geyan21/yam-tactile-kit/engineering/docs/F1_DEVELOPMENT.md

# F1 development checkpoint

This page preserves historical development decisions and their earlier
completion states. Use [the current F1 build and fit guide](BUILD_F1.md) for
today's available files, sensor placement and remaining integration work.

F1 is not a fabrication release. Its flat electrode witnesses have 64 routed
contact regions: eight per nail prong and twelve per TPU patch. The contact
locations use the retained R1 nail and saddle surfaces. A separately checked
connector-board module is now available. Installed flex geometry, the complete
readout, carrier and physical behavior remain to be completed.

The first layout is generated by `layout_f1_cells.py`. It follows the tapered
nail outlines; a rectangular grid would allocate some pixels outside the
leading ends. The smallest proposed overlap is 5.127 mm² before adding feeds,
vias, coverlay constraints or registration allowances.

## Electrical findings

`screen_f1_matrix.py` models the four row drivers, six local row branches and
16 column nodes. Each patch has its own trace resistance. The selected column
has a finite path to an ideal amplifier reference; other columns float.
Each position is normalized to its modeled one-contact response. This is
an electrical interaction study, not a physical force calibration.

The first path assumptions were 0.8 Ω at a row driver, 1.5 Ω on each local row
branch and 5.5 Ω on the selected column. With inactive rows clamped to bias,
the worst modeled interaction is 13.27%, 1.61% and 0.164% for pressed
resistances of 100 Ω, 1 kΩ and 10 kΩ, respectively. Floating inactive rows
perform substantially worse.

A buffered/sensed candidate reduced the path targets to 0.05 Ω, 0.25 Ω and
0.35 Ω. Its 100 Ω case still failed the provisional 1% electrical criterion.
Changing the row-driver target to 0.02 Ω did not resolve that limiting case:
the largest error remains the all-pressed pattern, dominated by column path
resistance. All evaluated configurations are retained in timestamped runs.

The current development budget is 0.02 Ω at the buffered row distribution
land, 0.25 Ω per row branch and 0.25 Ω for the remaining column path. Meeting
these values requires actual circuit regulation, connector specifications
and routed-conductor checks. A favorable result with those targets does not
prove that a board or flex circuit satisfies them.

With those targets and ideal amplifiers, the largest modeled interaction is
0.741%, 0.0749% and 0.00746% at 100 Ω, 1 kΩ and 10 kΩ. The model passes its
1% work criterion. Its uniform-array result also matches the independent
analytic relation `G = 1 / (R + Rdriver + Rbranch + rows × Rcolumn)`.
Offsets, leakage, switching and material effects remain outside this result.

The candidate circuit puts a unity-gain buffer after each row-selection
switch. Separate current and high-impedance sense multiplexers would close
the selected-column feedback loop at its connector. This can remove the
current multiplexer resistance from the controlled column potential, while
the FPC resistance remains. A parked feedback path, correct switching order,
loop stability, leakage, amplifier offsets and ADC range must be checked.

The selected-column candidate now uses the single OPA392DBVR and explicit
gain/parking circuitry. The
[readout study](../development/f1/readout-study/README.md) preserves its circuit
diagram, component values and all declared simulation attempts. It is a
development circuit; row loops, reference/ADC drive and the complete board
remain unfinished.
[OPA392 manufacturer reference](https://www.ti.com/product/OPA392)

## Flex construction direction

The current routing targets are in `designs/f1_flex_targets.json`. Use two
copper layers for the **nail row electrodes**, with their feeds on the back.
The rigid nail supports those static vias. This retains leading contact
width. Use one copper layer for the other ten flex parts so the TPU patches
and tails can flex without plated vias in their moving regions.

The proposed material system uses 25 µm PI and 35 µm rolled-annealed copper.
The cited fabricator lists 0.11 mm single-layer covered flex, 0.20 mm for the
corresponding double-layer option, and reduced thickness where copper or
coverlay is absent. It also lists ±20% trace-width tolerance, which must
enter the resistance calculation. The proposed 31.5 µm minimum copper is
an additional purchasing/inspection requirement; it is not a published
supplier guarantee. [Fabrication capability reference](https://jlcpcb.com/capabilities/flex-pcb-capabilities/)

Use distinct row/column masks and explicit assembly-side transforms. The
upper conductor faces the film, and the lower conductor faces outward from
the support. Nail-plane and TPU-unroll coordinates have different handedness;
do not mirror every drawing using the same shortcut.

Both exposed conductor planes and their neutral surfaces need their own
developed lengths on a curved TPU patch. Keep adhesive out of active
electrode/film contacts. Final areas and layer offsets must be derived from
the routed artwork rather than the initial pixel-allocation plot.

The nominal saddle radii range down to 3.494 mm. Fabricator bend guidelines
are starting points for a circuit, not lifetime guarantees for this layered
tactile assembly. Measure loaded curvature, relative layer slip, bending
response and fatigue on the complete specimen.

## Next concrete work

1. Complete component limits, reference/gain circuitry and the switched-feedback stability review.
2. Replace the flat flex witnesses with installed routes and separate conductor-plane unrolls; calculate the complete resistance network with tolerances.
3. Design finished FPC contact thickness, mounting/sealing tools, tail routes and strain relief.
4. Supply checked PCB/CAD files, firmware, raw acquisition, BOM, assembly instructions and actual-geometry visuals.
5. Build and test the complete finger against R1 and the common campaign. Electrical resistance cases cannot establish a 20 N force rating.

## Checked flat-artwork milestone

Twelve flat routing witnesses now exist: one row and one column foil for each
of six patches. Both nail row foils use backside feeds; the other ten foils
currently have one copper layer. The routed overlap map contains 64 distinct
regions. Its smallest copper overlap is 5.1199 mm² after removing the plated
drill holes.

All twelve pass the independent copper, outline and connectivity checks in
KiCad 10.0.7. The narrowest modeled copper clearance is 0.1889 mm, against
the 0.15 mm rule. The source-derived nail outline contained submicron edges;
the new flex outline simplifies these within a measured 0.003 mm bound.
The original source finger is unchanged.

The sensing and cable contacts intentionally share coverlay openings, with
no solder paste on the flex. `check_f1_flex.py` retains both unsuppressed
reports and reports with the scoped `bridged_mask` allowance for the
unsoldered `FOIL` footprint. It permits no other ignored rule in that block
and requires zero copper/connectivity findings. A separate probe confirms
that a 5 mm clearance sentinel and an injected copper short are still
detected with the coverlay allowance enabled.

The development exports omit KiCad's generic even-layer/FR4 Gerber job file.
Raw exports remain preserved; the selected files carry the actual proposed
polyimide stack and a development-only notice. These exports are **not the
completed F1 finger package**.

Reproduce this stage with the prepared CAD/KiCad tools:

```sh
build/engineering/tools/cad-venv/bin/python engineering/scripts/develop_f1_artwork.py
/usr/bin/python3 engineering/scripts/check_f1_flex.py ACTUAL_ARTWORK_RUN --export
build/engineering/tools/cad-venv/bin/python engineering/scripts/summarize_f1_artwork.py ACTUAL_ARTWORK_RUN
```

Use the actual timestamped directory printed by the first command. Generated
results and failed attempts remain under
`build/engineering/prototypes/f1/artwork_runs/`.

## Installed routing direction

The flat tails demonstrate electrical routing. They have not been fitted to
the gripper and must not be laid across the following contact patches.
`designs/f1_integration_development.json` records the current integration
direction: a removable connector board on the fixed finger and a separate
analog/ADC board at the wrist/base, with separate current/sense paths.

The connector-board position, folded tail paths, mating planes, mechanical
carrier and analog implementation are candidates awaiting checks. This
keeps the full installed-finger requirement open. Neither the successful
flat-artwork checks nor the contact-area map qualifies bending, contact
reliability, 20 N force performance or production yield.

## Checked fanout-board module

The [downloadable development checkpoint](../development/f1/fanout/README.md)
now supplies an editable four-layer PCB, both populated faces' fabrication
artwork, pin tables, component values, full independent DRC evidence and
[actual routed board visuals](../development/f1/fanout/visuals/fanout_faces.png).
It is a connector-board module, not the completed F1 finger.

The board has 42 components, 232 pads, 2,221 track segments and 274 vias.
KiCad 10.0.7 reports zero rule violations and zero missing connections.
The generated placements also pass explicit pad-coordinate, layer and
save/reload checks. A separate adapter enforces spacing between same-net
drilled vias; copper connectivity alone does not prevent overlapping drills.
Original failed attempts remain in the working records.

Six outer `J*R` connectors carry rows; six inner `J*C` connectors carry
columns. Each uses the selected Hirose six-position, 1 mm connector.
Twenty fitted zero-ohm links define the separate sense pickups. `JW` is
a 50-position, 0.5 mm Hirose connector for the wrist readout.
`UT`, ADG706BRUZ, adds a switchable 10 kΩ electrical test path with
enable/address pull-downs. Its eventual test sequence must park the rows
at bias and label the records as electrical checks.

The proposed Molex cable matches the nominal pitch and end thickness.
Its reviewed dimensions and electrical values are in
`research/f1_wrist_link_review.json`. The wrist connector's conductor mapping
must follow the installed poses and an unpowered continuity check.

The board follows the prescribed contact/access envelope from
`check_f1_placement.py`. The original rectangle entered that envelope by
130.41 mm². A contoured edge and 2.13 mm shift of one connector pair clear
the assumed 3 mm inward travel plus 1 mm access margin. This is not a
prediction of bending at 20 N. Fine contour features, the actual carrier,
open-latch access and installed drive still need manufacturing/fit checks.

Request 1 oz copper on all four layers, with the additional minimum-copper
targets recorded in `designs/f1_fanout_manufacturing_targets.json`. The
complete board/cable/flex network has not yet demonstrated the electrical
budget. Shared row traces, connector resistance, amplifier regulation,
leakage and switching remain part of that review.

Rechecking the distributed board writes only into `build/`; it does not
alter the saved checkpoint. Follow the commands in its README. No physical
F1 specimen or performance result has been reported.

## Selected-column readout study

The [separate readout checkpoint](../development/f1/readout-study/README.md)
contains replayable cases, raw vectors/logs, a readable circuit drawing and
plots. Its 96 nominal AC and eight current-step cases pass the declared
selected-column screen. Minimum voltage-return margin is 53.89°, and the
limiting current-step settles within 290.55 µs at the 25 µV work criterion.
This is a typical model with explicit lumped parasitics and ideal bias sources.

Of 96 independent physical-ground time-domain probes, 83 completed and passed;
twelve solver failures and one timeout remain unresolved. Of twelve
wire-break attempts, eight support provisional healthy/rejected decisions,
two have no completed result and two are incomplete with nonphysical outputs.
The archive retains every attempt. No failed or partial simulation counts
as a successful hardware check.

The simulation worker now rejects analysis-aborted messages and truncated
time/frequency vectors. Replay of an actual successful case and an actual
aborted case verifies the result-handling change. The archive verifier checks
27 files and 1,485 compressed members. A separately extracted nominal case
replays using the directly obtained TI model.

The complete F1 design still requires the four row-driver loops, full-array
interaction, reference and ADC drive, gain/channel transitions, firmware,
routed readout board, fitted flex and mounting mechanics. No physical
performance recommendation follows from this milestone.

## ADC, row drivers and wrist integration

The [support-study archive](../development/f1/support-studies/README.md)
contains 32 ADC-driver cases and 26 row-driver cases, their exact inputs and
the unsuccessful earlier attempts. Current declared model screens pass.
Four ADC replays with smaller maximum time steps and ten completed
trapezoidal runs constrain the reported settled-window result. Fourteen
trapezoidal workers still did not complete; they remain in the archive.

The ADC driver adds a 2.2 nF capacitor from each input to ground after the
first model's differential-only filter produced out-of-range negative-input
excursions. OPA320AQDBVRQ1 matches the current supplied Q1 macromodel.
The row drivers use 47 Ω output isolation and 4.7 kΩ sense resistance.
Their one-row model meets the stated 45° return-margin screen and settles
within 36.17 µs in the selected command/load cases. These are typical
isolated-stage models, not full-array or physical measurements.

The wrist layout and [capture guide](F1_WRIST_CAPTURE.md) now define the
complete candidate component/pin map. The board contains 135 components and
498 pads. The [checked wrist module](../development/f1/wrist/README.md)
now includes the 2,561-segment, 412-via native board, both populated faces'
fabrication files, drawings and full DRC evidence. Independent KiCad checking
reports zero violations and zero missing connections. The distributed
187-file checkpoint also passes its documented recheck.

The original complete route's eight courtyard overlaps and two label
findings were retained, then corrected. The actual filled ground-plane
drawing and eleven signal-net crossing inventories are included; return
impedance and EMC remain unmeasured.

Reference implementation, complete array dynamics, installed flex geometry,
carrier, actual YAM fit and physical tests remain.
The code provides a declared fixed-gain bench scan, separate electrical
column tests, raw per-sample times and a recorder that retains partial frames.
No physical Pico or sensor was accessed during the software checks.
