geyan21/yam-tactile-kit/engineering/prototypes/optical/visuals/o1_molds.pdf

O1.0 • two mold halves, gel cavity and flexible dot stencil CAD only • casting, mating, optics, precision and 20 N response require physical tests

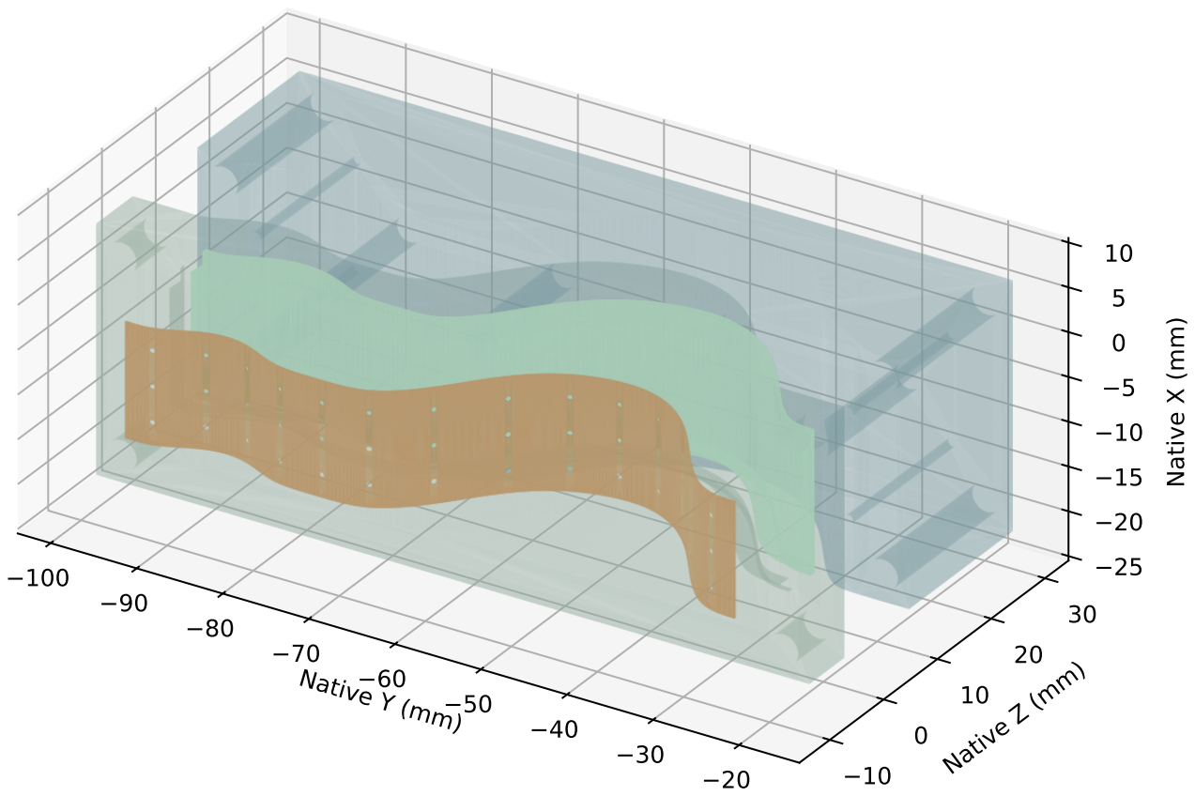
[picture p14: figure]
Native Y (mm); Native Z (mm); Native X (mm)
