geyan21/yam-tactile-kit/engineering/release/b1/b1_review_drawings.pdf

# B1 · controlled compliance, fixed readout

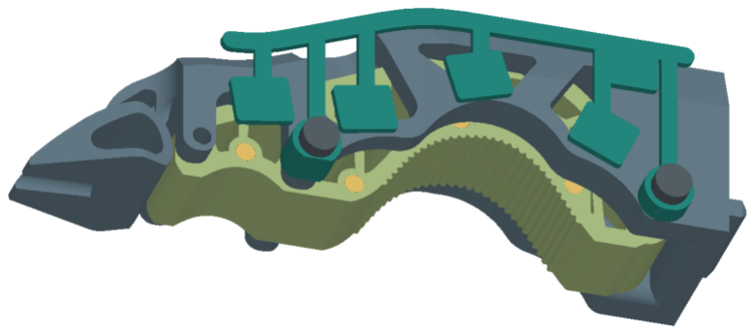
[picture p26: figure]

Original hard frame · modified TPU · four magnets and plugs · five sensor heads · fixed spine

Actual meshes / unbuilt prototype. Wire routing, epoxy fillets and optional nail films are not pictured.

# B1 · separate parts

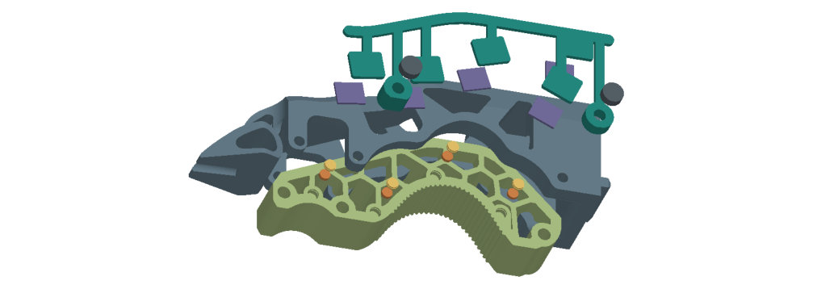
[picture p27: figure]

Original hard frame · modified TPU · four magnets and plugs · five sensor heads · fixed spine

Actual meshes / unbuilt prototype. Wire routing, epoxy fillets and optional nail films are not pictured.

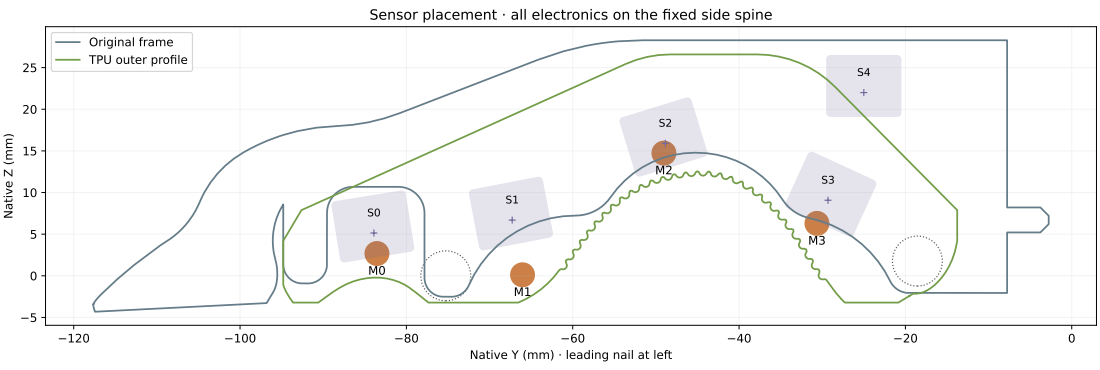
[picture p28: page 3]
Native Z (mm)

fixed side spine

Sensor placement · all electronics on the

Original frame file TPU outer pro

Native Y (mm) · leading nail at left

B1.0 manufacturing review · millimeters · do not scale this page

Original TPU outer profile and attachment bores retained; hard frame unchanged. Four side pockets: diameter 3.15, depth 2.15.
Magnets: N48, 3 × 1, axial north toward +native X (sensor side).
Plug: 1.15 long, 3.10 stem, 3.40 bead. Groove 3.55 × 0.30.
Print and gauge a pocket first. Do not force an oversize magnet into TPU.

Pocket centers (X is magnet center, not side opening):
M0: (-1.650, -83.540, 2.676)
M1: (-1.650, -66.035, 0.122)
M2: (-1.650, -49.035, 14.732)
M3: (-1.650, -30.635, 6.292)

Five identical PCB heads: 8 × 6.4 × 0.8; component face points inward. PCB component-side plane: X=8.439.
Outer spine: X=10.539. Backing tape: 0.10.
Added global width: 3.65 without heads;
6.05 with reserved heads; wires excluded.
Reserved M3 head: diameter 6 × height 2.4. Choose actual nonmagnetic hardware. Carrier bores: 3.4. Measure the original stack to select screw lengths.

No unchanged-stiffness, 20 N capacity, accuracy or fatigue claim.
Use STEP/STL and the PCB fabrication archive; test one build before scaling.
