geyan21/yam-tactile-kit/engineering/prototypes/pneumatic/visuals/p1_readout.pdf

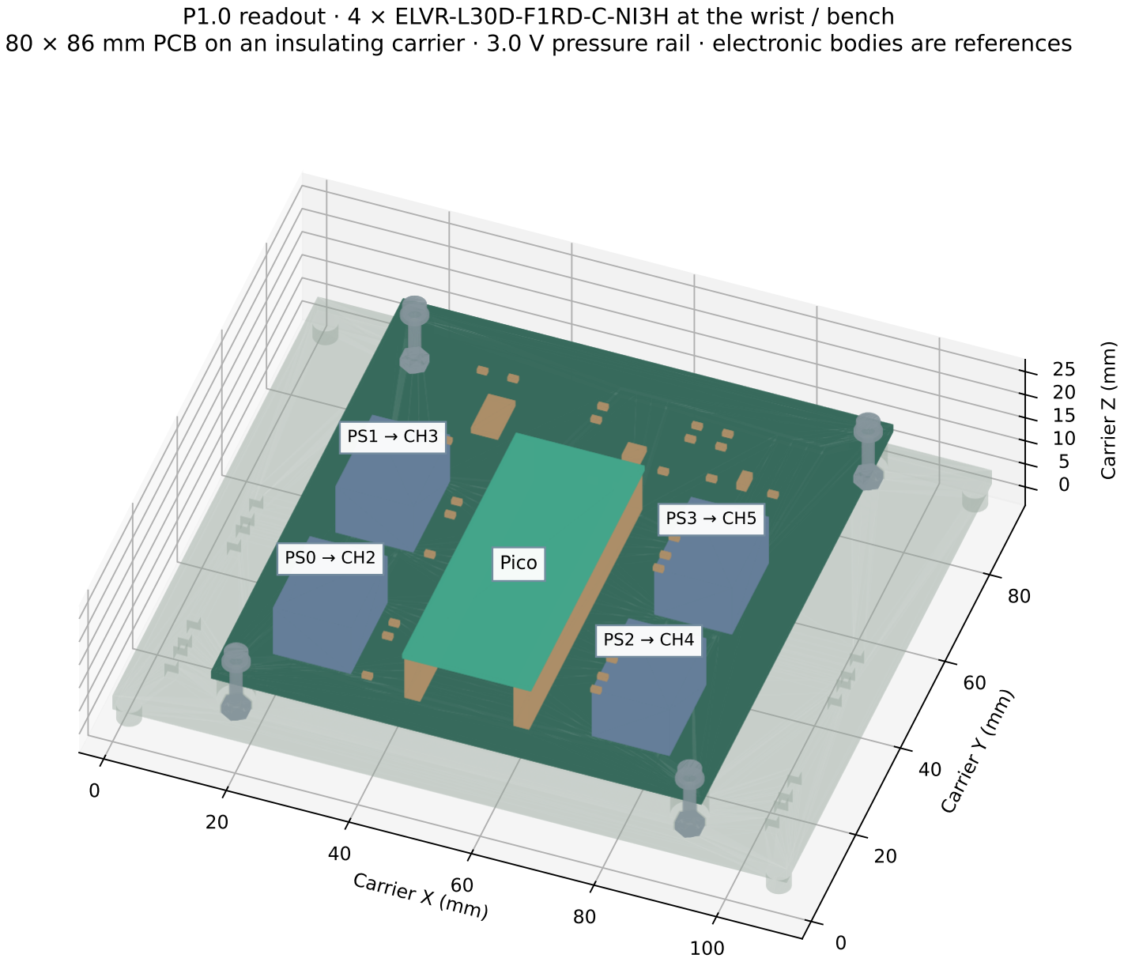
[picture p29: page 1]

0
20
40
60
80
100

Carrier X (mm)

0

20

40

60

80

Carrier Y (mm)

0

5

10

15

20

25

Carrier Z (mm)

PS0 → CH2

PS1 → CH3

PS2 → CH4

PS3 → CH5
Pico

P1.0 readout · 4 × ELVR-L30D-F1RD-C-NI3H at the wrist / bench 80 × 86 mm PCB on an insulating carrier · 3.0 V pressure rail · electronic bodies are references
