geyan21/yam-tactile-kit/engineering/prototypes/f1/visuals/f1_r4_review_drawings.pdf

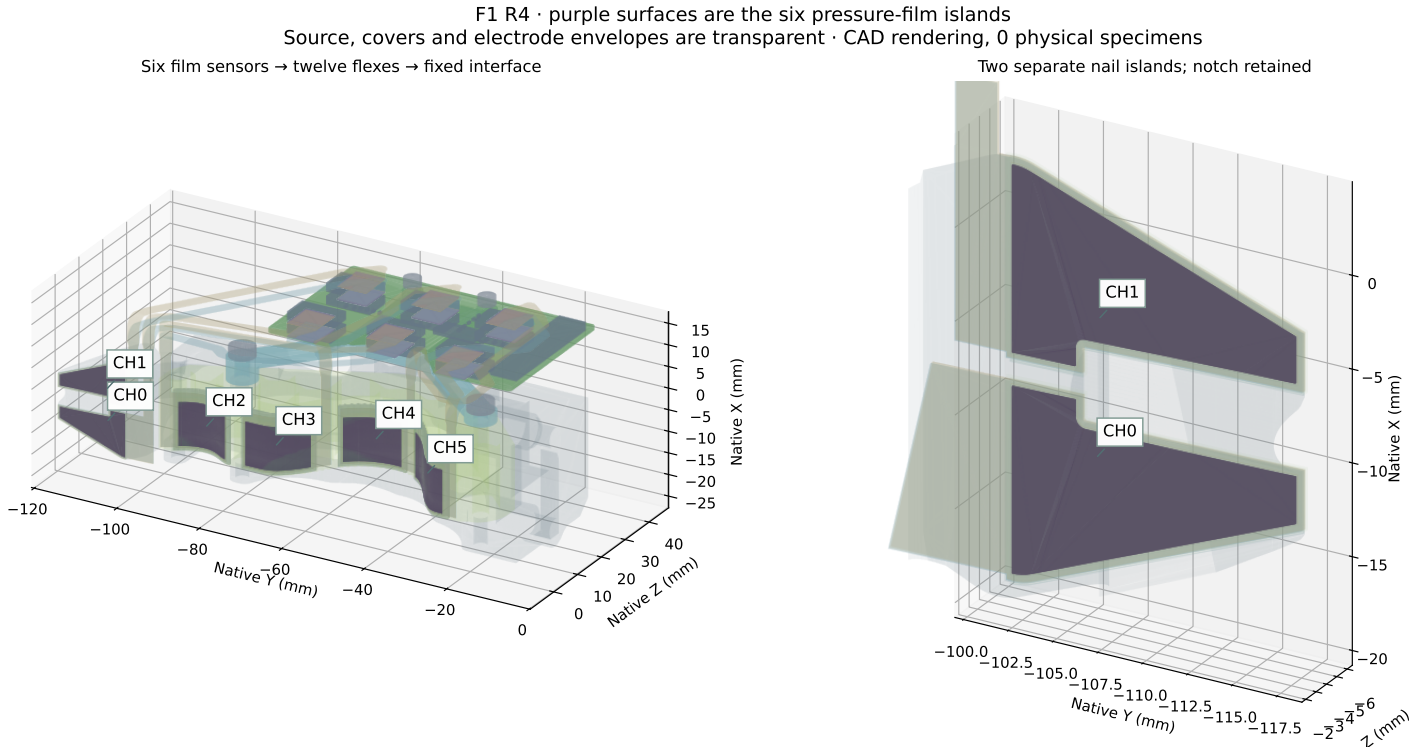
[picture p30: page 1]

−120
−100
−80
−60
−40
−20

0

Native Y (mm)

0

10

20

30

40
Native Z (mm)

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
Native X (mm)

Six film sensors → twelve flexes → fixed interface

CH0

CH1

CH2
CH3 | CH4

CH5

−117.5

−115.0 −112.5 −110.0 −107.5 −105.0 −102.5 −100.0

Native Y (mm)

−6 −5 −4 −3 −2
Native Z (mm)

−20

−15

−10

−5

0

Native X (mm)

Two separate nail islands; notch retained

CH0

CH1

F1 R4 · purple surfaces are the six pressure-film islands

Source, covers and electrode envelopes are transparent · CAD rendering, 0 physical specimens
