geyan21/yam-tactile-kit/engineering/prototypes/capacitive/patterns/k1_ch2_inspection.pdf

## k1_ch2

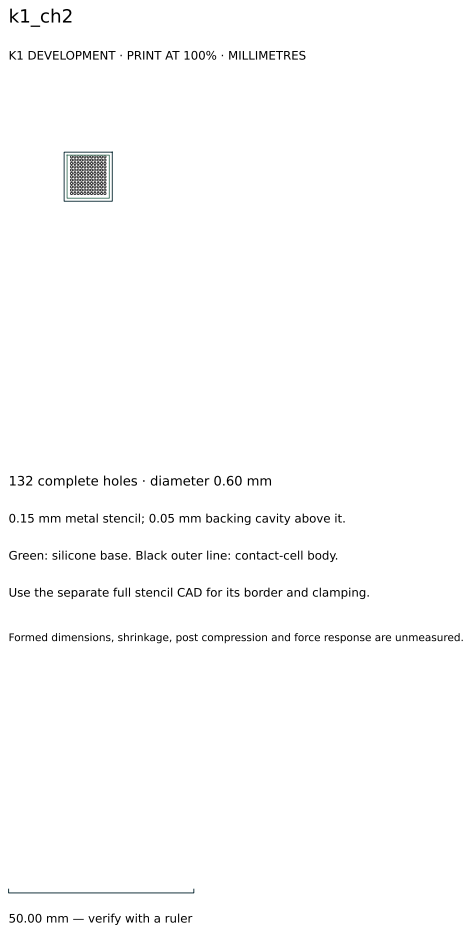
[picture p31: page 1]

K1 DEVELOPMENT · PRINT AT 100% · MILLIMETRES

132 complete holes · diameter 0.60 mm

0.15 mm metal stencil; 0.05 mm backing cavity above it.

Green: silicone base. Black outer line: contact-cell body.

Use the separate full stencil CAD for its border and clamping.

Formed dimensions, shrinkage, post compression and force response are unmeasured.

50.00 mm — verify with a ruler
