geyan21/yam-tactile-kit/engineering/prototypes/capacitive/visuals/k1_review_drawings.pdf

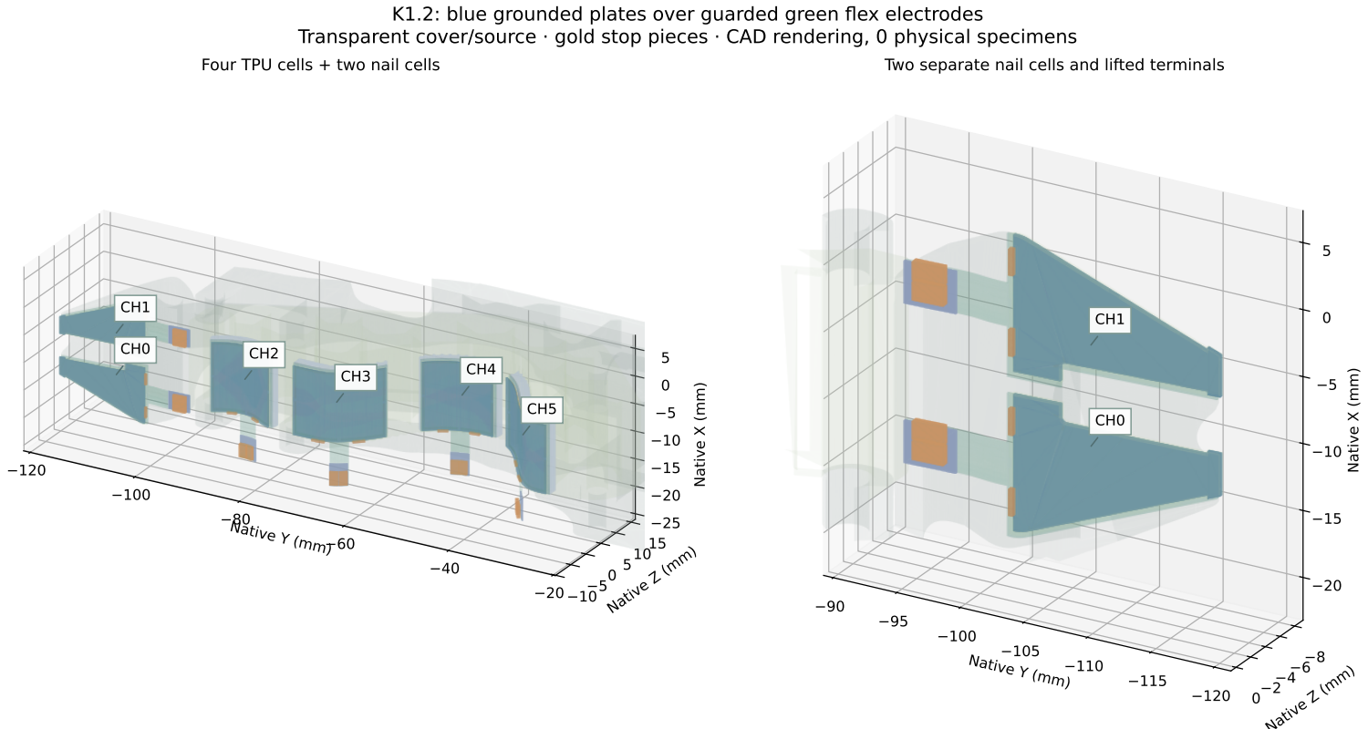
[picture p32: page 1]

−120

−100

−80

−60

−40

−20

Native Y (mm)

−10−5

0

5

1015 Native Z ⁽mm⁾

−25

−20

−15

−10

−5

0

5

Native X (mm)

Four TPU cells + two nail cells

CH0

CH1

CH2
CH3 | CH4

CH5

−120

−115

−110

−105

−100

−95

−90

Native Y (mm)

−8
−6
−4
−2
0

Native Z (mm)

−20

−15

−10

−5

0

5

Native X (mm)

Two separate nail cells and lifted terminals

CH0

CH1

K1.2: blue grounded plates over guarded green flex electrodes

Transparent cover/source · gold stop pieces · CAD rendering, 0 physical specimens

K1 bank enclosure · make two identical copies Lid lifted for viewing · reference capacitor on its separate 0.5 mm support · Pico is outside the case

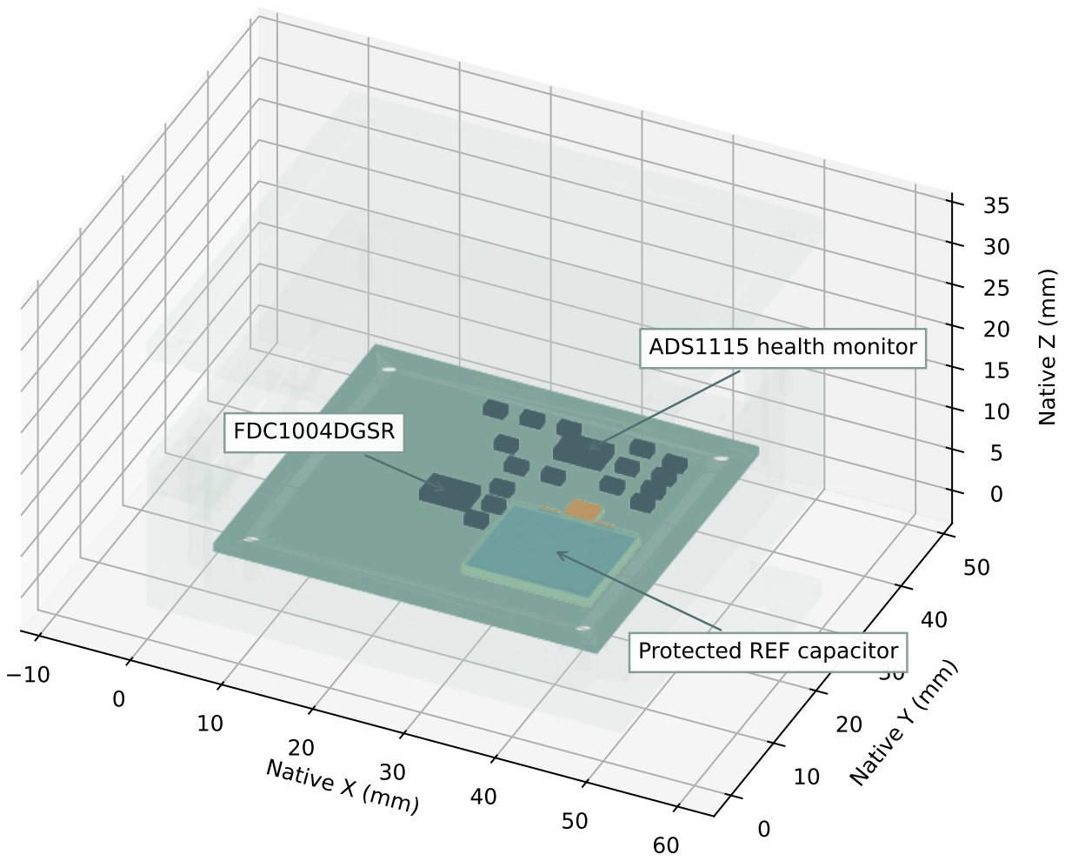
[picture p33: figure]
Native X (mm); Native Y (mm); Native Z (mm); Protected REF capacitor; FDC1004DGSR; ADS1115 health monitor
