geyan21/yam-tactile-kit/engineering/prototypes/force_button/visuals/fb1_review_drawings.pdf

FB1: the complete finger loads a packaged sensor at the root 50 mm added reach · no sensor film on the leading tip · CAD rendering, not a physical specimen

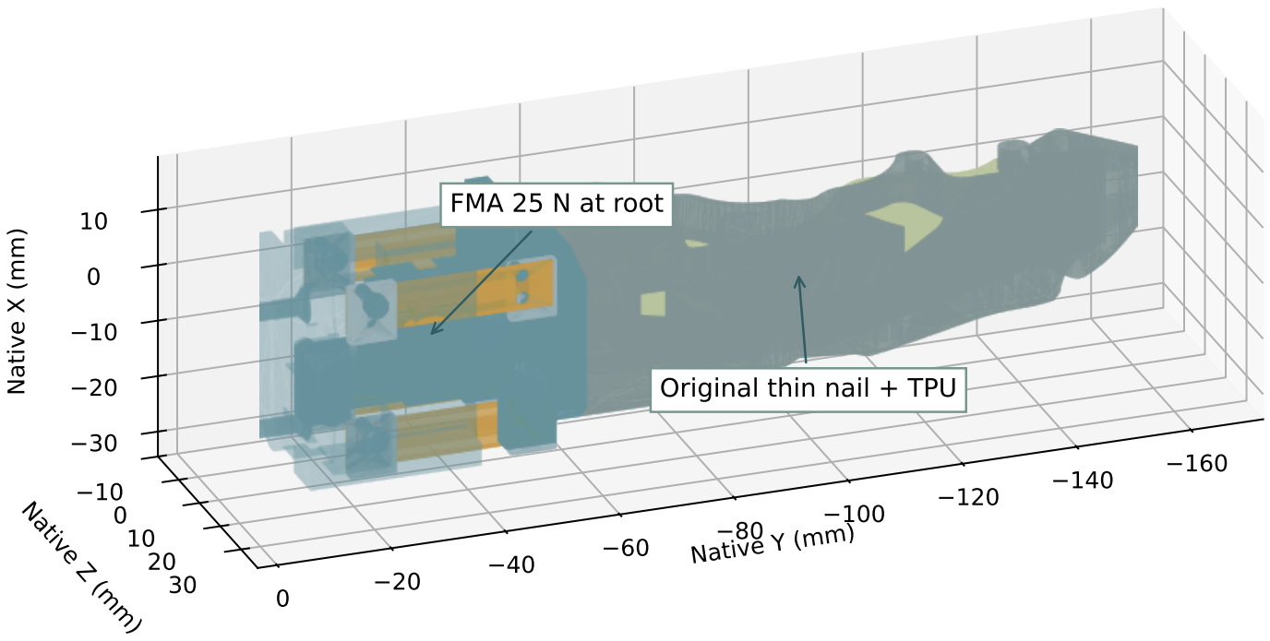
[picture p34: figure]
Native Y (mm); 30 Native Z (mm); Native X (mm); FMA 25 N at root; Original thin nail + TPU

Actual center section at native X = −7.5 mm

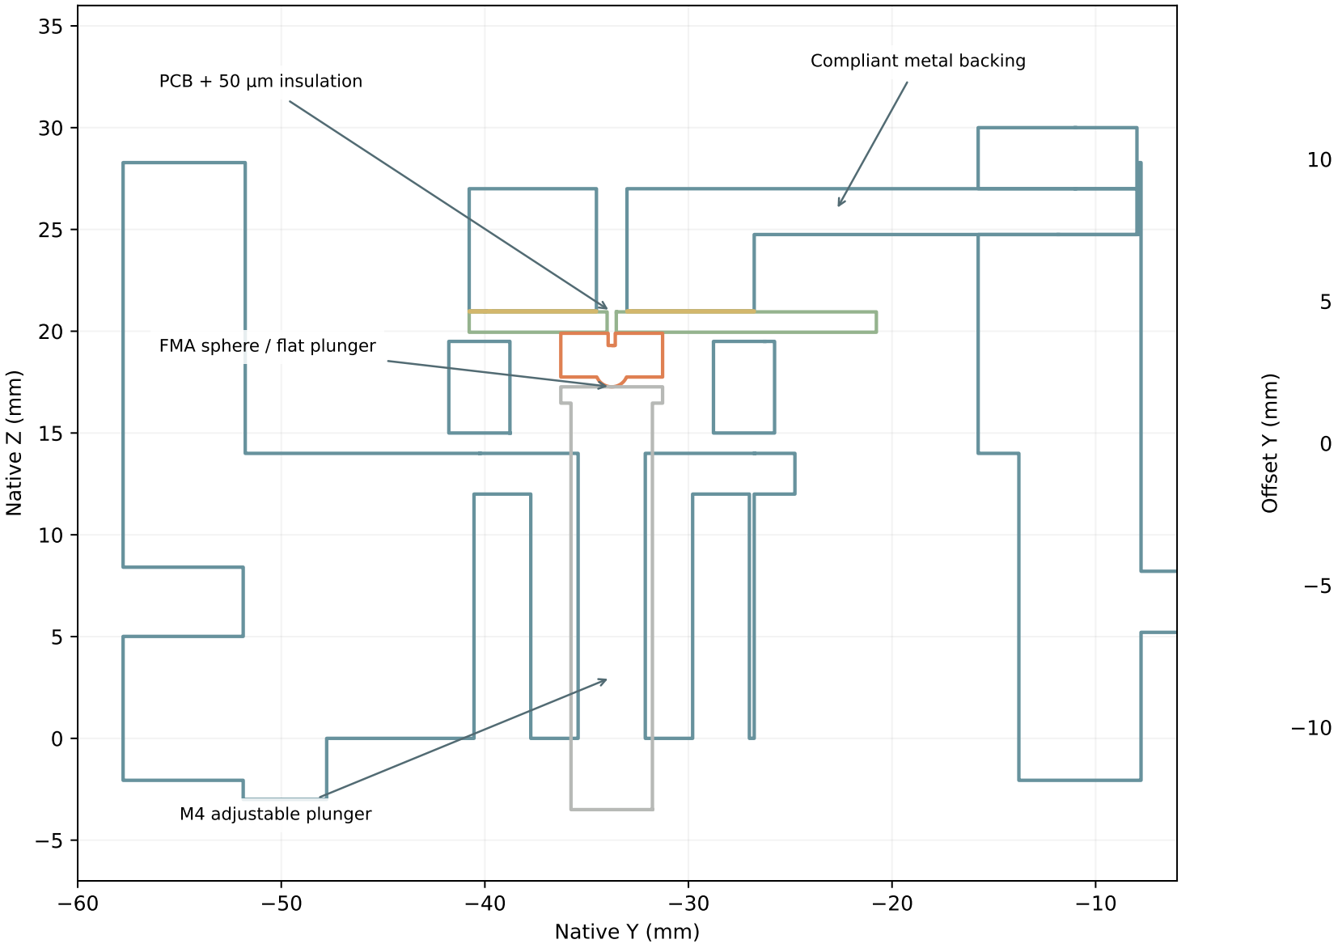
[picture p35: figure]
Native Y (mm); Native Z (mm); FMA sphere / flat plunger; PCB + 50 µm; insulation; Compliant metal backing; M4 adjustable plunger; ffset Y (mm)
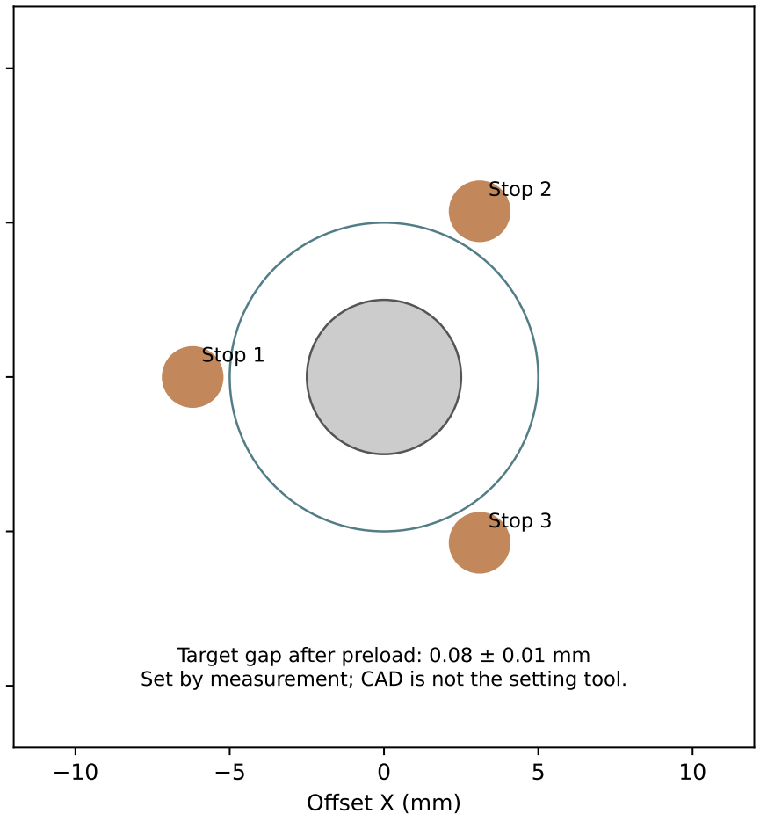
[picture p36: figure]
Offset X (mm); Stop 1; Stop 2; Stop 3

Target gap after preload: 0.08 ± 0.01 mm Set by measurement; CAD is not the setting tool.

Three stops around the plunger Plan view; separate from the section

FB1 load coupling: support the package, press only the sphere, keep the vent open

FB1 sensor board · 14 × 20 × 1 mm · two copper layers Actual routed primitives; native KiCad/Gerbers are authoritative · solder leads from the back

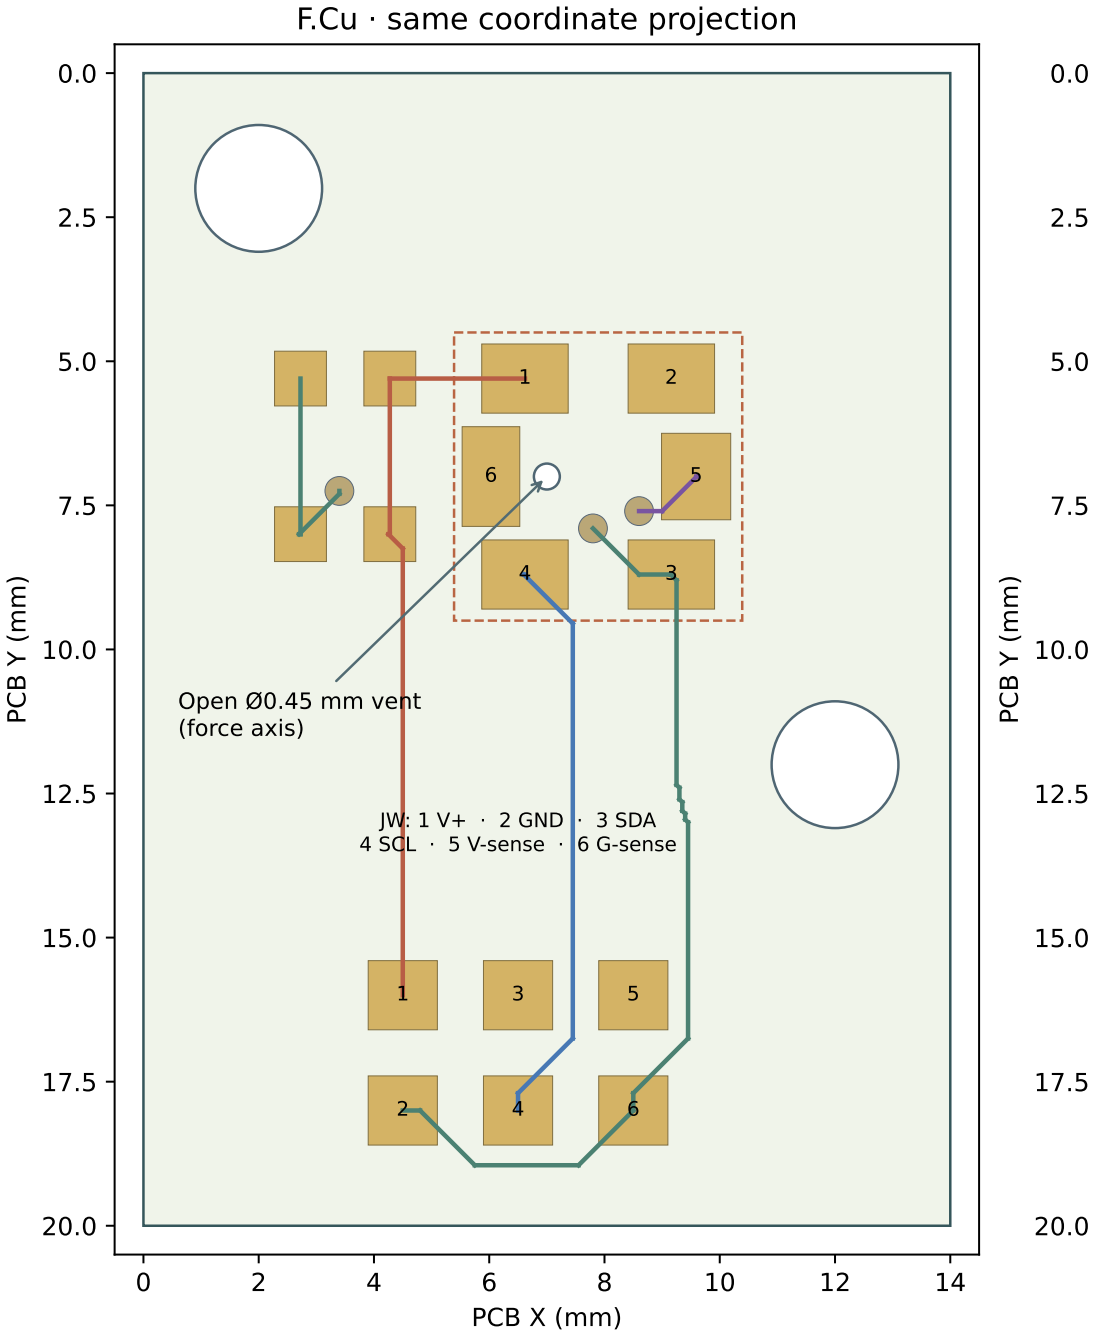
[picture p37: figure]
PCB X (mm); PCB Y (mm); Open Ø0.45 mm vent (force axis); JW: 1 V+ · 2 GND; · 3 SDA; 4 SCL · 5 V-sense ·; 6 G-sense; F.Cu · same coordinate projection
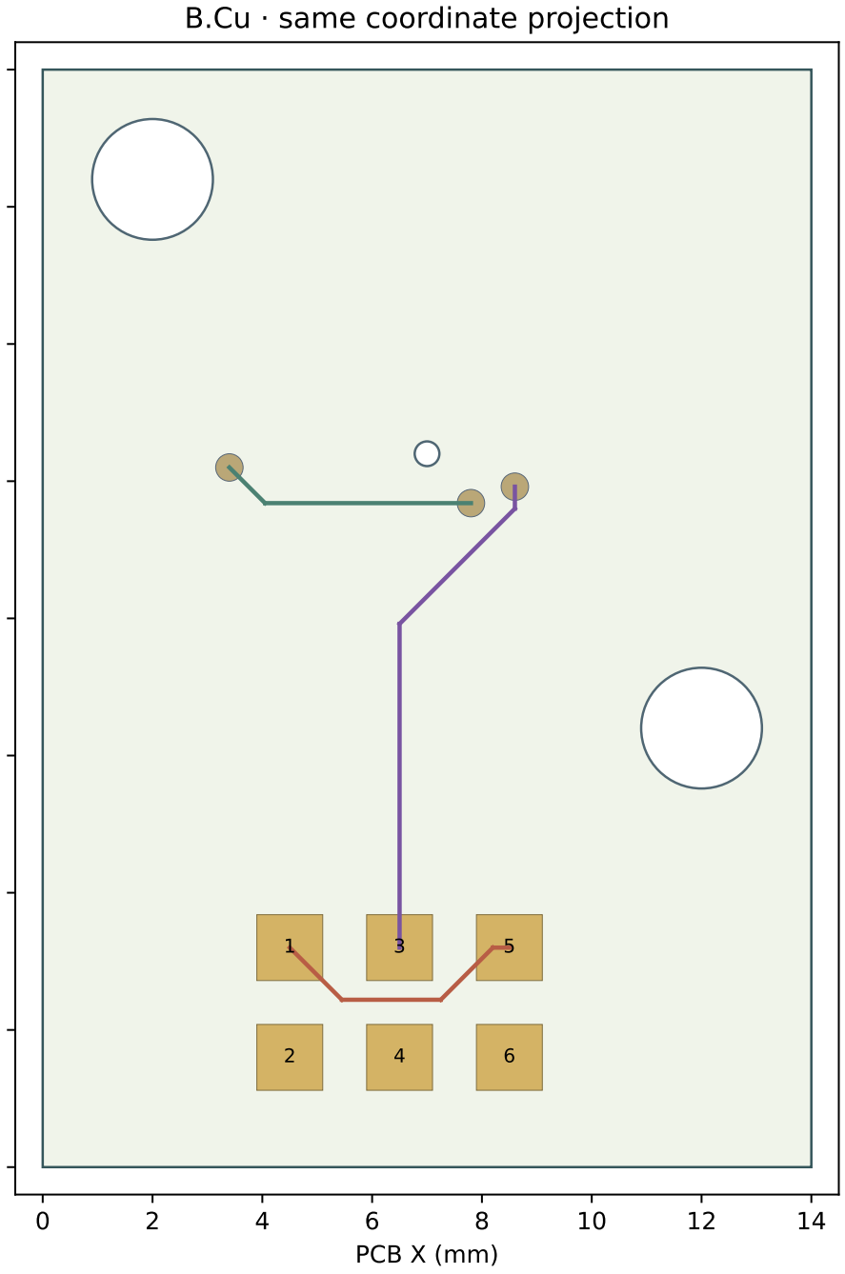
[picture p38: figure]
PCB X (mm); B.Cu · same coordinate projection
