geyan21/yam-tactile-kit/engineering/development/capacitive/k1/visuals/k1_readout.pdf

K1 readout · one board serves three pressure cells and one unloaded reference 23 components · independent KiCad check: 0 violations, 0 missing connections · no physical board tested

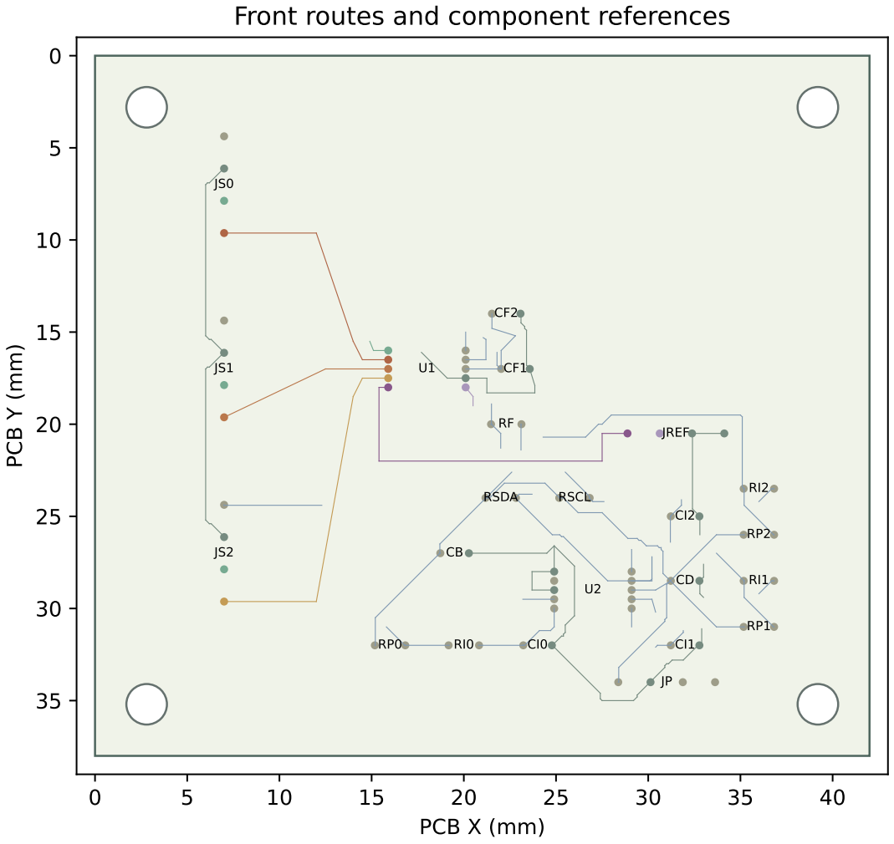
[picture p39: figure]
PCB X (mm); PCB Y (mm); RSDA; RSCL; JREF; Front routes and component references
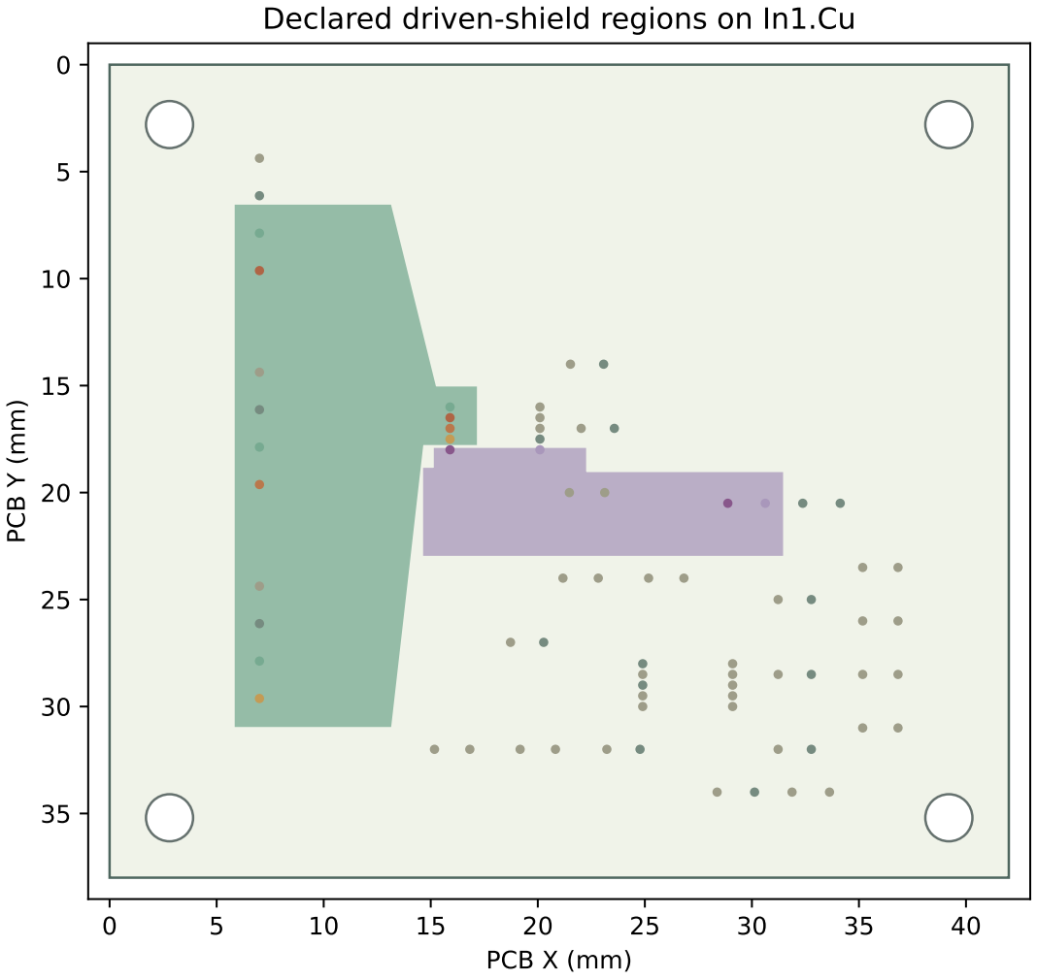
[picture p40: figure]
PCB X (mm); PCB Y (mm); Declared driven-shield regions on In1.Cu

Plane graphic shows intended regions; native filled copper and drill files are authoritative. Use two boards on separate Pico I²C buses.
