geyan21/yam-tactile-kit/engineering/development/f1/r3/cable/mating_pose.pdf

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
Finger fanout JW

Wrist JW

Same-side contact FFC
Both connector board faces parallel Cable mouths face one another
Pin n → pin 51−n
Unpowered continuity check required

F1 cable inspection pose · native pin correspondence Illustration is not the installed cable route; solder-land transverse order represents contact order.
