geyan21/yam-tactile-kit/engineering/development/f1/r3/patterns/f1_ch2_columns_fit.pdf

123456

# f1_ch2_columns_fit

FIT PATTERN ONLY · NO COPPER ARTWORK · PRINT AT 100% CH2 columns → J2C · view from F.Cu side

50 mm scale bar · verify with a ruler

Dashed lines bound the 90° bend. Form around the radius; do not crease.

Connector datum, source join, bending slack and physical fit remain unverified.
