geyan21/yam-tactile-kit/engineering/development/f1/r3/visuals/fanout_faces.pdf

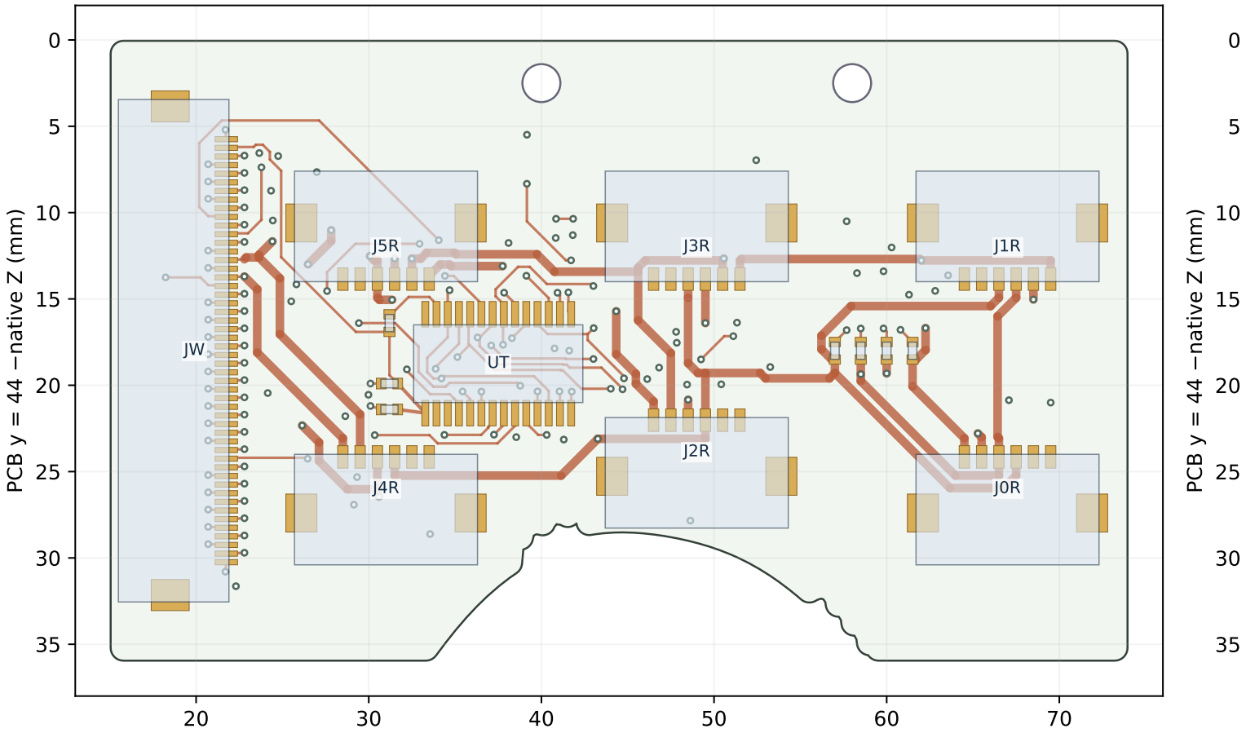
[picture p45: figure]
PCB y = 44; −native Z (mm)

PCB x = −native Y (mm)

## Outer row face • F.Cu

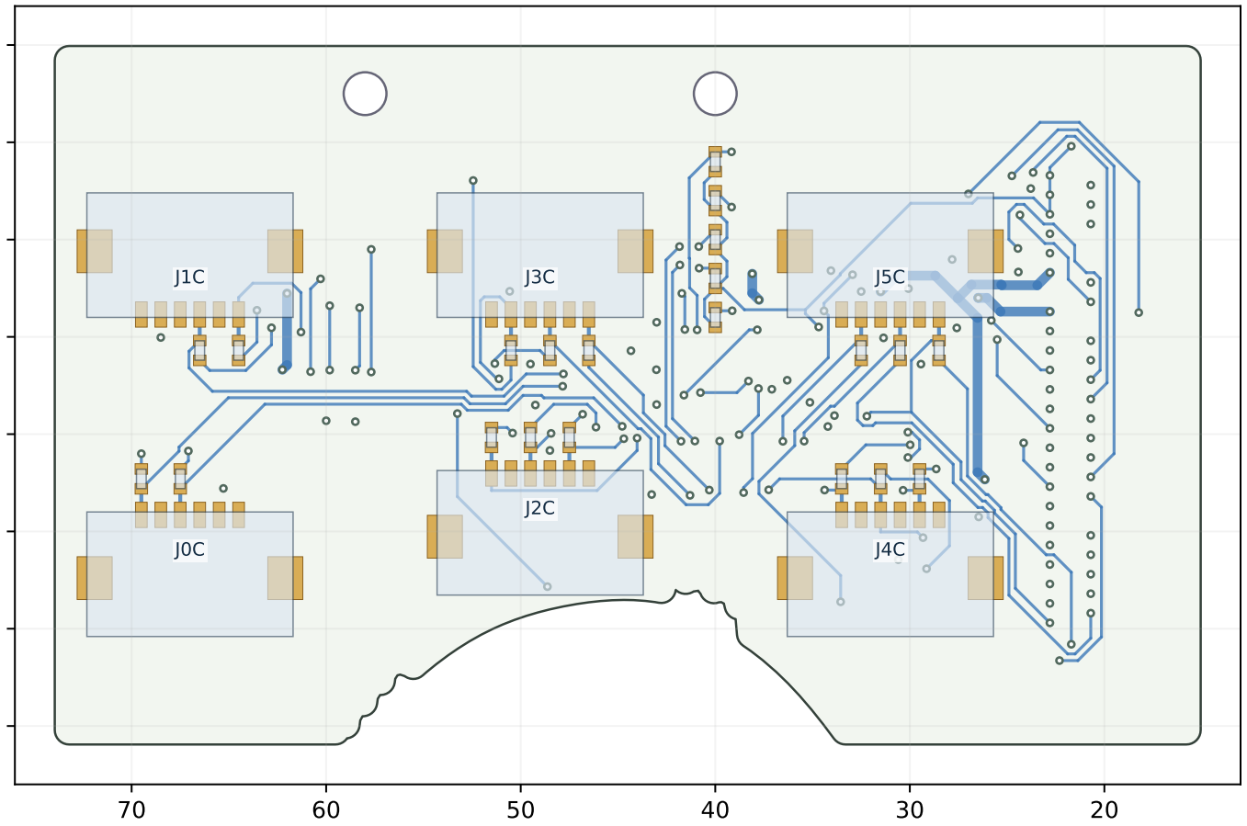
[picture p46: figure]

PCB x = −native Y (mm)

## Inner column face • B.Cu, viewed from the back

## F1 connector-board R3 development • four copper layers • 42 components Independent DRC: 0 violations, 0 unconnected • no physical prototype tested

Actual routed outer-layer copper; rectangular part envelopes. KiCad assembly SVGs provide pad numbers and silkscreen. The inner ground pour is not pictured.
