geyan21/yam-tactile-kit/engineering/development/f1/r3/visuals/sensor_placement.pdf

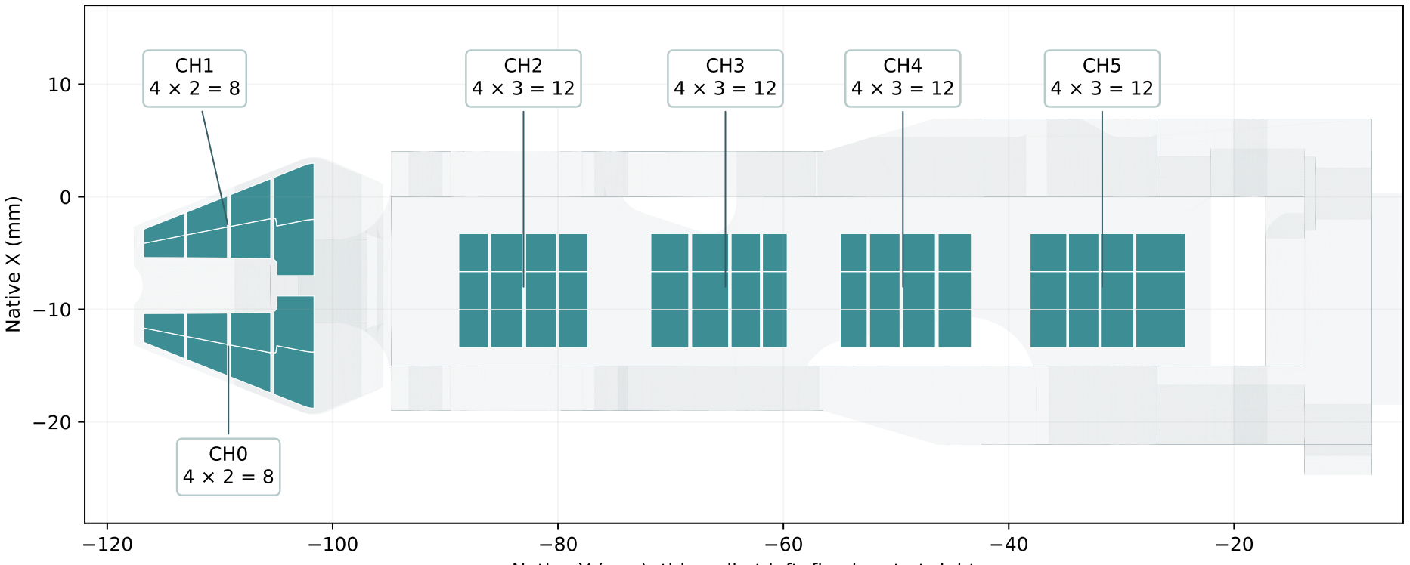
[picture p47: figure]
Native X (mm)

Native Y (mm): thin nail at left, fixed root at right

## Contact surface: two nail matrices + four TPU matrices = 64 intended locations

Object | contact
Protective cover | 0.10 / 0.40 mm
Row electrode foil | 0.145 / 0.060 mm in active area
Conductive pressure film | 0.10 mm — this is the sensing material
Column electrode foil | 0.060 mm in active area
Mounting layer | 0.05 / 0.10 mm
Original nail / TPU | retained contact support

Numbers are nail / TPU targets. Layer drawing is enlarged, not to thickness scale. Adhesive stays out of the film–copper sensing interfaces. Keep six film islands separate.

Sensor = the film/electrode laminate | Fixed electronics

Finger side: 12 FH12 foil connectors Wrist/base: OPA392 readout + ADS8866 Pico records raw electrical values

No ADC or rigid PCB goes in these pads. Force calibration and physical tests remain.

## F1 — what the tactile sensor is, and where it goes

Source-geometry allocation and nominal stack; fitted copper and physical qualification pending
