geyan21/yam-tactile-kit/engineering/prototypes/f1/electronics/wrist/cable/continuity_checklist.csv

fanout_connector | fanout_pin | wrist_connector | wrist_pin | net | measured_continuity_ohm | adjacent_short_check | operator | date
JW | 1 | JW | 50 | GND
JW | 2 | JW | 49 | +3V3
JW | 3 | JW | 48 | GND
JW | 4 | JW | 47 | A0
JW | 5 | JW | 46 | GND
JW | 6 | JW | 45 | A1
JW | 7 | JW | 44 | GND
JW | 8 | JW | 43 | A2
JW | 9 | JW | 42 | A3
JW | 10 | JW | 41 | TEST_EN
JW | 11 | JW | 40 | R0_I
JW | 12 | JW | 39 | R0_S
JW | 13 | JW | 38 | R1_I
JW | 14 | JW | 37 | R1_S
JW | 15 | JW | 36 | R2_I
JW | 16 | JW | 35 | R2_S
JW | 17 | JW | 34 | R3_I
JW | 18 | JW | 33 | R3_S
JW | 19 | JW | 32 | C0_I
JW | 20 | JW | 31 | C0_S
JW | 21 | JW | 30 | C1_I
JW | 22 | JW | 29 | C1_S
JW | 23 | JW | 28 | C2_I
JW | 24 | JW | 27 | C2_S
JW | 25 | JW | 26 | C3_I
JW | 26 | JW | 25 | C3_S
JW | 27 | JW | 24 | C4_I
JW | 28 | JW | 23 | C4_S
JW | 29 | JW | 22 | C5_I
JW | 30 | JW | 21 | C5_S
JW | 31 | JW | 20 | C6_I
JW | 32 | JW | 19 | C6_S
JW | 33 | JW | 18 | C7_I
JW | 34 | JW | 17 | C7_S
JW | 35 | JW | 16 | C8_I
JW | 36 | JW | 15 | C8_S
JW | 37 | JW | 14 | C9_I
JW | 38 | JW | 13 | C9_S
JW | 39 | JW | 12 | C10_I
JW | 40 | JW | 11 | C10_S
JW | 41 | JW | 10 | C11_I
JW | 42 | JW | 9 | C11_S
JW | 43 | JW | 8 | C12_I
JW | 44 | JW | 7 | C12_S
JW | 45 | JW | 6 | C13_I
JW | 46 | JW | 5 | C13_S
JW | 47 | JW | 4 | C14_I
JW | 48 | JW | 3 | C14_S
JW | 49 | JW | 2 | C15_I
JW | 50 | JW | 1 | C15_S
