geyan21/yam-tactile-kit/engineering/prototypes/f1/electronics/wrist/pcb/f1_wrist_pins.csv

reference | pad | net | layer | pcb_x_mm | pcb_y_mm
JP1 | 1 | ROW0 | F.Cu,In1.Cu,In2.Cu,B.Cu | 8.0 | 12.0
JP1 | 2 | ROW1 | F.Cu,In1.Cu,In2.Cu,B.Cu | 8.0 | 14.54
JP1 | 3 | GND | F.Cu,In1.Cu,In2.Cu,B.Cu | 8.0 | 17.08
JP1 | 4 | ROW2 | F.Cu,In1.Cu,In2.Cu,B.Cu | 8.0 | 19.62
JP1 | 5 | ROW3 | F.Cu,In1.Cu,In2.Cu,B.Cu | 8.0 | 22.16
JP1 | 6 | A0 | F.Cu,In1.Cu,In2.Cu,B.Cu | 8.0 | 24.7
JP1 | 7 | A1 | F.Cu,In1.Cu,In2.Cu,B.Cu | 8.0 | 27.24
JP1 | 8 | GND | F.Cu,In1.Cu,In2.Cu,B.Cu | 8.0 | 29.78
JP1 | 9 | A2 | F.Cu,In1.Cu,In2.Cu,B.Cu | 8.0 | 32.32
JP1 | 10 | A3 | F.Cu,In1.Cu,In2.Cu,B.Cu | 8.0 | 34.86
JP1 | 11 | CUR_EN | F.Cu,In1.Cu,In2.Cu,B.Cu | 8.0 | 37.4
JP1 | 12 | SNS_EN | F.Cu,In1.Cu,In2.Cu,B.Cu | 8.0 | 39.94
JP1 | 13 | GND | F.Cu,In1.Cu,In2.Cu,B.Cu | 8.0 | 42.48
JP1 | 14 | TEST_EN | F.Cu,In1.Cu,In2.Cu,B.Cu | 8.0 | 45.02
JP1 | 15 | GAIN0 | F.Cu,In1.Cu,In2.Cu,B.Cu | 8.0 | 47.56
JP1 | 16 | GAIN1 | F.Cu,In1.Cu,In2.Cu,B.Cu | 8.0 | 50.1
JP1 | 17 | GAIN2 | F.Cu,In1.Cu,In2.Cu,B.Cu | 8.0 | 52.64
JP1 | 18 | GND | F.Cu,In1.Cu,In2.Cu,B.Cu | 8.0 | 55.18
JP1 | 19 | GAIN3 | F.Cu,In1.Cu,In2.Cu,B.Cu | 8.0 | 57.72
JP1 | 20 | PARK | F.Cu,In1.Cu,In2.Cu,B.Cu | 8.0 | 60.26
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
