geyan21/yam-tactile-kit/engineering/prototypes/f1/electronics/fanout/pcb/f1_fanout_r3_pins.csv

reference | pad | net | layer | pcb_x_mm | pcb_y_mm
J0R | MP2 |  | F.Cu | 71.9 | 27.4
J0R | MP1 |  | F.Cu | 62.1 | 27.4
J0R | 6 |  | F.Cu | 69.5 | 24.15
J0R | 5 |  | F.Cu | 68.5 | 24.15
J0R | 4 | R0_I | F.Cu | 67.5 | 24.15
J0R | 3 | R1_I | F.Cu | 66.5 | 24.15
J0R | 2 | R2_I | F.Cu | 65.5 | 24.15
J0R | 1 | R3_I | F.Cu | 64.5 | 24.15
J0C | MP2 |  | B.Cu | 62.1 | 27.4
J0C | MP1 |  | B.Cu | 71.9 | 27.4
J0C | 6 |  | B.Cu | 64.5 | 24.15
J0C | 5 |  | B.Cu | 65.5 | 24.15
J0C | 4 |  | B.Cu | 66.5 | 24.15
J0C | 3 | C0_I | B.Cu | 67.5 | 24.15
J0C | 2 |  | B.Cu | 68.5 | 24.15
J0C | 1 | C1_I | B.Cu | 69.5 | 24.15
RKC1 | 1 | C1_I | B.Cu | 69.5 | 22.81
RKC1 | 2 | C1_S | B.Cu | 69.5 | 21.79
RKC0 | 1 | C0_I | B.Cu | 67.5 | 22.81
RKC0 | 2 | C0_S | B.Cu | 67.5 | 21.79
J1R | MP2 |  | F.Cu | 62.1 | 10.6
J1R | MP1 |  | F.Cu | 71.9 | 10.6
J1R | 6 |  | F.Cu | 64.5 | 13.85
J1R | 5 |  | F.Cu | 65.5 | 13.85
J1R | 4 | R0_I | F.Cu | 66.5 | 13.85
J1R | 3 | R1_I | F.Cu | 67.5 | 13.85
J1R | 2 | R2_I | F.Cu | 68.5 | 13.85
J1R | 1 | R3_I | F.Cu | 69.5 | 13.85
J1C | MP2 |  | B.Cu | 71.9 | 10.6
J1C | MP1 |  | B.Cu | 62.1 | 10.6
J1C | 6 |  | B.Cu | 69.5 | 13.85
J1C | 5 |  | B.Cu | 68.5 | 13.85
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
