geyan21/yam-tactile-kit/engineering/development/capacitive/k1/visuals/post_layout.png

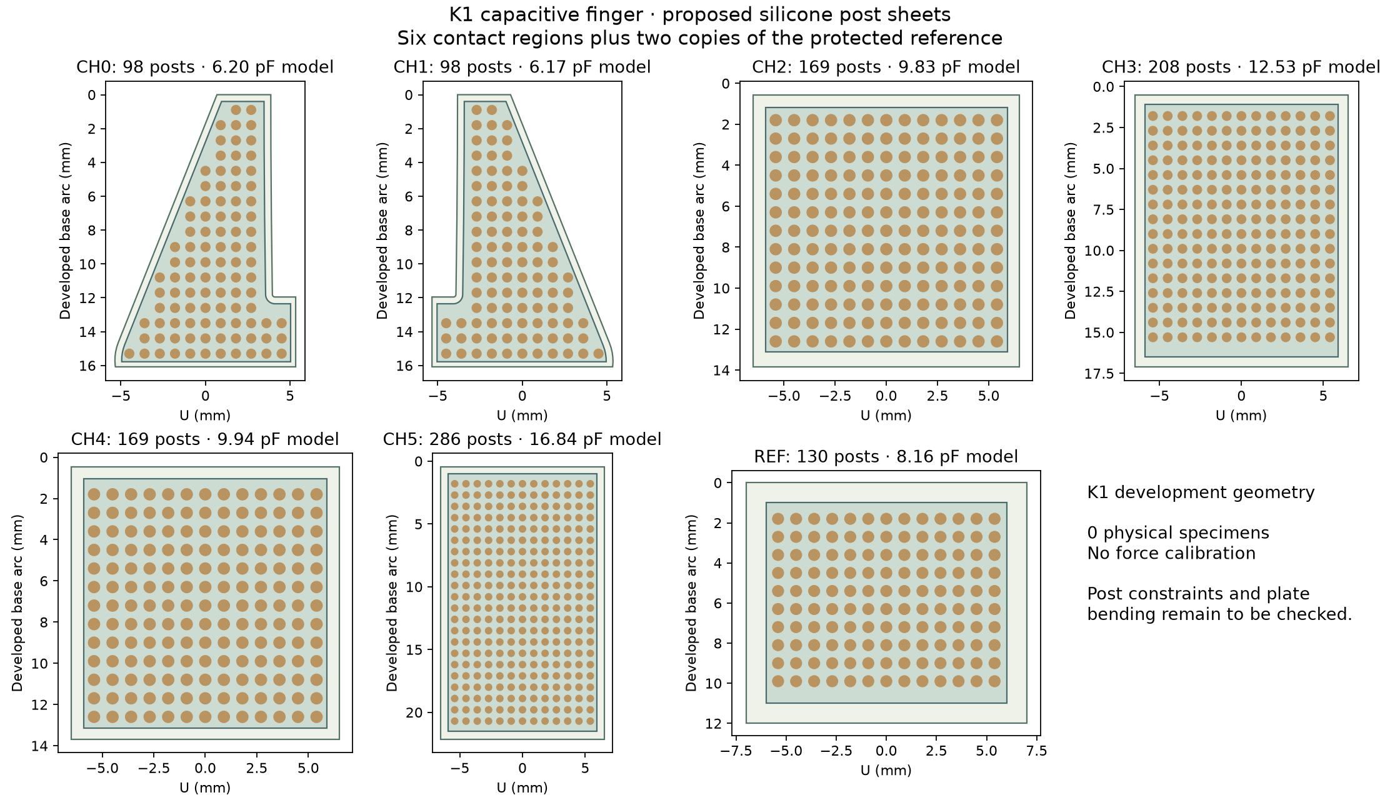
engineering/development/capacitive/k1/visuals/post_layout.png
