geyan21/yam-tactile-kit/engineering/development/f1/fitted-foils-r3/foils/f1_ch1_rows/f1_ch1_rows.png

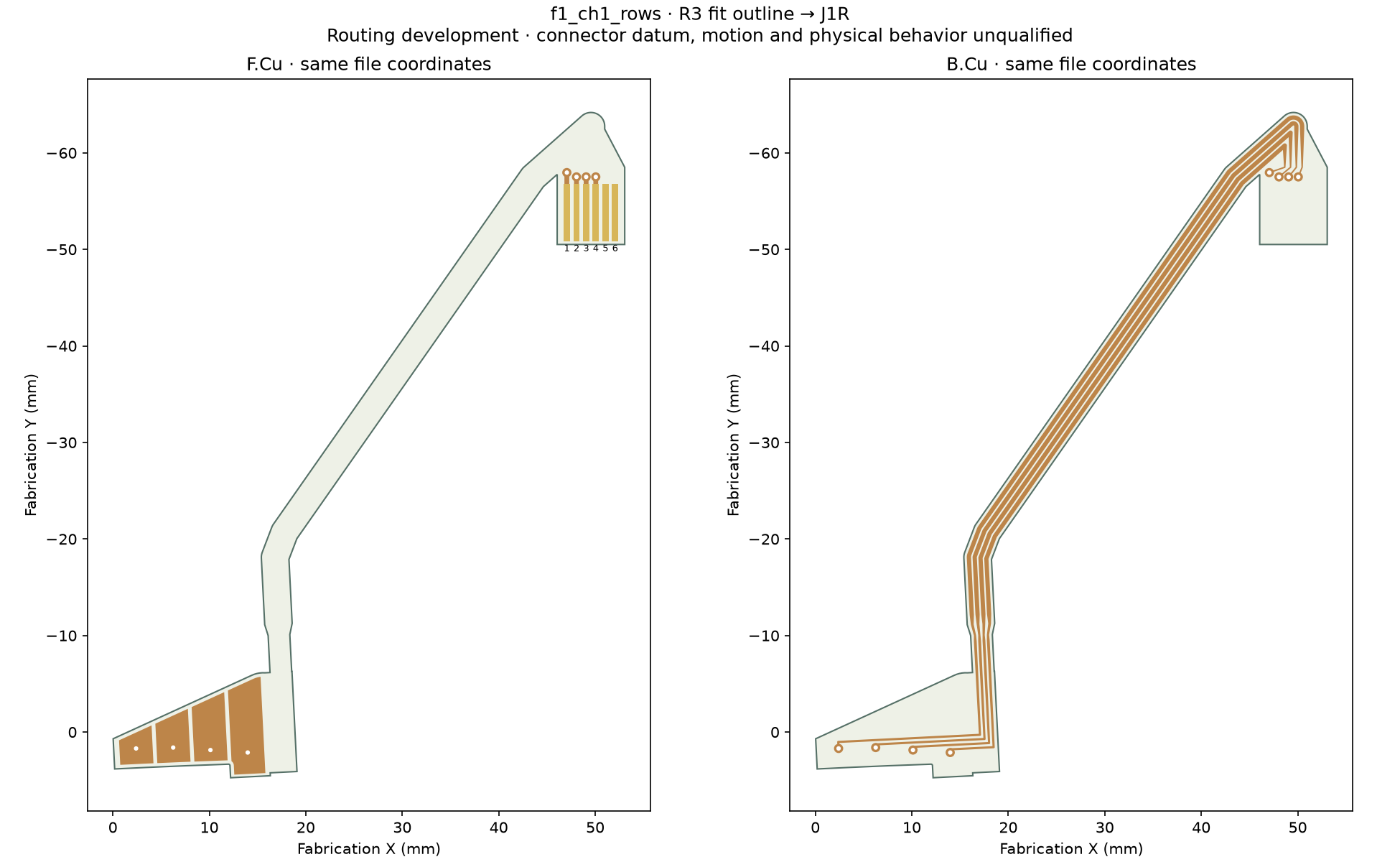
engineering/development/f1/fitted-foils-r3/foils/f1_ch1_rows/f1_ch1_rows.png
