geyan21/yam-tactile-kit/engineering/development/f1/fitted-foils-r3/foils/f1_ch4_rows/f1_ch4_rows.png

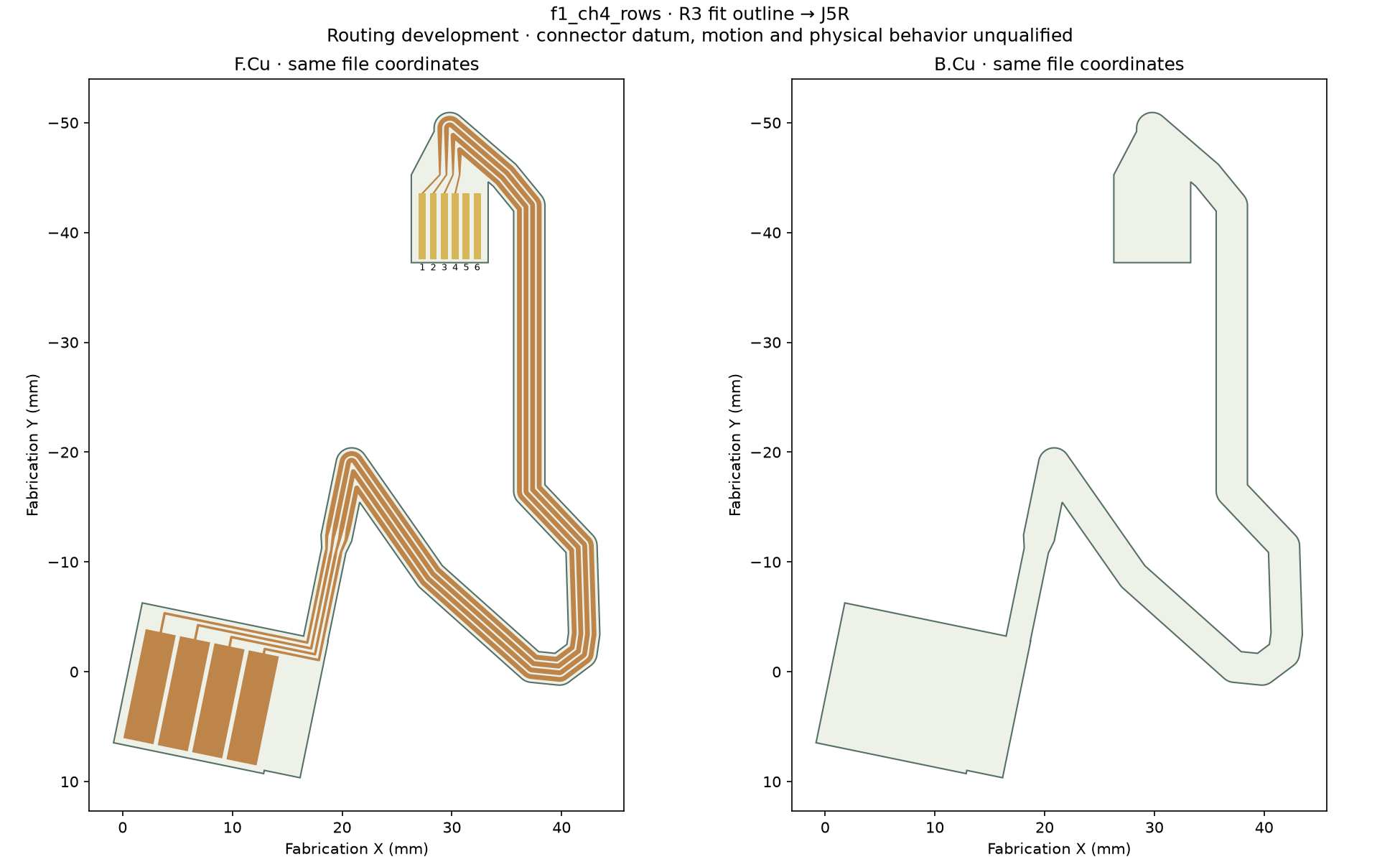
engineering/development/f1/fitted-foils-r3/foils/f1_ch4_rows/f1_ch4_rows.png
