geyan21/yam-tactile-kit/engineering/development/f1/mechanics/visuals/exit_sections.png

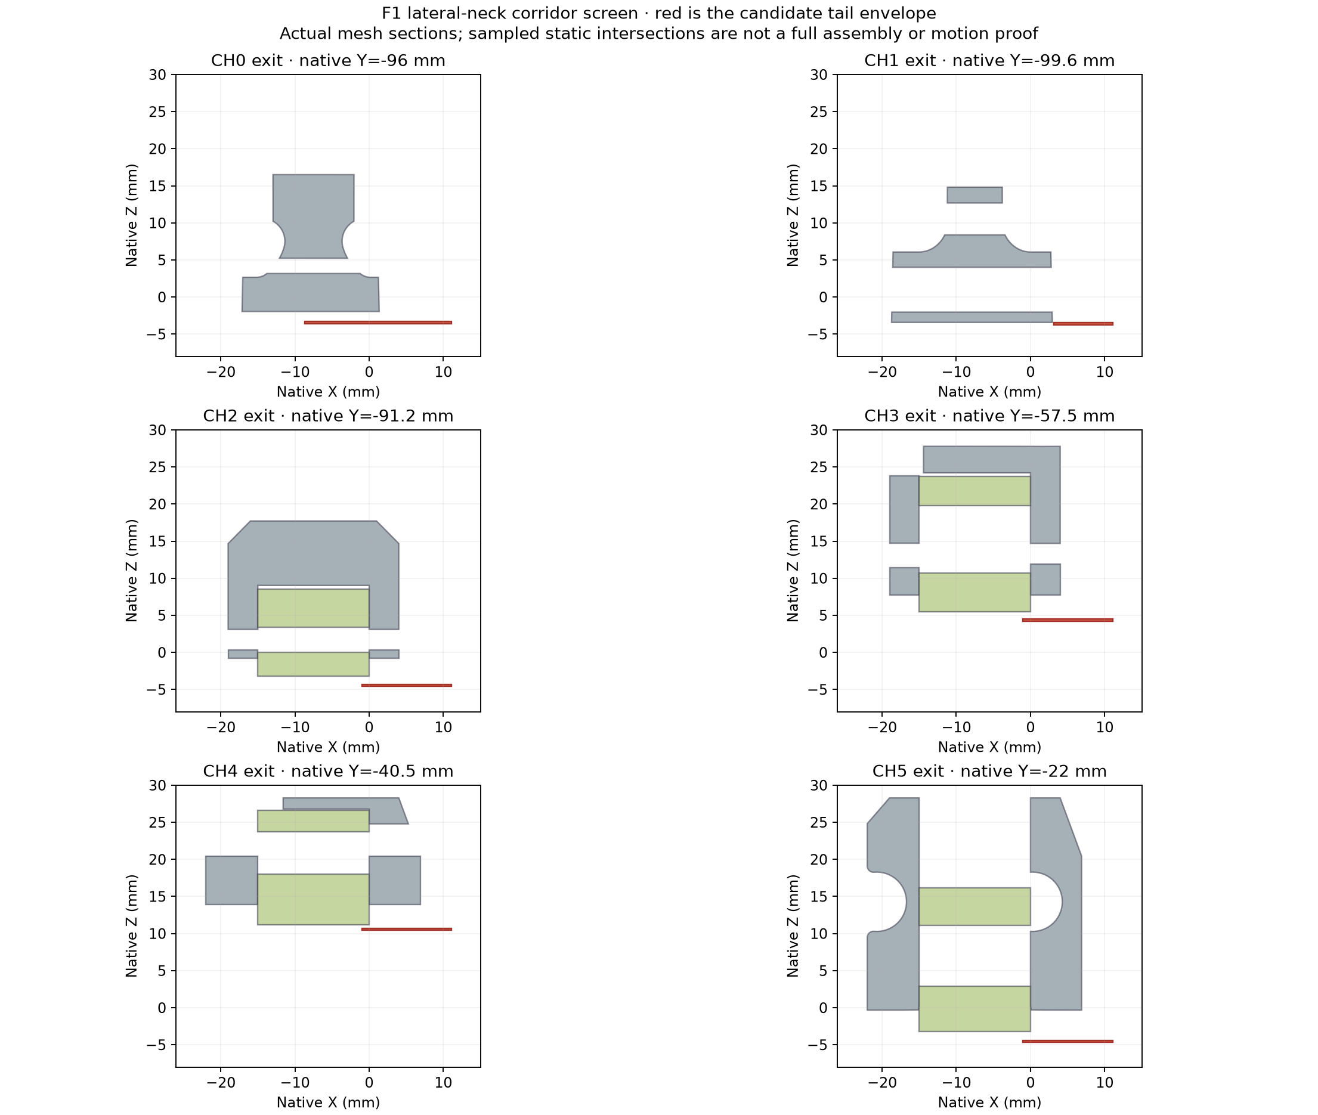
engineering/development/f1/mechanics/visuals/exit_sections.png
