geyan21/yam-tactile-kit/engineering/development/f1/mechanics/visuals/stack_bodies.png

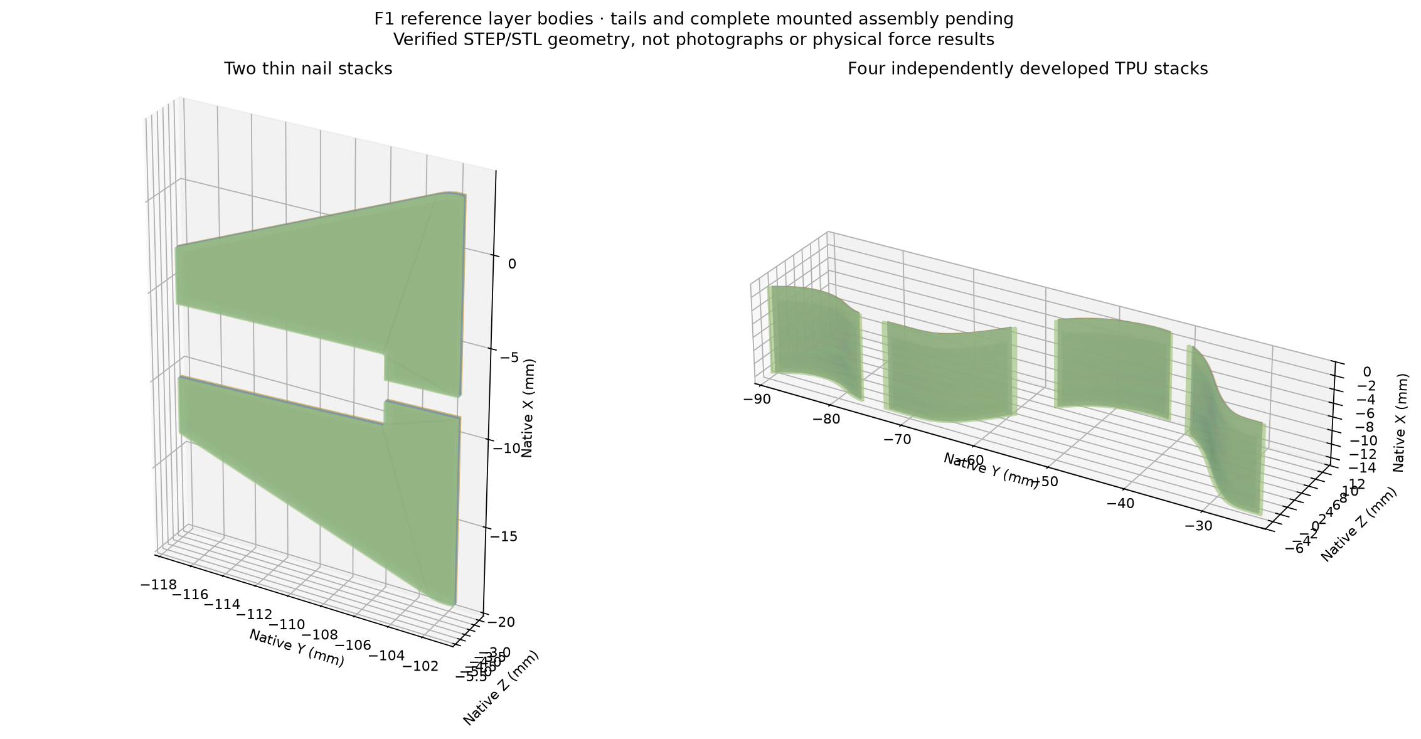
engineering/development/f1/mechanics/visuals/stack_bodies.png
