geyan21/yam-tactile-kit/engineering/development/f1/mechanics/visuals/stack_surfaces.png

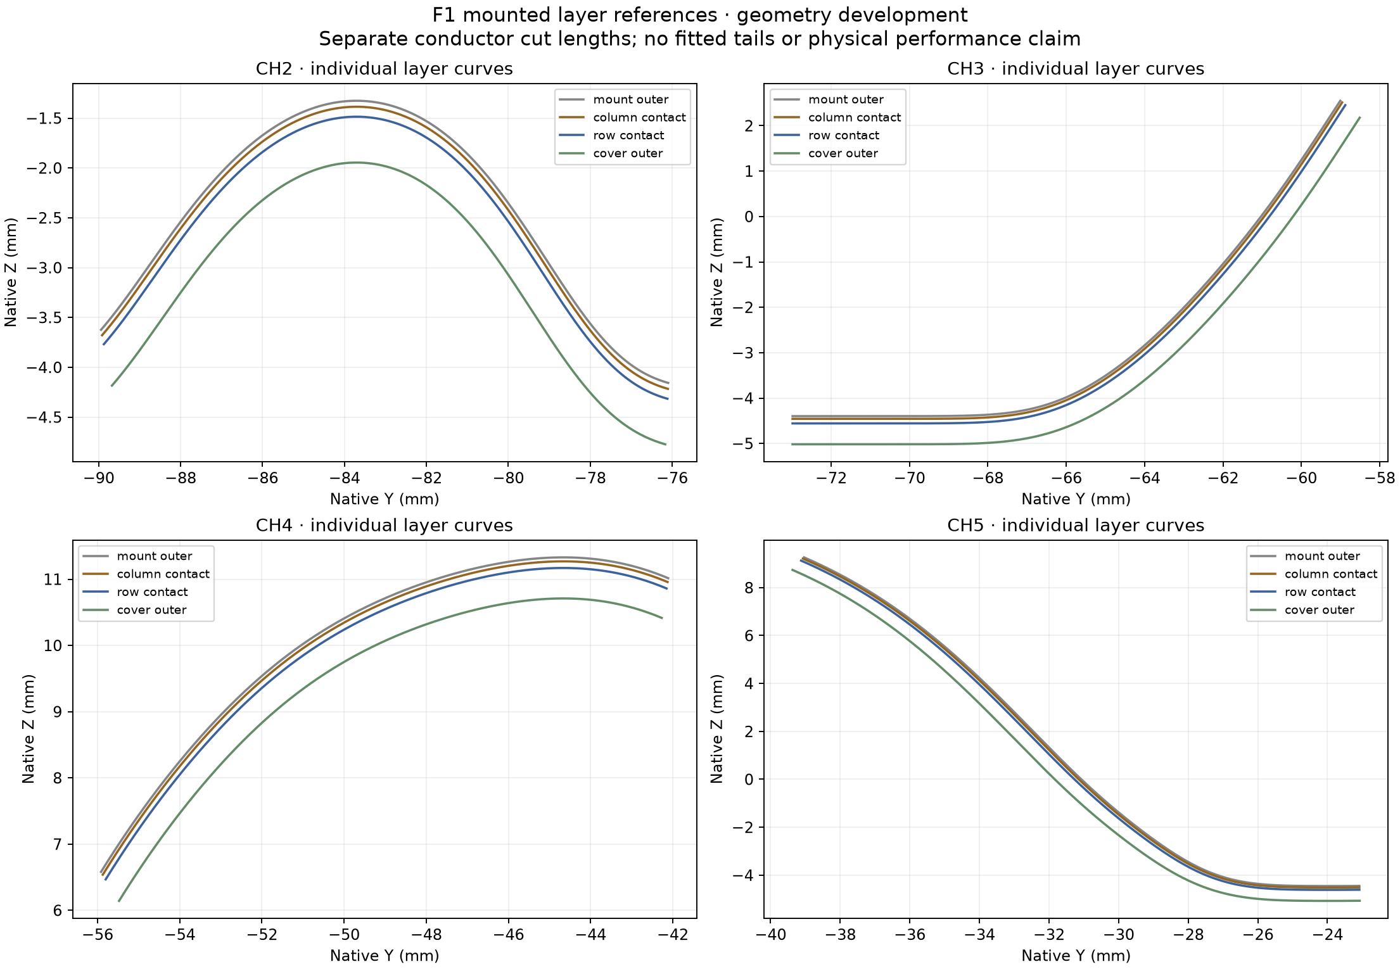
engineering/development/f1/mechanics/visuals/stack_surfaces.png
