geyan21/yam-tactile-kit/engineering/development/f1/mechanics/visuals/tab_placement.png

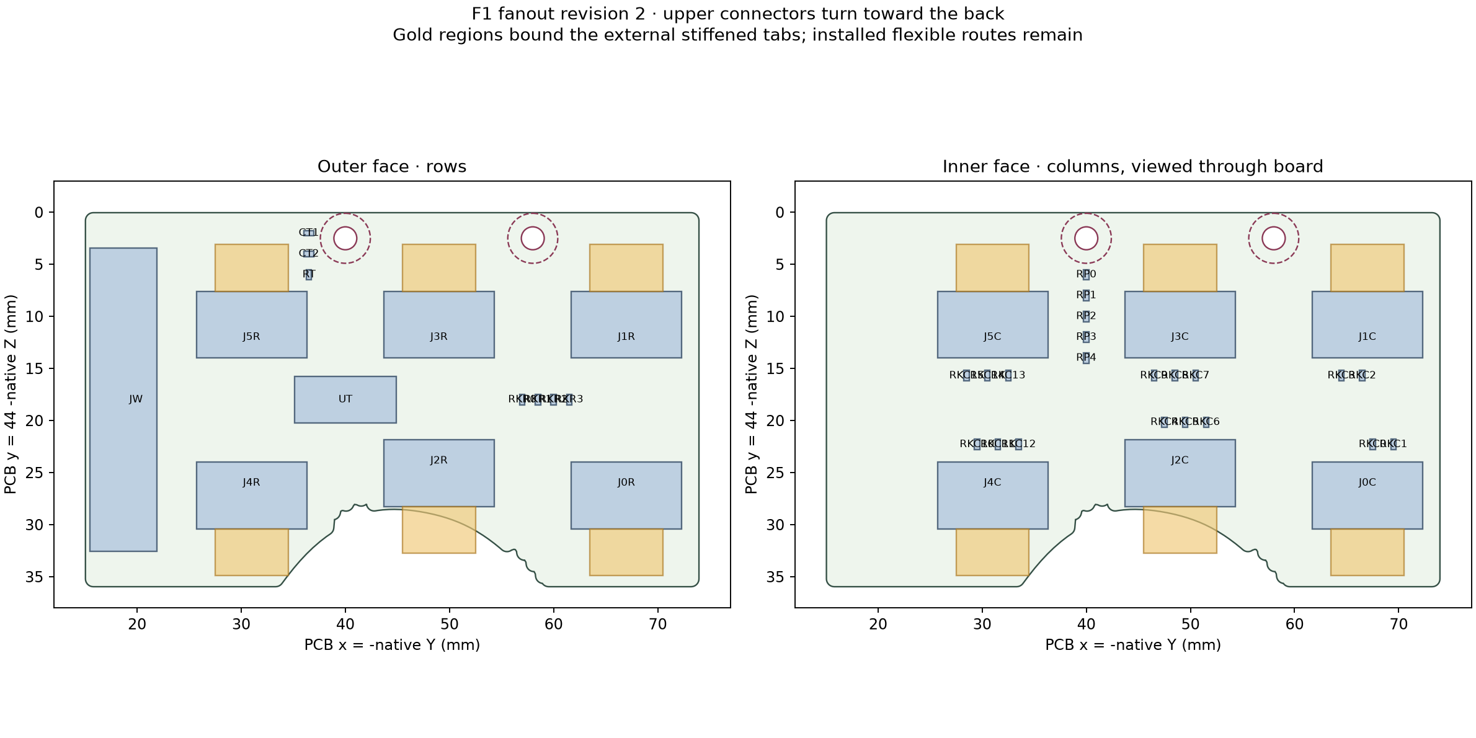
engineering/development/f1/mechanics/visuals/tab_placement.png
