geyan21/yam-tactile-kit/engineering/development/f1/mechanics/visuals/tail_routes.png

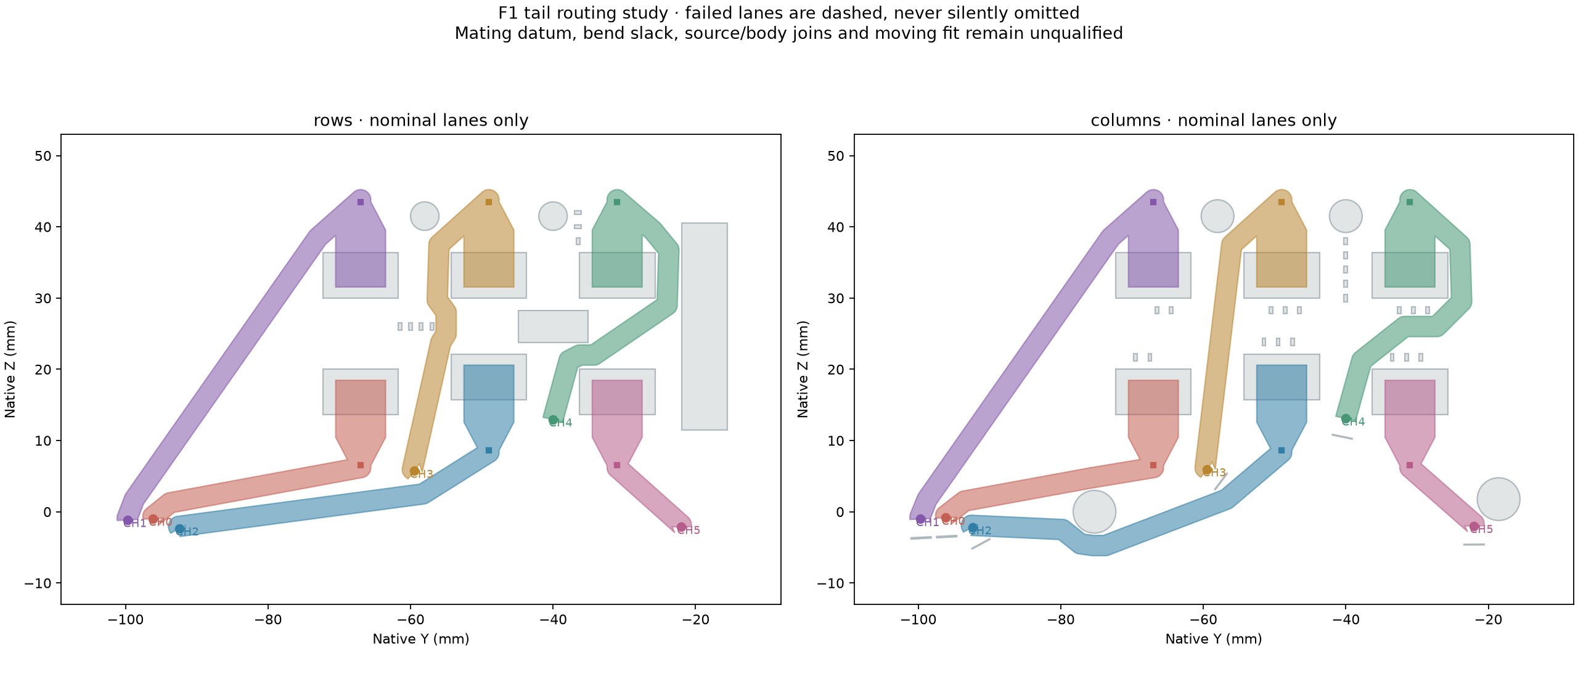
engineering/development/f1/mechanics/visuals/tail_routes.png
