geyan21/yam-tactile-kit/engineering/development/f1/r3/cable/mating_pose.png

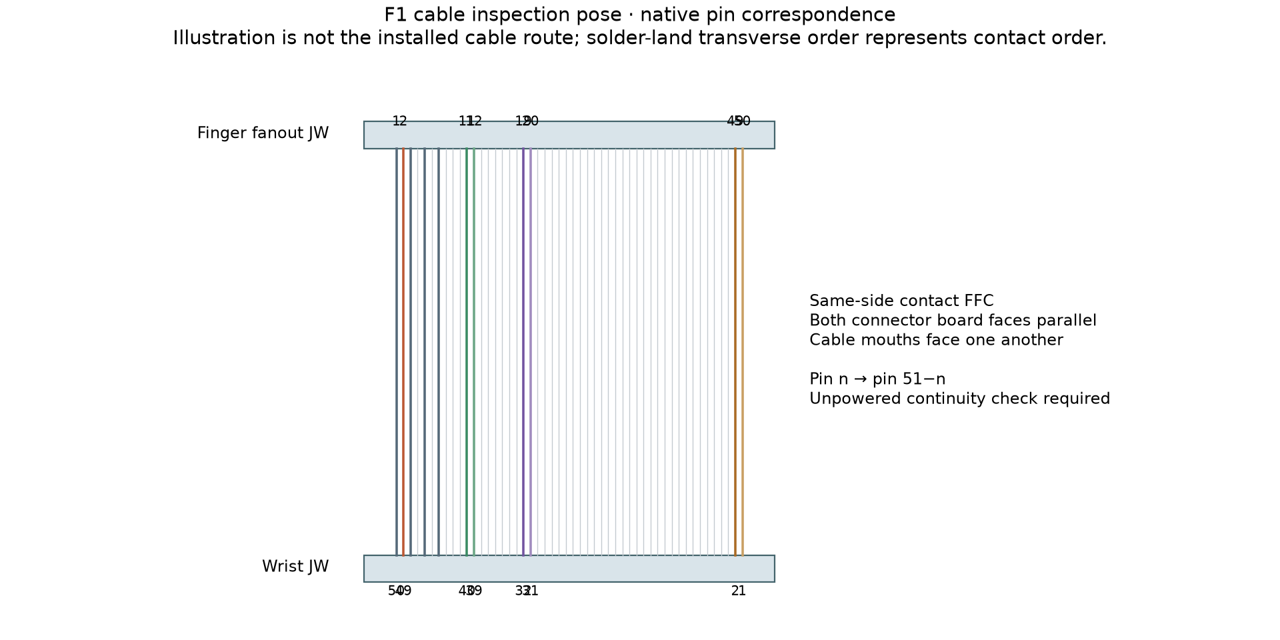
engineering/development/f1/r3/cable/mating_pose.png
