geyan21/yam-tactile-kit/engineering/development/f1/r3/visuals/placement.png

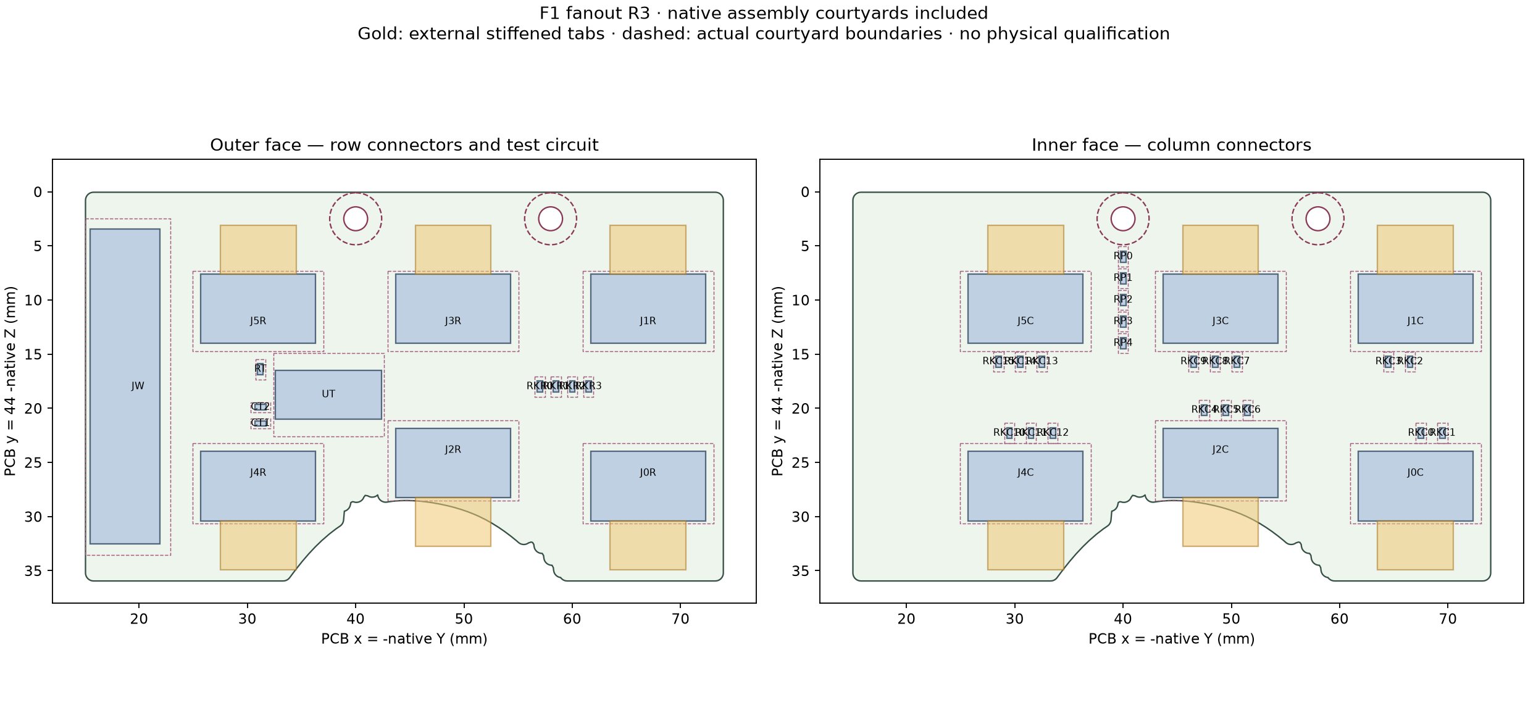
engineering/development/f1/r3/visuals/placement.png
