geyan21/yam-tactile-kit/engineering/prototypes/b2/b2_exploded.png

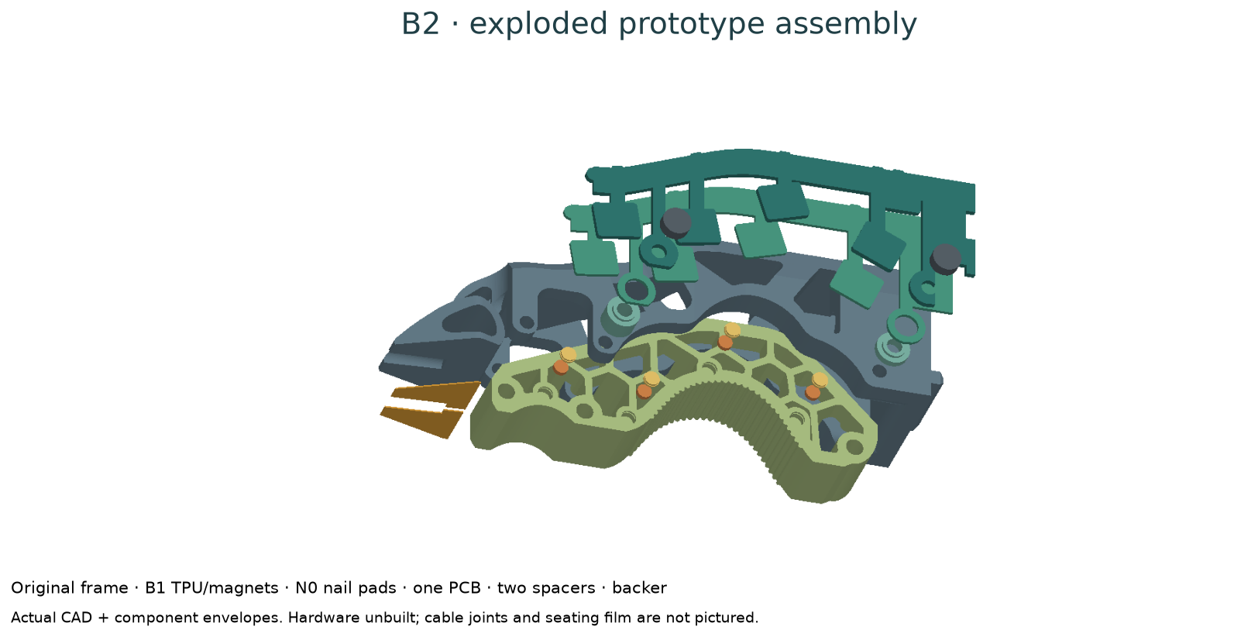
engineering/prototypes/b2/b2_exploded.png
