geyan21/yam-tactile-kit/engineering/prototypes/c1/c1_exploded.png

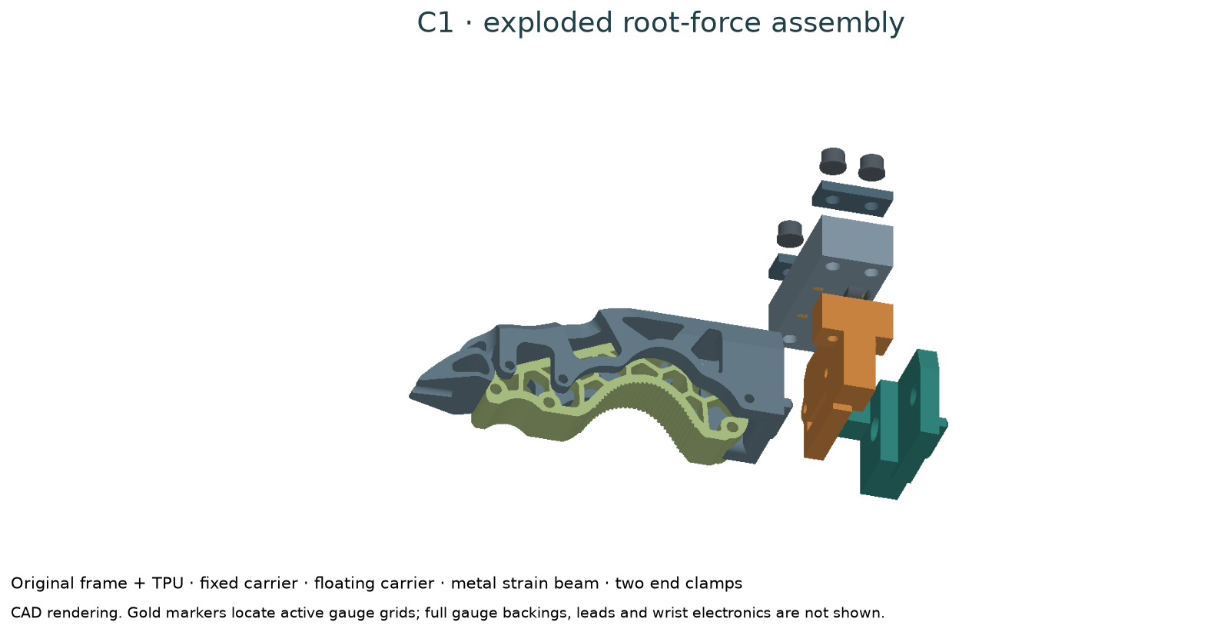
engineering/prototypes/c1/c1_exploded.png
