geyan21/yam-tactile-kit/engineering/prototypes/c1/c1_structural_screen.png

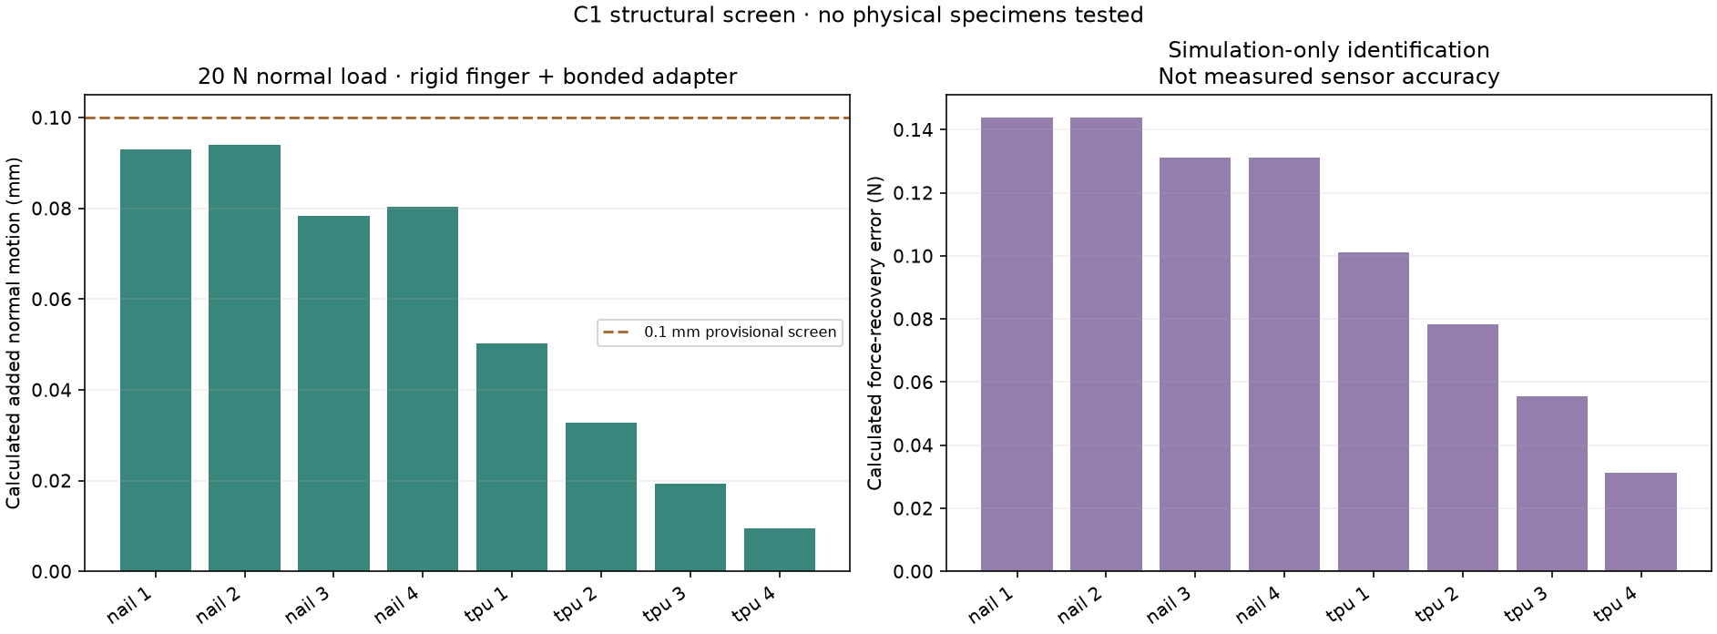
engineering/prototypes/c1/c1_structural_screen.png
