geyan21/yam-tactile-kit/engineering/prototypes/capacitive/visuals/k1_enclosure.png

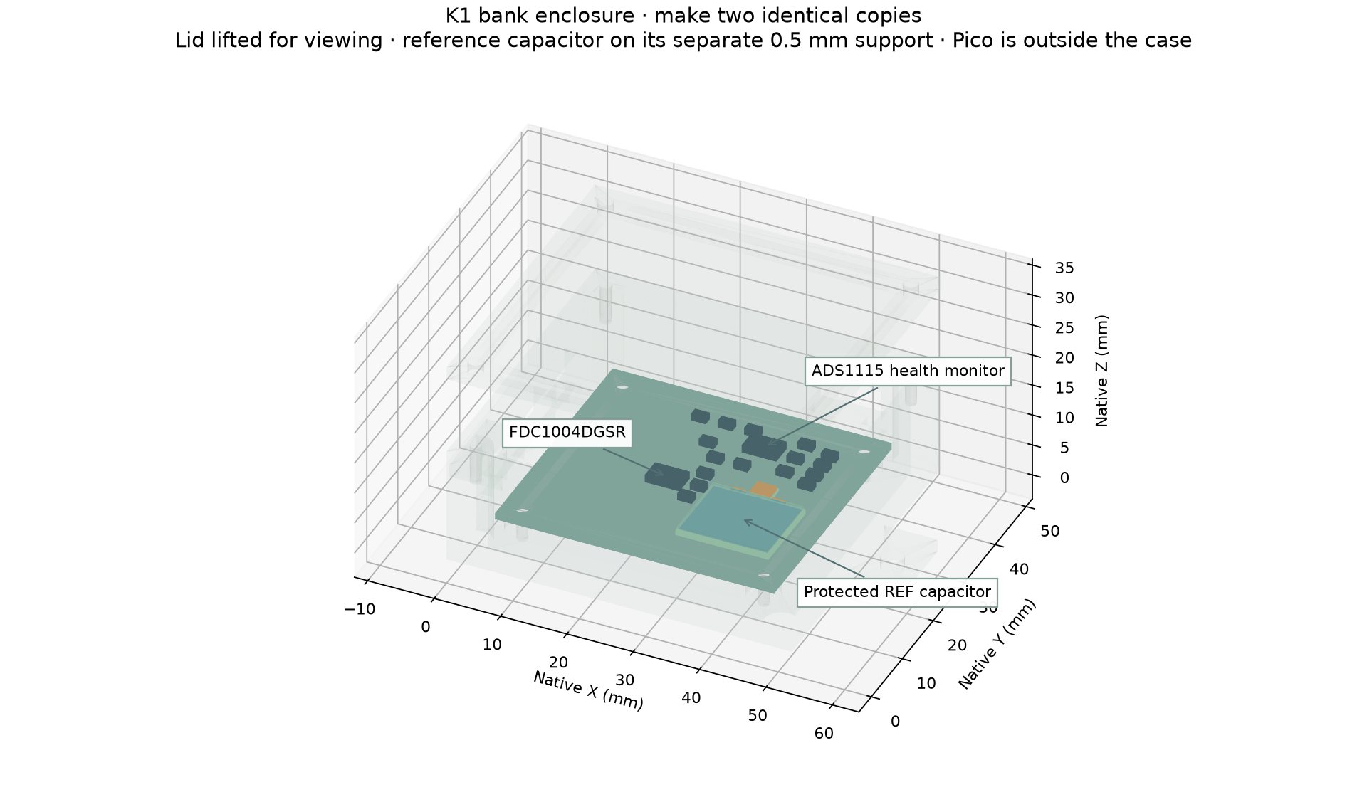
engineering/prototypes/capacitive/visuals/k1_enclosure.png
