geyan21/yam-tactile-kit/engineering/prototypes/f1/electronics/wrist/visuals/inner_ground.png

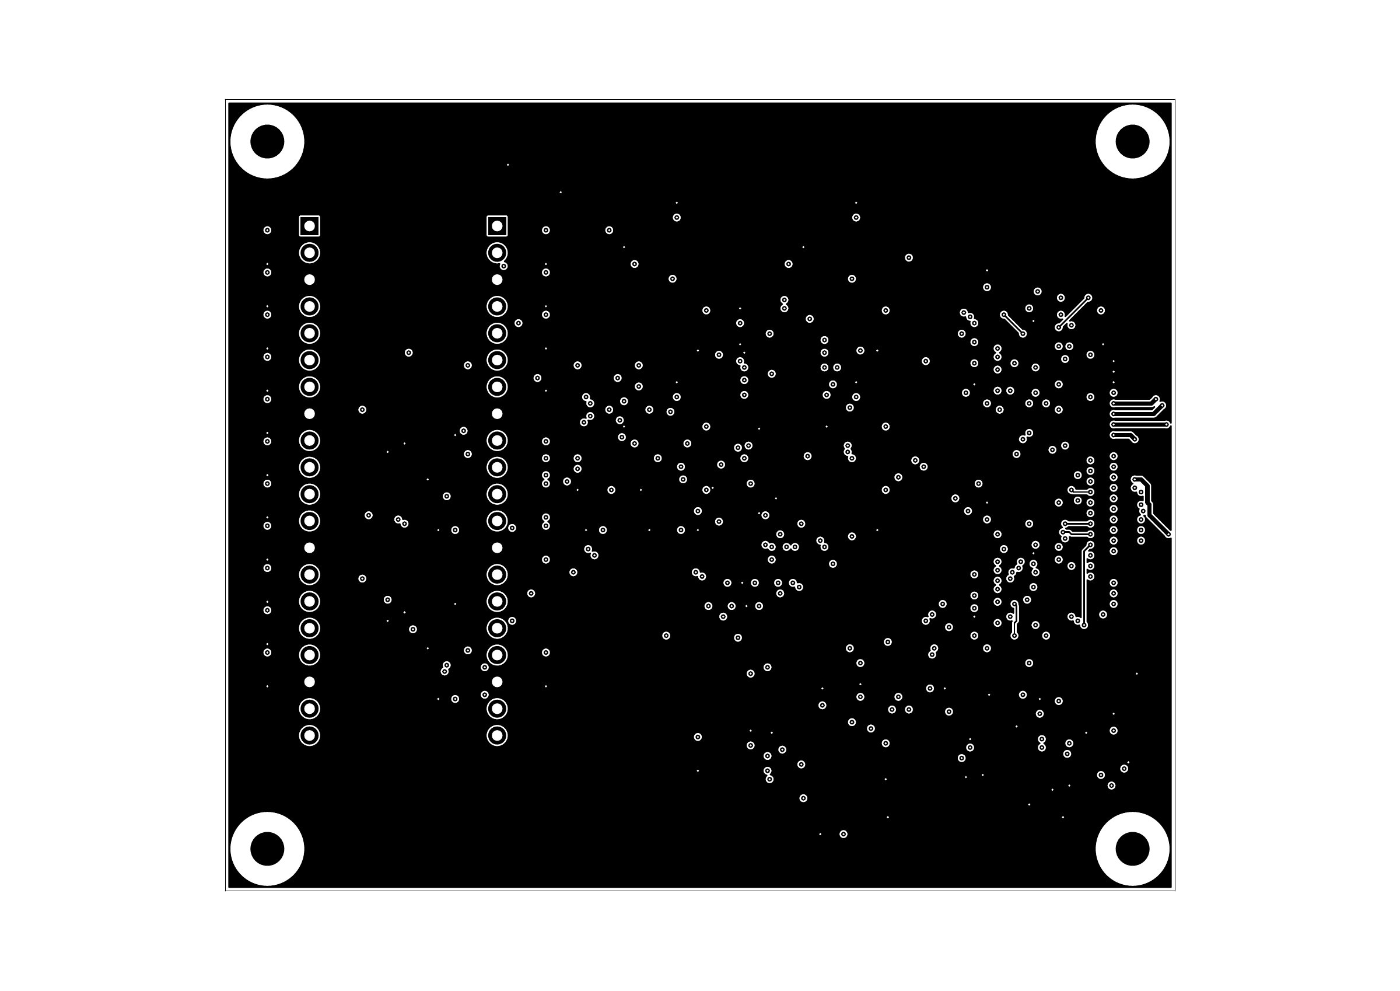
engineering/prototypes/f1/electronics/wrist/visuals/inner_ground.png
