geyan21/yam-tactile-kit/engineering/prototypes/f1/visuals/f1_fanout_faces.png

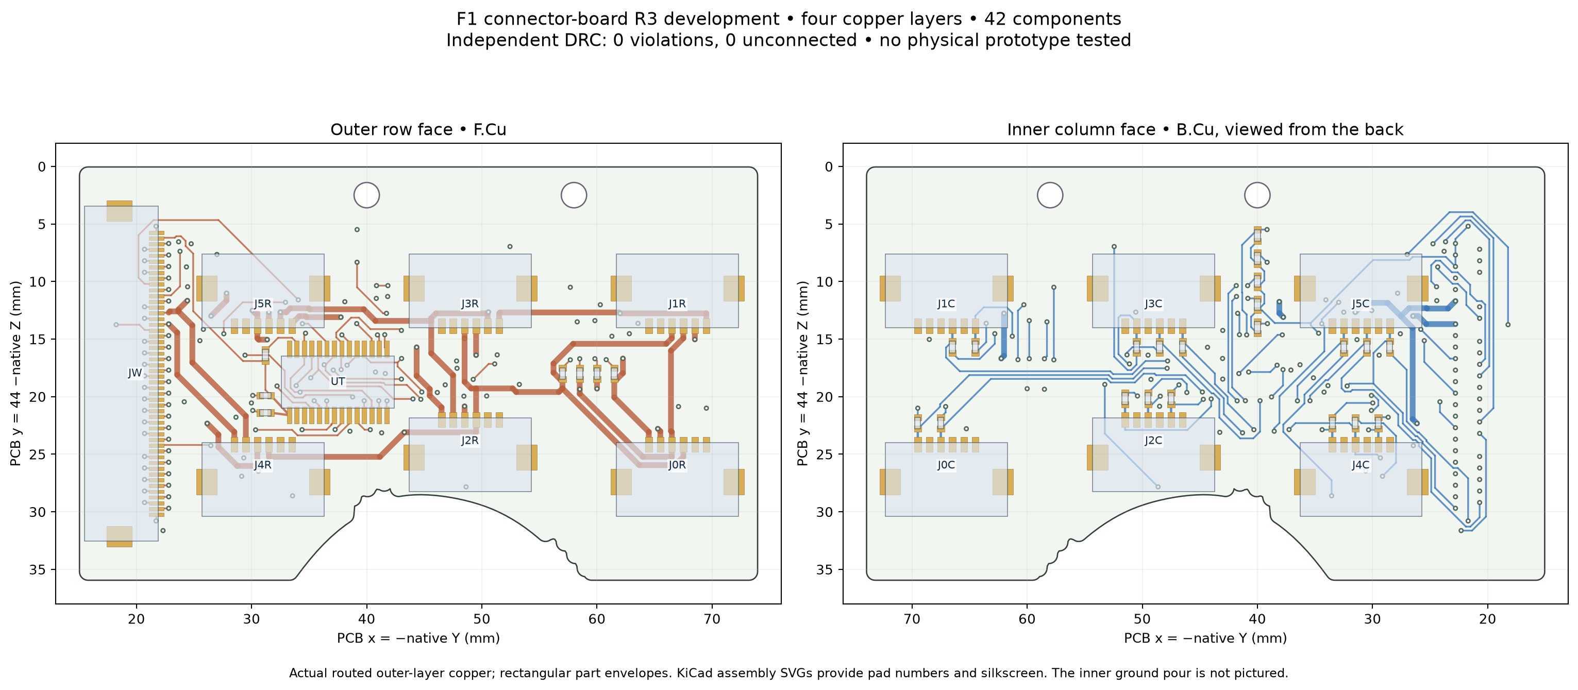
engineering/prototypes/f1/visuals/f1_fanout_faces.png
