geyan21/yam-tactile-kit/engineering/prototypes/f1/visuals/routed_dc_screen.png

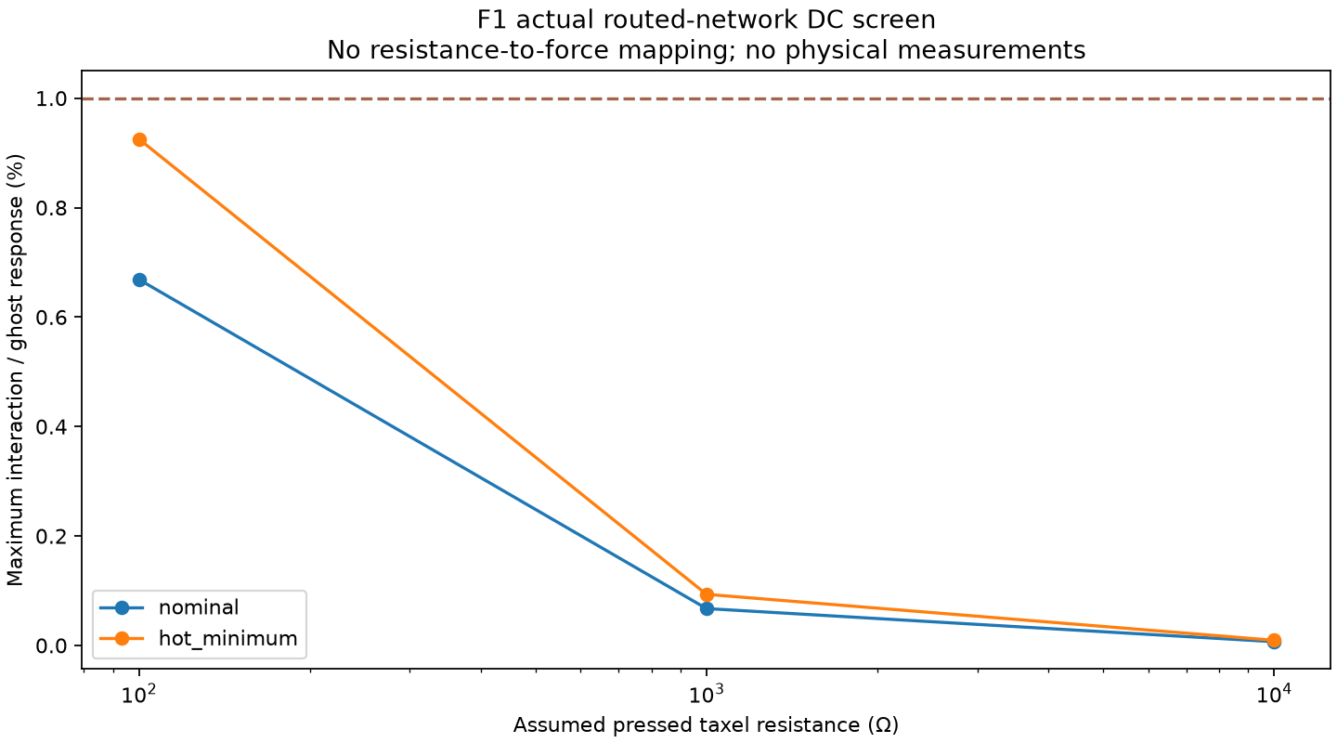
engineering/prototypes/f1/visuals/routed_dc_screen.png
