geyan21/yam-tactile-kit/engineering/prototypes/force_button/visuals/fb1_pcb.png

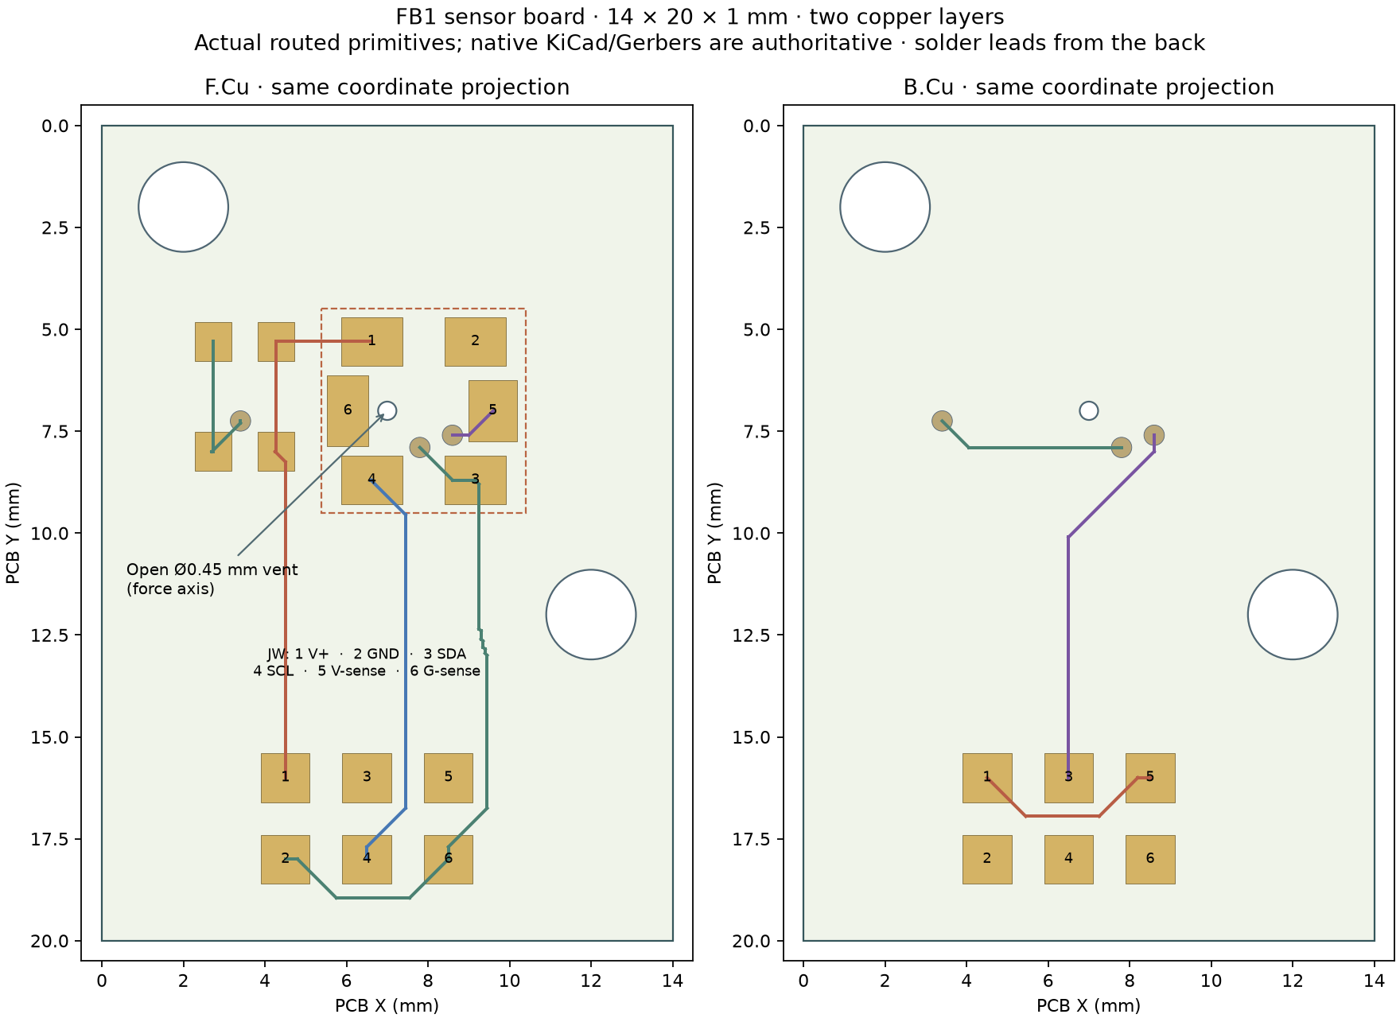
engineering/prototypes/force_button/visuals/fb1_pcb.png
