geyan21/yam-tactile-kit/engineering/prototypes/force_button/visuals/fb1_structural_screen.png

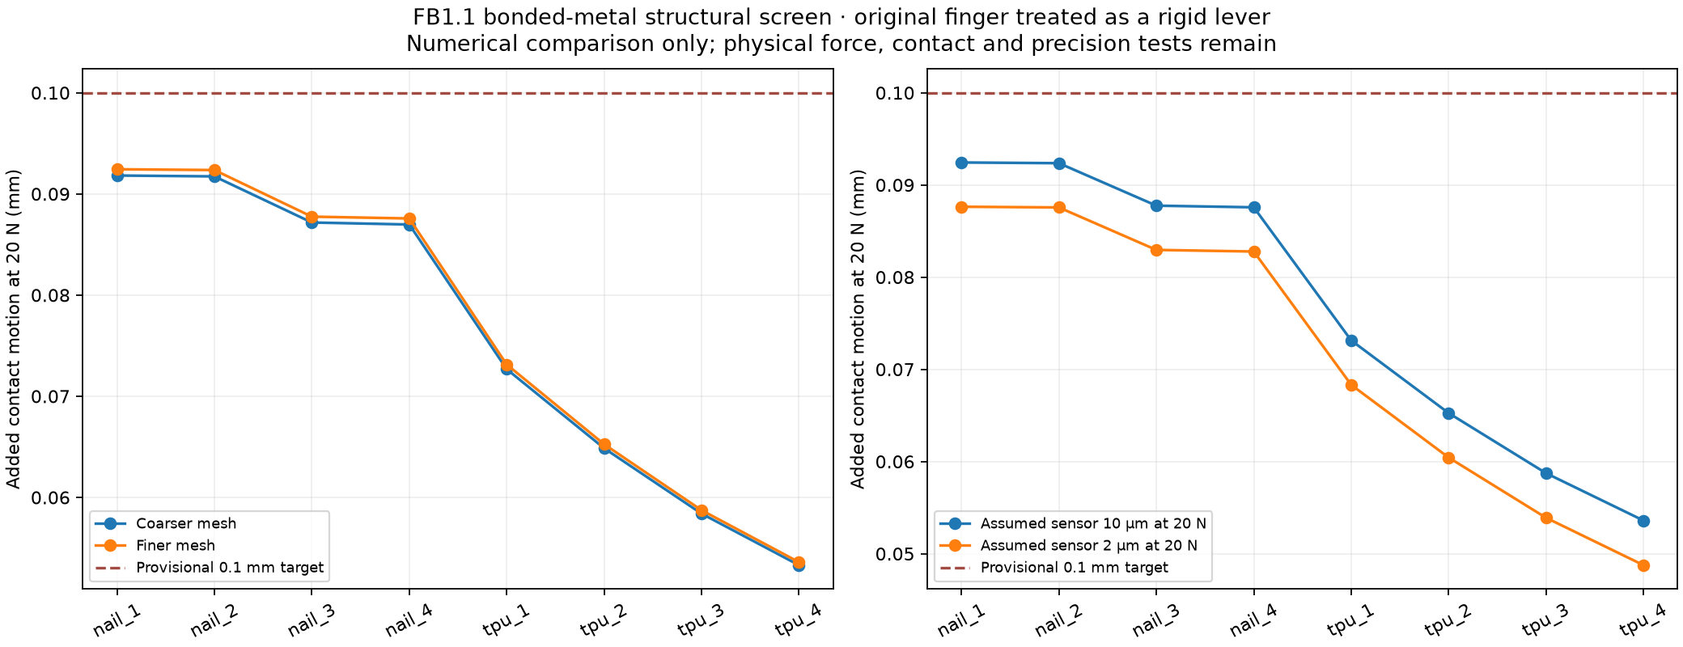
engineering/prototypes/force_button/visuals/fb1_structural_screen.png
