geyan21/yam-tactile-kit/engineering/prototypes/nail/nail_exploded.png

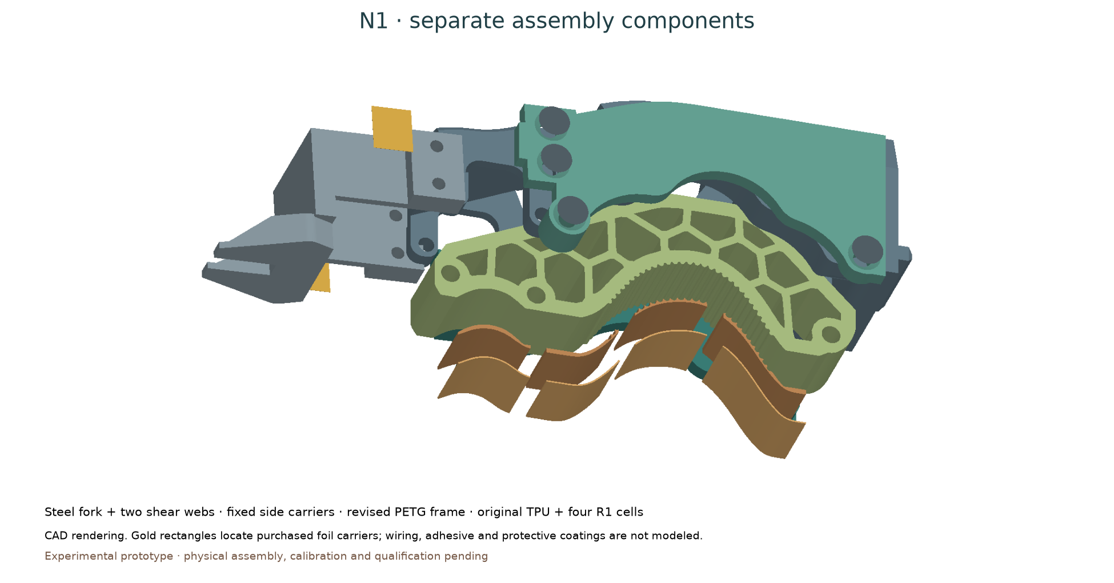
engineering/prototypes/nail/nail_exploded.png
