geyan21/yam-tactile-kit/engineering/prototypes/nail/nail_gauge_placement.png

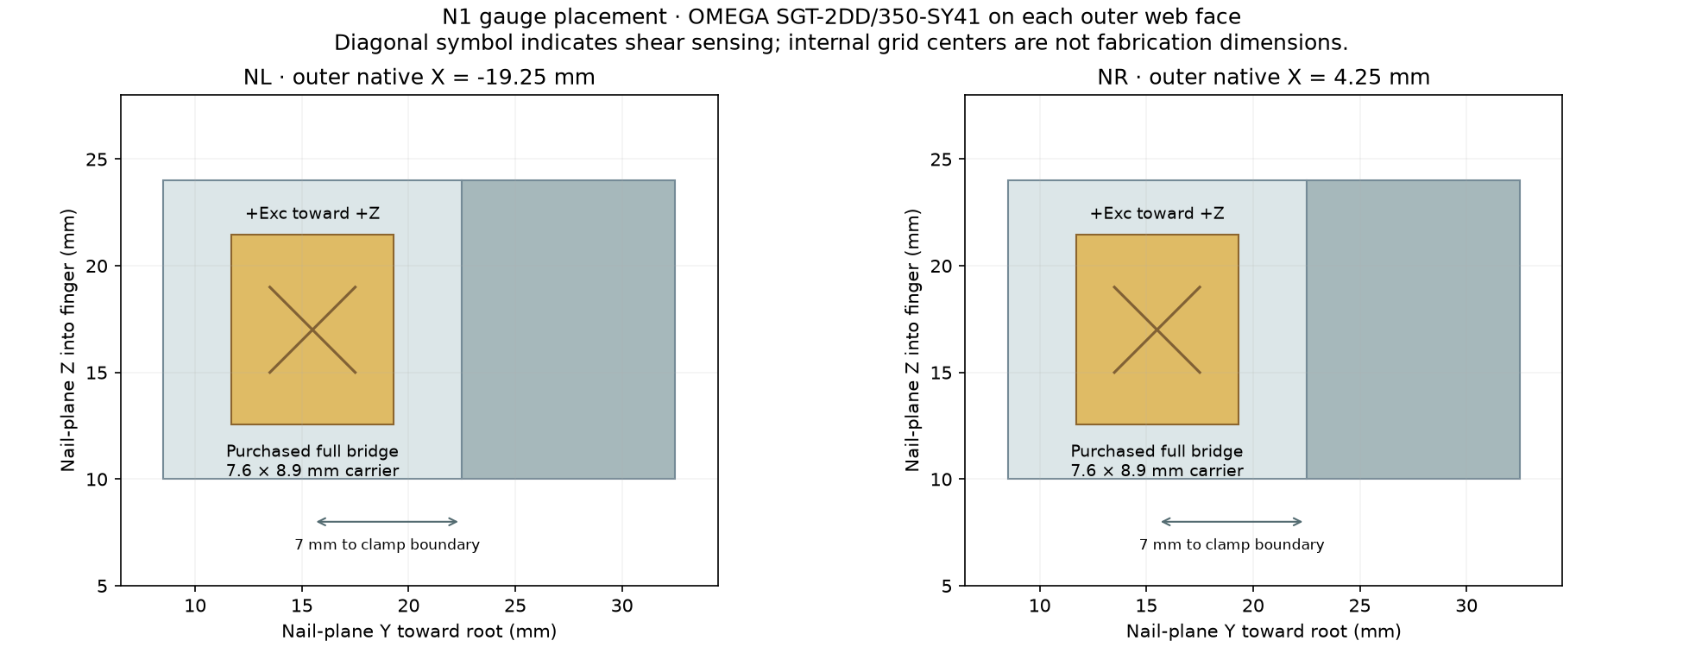
engineering/prototypes/nail/nail_gauge_placement.png
