geyan21/yam-tactile-kit/engineering/prototypes/nail/nail_structural_screen.png

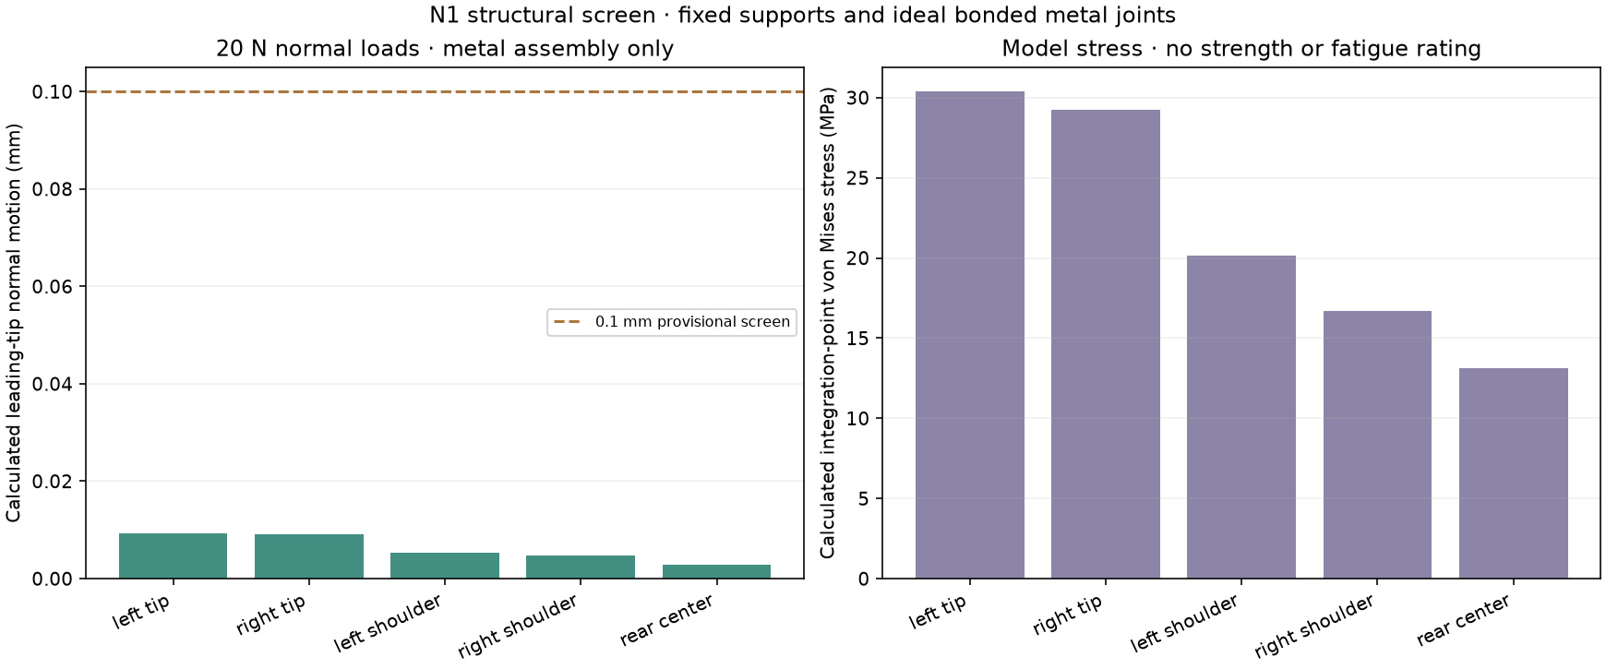
engineering/prototypes/nail/nail_structural_screen.png
