geyan21/yam-tactile-kit/engineering/prototypes/optical/visuals/o1_molds.png

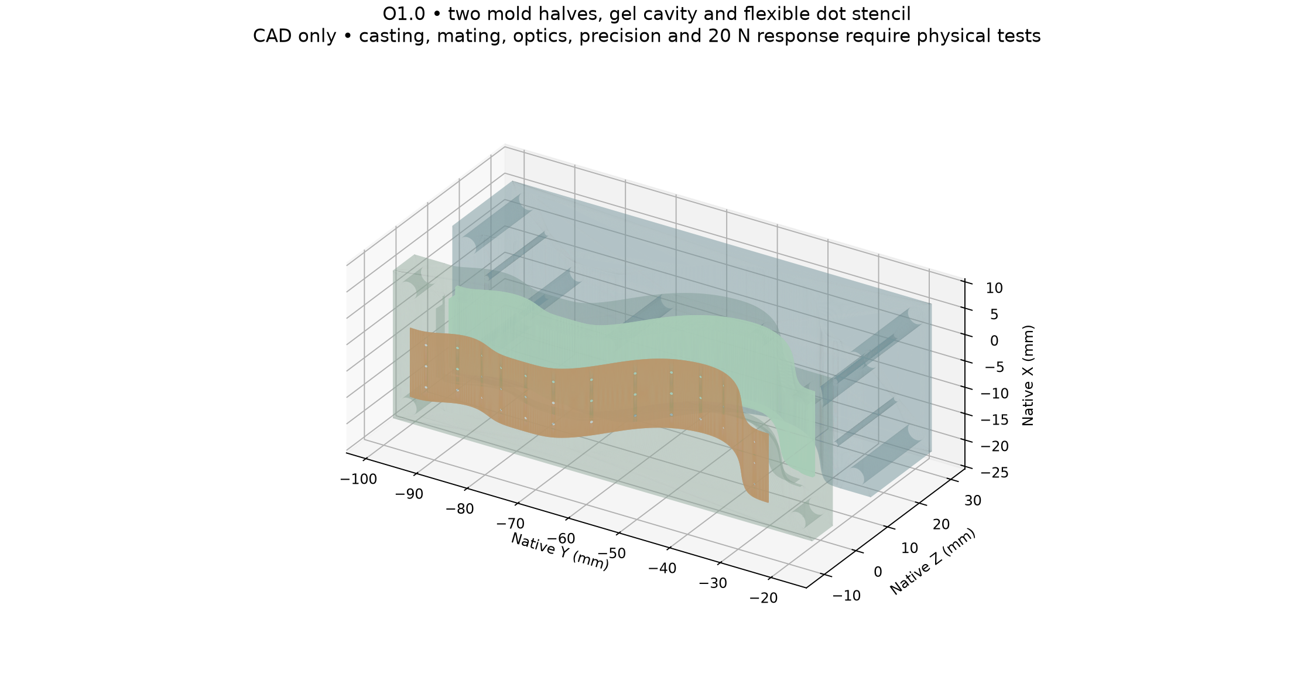
engineering/prototypes/optical/visuals/o1_molds.png
