geyan21/yam-tactile-kit/engineering/prototypes/optical/visuals/o1_sensor_placement.png

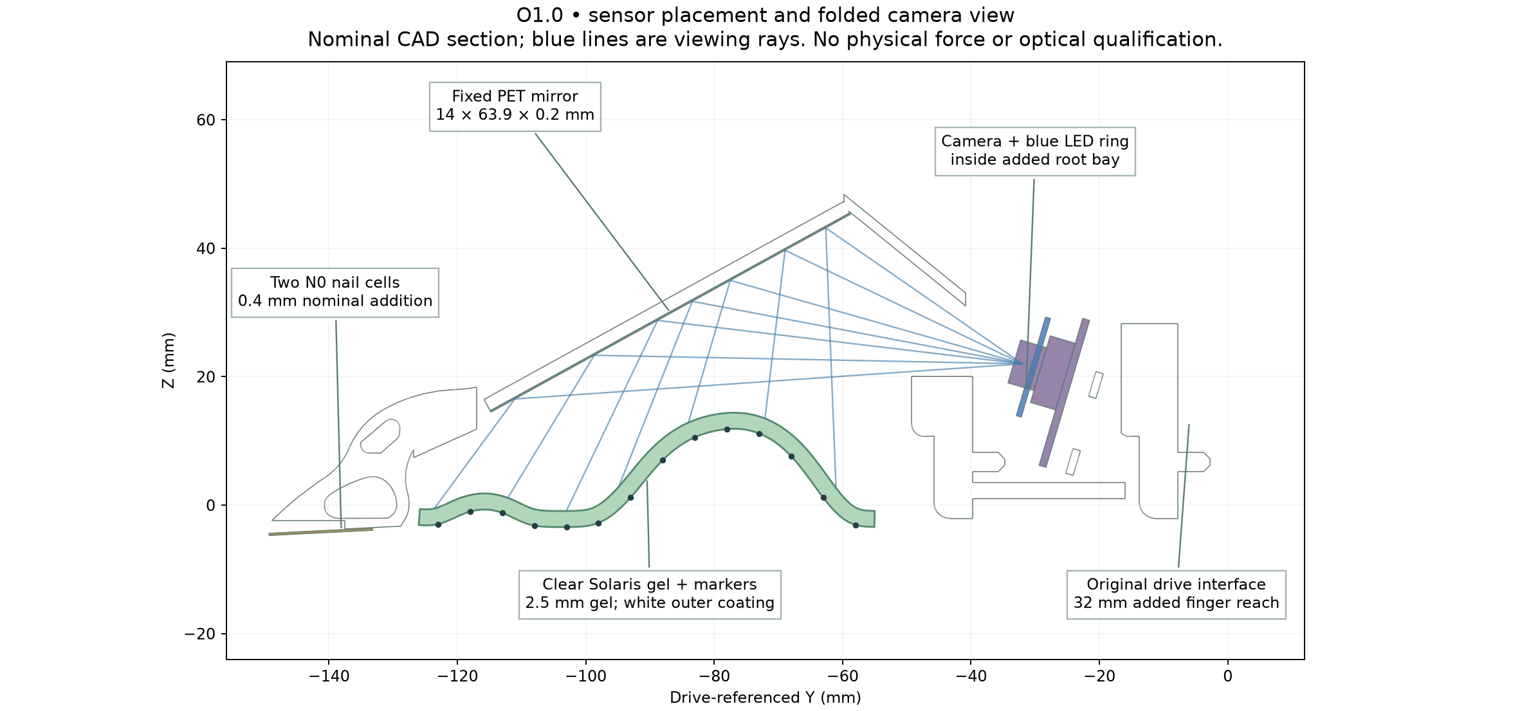
engineering/prototypes/optical/visuals/o1_sensor_placement.png
