geyan21/yam-tactile-kit/engineering/prototypes/pneumatic/visuals/p1_pcb_orientation.png

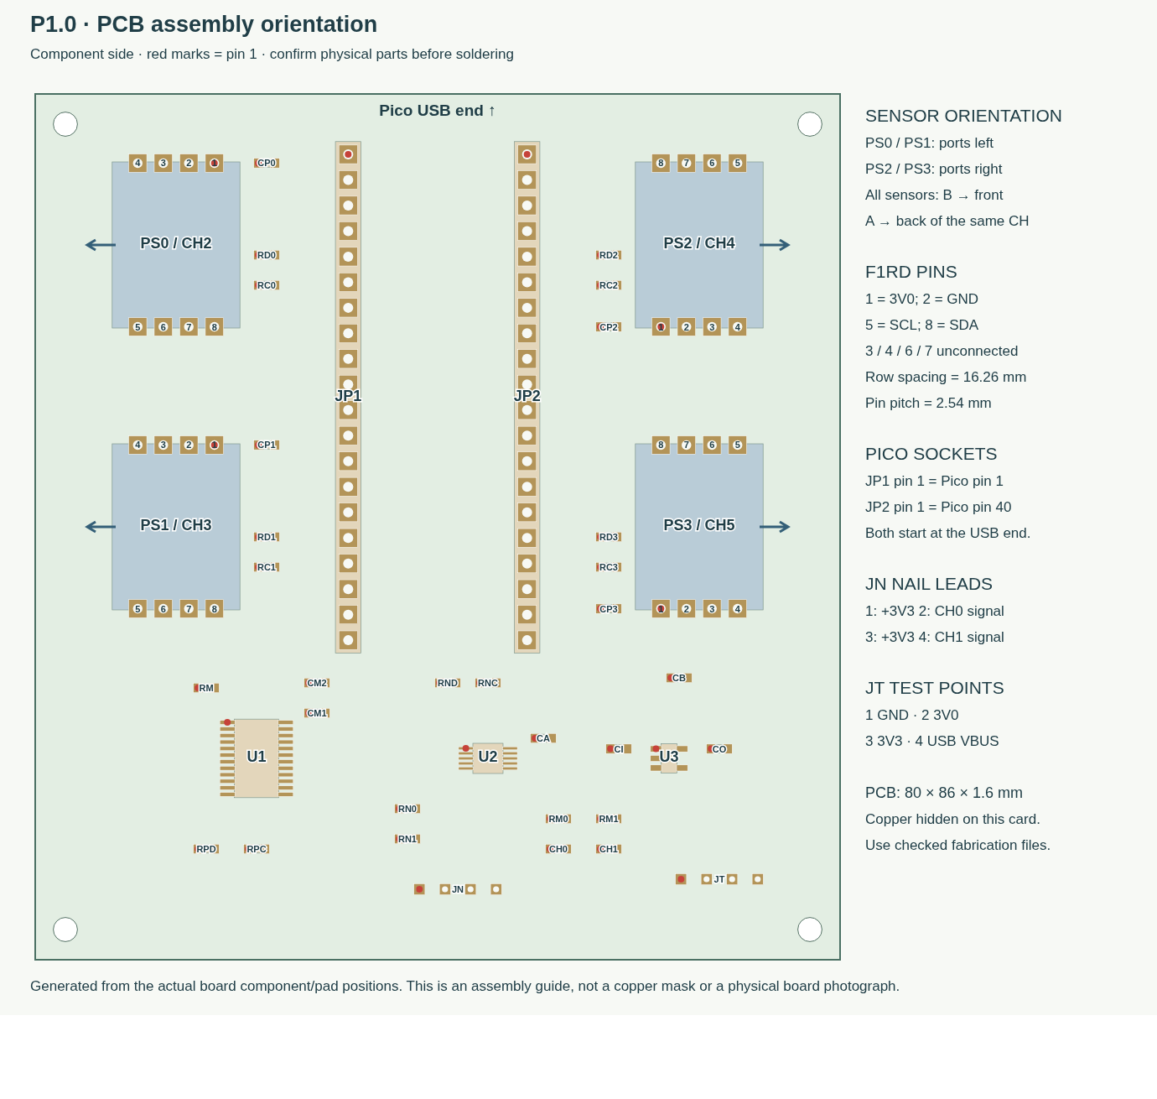
engineering/prototypes/pneumatic/visuals/p1_pcb_orientation.png
