geyan21/yam-tactile-kit/engineering/prototypes/recessed/recessed_exploded.png

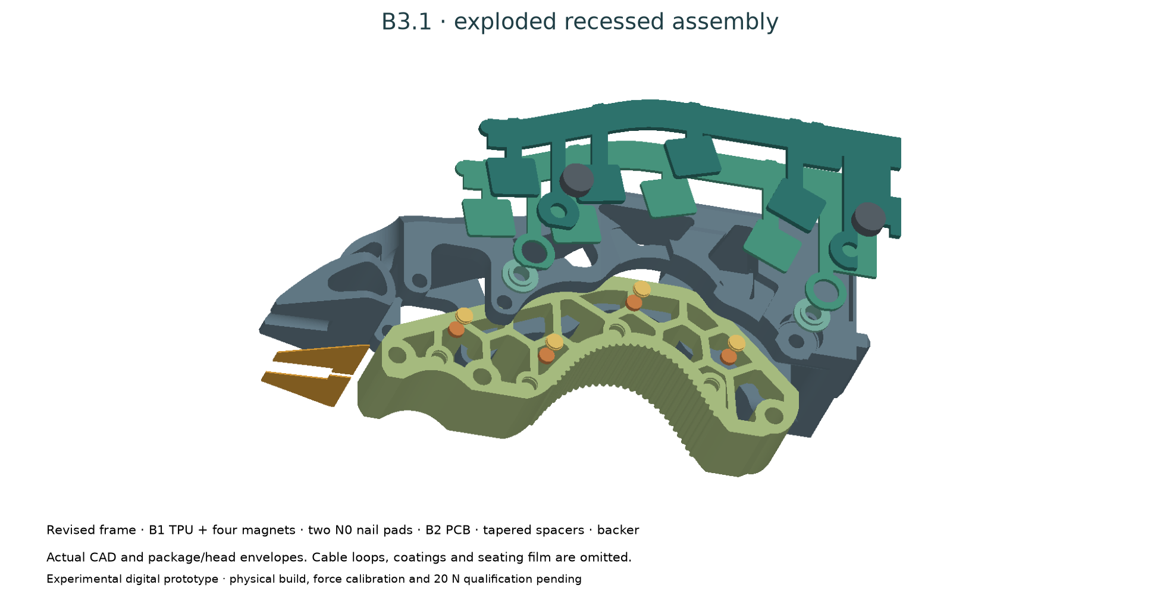
engineering/prototypes/recessed/recessed_exploded.png
