geyan21/yam-tactile-kit/engineering/prototypes/recessed/recessed_magnetic_screen.png

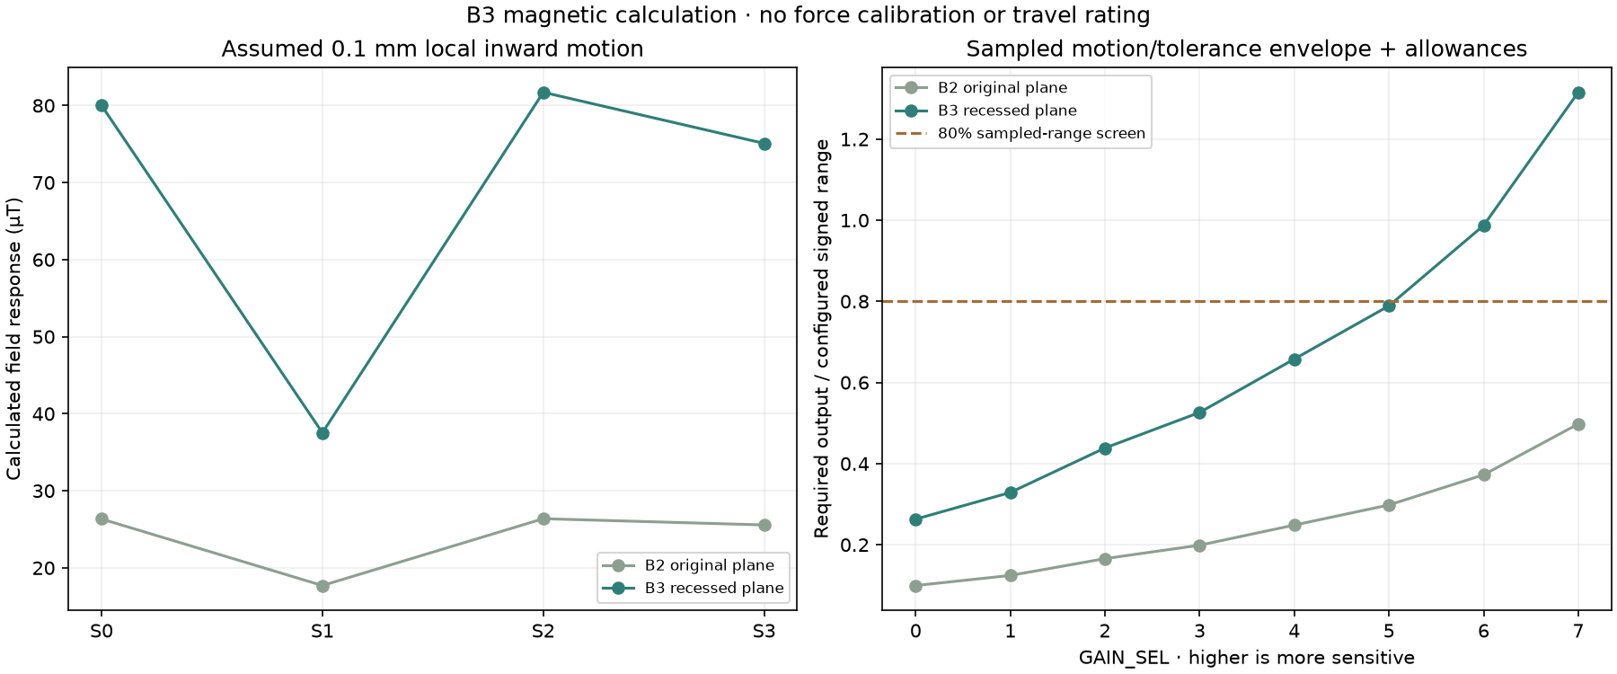
engineering/prototypes/recessed/recessed_magnetic_screen.png
