geyan21/yam-tactile-kit/engineering/prototypes/recessed/recessed_stack.png

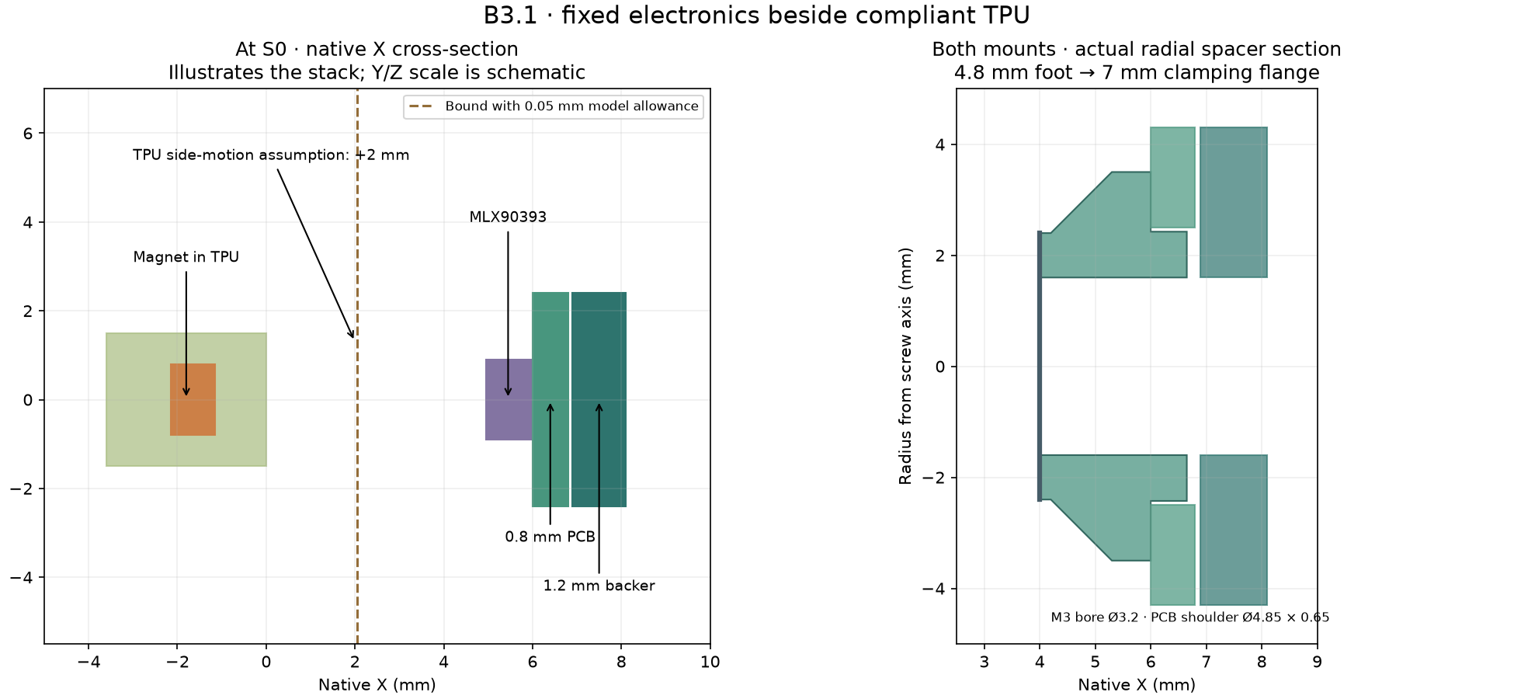
engineering/prototypes/recessed/recessed_stack.png
