geyan21/yam-tactile-kit/engineering/release/baseline/baseline_projections.png

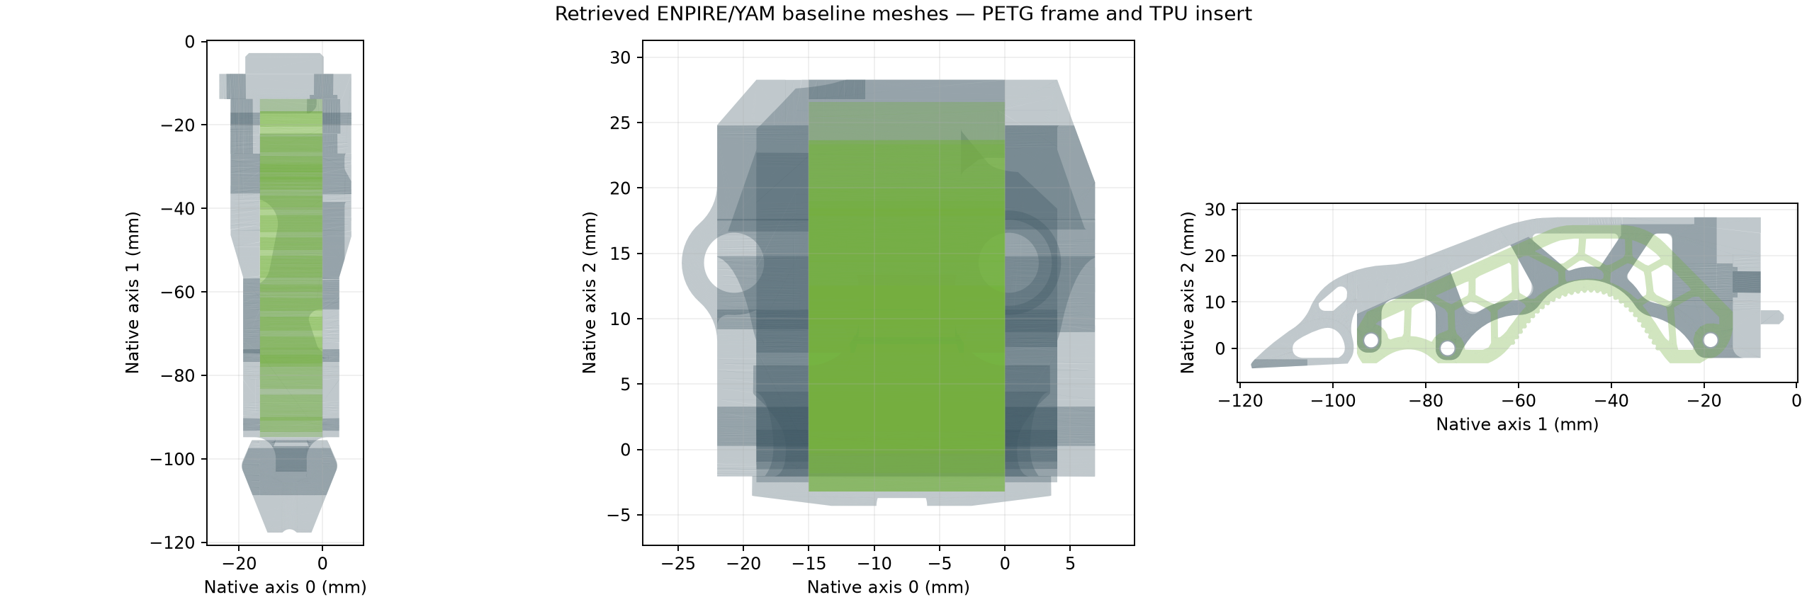
engineering/release/baseline/baseline_projections.png
