geyan21/yam-tactile-kit/engineering/release/l1/root_interface.png

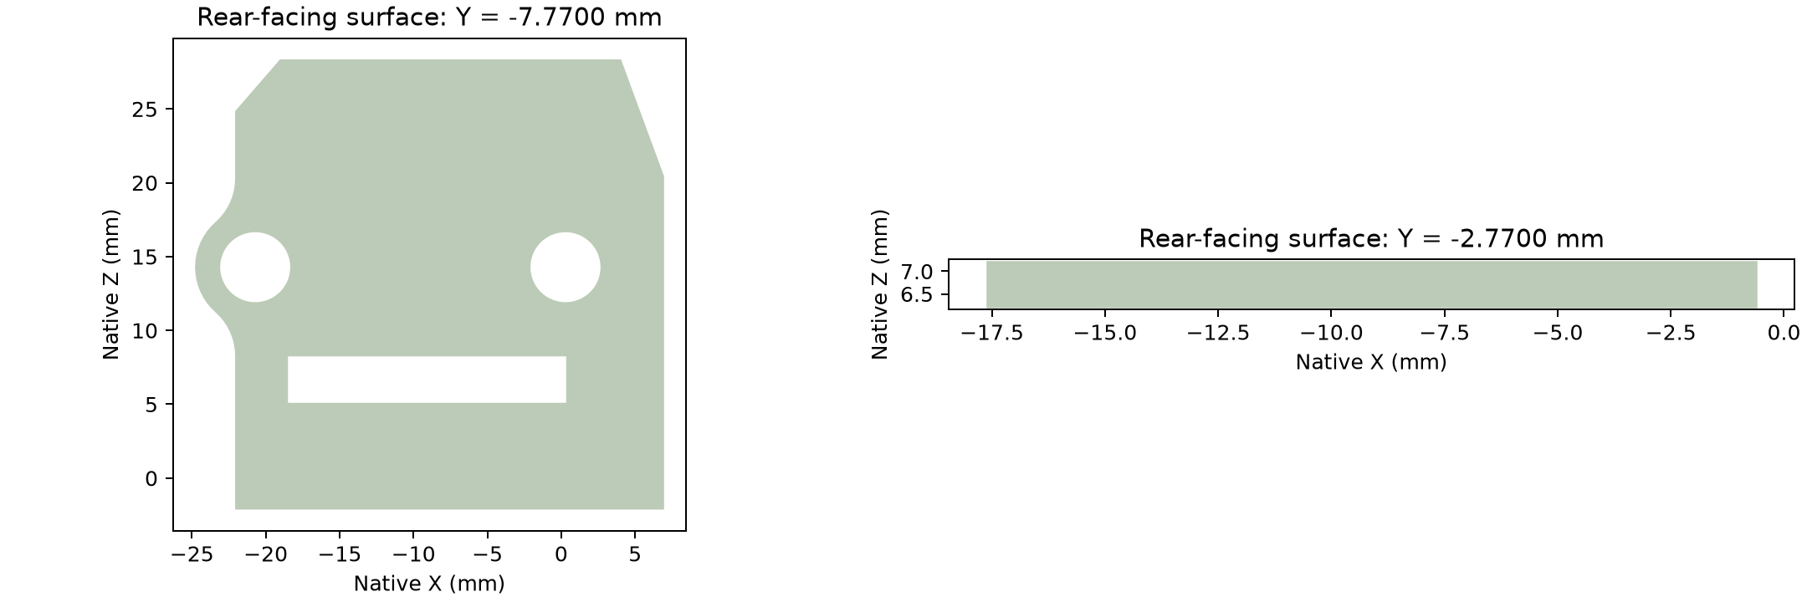
engineering/release/l1/root_interface.png
