geyan21/yam-tactile-kit/engineering/release/l1/stiffness_screen.png

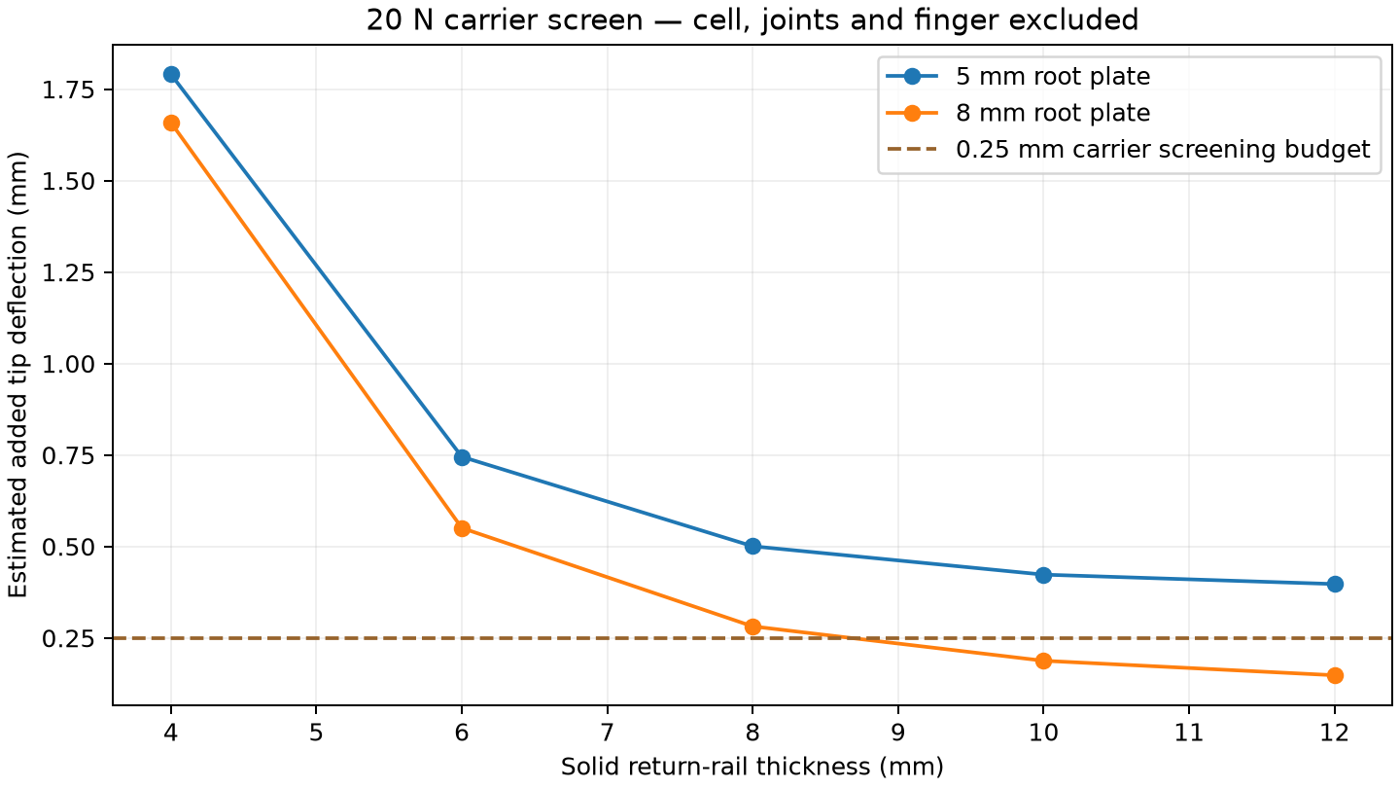
engineering/release/l1/stiffness_screen.png
