geyan21/yam-tactile-kit/engineering/release/r1/r1_pad_sections.png

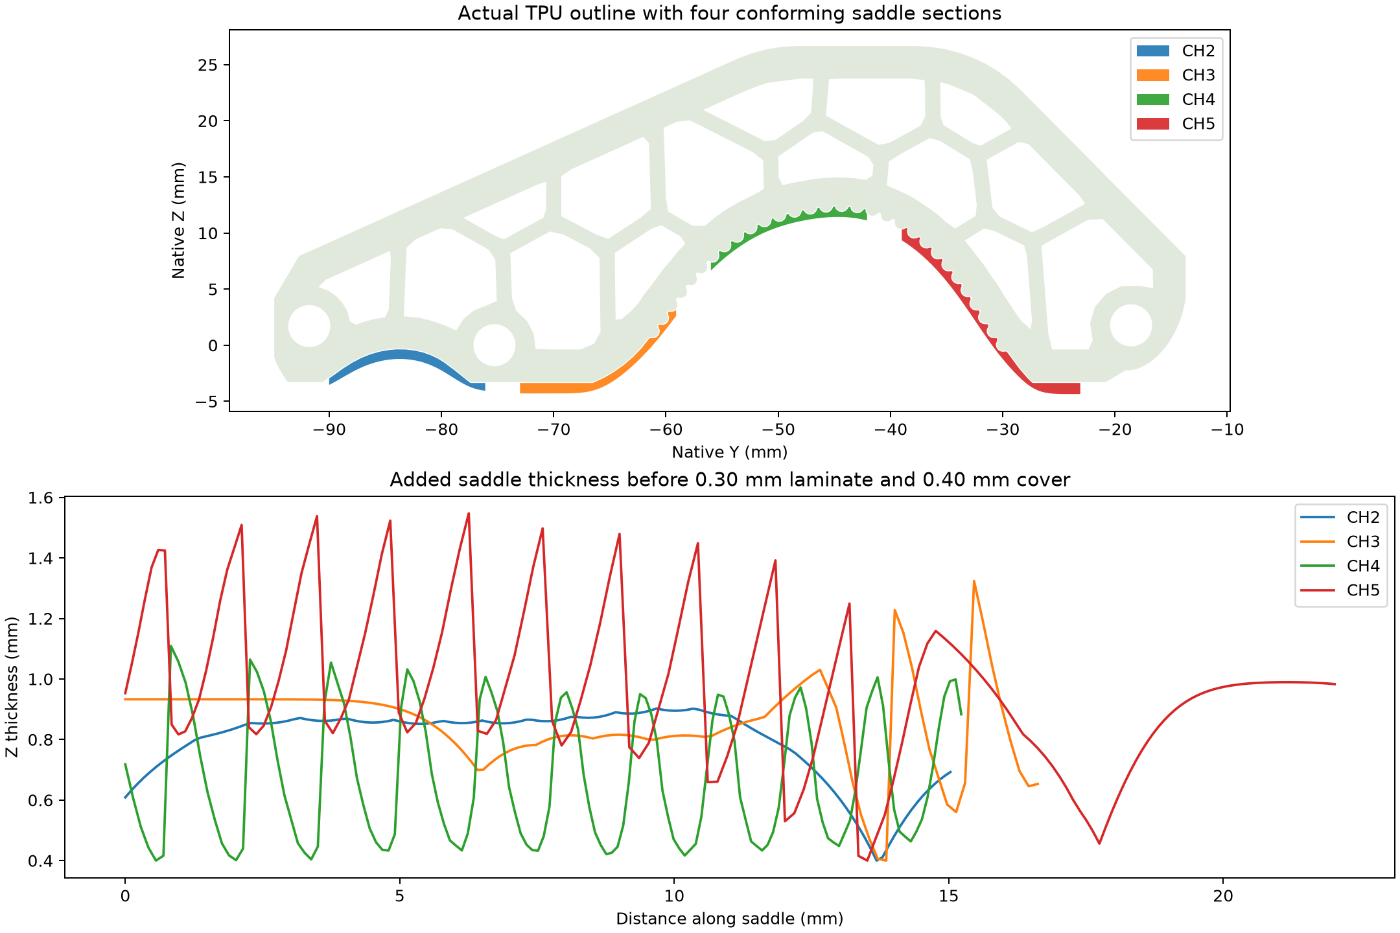
engineering/release/r1/r1_pad_sections.png
