geyan21/yam-tactile-kit/engineering/prototypes/optical/bom.csv

item | quantity_per_finger | selection | placement_or_process
Rigid frame | 1 | o1_retained_gel_frame STL/STEP | Opaque PETG or PA12 prototype; inspect original mount and nail
Bay lid | 1 | o1_camera_bay_lid STL/STEP | Opaque rigid print
Gel clips | 2 | o1_gel_retaining_clip_0 and 1 | Opaque rigid print
LED carrier | 1 | o1_led_carrier STL/STEP | Opaque rigid print; carrier touches camera mounting lands not lens housing
Gel mold halves | 2 | o1_gel_mold_contact_half and rear_half | Reusable smooth sealed tooling; cure compatibility coupon required
Marker stencil | 1 | o1_marker_stencil plus 1:1 pattern | 0.2 mm flexible stencil; 42 holes nominal diameter 0.6 mm
Clear gel | 1 casting | Smooth-On Solaris | 2.5 mm normal thickness; 13 mm main width and 16 mm rear flange
Paint base | as required | Smooth-On Psycho Paint | 1A:1B by mass; solvent-free brushing/stippling
White pigment | as required | Smooth-On Silc Pig White | 3% of combined A+B mass; 0.1 mm dry coating target
Black pigment | as required | Smooth-On Silc Pig Black | 1% of combined A+B mass; dots below white overcoat
Gel seating bond | as required | Smooth-On Sil-Poxy | 0.10 mm nominal bond; actual adhesion and cure must be accepted
Mirror | 1 | Reflective PET sheet 0.20 mm nominal | Cut 14 x 63.892 mm; incoming flatness and reflected image acceptance required
Mirror adhesive | 1 cut piece | 3M 467MP nominal 0.05 mm | Full support on rigid backing; avoid bubbles/wrinkles
Camera | 1 | Raspberry Pi Camera Module 3 Wide visible-light IR-cut | Rotated 180 degrees in the root bay
Camera ribbon | 1 | 15-pin CSI ribbon supplied for Camera Module 3 | Use suitable length and measured slack to Pi 4
Light PCB | 1 | o1_blue_ring two-layer FR4 | 16 x 16 x 0.8 mm; order checked Gerber/drill packet
D1 D2 D3 D4 | 4 | Kingbright APT2012QBC/D | Pin 1 cathode; pin 2 anode; component-side drawing provided
R1 R2 R3 R4 | 4 | 220 ohm 1% 1206 >=0.25 W | One series resistor per LED; verify purchased land dimensions
J1 leads | 2 | 28 AWG insulated wire | Solder to pin 1 +5V and pin 2 GND; strain relief at bay exit
Host | 1 | Raspberry Pi 4 Model B | Local Picamera2 capture; bench mounting and microSD storage
Host supply | 1 | Manufacturer-compatible Pi 4 5.1 V / 3 A USB-C | LED power from Pi physical pin 2; common ground
Nail ADC | 1 | Adafruit ADS1115 breakout #1085 | 3.3 V supply; address 0x48; I2C-1
N0 cells | 2 | Retained R1 N0 copper/pressure-film/polyimide recipe | Use CH0 and CH1 cut patterns only; 0.30 mm laminate target
Nail mounting film | 2 pieces | Non-foam acrylic transfer adhesive | Measure total installed thickness; 0.10 mm bond target
Nail continuity resistors | 2 | 100 kohm 1% 0603 | Across terminals at each nail cell outside loaded area
Nail pulldown resistors | 2 | 10 kohm 1% through-hole or equivalent | One from A0 to GND and one from A1 to GND on insulated bench wiring
Gel clip screws | 8 | M2x6 with head diameter <=3.8 mm and height <=2 mm | Check actual shaft/head dimensions
Camera rear and lid screws | 6 | M2x8 with head diameter <=3.8 mm and height <=2 mm | Two rear camera holes plus four lid holes
Light carrier screws | 2 | M2x14 with head diameter <=3.8 mm and height <=2 mm | Front camera holes; three 0.5 mm washers at each head
Washers | 20 | M2 OD4.5 ID2.2 thickness0.5 mm | Three per light screw and one at each other screw
Nuts | 16 | M2 AF4.0 thickness1.6 mm | Actual pockets must accept the purchased nuts
Mold clamping hardware | 4 sets | M3 bolts or threaded rod plus washers/nuts | Choose measured mold grip length plus full nut engagement; reusable tooling
Bench harness | as required | Insulated wire and small insulated terminal/perfboard | Keep ADC nodes separate; leave local slack and document full installed routing
