geyan21/yam-tactile-kit/engineering/prototypes/pneumatic/parts.csv

id | kind | purpose | material | STEP | STL
p1_ported_insert | fabricate | Flexible insert with four channel pairs, checked port poses and cleaning openings | Formlabs Flexible 80A reference material; process and physical performance require qualification | cad/p1_ported_insert.step | cad/p1_ported_insert.stl
p1_ch2_back_plug_xm | fabricate | Cut stock or closure component; see material and assembly instructions | Formlabs Flexible 80A reference material; process and physical performance require qualification | cad/p1_ch2_back_plug_xm.step | cad/p1_ch2_back_plug_xm.stl
p1_ch2_back_plug_bond_xm | reference_only | Nominal seal/process envelope | Sil-Poxy reference adhesive; qualify the actual resin/metal/plug bonds and leak rate | cad/p1_ch2_back_plug_bond_xm.step | cad/p1_ch2_back_plug_bond_xm.stl
p1_ch2_back_plug_xp | fabricate | Cut stock or closure component; see material and assembly instructions | Formlabs Flexible 80A reference material; process and physical performance require qualification | cad/p1_ch2_back_plug_xp.step | cad/p1_ch2_back_plug_xp.stl
p1_ch2_back_plug_bond_xp | reference_only | Nominal seal/process envelope | Sil-Poxy reference adhesive; qualify the actual resin/metal/plug bonds and leak rate | cad/p1_ch2_back_plug_bond_xp.step | cad/p1_ch2_back_plug_bond_xp.stl
p1_ch2_back_metal_tube | reference_only | Cut stock or closure component; see material and assembly instructions | Deburred 304/316 stainless tube, measured to the stated dimensions | cad/p1_ch2_back_metal_tube.step | cad/p1_ch2_back_metal_tube.stl
p1_ch2_back_socket_bond | reference_only | Nominal seal/process envelope | Sil-Poxy reference adhesive; qualify the actual resin/metal/plug bonds and leak rate | cad/p1_ch2_back_socket_bond.step | cad/p1_ch2_back_socket_bond.stl
p1_ch2_back_local_hose | reference_only | Cut stock or closure component; see material and assembly instructions | PVC tube 1/16 inch ID, 1/8 inch OD; local installed reference | cad/p1_ch2_back_local_hose.step | cad/p1_ch2_back_local_hose.stl
p1_ch2_front_plug_xp | fabricate | Cut stock or closure component; see material and assembly instructions | Formlabs Flexible 80A reference material; process and physical performance require qualification | cad/p1_ch2_front_plug_xp.step | cad/p1_ch2_front_plug_xp.stl
p1_ch2_front_plug_bond_xp | reference_only | Nominal seal/process envelope | Sil-Poxy reference adhesive; qualify the actual resin/metal/plug bonds and leak rate | cad/p1_ch2_front_plug_bond_xp.step | cad/p1_ch2_front_plug_bond_xp.stl
p1_ch2_front_metal_tube | reference_only | Cut stock or closure component; see material and assembly instructions | Deburred 304/316 stainless tube, measured to the stated dimensions | cad/p1_ch2_front_metal_tube.step | cad/p1_ch2_front_metal_tube.stl
p1_ch2_front_socket_bond | reference_only | Nominal seal/process envelope | Sil-Poxy reference adhesive; qualify the actual resin/metal/plug bonds and leak rate | cad/p1_ch2_front_socket_bond.step | cad/p1_ch2_front_socket_bond.stl
p1_ch2_front_local_hose | reference_only | Cut stock or closure component; see material and assembly instructions | PVC tube 1/16 inch ID, 1/8 inch OD; local installed reference | cad/p1_ch2_front_local_hose.step | cad/p1_ch2_front_local_hose.stl
p1_ch3_back_plug_xp | fabricate | Cut stock or closure component; see material and assembly instructions | Formlabs Flexible 80A reference material; process and physical performance require qualification | cad/p1_ch3_back_plug_xp.step | cad/p1_ch3_back_plug_xp.stl
p1_ch3_back_plug_bond_xp | reference_only | Nominal seal/process envelope | Sil-Poxy reference adhesive; qualify the actual resin/metal/plug bonds and leak rate | cad/p1_ch3_back_plug_bond_xp.step | cad/p1_ch3_back_plug_bond_xp.stl
p1_ch3_back_metal_tube | reference_only | Cut stock or closure component; see material and assembly instructions | Deburred 304/316 stainless tube, measured to the stated dimensions | cad/p1_ch3_back_metal_tube.step | cad/p1_ch3_back_metal_tube.stl
p1_ch3_back_socket_bond | reference_only | Nominal seal/process envelope | Sil-Poxy reference adhesive; qualify the actual resin/metal/plug bonds and leak rate | cad/p1_ch3_back_socket_bond.step | cad/p1_ch3_back_socket_bond.stl
p1_ch3_back_local_hose | reference_only | Cut stock or closure component; see material and assembly instructions | PVC tube 1/16 inch ID, 1/8 inch OD; local installed reference | cad/p1_ch3_back_local_hose.step | cad/p1_ch3_back_local_hose.stl
p1_ch3_front_plug_xp | fabricate | Cut stock or closure component; see material and assembly instructions | Formlabs Flexible 80A reference material; process and physical performance require qualification | cad/p1_ch3_front_plug_xp.step | cad/p1_ch3_front_plug_xp.stl
p1_ch3_front_plug_bond_xp | reference_only | Nominal seal/process envelope | Sil-Poxy reference adhesive; qualify the actual resin/metal/plug bonds and leak rate | cad/p1_ch3_front_plug_bond_xp.step | cad/p1_ch3_front_plug_bond_xp.stl
p1_ch3_front_metal_tube | reference_only | Cut stock or closure component; see material and assembly instructions | Deburred 304/316 stainless tube, measured to the stated dimensions | cad/p1_ch3_front_metal_tube.step | cad/p1_ch3_front_metal_tube.stl
p1_ch3_front_socket_bond | reference_only | Nominal seal/process envelope | Sil-Poxy reference adhesive; qualify the actual resin/metal/plug bonds and leak rate | cad/p1_ch3_front_socket_bond.step | cad/p1_ch3_front_socket_bond.stl
p1_ch3_front_local_hose | reference_only | Cut stock or closure component; see material and assembly instructions | PVC tube 1/16 inch ID, 1/8 inch OD; local installed reference | cad/p1_ch3_front_local_hose.step | cad/p1_ch3_front_local_hose.stl
p1_ch4_back_plug_xp | fabricate | Cut stock or closure component; see material and assembly instructions | Formlabs Flexible 80A reference material; process and physical performance require qualification | cad/p1_ch4_back_plug_xp.step | cad/p1_ch4_back_plug_xp.stl
p1_ch4_back_plug_bond_xp | reference_only | Nominal seal/process envelope | Sil-Poxy reference adhesive; qualify the actual resin/metal/plug bonds and leak rate | cad/p1_ch4_back_plug_bond_xp.step | cad/p1_ch4_back_plug_bond_xp.stl
p1_ch4_back_metal_tube | reference_only | Cut stock or closure component; see material and assembly instructions | Deburred 304/316 stainless tube, measured to the stated dimensions | cad/p1_ch4_back_metal_tube.step | cad/p1_ch4_back_metal_tube.stl
p1_ch4_back_socket_bond | reference_only | Nominal seal/process envelope | Sil-Poxy reference adhesive; qualify the actual resin/metal/plug bonds and leak rate | cad/p1_ch4_back_socket_bond.step | cad/p1_ch4_back_socket_bond.stl
p1_ch4_back_local_hose | reference_only | Cut stock or closure component; see material and assembly instructions | PVC tube 1/16 inch ID, 1/8 inch OD; local installed reference | cad/p1_ch4_back_local_hose.step | cad/p1_ch4_back_local_hose.stl
p1_ch4_front_plug_xp | fabricate | Cut stock or closure component; see material and assembly instructions | Formlabs Flexible 80A reference material; process and physical performance require qualification | cad/p1_ch4_front_plug_xp.step | cad/p1_ch4_front_plug_xp.stl
p1_ch4_front_plug_bond_xp | reference_only | Nominal seal/process envelope | Sil-Poxy reference adhesive; qualify the actual resin/metal/plug bonds and leak rate | cad/p1_ch4_front_plug_bond_xp.step | cad/p1_ch4_front_plug_bond_xp.stl
p1_ch4_front_slim_stem | reference_only | Cut stock or closure component; see material and assembly instructions | 304/316 stainless tube, dimensional target | cad/p1_ch4_front_slim_stem.step | cad/p1_ch4_front_slim_stem.stl
p1_ch4_front_embedded_bond | reference_only | Nominal seal/process envelope | Sil-Poxy reference adhesive; qualify the actual resin/metal/plug bonds and leak rate | cad/p1_ch4_front_embedded_bond.step | cad/p1_ch4_front_embedded_bond.stl
p1_ch4_front_hose_sleeve | reference_only | Cut stock or closure component; see material and assembly instructions | 304/316 stainless sleeve, dimensional target | cad/p1_ch4_front_hose_sleeve.step | cad/p1_ch4_front_hose_sleeve.stl
p1_ch4_front_sleeve_bond | reference_only | Nominal seal/process envelope | Sil-Poxy reference adhesive; qualify the actual resin/metal/plug bonds and leak rate | cad/p1_ch4_front_sleeve_bond.step | cad/p1_ch4_front_sleeve_bond.stl
p1_ch4_front_local_hose | reference_only | Cut stock or closure component; see material and assembly instructions | PVC tube 1/16 inch ID, 1/8 inch OD; local installed reference | cad/p1_ch4_front_local_hose.step | cad/p1_ch4_front_local_hose.stl
p1_ch5_back_plug_xm | fabricate | Cut stock or closure component; see material and assembly instructions | Formlabs Flexible 80A reference material; process and physical performance require qualification | cad/p1_ch5_back_plug_xm.step | cad/p1_ch5_back_plug_xm.stl
p1_ch5_back_plug_bond_xm | reference_only | Nominal seal/process envelope | Sil-Poxy reference adhesive; qualify the actual resin/metal/plug bonds and leak rate | cad/p1_ch5_back_plug_bond_xm.step | cad/p1_ch5_back_plug_bond_xm.stl
p1_ch5_back_plug_xp | fabricate | Cut stock or closure component; see material and assembly instructions | Formlabs Flexible 80A reference material; process and physical performance require qualification | cad/p1_ch5_back_plug_xp.step | cad/p1_ch5_back_plug_xp.stl
p1_ch5_back_plug_bond_xp | reference_only | Nominal seal/process envelope | Sil-Poxy reference adhesive; qualify the actual resin/metal/plug bonds and leak rate | cad/p1_ch5_back_plug_bond_xp.step | cad/p1_ch5_back_plug_bond_xp.stl
p1_ch5_back_metal_tube | reference_only | Cut stock or closure component; see material and assembly instructions | Deburred 304/316 stainless tube, measured to the stated dimensions | cad/p1_ch5_back_metal_tube.step | cad/p1_ch5_back_metal_tube.stl
p1_ch5_back_socket_bond | reference_only | Nominal seal/process envelope | Sil-Poxy reference adhesive; qualify the actual resin/metal/plug bonds and leak rate | cad/p1_ch5_back_socket_bond.step | cad/p1_ch5_back_socket_bond.stl
p1_ch5_back_local_hose | reference_only | Cut stock or closure component; see material and assembly instructions | PVC tube 1/16 inch ID, 1/8 inch OD; local installed reference | cad/p1_ch5_back_local_hose.step | cad/p1_ch5_back_local_hose.stl
p1_ch5_front_plug_xp | fabricate | Cut stock or closure component; see material and assembly instructions | Formlabs Flexible 80A reference material; process and physical performance require qualification | cad/p1_ch5_front_plug_xp.step | cad/p1_ch5_front_plug_xp.stl
p1_ch5_front_plug_bond_xp | reference_only | Nominal seal/process envelope | Sil-Poxy reference adhesive; qualify the actual resin/metal/plug bonds and leak rate | cad/p1_ch5_front_plug_bond_xp.step | cad/p1_ch5_front_plug_bond_xp.stl
p1_ch5_front_metal_tube | reference_only | Cut stock or closure component; see material and assembly instructions | Deburred 304/316 stainless tube, measured to the stated dimensions | cad/p1_ch5_front_metal_tube.step | cad/p1_ch5_front_metal_tube.stl
p1_ch5_front_socket_bond | reference_only | Nominal seal/process envelope | Sil-Poxy reference adhesive; qualify the actual resin/metal/plug bonds and leak rate | cad/p1_ch5_front_socket_bond.step | cad/p1_ch5_front_socket_bond.stl
p1_ch5_front_local_hose | reference_only | Cut stock or closure component; see material and assembly instructions | PVC tube 1/16 inch ID, 1/8 inch OD; local installed reference | cad/p1_ch5_front_local_hose.step | cad/p1_ch5_front_local_hose.stl
p1_ch2_back_air_space | reference_only | Intended sealed air volume before hoses; do not fabricate as a solid part | Gas-space reference | cad/p1_ch2_back_air_space.step | cad/p1_ch2_back_air_space.stl
p1_ch2_front_air_space | reference_only | Intended sealed air volume before hoses; do not fabricate as a solid part | Gas-space reference | cad/p1_ch2_front_air_space.step | cad/p1_ch2_front_air_space.stl
p1_ch3_back_air_space | reference_only | Intended sealed air volume before hoses; do not fabricate as a solid part | Gas-space reference | cad/p1_ch3_back_air_space.step | cad/p1_ch3_back_air_space.stl
p1_ch3_front_air_space | reference_only | Intended sealed air volume before hoses; do not fabricate as a solid part | Gas-space reference | cad/p1_ch3_front_air_space.step | cad/p1_ch3_front_air_space.stl
p1_ch4_back_air_space | reference_only | Intended sealed air volume before hoses; do not fabricate as a solid part | Gas-space reference | cad/p1_ch4_back_air_space.step | cad/p1_ch4_back_air_space.stl
p1_ch4_front_air_space | reference_only | Intended sealed air volume before hoses; do not fabricate as a solid part | Gas-space reference | cad/p1_ch4_front_air_space.step | cad/p1_ch4_front_air_space.stl
p1_ch5_back_air_space | reference_only | Intended sealed air volume before hoses; do not fabricate as a solid part | Gas-space reference | cad/p1_ch5_back_air_space.step | cad/p1_ch5_back_air_space.stl
p1_ch5_front_air_space | reference_only | Intended sealed air volume before hoses; do not fabricate as a solid part | Gas-space reference | cad/p1_ch5_front_air_space.step | cad/p1_ch5_front_air_space.stl
p1_bench_carrier | fabricate | Printed 110x92 mm board carrier; 6 mm standoffs, nut pockets, feet and loose hose-tie slots | PETG or equivalent insulating rigid print; verify actual holes and nut fit | cad/p1_bench_carrier.step | cad/p1_bench_carrier.stl
p1_readout_pcb_reference | reference_only | FR4 outline and exact drilled holes from the checked readout; copper/components are separate | 1.6 mm four-layer FR4, nominal 35um copper | cad/p1_readout_pcb_reference.step | cad/p1_readout_pcb_reference.stl
p1_board_washer_0 | reference_only | M2 washer envelope: OD4.5, ID2.2, thickness0.5 mm | Measured M2 washer | cad/p1_board_washer_0.step | cad/p1_board_washer_0.stl
p1_board_screw_0 | reference_only | M2x12 screw, 3.8 mm head envelope; thread form not modeled | M2x12 metal fastener | cad/p1_board_screw_0.step | cad/p1_board_screw_0.stl
p1_board_nut_0 | reference_only | M2 nut envelope: 4 mm across flats, 1.6 mm thick; thread form not modeled | Measured M2 nut | cad/p1_board_nut_0.step | cad/p1_board_nut_0.stl
p1_board_washer_1 | reference_only | M2 washer envelope: OD4.5, ID2.2, thickness0.5 mm | Measured M2 washer | cad/p1_board_washer_1.step | cad/p1_board_washer_1.stl
p1_board_screw_1 | reference_only | M2x12 screw, 3.8 mm head envelope; thread form not modeled | M2x12 metal fastener | cad/p1_board_screw_1.step | cad/p1_board_screw_1.stl
p1_board_nut_1 | reference_only | M2 nut envelope: 4 mm across flats, 1.6 mm thick; thread form not modeled | Measured M2 nut | cad/p1_board_nut_1.step | cad/p1_board_nut_1.stl
p1_board_washer_2 | reference_only | M2 washer envelope: OD4.5, ID2.2, thickness0.5 mm | Measured M2 washer | cad/p1_board_washer_2.step | cad/p1_board_washer_2.stl
p1_board_screw_2 | reference_only | M2x12 screw, 3.8 mm head envelope; thread form not modeled | M2x12 metal fastener | cad/p1_board_screw_2.step | cad/p1_board_screw_2.stl
p1_board_nut_2 | reference_only | M2 nut envelope: 4 mm across flats, 1.6 mm thick; thread form not modeled | Measured M2 nut | cad/p1_board_nut_2.step | cad/p1_board_nut_2.stl
p1_board_washer_3 | reference_only | M2 washer envelope: OD4.5, ID2.2, thickness0.5 mm | Measured M2 washer | cad/p1_board_washer_3.step | cad/p1_board_washer_3.stl
p1_board_screw_3 | reference_only | M2x12 screw, 3.8 mm head envelope; thread form not modeled | M2x12 metal fastener | cad/p1_board_screw_3.step | cad/p1_board_screw_3.stl
p1_board_nut_3 | reference_only | M2 nut envelope: 4 mm across flats, 1.6 mm thick; thread form not modeled | Measured M2 nut | cad/p1_board_nut_3.step | cad/p1_board_nut_3.stl
p1_JP1_body_reference | reference_only | Nominal component body/clearance envelope: 1x20 2.54mm female socket for original Pico | Purchased component reference; inspect actual body, leads and port geometry | cad/p1_JP1_body_reference.step | cad/p1_JP1_body_reference.stl
p1_JP2_body_reference | reference_only | Nominal component body/clearance envelope: 1x20 2.54mm female socket for original Pico | Purchased component reference; inspect actual body, leads and port geometry | cad/p1_JP2_body_reference.step | cad/p1_JP2_body_reference.stl
p1_PS0_body_reference | reference_only | Nominal component body/clearance envelope: ELVR-L30D-F1RD-C-NI3H | Purchased component reference; inspect actual body, leads and port geometry | cad/p1_PS0_body_reference.step | cad/p1_PS0_body_reference.stl
p1_CP0_body_reference | reference_only | Nominal component body/clearance envelope: 100nF 16V X7R 0603 | Purchased component reference; inspect actual body, leads and port geometry | cad/p1_CP0_body_reference.step | cad/p1_CP0_body_reference.stl
p1_RD0_body_reference | reference_only | Nominal component body/clearance envelope: 2.2k 1% 0603 | Purchased component reference; inspect actual body, leads and port geometry | cad/p1_RD0_body_reference.step | cad/p1_RD0_body_reference.stl
p1_RC0_body_reference | reference_only | Nominal component body/clearance envelope: 2.2k 1% 0603 | Purchased component reference; inspect actual body, leads and port geometry | cad/p1_RC0_body_reference.step | cad/p1_RC0_body_reference.stl
p1_PS1_body_reference | reference_only | Nominal component body/clearance envelope: ELVR-L30D-F1RD-C-NI3H | Purchased component reference; inspect actual body, leads and port geometry | cad/p1_PS1_body_reference.step | cad/p1_PS1_body_reference.stl
p1_CP1_body_reference | reference_only | Nominal component body/clearance envelope: 100nF 16V X7R 0603 | Purchased component reference; inspect actual body, leads and port geometry | cad/p1_CP1_body_reference.step | cad/p1_CP1_body_reference.stl
p1_RD1_body_reference | reference_only | Nominal component body/clearance envelope: 2.2k 1% 0603 | Purchased component reference; inspect actual body, leads and port geometry | cad/p1_RD1_body_reference.step | cad/p1_RD1_body_reference.stl
p1_RC1_body_reference | reference_only | Nominal component body/clearance envelope: 2.2k 1% 0603 | Purchased component reference; inspect actual body, leads and port geometry | cad/p1_RC1_body_reference.step | cad/p1_RC1_body_reference.stl
p1_PS2_body_reference | reference_only | Nominal component body/clearance envelope: ELVR-L30D-F1RD-C-NI3H | Purchased component reference; inspect actual body, leads and port geometry | cad/p1_PS2_body_reference.step | cad/p1_PS2_body_reference.stl
p1_CP2_body_reference | reference_only | Nominal component body/clearance envelope: 100nF 16V X7R 0603 | Purchased component reference; inspect actual body, leads and port geometry | cad/p1_CP2_body_reference.step | cad/p1_CP2_body_reference.stl
p1_RD2_body_reference | reference_only | Nominal component body/clearance envelope: 2.2k 1% 0603 | Purchased component reference; inspect actual body, leads and port geometry | cad/p1_RD2_body_reference.step | cad/p1_RD2_body_reference.stl
p1_RC2_body_reference | reference_only | Nominal component body/clearance envelope: 2.2k 1% 0603 | Purchased component reference; inspect actual body, leads and port geometry | cad/p1_RC2_body_reference.step | cad/p1_RC2_body_reference.stl
p1_PS3_body_reference | reference_only | Nominal component body/clearance envelope: ELVR-L30D-F1RD-C-NI3H | Purchased component reference; inspect actual body, leads and port geometry | cad/p1_PS3_body_reference.step | cad/p1_PS3_body_reference.stl
p1_CP3_body_reference | reference_only | Nominal component body/clearance envelope: 100nF 16V X7R 0603 | Purchased component reference; inspect actual body, leads and port geometry | cad/p1_CP3_body_reference.step | cad/p1_CP3_body_reference.stl
p1_RD3_body_reference | reference_only | Nominal component body/clearance envelope: 2.2k 1% 0603 | Purchased component reference; inspect actual body, leads and port geometry | cad/p1_RD3_body_reference.step | cad/p1_RD3_body_reference.stl
p1_RC3_body_reference | reference_only | Nominal component body/clearance envelope: 2.2k 1% 0603 | Purchased component reference; inspect actual body, leads and port geometry | cad/p1_RC3_body_reference.step | cad/p1_RC3_body_reference.stl
p1_U1_body_reference | reference_only | Nominal component body/clearance envelope: TCA9548APWR | Purchased component reference; inspect actual body, leads and port geometry | cad/p1_U1_body_reference.step | cad/p1_U1_body_reference.stl
p1_U2_body_reference | reference_only | Nominal component body/clearance envelope: ADS1115IDGSR | Purchased component reference; inspect actual body, leads and port geometry | cad/p1_U2_body_reference.step | cad/p1_U2_body_reference.stl
p1_U3_body_reference | reference_only | Nominal component body/clearance envelope: LP5907MFX-3.0/NOPB | Purchased component reference; inspect actual body, leads and port geometry | cad/p1_U3_body_reference.step | cad/p1_U3_body_reference.stl
p1_CM1_body_reference | reference_only | Nominal component body/clearance envelope: 100nF 16V X7R 0603 | Purchased component reference; inspect actual body, leads and port geometry | cad/p1_CM1_body_reference.step | cad/p1_CM1_body_reference.stl
p1_CM2_body_reference | reference_only | Nominal component body/clearance envelope: 1uF 16V X7R 0603 | Purchased component reference; inspect actual body, leads and port geometry | cad/p1_CM2_body_reference.step | cad/p1_CM2_body_reference.stl
p1_RM_body_reference | reference_only | Nominal component body/clearance envelope: 10k 1% 0603 | Purchased component reference; inspect actual body, leads and port geometry | cad/p1_RM_body_reference.step | cad/p1_RM_body_reference.stl
p1_RPD_body_reference | reference_only | Nominal component body/clearance envelope: 4.7k 1% 0603 | Purchased component reference; inspect actual body, leads and port geometry | cad/p1_RPD_body_reference.step | cad/p1_RPD_body_reference.stl
p1_RPC_body_reference | reference_only | Nominal component body/clearance envelope: 4.7k 1% 0603 | Purchased component reference; inspect actual body, leads and port geometry | cad/p1_RPC_body_reference.step | cad/p1_RPC_body_reference.stl
p1_RND_body_reference | reference_only | Nominal component body/clearance envelope: 4.7k 1% 0603 | Purchased component reference; inspect actual body, leads and port geometry | cad/p1_RND_body_reference.step | cad/p1_RND_body_reference.stl
p1_RNC_body_reference | reference_only | Nominal component body/clearance envelope: 4.7k 1% 0603 | Purchased component reference; inspect actual body, leads and port geometry | cad/p1_RNC_body_reference.step | cad/p1_RNC_body_reference.stl
p1_CA_body_reference | reference_only | Nominal component body/clearance envelope: 100nF 16V X7R 0603 | Purchased component reference; inspect actual body, leads and port geometry | cad/p1_CA_body_reference.step | cad/p1_CA_body_reference.stl
p1_RN0_body_reference | reference_only | Nominal component body/clearance envelope: 10k 1% 0603 | Purchased component reference; inspect actual body, leads and port geometry | cad/p1_RN0_body_reference.step | cad/p1_RN0_body_reference.stl
p1_RN1_body_reference | reference_only | Nominal component body/clearance envelope: 10k 1% 0603 | Purchased component reference; inspect actual body, leads and port geometry | cad/p1_RN1_body_reference.step | cad/p1_RN1_body_reference.stl
p1_RM0_body_reference | reference_only | Nominal component body/clearance envelope: 1k 1% 0603 | Purchased component reference; inspect actual body, leads and port geometry | cad/p1_RM0_body_reference.step | cad/p1_RM0_body_reference.stl
p1_RM1_body_reference | reference_only | Nominal component body/clearance envelope: 1k 1% 0603 | Purchased component reference; inspect actual body, leads and port geometry | cad/p1_RM1_body_reference.step | cad/p1_RM1_body_reference.stl
p1_CH0_body_reference | reference_only | Nominal component body/clearance envelope: 10nF 50V C0G 0603 | Purchased component reference; inspect actual body, leads and port geometry | cad/p1_CH0_body_reference.step | cad/p1_CH0_body_reference.stl
p1_CH1_body_reference | reference_only | Nominal component body/clearance envelope: 10nF 50V C0G 0603 | Purchased component reference; inspect actual body, leads and port geometry | cad/p1_CH1_body_reference.step | cad/p1_CH1_body_reference.stl
p1_CI_body_reference | reference_only | Nominal component body/clearance envelope: 2.2uF 16V X7R 0603 effective >=1uF at 5V | Purchased component reference; inspect actual body, leads and port geometry | cad/p1_CI_body_reference.step | cad/p1_CI_body_reference.stl
p1_CO_body_reference | reference_only | Nominal component body/clearance envelope: 2.2uF 16V X7R 0603 effective >=1uF at 3V | Purchased component reference; inspect actual body, leads and port geometry | cad/p1_CO_body_reference.step | cad/p1_CO_body_reference.stl
p1_CB_body_reference | reference_only | Nominal component body/clearance envelope: 2.2uF 16V X7R 0603 | Purchased component reference; inspect actual body, leads and port geometry | cad/p1_CB_body_reference.step | cad/p1_CB_body_reference.stl
p1_pico_body_reference | reference_only | Original Pico PCB envelope over the two 8.5 mm socket bodies; USB clearance is open at the top | Original RP2040 Pico; inspect installed header height | cad/p1_pico_body_reference.step | cad/p1_pico_body_reference.stl
p1_ch0_mount | reference_only | Retained R1 two-prong N0 construction; use the 1:1 nail cut sheet and separate continuity resistor | Conformal mounting adhesive envelope, nominal 0.1 mm | cad/p1_ch0_mount.step | cad/p1_ch0_mount.stl
p1_ch0_n0_laminate | reference_only | Retained R1 two-prong N0 construction; use the 1:1 nail cut sheet and separate continuity resistor | Retained R1 N0 insulating/foil/pressure-film laminate envelope | cad/p1_ch0_n0_laminate.step | cad/p1_ch0_n0_laminate.stl
p1_ch1_mount | reference_only | Retained R1 two-prong N0 construction; use the 1:1 nail cut sheet and separate continuity resistor | Conformal mounting adhesive envelope, nominal 0.1 mm | cad/p1_ch1_mount.step | cad/p1_ch1_mount.stl
p1_ch1_n0_laminate | reference_only | Retained R1 two-prong N0 construction; use the 1:1 nail cut sheet and separate continuity resistor | Retained R1 N0 insulating/foil/pressure-film laminate envelope | cad/p1_ch1_n0_laminate.step | cad/p1_ch1_n0_laminate.stl
