geyan21/yam-tactile-kit/engineering/prototypes/f1/parts.csv

id | kind | purpose | material | STEP | STL
f1_ch0_columns_complete_envelope | reference_only | Complete formed FPC material envelope; native copper and mask artwork remain authoritative | PI/Cu/coverlay/finish envelope, not a printable functional sensor | cad/f1_ch0_columns_complete_envelope.step | cad/f1_ch0_columns_complete_envelope.stl
f1_ch0_rows_complete_envelope | reference_only | Complete formed FPC material envelope; native copper and mask artwork remain authoritative | PI/Cu/coverlay/finish envelope, not a printable functional sensor | cad/f1_ch0_rows_complete_envelope.step | cad/f1_ch0_rows_complete_envelope.stl
f1_ch1_columns_complete_envelope | reference_only | Complete formed FPC material envelope; native copper and mask artwork remain authoritative | PI/Cu/coverlay/finish envelope, not a printable functional sensor | cad/f1_ch1_columns_complete_envelope.step | cad/f1_ch1_columns_complete_envelope.stl
f1_ch1_rows_complete_envelope | reference_only | Complete formed FPC material envelope; native copper and mask artwork remain authoritative | PI/Cu/coverlay/finish envelope, not a printable functional sensor | cad/f1_ch1_rows_complete_envelope.step | cad/f1_ch1_rows_complete_envelope.stl
f1_ch2_columns_complete_envelope | reference_only | Complete formed FPC material envelope; native copper and mask artwork remain authoritative | PI/Cu/coverlay/finish envelope, not a printable functional sensor | cad/f1_ch2_columns_complete_envelope.step | cad/f1_ch2_columns_complete_envelope.stl
f1_ch2_rows_complete_envelope | reference_only | Complete formed FPC material envelope; native copper and mask artwork remain authoritative | PI/Cu/coverlay/finish envelope, not a printable functional sensor | cad/f1_ch2_rows_complete_envelope.step | cad/f1_ch2_rows_complete_envelope.stl
f1_ch3_columns_complete_envelope | reference_only | Complete formed FPC material envelope; native copper and mask artwork remain authoritative | PI/Cu/coverlay/finish envelope, not a printable functional sensor | cad/f1_ch3_columns_complete_envelope.step | cad/f1_ch3_columns_complete_envelope.stl
f1_ch3_rows_complete_envelope | reference_only | Complete formed FPC material envelope; native copper and mask artwork remain authoritative | PI/Cu/coverlay/finish envelope, not a printable functional sensor | cad/f1_ch3_rows_complete_envelope.step | cad/f1_ch3_rows_complete_envelope.stl
f1_ch4_columns_complete_envelope | reference_only | Complete formed FPC material envelope; native copper and mask artwork remain authoritative | PI/Cu/coverlay/finish envelope, not a printable functional sensor | cad/f1_ch4_columns_complete_envelope.step | cad/f1_ch4_columns_complete_envelope.stl
f1_ch4_rows_complete_envelope | reference_only | Complete formed FPC material envelope; native copper and mask artwork remain authoritative | PI/Cu/coverlay/finish envelope, not a printable functional sensor | cad/f1_ch4_rows_complete_envelope.step | cad/f1_ch4_rows_complete_envelope.stl
f1_ch5_columns_complete_envelope | reference_only | Complete formed FPC material envelope; native copper and mask artwork remain authoritative | PI/Cu/coverlay/finish envelope, not a printable functional sensor | cad/f1_ch5_columns_complete_envelope.step | cad/f1_ch5_columns_complete_envelope.stl
f1_ch5_rows_complete_envelope | reference_only | Complete formed FPC material envelope; native copper and mask artwork remain authoritative | PI/Cu/coverlay/finish envelope, not a printable functional sensor | cad/f1_ch5_rows_complete_envelope.step | cad/f1_ch5_rows_complete_envelope.stl
f1_ch0_pressure_film | cut_film | Measured conductive-film island; register to the row/column contact map | 0.10 mm pressure-sensitive conductive film | cad/f1_ch0_pressure_film.step | cad/f1_ch0_pressure_film.stl
f1_ch0_retained_cover | cast | Cast wear cover and peripheral skirt with a shared end port for both foil necks | Smooth-On Dragon Skin 10 Slow | cad/f1_ch0_retained_cover.step | cad/f1_ch0_retained_cover.stl
f1_ch0_foil_mount_bond | reference_only | Lower-foil mounting bond; keep adhesive out of the active conductive film | 50 µm insulating adhesive envelope | cad/f1_ch0_foil_mount_bond.step | cad/f1_ch0_foil_mount_bond.stl
f1_ch0_cover_foot_bond_0 | reference_only | Peripheral flexible bond to the nail face or compliant fitting base | Smooth-On Sil-Poxy; qualify the actual cured silicone, printed frame and TPU joints | cad/f1_ch0_cover_foot_bond_0.step | cad/f1_ch0_cover_foot_bond_0.stl
f1_ch0_layer_assembly_form | fabricate_tool | Backing form for registering layers away from the robot | Smooth finished tool with compatible release agent | cad/f1_ch0_layer_assembly_form.step | cad/f1_ch0_layer_assembly_form.stl
f1_ch1_pressure_film | cut_film | Measured conductive-film island; register to the row/column contact map | 0.10 mm pressure-sensitive conductive film | cad/f1_ch1_pressure_film.step | cad/f1_ch1_pressure_film.stl
f1_ch1_retained_cover | cast | Cast wear cover and peripheral skirt with a shared end port for both foil necks | Smooth-On Dragon Skin 10 Slow | cad/f1_ch1_retained_cover.step | cad/f1_ch1_retained_cover.stl
f1_ch1_foil_mount_bond | reference_only | Lower-foil mounting bond; keep adhesive out of the active conductive film | 50 µm insulating adhesive envelope | cad/f1_ch1_foil_mount_bond.step | cad/f1_ch1_foil_mount_bond.stl
f1_ch1_cover_foot_bond_0 | reference_only | Peripheral flexible bond to the nail face or compliant fitting base | Smooth-On Sil-Poxy; qualify the actual cured silicone, printed frame and TPU joints | cad/f1_ch1_cover_foot_bond_0.step | cad/f1_ch1_cover_foot_bond_0.stl
f1_ch1_layer_assembly_form | fabricate_tool | Backing form for registering layers away from the robot | Smooth finished tool with compatible release agent | cad/f1_ch1_layer_assembly_form.step | cad/f1_ch1_layer_assembly_form.stl
f1_ch2_compliant_fit_base | cast | Variable-thickness compliant fitting base from the source TPU to the FPC mount | Smooth-On Dragon Skin 10 Slow | cad/f1_ch2_compliant_fit_base.step | cad/f1_ch2_compliant_fit_base.stl
f1_ch2_pressure_film | cut_film | Measured conductive-film island; register to the row/column contact map | 0.10 mm pressure-sensitive conductive film | cad/f1_ch2_pressure_film.step | cad/f1_ch2_pressure_film.stl
f1_ch2_retained_cover | cast | Cast wear cover and peripheral skirt with a shared end port for both foil necks | Smooth-On Dragon Skin 10 Slow | cad/f1_ch2_retained_cover.step | cad/f1_ch2_retained_cover.stl
f1_ch2_foil_mount_bond | reference_only | Lower-foil mounting bond; keep adhesive out of the active conductive film | 50 µm insulating adhesive envelope | cad/f1_ch2_foil_mount_bond.step | cad/f1_ch2_foil_mount_bond.stl
f1_ch2_cover_foot_bond_0 | reference_only | Peripheral flexible bond to the nail face or compliant fitting base | Smooth-On Sil-Poxy; qualify the actual cured silicone, printed frame and TPU joints | cad/f1_ch2_cover_foot_bond_0.step | cad/f1_ch2_cover_foot_bond_0.stl
f1_ch2_layer_assembly_form | fabricate_tool | Backing form for registering layers away from the robot | Smooth finished tool with compatible release agent | cad/f1_ch2_layer_assembly_form.step | cad/f1_ch2_layer_assembly_form.stl
f1_ch3_compliant_fit_base | cast | Variable-thickness compliant fitting base from the source TPU to the FPC mount | Smooth-On Dragon Skin 10 Slow | cad/f1_ch3_compliant_fit_base.step | cad/f1_ch3_compliant_fit_base.stl
f1_ch3_pressure_film | cut_film | Measured conductive-film island; register to the row/column contact map | 0.10 mm pressure-sensitive conductive film | cad/f1_ch3_pressure_film.step | cad/f1_ch3_pressure_film.stl
f1_ch3_retained_cover | cast | Cast wear cover and peripheral skirt with a shared end port for both foil necks | Smooth-On Dragon Skin 10 Slow | cad/f1_ch3_retained_cover.step | cad/f1_ch3_retained_cover.stl
f1_ch3_foil_mount_bond | reference_only | Lower-foil mounting bond; keep adhesive out of the active conductive film | 50 µm insulating adhesive envelope | cad/f1_ch3_foil_mount_bond.step | cad/f1_ch3_foil_mount_bond.stl
f1_ch3_cover_foot_bond_0 | reference_only | Peripheral flexible bond to the nail face or compliant fitting base | Smooth-On Sil-Poxy; qualify the actual cured silicone, printed frame and TPU joints | cad/f1_ch3_cover_foot_bond_0.step | cad/f1_ch3_cover_foot_bond_0.stl
f1_ch3_layer_assembly_form | fabricate_tool | Backing form for registering layers away from the robot | Smooth finished tool with compatible release agent | cad/f1_ch3_layer_assembly_form.step | cad/f1_ch3_layer_assembly_form.stl
f1_ch4_compliant_fit_base | cast | Variable-thickness compliant fitting base from the source TPU to the FPC mount | Smooth-On Dragon Skin 10 Slow | cad/f1_ch4_compliant_fit_base.step | cad/f1_ch4_compliant_fit_base.stl
f1_ch4_pressure_film | cut_film | Measured conductive-film island; register to the row/column contact map | 0.10 mm pressure-sensitive conductive film | cad/f1_ch4_pressure_film.step | cad/f1_ch4_pressure_film.stl
f1_ch4_retained_cover | cast | Cast wear cover and peripheral skirt with a shared end port for both foil necks | Smooth-On Dragon Skin 10 Slow | cad/f1_ch4_retained_cover.step | cad/f1_ch4_retained_cover.stl
f1_ch4_foil_mount_bond | reference_only | Lower-foil mounting bond; keep adhesive out of the active conductive film | 50 µm insulating adhesive envelope | cad/f1_ch4_foil_mount_bond.step | cad/f1_ch4_foil_mount_bond.stl
f1_ch4_cover_foot_bond_0 | reference_only | Peripheral flexible bond to the nail face or compliant fitting base | Smooth-On Sil-Poxy; qualify the actual cured silicone, printed frame and TPU joints | cad/f1_ch4_cover_foot_bond_0.step | cad/f1_ch4_cover_foot_bond_0.stl
f1_ch4_layer_assembly_form | fabricate_tool | Backing form for registering layers away from the robot | Smooth finished tool with compatible release agent | cad/f1_ch4_layer_assembly_form.step | cad/f1_ch4_layer_assembly_form.stl
f1_ch5_compliant_fit_base | cast | Variable-thickness compliant fitting base from the source TPU to the FPC mount | Smooth-On Dragon Skin 10 Slow | cad/f1_ch5_compliant_fit_base.step | cad/f1_ch5_compliant_fit_base.stl
f1_ch5_pressure_film | cut_film | Measured conductive-film island; register to the row/column contact map | 0.10 mm pressure-sensitive conductive film | cad/f1_ch5_pressure_film.step | cad/f1_ch5_pressure_film.stl
f1_ch5_retained_cover | cast | Cast wear cover and peripheral skirt with a shared end port for both foil necks | Smooth-On Dragon Skin 10 Slow | cad/f1_ch5_retained_cover.step | cad/f1_ch5_retained_cover.stl
f1_ch5_foil_mount_bond | reference_only | Lower-foil mounting bond; keep adhesive out of the active conductive film | 50 µm insulating adhesive envelope | cad/f1_ch5_foil_mount_bond.step | cad/f1_ch5_foil_mount_bond.stl
f1_ch5_cover_foot_bond_0 | reference_only | Peripheral flexible bond to the nail face or compliant fitting base | Smooth-On Sil-Poxy; qualify the actual cured silicone, printed frame and TPU joints | cad/f1_ch5_cover_foot_bond_0.step | cad/f1_ch5_cover_foot_bond_0.stl
f1_ch5_layer_assembly_form | fabricate_tool | Backing form for registering layers away from the robot | Smooth finished tool with compatible release agent | cad/f1_ch5_layer_assembly_form.step | cad/f1_ch5_layer_assembly_form.stl
f1_ch0_columns_full_stiffener_bond | reference_only | Static terminal reinforcement; keep the transition region strain-relieved | 50 µm qualified FPC stiffener bond | cad/f1_ch0_columns_full_stiffener_bond.step | cad/f1_ch0_columns_full_stiffener_bond.stl
f1_ch0_columns_full_stiffener_pi | cut_film | Static terminal reinforcement; keep the transition region strain-relieved | 0.20 mm polyimide reinforcement | cad/f1_ch0_columns_full_stiffener_pi.step | cad/f1_ch0_columns_full_stiffener_pi.stl
f1_ch0_rows_tip_stiffener_bond | reference_only | Static terminal reinforcement; keep the transition region strain-relieved | 50 µm qualified FPC stiffener bond | cad/f1_ch0_rows_tip_stiffener_bond.step | cad/f1_ch0_rows_tip_stiffener_bond.stl
f1_ch0_rows_tip_stiffener_pi | cut_film | Static terminal reinforcement; keep the transition region strain-relieved | 0.20 mm polyimide reinforcement | cad/f1_ch0_rows_tip_stiffener_pi.step | cad/f1_ch0_rows_tip_stiffener_pi.stl
f1_ch0_rows_transition_stiffener_bond | reference_only | Static terminal reinforcement; keep the transition region strain-relieved | 50 µm qualified FPC stiffener bond | cad/f1_ch0_rows_transition_stiffener_bond.step | cad/f1_ch0_rows_transition_stiffener_bond.stl
f1_ch0_rows_transition_stiffener_pi | cut_film | Static terminal reinforcement; keep the transition region strain-relieved | 0.20 mm polyimide reinforcement | cad/f1_ch0_rows_transition_stiffener_pi.step | cad/f1_ch0_rows_transition_stiffener_pi.stl
f1_ch1_columns_full_stiffener_bond | reference_only | Static terminal reinforcement; keep the transition region strain-relieved | 50 µm qualified FPC stiffener bond | cad/f1_ch1_columns_full_stiffener_bond.step | cad/f1_ch1_columns_full_stiffener_bond.stl
f1_ch1_columns_full_stiffener_pi | cut_film | Static terminal reinforcement; keep the transition region strain-relieved | 0.20 mm polyimide reinforcement | cad/f1_ch1_columns_full_stiffener_pi.step | cad/f1_ch1_columns_full_stiffener_pi.stl
f1_ch1_rows_tip_stiffener_bond | reference_only | Static terminal reinforcement; keep the transition region strain-relieved | 50 µm qualified FPC stiffener bond | cad/f1_ch1_rows_tip_stiffener_bond.step | cad/f1_ch1_rows_tip_stiffener_bond.stl
f1_ch1_rows_tip_stiffener_pi | cut_film | Static terminal reinforcement; keep the transition region strain-relieved | 0.20 mm polyimide reinforcement | cad/f1_ch1_rows_tip_stiffener_pi.step | cad/f1_ch1_rows_tip_stiffener_pi.stl
f1_ch1_rows_transition_stiffener_bond | reference_only | Static terminal reinforcement; keep the transition region strain-relieved | 50 µm qualified FPC stiffener bond | cad/f1_ch1_rows_transition_stiffener_bond.step | cad/f1_ch1_rows_transition_stiffener_bond.stl
f1_ch1_rows_transition_stiffener_pi | cut_film | Static terminal reinforcement; keep the transition region strain-relieved | 0.20 mm polyimide reinforcement | cad/f1_ch1_rows_transition_stiffener_pi.step | cad/f1_ch1_rows_transition_stiffener_pi.stl
f1_ch2_columns_full_stiffener_bond | reference_only | Static terminal reinforcement; keep the transition region strain-relieved | 50 µm qualified FPC stiffener bond | cad/f1_ch2_columns_full_stiffener_bond.step | cad/f1_ch2_columns_full_stiffener_bond.stl
f1_ch2_columns_full_stiffener_pi | cut_film | Static terminal reinforcement; keep the transition region strain-relieved | 0.20 mm polyimide reinforcement | cad/f1_ch2_columns_full_stiffener_pi.step | cad/f1_ch2_columns_full_stiffener_pi.stl
f1_ch2_rows_full_stiffener_bond | reference_only | Static terminal reinforcement; keep the transition region strain-relieved | 50 µm qualified FPC stiffener bond | cad/f1_ch2_rows_full_stiffener_bond.step | cad/f1_ch2_rows_full_stiffener_bond.stl
f1_ch2_rows_full_stiffener_pi | cut_film | Static terminal reinforcement; keep the transition region strain-relieved | 0.20 mm polyimide reinforcement | cad/f1_ch2_rows_full_stiffener_pi.step | cad/f1_ch2_rows_full_stiffener_pi.stl
f1_ch3_columns_full_stiffener_bond | reference_only | Static terminal reinforcement; keep the transition region strain-relieved | 50 µm qualified FPC stiffener bond | cad/f1_ch3_columns_full_stiffener_bond.step | cad/f1_ch3_columns_full_stiffener_bond.stl
f1_ch3_columns_full_stiffener_pi | cut_film | Static terminal reinforcement; keep the transition region strain-relieved | 0.20 mm polyimide reinforcement | cad/f1_ch3_columns_full_stiffener_pi.step | cad/f1_ch3_columns_full_stiffener_pi.stl
f1_ch3_rows_full_stiffener_bond | reference_only | Static terminal reinforcement; keep the transition region strain-relieved | 50 µm qualified FPC stiffener bond | cad/f1_ch3_rows_full_stiffener_bond.step | cad/f1_ch3_rows_full_stiffener_bond.stl
f1_ch3_rows_full_stiffener_pi | cut_film | Static terminal reinforcement; keep the transition region strain-relieved | 0.20 mm polyimide reinforcement | cad/f1_ch3_rows_full_stiffener_pi.step | cad/f1_ch3_rows_full_stiffener_pi.stl
f1_ch4_columns_full_stiffener_bond | reference_only | Static terminal reinforcement; keep the transition region strain-relieved | 50 µm qualified FPC stiffener bond | cad/f1_ch4_columns_full_stiffener_bond.step | cad/f1_ch4_columns_full_stiffener_bond.stl
f1_ch4_columns_full_stiffener_pi | cut_film | Static terminal reinforcement; keep the transition region strain-relieved | 0.20 mm polyimide reinforcement | cad/f1_ch4_columns_full_stiffener_pi.step | cad/f1_ch4_columns_full_stiffener_pi.stl
f1_ch4_rows_full_stiffener_bond | reference_only | Static terminal reinforcement; keep the transition region strain-relieved | 50 µm qualified FPC stiffener bond | cad/f1_ch4_rows_full_stiffener_bond.step | cad/f1_ch4_rows_full_stiffener_bond.stl
f1_ch4_rows_full_stiffener_pi | cut_film | Static terminal reinforcement; keep the transition region strain-relieved | 0.20 mm polyimide reinforcement | cad/f1_ch4_rows_full_stiffener_pi.step | cad/f1_ch4_rows_full_stiffener_pi.stl
f1_ch5_columns_full_stiffener_bond | reference_only | Static terminal reinforcement; keep the transition region strain-relieved | 50 µm qualified FPC stiffener bond | cad/f1_ch5_columns_full_stiffener_bond.step | cad/f1_ch5_columns_full_stiffener_bond.stl
f1_ch5_columns_full_stiffener_pi | cut_film | Static terminal reinforcement; keep the transition region strain-relieved | 0.20 mm polyimide reinforcement | cad/f1_ch5_columns_full_stiffener_pi.step | cad/f1_ch5_columns_full_stiffener_pi.stl
f1_ch5_rows_full_stiffener_bond | reference_only | Static terminal reinforcement; keep the transition region strain-relieved | 50 µm qualified FPC stiffener bond | cad/f1_ch5_rows_full_stiffener_bond.step | cad/f1_ch5_rows_full_stiffener_bond.stl
f1_ch5_rows_full_stiffener_pi | cut_film | Static terminal reinforcement; keep the transition region strain-relieved | 0.20 mm polyimide reinforcement | cad/f1_ch5_rows_full_stiffener_pi.step | cad/f1_ch5_rows_full_stiffener_pi.stl
f1_r3_carrier | fabricate | f1 r3 carrier | PETG or machined insulating plastic for a bench prototype; shrinkage, strength and creep unqualified | cad/f1_r3_carrier.step | cad/f1_r3_carrier.stl
f1_r3_pcb_fit_reference | reference_only | f1 r3 pcb fit reference | 1 mm FR4 reference; use independently checked PCB artwork for electronics | cad/f1_r3_pcb_fit_reference.step | cad/f1_r3_pcb_fit_reference.stl
f1_ch2_compliant_fit_base_mold_a | fabricate_tool | Registered split mold with two side overflow paths | Machined smooth tooling or validated precision-printed/sealed tooling with a compatible release agent | cad/f1_ch2_compliant_fit_base_mold_a.step | cad/f1_ch2_compliant_fit_base_mold_a.stl
f1_ch2_compliant_fit_base_mold_b | fabricate_tool | Registered split mold with two side overflow paths | Machined smooth tooling or validated precision-printed/sealed tooling with a compatible release agent | cad/f1_ch2_compliant_fit_base_mold_b.step | cad/f1_ch2_compliant_fit_base_mold_b.stl
f1_ch2_retained_cover_mold_a | fabricate_tool | Registered split mold with two side overflow paths | Machined smooth tooling or validated precision-printed/sealed tooling with a compatible release agent | cad/f1_ch2_retained_cover_mold_a.step | cad/f1_ch2_retained_cover_mold_a.stl
f1_ch2_retained_cover_mold_b | fabricate_tool | Registered split mold with two side overflow paths | Machined smooth tooling or validated precision-printed/sealed tooling with a compatible release agent | cad/f1_ch2_retained_cover_mold_b.step | cad/f1_ch2_retained_cover_mold_b.stl
f1_ch0_retained_cover_mold_a | fabricate_tool | Registered split mold with two side overflow paths | Machined smooth tooling or validated precision-printed/sealed tooling with a compatible release agent | cad/f1_ch0_retained_cover_mold_a.step | cad/f1_ch0_retained_cover_mold_a.stl
f1_ch0_retained_cover_mold_b | fabricate_tool | Registered split mold with two side overflow paths | Machined smooth tooling or validated precision-printed/sealed tooling with a compatible release agent | cad/f1_ch0_retained_cover_mold_b.step | cad/f1_ch0_retained_cover_mold_b.stl
f1_ch1_retained_cover_mold_a | fabricate_tool | Registered split mold with two side overflow paths | Machined smooth tooling or validated precision-printed/sealed tooling with a compatible release agent | cad/f1_ch1_retained_cover_mold_a.step | cad/f1_ch1_retained_cover_mold_a.stl
f1_ch1_retained_cover_mold_b | fabricate_tool | Registered split mold with two side overflow paths | Machined smooth tooling or validated precision-printed/sealed tooling with a compatible release agent | cad/f1_ch1_retained_cover_mold_b.step | cad/f1_ch1_retained_cover_mold_b.stl
f1_ch3_compliant_fit_base_mold_a | fabricate_tool | Registered split mold with two side overflow paths | Machined smooth tooling or validated precision-printed/sealed tooling with a compatible release agent | cad/f1_ch3_compliant_fit_base_mold_a.step | cad/f1_ch3_compliant_fit_base_mold_a.stl
f1_ch3_compliant_fit_base_mold_b | fabricate_tool | Registered split mold with two side overflow paths | Machined smooth tooling or validated precision-printed/sealed tooling with a compatible release agent | cad/f1_ch3_compliant_fit_base_mold_b.step | cad/f1_ch3_compliant_fit_base_mold_b.stl
f1_ch3_retained_cover_mold_a | fabricate_tool | Registered split mold with two side overflow paths | Machined smooth tooling or validated precision-printed/sealed tooling with a compatible release agent | cad/f1_ch3_retained_cover_mold_a.step | cad/f1_ch3_retained_cover_mold_a.stl
f1_ch3_retained_cover_mold_b | fabricate_tool | Registered split mold with two side overflow paths | Machined smooth tooling or validated precision-printed/sealed tooling with a compatible release agent | cad/f1_ch3_retained_cover_mold_b.step | cad/f1_ch3_retained_cover_mold_b.stl
f1_ch4_compliant_fit_base_mold_a | fabricate_tool | Registered split mold with two side overflow paths | Machined smooth tooling or validated precision-printed/sealed tooling with a compatible release agent | cad/f1_ch4_compliant_fit_base_mold_a.step | cad/f1_ch4_compliant_fit_base_mold_a.stl
f1_ch4_compliant_fit_base_mold_b | fabricate_tool | Registered split mold with two side overflow paths | Machined smooth tooling or validated precision-printed/sealed tooling with a compatible release agent | cad/f1_ch4_compliant_fit_base_mold_b.step | cad/f1_ch4_compliant_fit_base_mold_b.stl
f1_ch4_retained_cover_mold_a | fabricate_tool | Registered split mold with two side overflow paths | Machined smooth tooling or validated precision-printed/sealed tooling with a compatible release agent | cad/f1_ch4_retained_cover_mold_a.step | cad/f1_ch4_retained_cover_mold_a.stl
f1_ch4_retained_cover_mold_b | fabricate_tool | Registered split mold with two side overflow paths | Machined smooth tooling or validated precision-printed/sealed tooling with a compatible release agent | cad/f1_ch4_retained_cover_mold_b.step | cad/f1_ch4_retained_cover_mold_b.stl
f1_ch5_compliant_fit_base_mold_a | fabricate_tool | Registered split mold with two side overflow paths | Machined smooth tooling or validated precision-printed/sealed tooling with a compatible release agent | cad/f1_ch5_compliant_fit_base_mold_a.step | cad/f1_ch5_compliant_fit_base_mold_a.stl
f1_ch5_compliant_fit_base_mold_b | fabricate_tool | Registered split mold with two side overflow paths | Machined smooth tooling or validated precision-printed/sealed tooling with a compatible release agent | cad/f1_ch5_compliant_fit_base_mold_b.step | cad/f1_ch5_compliant_fit_base_mold_b.stl
f1_ch5_retained_cover_mold_a | fabricate_tool | Registered split mold with two side overflow paths | Machined smooth tooling or validated precision-printed/sealed tooling with a compatible release agent | cad/f1_ch5_retained_cover_mold_a.step | cad/f1_ch5_retained_cover_mold_a.stl
f1_ch5_retained_cover_mold_b | fabricate_tool | Registered split mold with two side overflow paths | Machined smooth tooling or validated precision-printed/sealed tooling with a compatible release agent | cad/f1_ch5_retained_cover_mold_b.step | cad/f1_ch5_retained_cover_mold_b.stl
