geyan21/yam-tactile-kit/engineering/development/capacitive/k1/parts.csv

id | kind | purpose | material | STEP | STL
k1_ch0_post_sheet_flat | cast | CH0 flat molded silicone master; form before installed use | SYLGARD 184, 10:1; process and compression unqualified | cad/k1_ch0_post_sheet_flat.step | cad/k1_ch0_post_sheet_flat.stl
k1_ch0_post_stencil | fabricate_tool | CH0 through-hole stencil for the separate silicone post sheet | 0.15 mm laser-cut stainless shim; use flat release plates | cad/k1_ch0_post_stencil.step | cad/k1_ch0_post_stencil.stl
k1_ch0_backing_spacer | fabricate_tool | CH0 spacer defining the thin silicone base above the post stencil | 0.05 mm metal/polyimide shim; verify thickness and cure compatibility | cad/k1_ch0_backing_spacer.step | cad/k1_ch0_backing_spacer.stl
k1_ch0_flex_reference | reference_only | CH0 flex reference on the source contact surface | Requested two-layer flexible electrode/guard stack; copper artwork is separate | cad/k1_ch0_flex_reference.step | cad/k1_ch0_flex_reference.stl
k1_ch0_ground_spreader | form_sheet | CH0 ground spreader on the source contact surface | Formed annealed 304 stainless sheet; ground via two separate bonded tabs | cad/k1_ch0_ground_spreader.step | cad/k1_ch0_ground_spreader.stl
k1_ch0_cover_reference | reference_only | CH0 cover reference on the source contact surface | Silicone cover envelope; retention and vent details remain | cad/k1_ch0_cover_reference.step | cad/k1_ch0_cover_reference.stl
k1_ch0_spreader_form | fabricate_tool | CH0 separate matched form for the metal spreader; springback is not compensated | Rigid forming tool; verify formed curvature before assembly | cad/k1_ch0_spreader_form.step | cad/k1_ch0_spreader_form.stl
k1_ch1_post_sheet_flat | cast | CH1 flat molded silicone master; form before installed use | SYLGARD 184, 10:1; process and compression unqualified | cad/k1_ch1_post_sheet_flat.step | cad/k1_ch1_post_sheet_flat.stl
k1_ch1_post_stencil | fabricate_tool | CH1 through-hole stencil for the separate silicone post sheet | 0.15 mm laser-cut stainless shim; use flat release plates | cad/k1_ch1_post_stencil.step | cad/k1_ch1_post_stencil.stl
k1_ch1_backing_spacer | fabricate_tool | CH1 spacer defining the thin silicone base above the post stencil | 0.05 mm metal/polyimide shim; verify thickness and cure compatibility | cad/k1_ch1_backing_spacer.step | cad/k1_ch1_backing_spacer.stl
k1_ch1_flex_reference | reference_only | CH1 flex reference on the source contact surface | Requested two-layer flexible electrode/guard stack; copper artwork is separate | cad/k1_ch1_flex_reference.step | cad/k1_ch1_flex_reference.stl
k1_ch1_ground_spreader | form_sheet | CH1 ground spreader on the source contact surface | Formed annealed 304 stainless sheet; ground via two separate bonded tabs | cad/k1_ch1_ground_spreader.step | cad/k1_ch1_ground_spreader.stl
k1_ch1_cover_reference | reference_only | CH1 cover reference on the source contact surface | Silicone cover envelope; retention and vent details remain | cad/k1_ch1_cover_reference.step | cad/k1_ch1_cover_reference.stl
k1_ch1_spreader_form | fabricate_tool | CH1 separate matched form for the metal spreader; springback is not compensated | Rigid forming tool; verify formed curvature before assembly | cad/k1_ch1_spreader_form.step | cad/k1_ch1_spreader_form.stl
k1_ch2_post_sheet_flat | cast | CH2 flat molded silicone master; form before installed use | SYLGARD 184, 10:1; process and compression unqualified | cad/k1_ch2_post_sheet_flat.step | cad/k1_ch2_post_sheet_flat.stl
k1_ch2_post_stencil | fabricate_tool | CH2 through-hole stencil for the separate silicone post sheet | 0.15 mm laser-cut stainless shim; use flat release plates | cad/k1_ch2_post_stencil.step | cad/k1_ch2_post_stencil.stl
k1_ch2_backing_spacer | fabricate_tool | CH2 spacer defining the thin silicone base above the post stencil | 0.05 mm metal/polyimide shim; verify thickness and cure compatibility | cad/k1_ch2_backing_spacer.step | cad/k1_ch2_backing_spacer.stl
k1_ch2_flex_reference | reference_only | CH2 flex reference on the source contact surface | Requested two-layer flexible electrode/guard stack; copper artwork is separate | cad/k1_ch2_flex_reference.step | cad/k1_ch2_flex_reference.stl
k1_ch2_ground_spreader | form_sheet | CH2 ground spreader on the source contact surface | Formed annealed 304 stainless sheet; ground via two separate bonded tabs | cad/k1_ch2_ground_spreader.step | cad/k1_ch2_ground_spreader.stl
k1_ch2_cover_reference | reference_only | CH2 cover reference on the source contact surface | Silicone cover envelope; retention and vent details remain | cad/k1_ch2_cover_reference.step | cad/k1_ch2_cover_reference.stl
k1_ch2_spreader_form | fabricate_tool | CH2 separate matched form for the metal spreader; springback is not compensated | Rigid forming tool; verify formed curvature before assembly | cad/k1_ch2_spreader_form.step | cad/k1_ch2_spreader_form.stl
k1_ch3_post_sheet_flat | cast | CH3 flat molded silicone master; form before installed use | SYLGARD 184, 10:1; process and compression unqualified | cad/k1_ch3_post_sheet_flat.step | cad/k1_ch3_post_sheet_flat.stl
k1_ch3_post_stencil | fabricate_tool | CH3 through-hole stencil for the separate silicone post sheet | 0.15 mm laser-cut stainless shim; use flat release plates | cad/k1_ch3_post_stencil.step | cad/k1_ch3_post_stencil.stl
k1_ch3_backing_spacer | fabricate_tool | CH3 spacer defining the thin silicone base above the post stencil | 0.05 mm metal/polyimide shim; verify thickness and cure compatibility | cad/k1_ch3_backing_spacer.step | cad/k1_ch3_backing_spacer.stl
k1_ch3_flex_reference | reference_only | CH3 flex reference on the source contact surface | Requested two-layer flexible electrode/guard stack; copper artwork is separate | cad/k1_ch3_flex_reference.step | cad/k1_ch3_flex_reference.stl
k1_ch3_ground_spreader | form_sheet | CH3 ground spreader on the source contact surface | Formed annealed 304 stainless sheet; ground via two separate bonded tabs | cad/k1_ch3_ground_spreader.step | cad/k1_ch3_ground_spreader.stl
k1_ch3_cover_reference | reference_only | CH3 cover reference on the source contact surface | Silicone cover envelope; retention and vent details remain | cad/k1_ch3_cover_reference.step | cad/k1_ch3_cover_reference.stl
k1_ch3_spreader_form | fabricate_tool | CH3 separate matched form for the metal spreader; springback is not compensated | Rigid forming tool; verify formed curvature before assembly | cad/k1_ch3_spreader_form.step | cad/k1_ch3_spreader_form.stl
k1_ch4_post_sheet_flat | cast | CH4 flat molded silicone master; form before installed use | SYLGARD 184, 10:1; process and compression unqualified | cad/k1_ch4_post_sheet_flat.step | cad/k1_ch4_post_sheet_flat.stl
k1_ch4_post_stencil | fabricate_tool | CH4 through-hole stencil for the separate silicone post sheet | 0.15 mm laser-cut stainless shim; use flat release plates | cad/k1_ch4_post_stencil.step | cad/k1_ch4_post_stencil.stl
k1_ch4_backing_spacer | fabricate_tool | CH4 spacer defining the thin silicone base above the post stencil | 0.05 mm metal/polyimide shim; verify thickness and cure compatibility | cad/k1_ch4_backing_spacer.step | cad/k1_ch4_backing_spacer.stl
k1_ch4_flex_reference | reference_only | CH4 flex reference on the source contact surface | Requested two-layer flexible electrode/guard stack; copper artwork is separate | cad/k1_ch4_flex_reference.step | cad/k1_ch4_flex_reference.stl
k1_ch4_ground_spreader | form_sheet | CH4 ground spreader on the source contact surface | Formed annealed 304 stainless sheet; ground via two separate bonded tabs | cad/k1_ch4_ground_spreader.step | cad/k1_ch4_ground_spreader.stl
k1_ch4_cover_reference | reference_only | CH4 cover reference on the source contact surface | Silicone cover envelope; retention and vent details remain | cad/k1_ch4_cover_reference.step | cad/k1_ch4_cover_reference.stl
k1_ch4_spreader_form | fabricate_tool | CH4 separate matched form for the metal spreader; springback is not compensated | Rigid forming tool; verify formed curvature before assembly | cad/k1_ch4_spreader_form.step | cad/k1_ch4_spreader_form.stl
k1_ch5_post_sheet_flat | cast | CH5 flat molded silicone master; form before installed use | SYLGARD 184, 10:1; process and compression unqualified | cad/k1_ch5_post_sheet_flat.step | cad/k1_ch5_post_sheet_flat.stl
k1_ch5_post_stencil | fabricate_tool | CH5 through-hole stencil for the separate silicone post sheet | 0.15 mm laser-cut stainless shim; use flat release plates | cad/k1_ch5_post_stencil.step | cad/k1_ch5_post_stencil.stl
k1_ch5_backing_spacer | fabricate_tool | CH5 spacer defining the thin silicone base above the post stencil | 0.05 mm metal/polyimide shim; verify thickness and cure compatibility | cad/k1_ch5_backing_spacer.step | cad/k1_ch5_backing_spacer.stl
k1_ch5_flex_reference | reference_only | CH5 flex reference on the source contact surface | Requested two-layer flexible electrode/guard stack; copper artwork is separate | cad/k1_ch5_flex_reference.step | cad/k1_ch5_flex_reference.stl
k1_ch5_ground_spreader | form_sheet | CH5 ground spreader on the source contact surface | Formed annealed 304 stainless sheet; ground via two separate bonded tabs | cad/k1_ch5_ground_spreader.step | cad/k1_ch5_ground_spreader.stl
k1_ch5_cover_reference | reference_only | CH5 cover reference on the source contact surface | Silicone cover envelope; retention and vent details remain | cad/k1_ch5_cover_reference.step | cad/k1_ch5_cover_reference.stl
k1_ch5_spreader_form | fabricate_tool | CH5 separate matched form for the metal spreader; springback is not compensated | Rigid forming tool; verify formed curvature before assembly | cad/k1_ch5_spreader_form.step | cad/k1_ch5_spreader_form.stl
k1_ref_post_sheet_flat | cast | REF flat molded silicone master; form before installed use | SYLGARD 184, 10:1; process and compression unqualified | cad/k1_ref_post_sheet_flat.step | cad/k1_ref_post_sheet_flat.stl
k1_ref_post_stencil | fabricate_tool | REF through-hole stencil for the separate silicone post sheet | 0.15 mm laser-cut stainless shim; use flat release plates | cad/k1_ref_post_stencil.step | cad/k1_ref_post_stencil.stl
k1_ref_backing_spacer | fabricate_tool | REF spacer defining the thin silicone base above the post stencil | 0.05 mm metal/polyimide shim; verify thickness and cure compatibility | cad/k1_ref_backing_spacer.step | cad/k1_ref_backing_spacer.stl
k1_ch2_conforming_saddle | fabricate | CH2 complete rigid support from the retained TPU-fit back surface to the flex bond | PETG prototype; actual fit, bond, stiffness and durability remain untested | cad/k1_ch2_conforming_saddle.step | cad/k1_ch2_conforming_saddle.stl
k1_ch3_conforming_saddle | fabricate | CH3 complete rigid support from the retained TPU-fit back surface to the flex bond | PETG prototype; actual fit, bond, stiffness and durability remain untested | cad/k1_ch3_conforming_saddle.step | cad/k1_ch3_conforming_saddle.stl
k1_ch4_conforming_saddle | fabricate | CH4 complete rigid support from the retained TPU-fit back surface to the flex bond | PETG prototype; actual fit, bond, stiffness and durability remain untested | cad/k1_ch4_conforming_saddle.step | cad/k1_ch4_conforming_saddle.stl
k1_ch5_conforming_saddle | fabricate | CH5 complete rigid support from the retained TPU-fit back surface to the flex bond | PETG prototype; actual fit, bond, stiffness and durability remain untested | cad/k1_ch5_conforming_saddle.step | cad/k1_ch5_conforming_saddle.stl
