geyan21/yam-tactile-kit/engineering/development/f1/r3/parts.csv

id | kind | purpose | material | STEP | STL
f1_ch0_columns_body | reference_only | CH0 columns reference body on the actual source surface; tail not yet attached | PI/Cu flex envelope; active coverlay opening | cad/f1_ch0_columns_body.step | cad/f1_ch0_columns_body.stl
f1_ch0_film_body | reference_only | CH0 film reference body on the actual source surface; tail not yet attached | 0.10 mm conductive pressure film | cad/f1_ch0_film_body.step | cad/f1_ch0_film_body.stl
f1_ch0_rows_body | reference_only | CH0 rows reference body on the actual source surface; tail not yet attached | PI/Cu flex envelope; active coverlay opening | cad/f1_ch0_rows_body.step | cad/f1_ch0_rows_body.stl
f1_ch0_cover_body | reference_only | CH0 cover reference body on the actual source surface; tail not yet attached | Silicone cover process target | cad/f1_ch0_cover_body.step | cad/f1_ch0_cover_body.stl
f1_ch0_forming_mandrel | fabricate_tool | CH0 rigid backing form for separate-layer assembly away from the robot | PETG/engineering plastic tool; smooth the contact surface and use a release film | cad/f1_ch0_forming_mandrel.step | cad/f1_ch0_forming_mandrel.stl
f1_ch1_columns_body | reference_only | CH1 columns reference body on the actual source surface; tail not yet attached | PI/Cu flex envelope; active coverlay opening | cad/f1_ch1_columns_body.step | cad/f1_ch1_columns_body.stl
f1_ch1_film_body | reference_only | CH1 film reference body on the actual source surface; tail not yet attached | 0.10 mm conductive pressure film | cad/f1_ch1_film_body.step | cad/f1_ch1_film_body.stl
f1_ch1_rows_body | reference_only | CH1 rows reference body on the actual source surface; tail not yet attached | PI/Cu flex envelope; active coverlay opening | cad/f1_ch1_rows_body.step | cad/f1_ch1_rows_body.stl
f1_ch1_cover_body | reference_only | CH1 cover reference body on the actual source surface; tail not yet attached | Silicone cover process target | cad/f1_ch1_cover_body.step | cad/f1_ch1_cover_body.stl
f1_ch1_forming_mandrel | fabricate_tool | CH1 rigid backing form for separate-layer assembly away from the robot | PETG/engineering plastic tool; smooth the contact surface and use a release film | cad/f1_ch1_forming_mandrel.step | cad/f1_ch1_forming_mandrel.stl
f1_ch2_columns_body | reference_only | CH2 columns reference body on the actual source surface; tail not yet attached | PI/Cu flex envelope; active coverlay opening | cad/f1_ch2_columns_body.step | cad/f1_ch2_columns_body.stl
f1_ch2_film_body | reference_only | CH2 film reference body on the actual source surface; tail not yet attached | 0.10 mm conductive pressure film | cad/f1_ch2_film_body.step | cad/f1_ch2_film_body.stl
f1_ch2_rows_body | reference_only | CH2 rows reference body on the actual source surface; tail not yet attached | PI/Cu flex envelope; active coverlay opening | cad/f1_ch2_rows_body.step | cad/f1_ch2_rows_body.stl
f1_ch2_cover_body | reference_only | CH2 cover reference body on the actual source surface; tail not yet attached | Silicone cover process target | cad/f1_ch2_cover_body.step | cad/f1_ch2_cover_body.stl
f1_ch2_forming_mandrel | fabricate_tool | CH2 rigid backing form for separate-layer assembly away from the robot | PETG/engineering plastic tool; smooth the contact surface and use a release film | cad/f1_ch2_forming_mandrel.step | cad/f1_ch2_forming_mandrel.stl
f1_ch3_columns_body | reference_only | CH3 columns reference body on the actual source surface; tail not yet attached | PI/Cu flex envelope; active coverlay opening | cad/f1_ch3_columns_body.step | cad/f1_ch3_columns_body.stl
f1_ch3_film_body | reference_only | CH3 film reference body on the actual source surface; tail not yet attached | 0.10 mm conductive pressure film | cad/f1_ch3_film_body.step | cad/f1_ch3_film_body.stl
f1_ch3_rows_body | reference_only | CH3 rows reference body on the actual source surface; tail not yet attached | PI/Cu flex envelope; active coverlay opening | cad/f1_ch3_rows_body.step | cad/f1_ch3_rows_body.stl
f1_ch3_cover_body | reference_only | CH3 cover reference body on the actual source surface; tail not yet attached | Silicone cover process target | cad/f1_ch3_cover_body.step | cad/f1_ch3_cover_body.stl
f1_ch3_forming_mandrel | fabricate_tool | CH3 rigid backing form for separate-layer assembly away from the robot | PETG/engineering plastic tool; smooth the contact surface and use a release film | cad/f1_ch3_forming_mandrel.step | cad/f1_ch3_forming_mandrel.stl
f1_ch4_columns_body | reference_only | CH4 columns reference body on the actual source surface; tail not yet attached | PI/Cu flex envelope; active coverlay opening | cad/f1_ch4_columns_body.step | cad/f1_ch4_columns_body.stl
f1_ch4_film_body | reference_only | CH4 film reference body on the actual source surface; tail not yet attached | 0.10 mm conductive pressure film | cad/f1_ch4_film_body.step | cad/f1_ch4_film_body.stl
f1_ch4_rows_body | reference_only | CH4 rows reference body on the actual source surface; tail not yet attached | PI/Cu flex envelope; active coverlay opening | cad/f1_ch4_rows_body.step | cad/f1_ch4_rows_body.stl
f1_ch4_cover_body | reference_only | CH4 cover reference body on the actual source surface; tail not yet attached | Silicone cover process target | cad/f1_ch4_cover_body.step | cad/f1_ch4_cover_body.stl
f1_ch4_forming_mandrel | fabricate_tool | CH4 rigid backing form for separate-layer assembly away from the robot | PETG/engineering plastic tool; smooth the contact surface and use a release film | cad/f1_ch4_forming_mandrel.step | cad/f1_ch4_forming_mandrel.stl
f1_ch5_columns_body | reference_only | CH5 columns reference body on the actual source surface; tail not yet attached | PI/Cu flex envelope; active coverlay opening | cad/f1_ch5_columns_body.step | cad/f1_ch5_columns_body.stl
f1_ch5_film_body | reference_only | CH5 film reference body on the actual source surface; tail not yet attached | 0.10 mm conductive pressure film | cad/f1_ch5_film_body.step | cad/f1_ch5_film_body.stl
f1_ch5_rows_body | reference_only | CH5 rows reference body on the actual source surface; tail not yet attached | PI/Cu flex envelope; active coverlay opening | cad/f1_ch5_rows_body.step | cad/f1_ch5_rows_body.stl
f1_ch5_cover_body | reference_only | CH5 cover reference body on the actual source surface; tail not yet attached | Silicone cover process target | cad/f1_ch5_cover_body.step | cad/f1_ch5_cover_body.stl
f1_ch5_forming_mandrel | fabricate_tool | CH5 rigid backing form for separate-layer assembly away from the robot | PETG/engineering plastic tool; smooth the contact surface and use a release film | cad/f1_ch5_forming_mandrel.step | cad/f1_ch5_forming_mandrel.stl
f1_r3_carrier | fabricate | f1 r3 carrier | PETG or machined insulating plastic for a bench prototype; shrinkage, strength and creep unqualified | cad/f1_r3_carrier.step | cad/f1_r3_carrier.stl
f1_r3_pcb_fit_reference | reference_only | f1 r3 pcb fit reference | 1 mm FR4 reference; use independently checked PCB artwork for electronics | cad/f1_r3_pcb_fit_reference.step | cad/f1_r3_pcb_fit_reference.stl
f1_ch0_columns_fit_tail_reference | reference_only | CH0 columns covered-tail fit reference; electrode body and stiffener are separate | Nominal PI/Cu/coverlay envelope, not a 3D-printable functional sensor | cad/f1_ch0_columns_fit_tail_reference.step | cad/f1_ch0_columns_fit_tail_reference.stl
f1_ch0_rows_fit_tail_reference | reference_only | CH0 rows covered-tail fit reference; electrode body and stiffener are separate | Nominal PI/Cu/coverlay envelope, not a 3D-printable functional sensor | cad/f1_ch0_rows_fit_tail_reference.step | cad/f1_ch0_rows_fit_tail_reference.stl
f1_ch1_columns_fit_tail_reference | reference_only | CH1 columns covered-tail fit reference; electrode body and stiffener are separate | Nominal PI/Cu/coverlay envelope, not a 3D-printable functional sensor | cad/f1_ch1_columns_fit_tail_reference.step | cad/f1_ch1_columns_fit_tail_reference.stl
f1_ch1_rows_fit_tail_reference | reference_only | CH1 rows covered-tail fit reference; electrode body and stiffener are separate | Nominal PI/Cu/coverlay envelope, not a 3D-printable functional sensor | cad/f1_ch1_rows_fit_tail_reference.step | cad/f1_ch1_rows_fit_tail_reference.stl
f1_ch2_columns_fit_tail_reference | reference_only | CH2 columns covered-tail fit reference; electrode body and stiffener are separate | Nominal PI/Cu/coverlay envelope, not a 3D-printable functional sensor | cad/f1_ch2_columns_fit_tail_reference.step | cad/f1_ch2_columns_fit_tail_reference.stl
f1_ch2_rows_fit_tail_reference | reference_only | CH2 rows covered-tail fit reference; electrode body and stiffener are separate | Nominal PI/Cu/coverlay envelope, not a 3D-printable functional sensor | cad/f1_ch2_rows_fit_tail_reference.step | cad/f1_ch2_rows_fit_tail_reference.stl
f1_ch3_columns_fit_tail_reference | reference_only | CH3 columns covered-tail fit reference; electrode body and stiffener are separate | Nominal PI/Cu/coverlay envelope, not a 3D-printable functional sensor | cad/f1_ch3_columns_fit_tail_reference.step | cad/f1_ch3_columns_fit_tail_reference.stl
f1_ch3_rows_fit_tail_reference | reference_only | CH3 rows covered-tail fit reference; electrode body and stiffener are separate | Nominal PI/Cu/coverlay envelope, not a 3D-printable functional sensor | cad/f1_ch3_rows_fit_tail_reference.step | cad/f1_ch3_rows_fit_tail_reference.stl
f1_ch4_columns_fit_tail_reference | reference_only | CH4 columns covered-tail fit reference; electrode body and stiffener are separate | Nominal PI/Cu/coverlay envelope, not a 3D-printable functional sensor | cad/f1_ch4_columns_fit_tail_reference.step | cad/f1_ch4_columns_fit_tail_reference.stl
f1_ch4_rows_fit_tail_reference | reference_only | CH4 rows covered-tail fit reference; electrode body and stiffener are separate | Nominal PI/Cu/coverlay envelope, not a 3D-printable functional sensor | cad/f1_ch4_rows_fit_tail_reference.step | cad/f1_ch4_rows_fit_tail_reference.stl
f1_ch5_columns_fit_tail_reference | reference_only | CH5 columns covered-tail fit reference; electrode body and stiffener are separate | Nominal PI/Cu/coverlay envelope, not a 3D-printable functional sensor | cad/f1_ch5_columns_fit_tail_reference.step | cad/f1_ch5_columns_fit_tail_reference.stl
f1_ch5_rows_fit_tail_reference | reference_only | CH5 rows covered-tail fit reference; electrode body and stiffener are separate | Nominal PI/Cu/coverlay envelope, not a 3D-printable functional sensor | cad/f1_ch5_rows_fit_tail_reference.step | cad/f1_ch5_rows_fit_tail_reference.stl
