geyan21/yam-tactile-kit/engineering/prototypes/optical/electronics/led/pin_net.csv

reference | pad | net | x_mm | y_mm
D1 | 2 | A1 | 4.875 | 3.7
D1 | 1 | GND | 2.525 | 3.7
D2 | 2 | A2 | 13.475 | 3.7
D2 | 1 | GND | 11.125 | 3.7
D3 | 2 | A3 | 13.475 | 12.3
D3 | 1 | GND | 11.125 | 12.3
D4 | 2 | A4 | 4.875 | 12.3
D4 | 1 | GND | 2.525 | 12.3
R1 | 2 | A1 | 9.5 | 1.6
R1 | 1 | LED_5V | 6.5 | 1.6
R2 | 2 | A2 | 14.4 | 6.5
R2 | 1 | LED_5V | 14.4 | 9.5
R3 | 2 | A3 | 9.5 | 14.4
R3 | 1 | LED_5V | 6.5 | 14.4
R4 | 2 | A4 | 1.6 | 6.5
R4 | 1 | LED_5V | 1.6 | 9.5
J1 | 2 | GND | 3.4 | 1.8
J1 | 1 | LED_5V | 1.4 | 1.8
