geyan21/yam-tactile-kit/engineering/prototypes/pneumatic/electronics/readout/p1_readout_pin_net.csv

reference | pad | net | x_mm | y_mm
JP1 | 1 | P_SDA | 31.11 | 6.0
JP1 | 2 | P_SCL | 31.11 | 8.54
JP1 | 3 | GND | 31.11 | 11.079999999999998
JP1 | 4 | N_SDA | 31.11 | 13.619999999999997
JP1 | 5 | N_SCL | 31.11 | 16.159999999999997
JP1 | 6 | unused | 31.11 | 18.7
JP1 | 7 | unused | 31.11 | 21.24
JP1 | 8 | GND | 31.11 | 23.78
JP1 | 9 | MUX_RST | 31.11 | 26.32
JP1 | 10 | unused | 31.11 | 28.86
JP1 | 11 | unused | 31.11 | 31.4
JP1 | 12 | unused | 31.11 | 33.94
JP1 | 13 | GND | 31.11 | 36.48
JP1 | 14 | unused | 31.11 | 39.019999999999996
JP1 | 15 | unused | 31.11 | 41.56
JP1 | 16 | unused | 31.11 | 44.1
JP1 | 17 | unused | 31.11 | 46.64
JP1 | 18 | GND | 31.11 | 49.18
JP1 | 19 | unused | 31.11 | 51.72
JP1 | 20 | unused | 31.11 | 54.26
JP2 | 1 | 5V_USB | 48.89 | 6.0
JP2 | 2 | unused | 48.89 | 8.54
JP2 | 3 | GND | 48.89 | 11.079999999999998
JP2 | 4 | unused | 48.89 | 13.619999999999997
JP2 | 5 | 3V3 | 48.89 | 16.159999999999997
JP2 | 6 | unused | 48.89 | 18.7
JP2 | 7 | unused | 48.89 | 21.24
JP2 | 8 | GND | 48.89 | 23.78
JP2 | 9 | unused | 48.89 | 26.32
JP2 | 10 | unused | 48.89 | 28.86
JP2 | 11 | unused | 48.89 | 31.4
JP2 | 12 | unused | 48.89 | 33.94
JP2 | 13 | GND | 48.89 | 36.48
JP2 | 14 | unused | 48.89 | 39.019999999999996
JP2 | 15 | unused | 48.89 | 41.56
JP2 | 16 | unused | 48.89 | 44.1
JP2 | 17 | unused | 48.89 | 46.64
JP2 | 18 | GND | 48.89 | 49.18
JP2 | 19 | unused | 48.89 | 51.72
JP2 | 20 | unused | 48.89 | 54.26
PS0 | 1 | 3V0 | 17.81 | 6.869999999999999
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
CO | 1 | 3V0 | 67.175 | 65.05
CO | 2 | GND | 68.825 | 65.05
CB | 1 | 3V0 | 63.175 | 58.0
CB | 2 | GND | 64.825 | 58.0
JN | 1 | 3V3 | 38.19 | 79.0
JN | 2 | NAIL0 | 40.73 | 79.0
JN | 3 | 3V3 | 43.27 | 79.0
JN | 4 | NAIL1 | 45.81 | 79.0
JT | 1 | GND | 64.19 | 78.0
JT | 2 | 3V0 | 66.73 | 78.0
JT | 3 | 3V3 | 69.27 | 78.0
JT | 4 | 5V_USB | 71.81 | 78.0
