geyan21/yam-tactile-kit/engineering/prototypes/force_button/pcb/fb1_sensor_pins.csv

reference | pad | net | layers | x_mm | y_mm
U1 | 6 |  | F.Cu | 6.03 | 7.0
U1 | 5 | SDA | F.Cu | 9.59 | 7.0
U1 | 4 | SCL | F.Cu | 6.62 | 8.7
U1 | 3 | GND_REMOTE | F.Cu | 9.16 | 8.7
U1 | 2 |  | F.Cu | 9.16 | 5.3
U1 | 1 | VDD_REMOTE | F.Cu | 6.62 | 5.3
C1 | 1 | VDD_REMOTE | F.Cu | 4.275 | 5.3
C1 | 2 | GND_REMOTE | F.Cu | 2.725 | 5.3
C2 | 1 | VDD_REMOTE | F.Cu | 4.275 | 8.0
C2 | 2 | GND_REMOTE | F.Cu | 2.725 | 8.0
JW | 6 | GND_REMOTE | F.Cu/B.Cu | 8.5 | 18.0
JW | 5 | VDD_REMOTE | F.Cu/B.Cu | 8.5 | 16.0
JW | 4 | SCL | F.Cu/B.Cu | 6.5 | 18.0
JW | 3 | SDA | F.Cu/B.Cu | 6.5 | 16.0
JW | 2 | GND_REMOTE | F.Cu/B.Cu | 4.5 | 18.0
JW | 1 | VDD_REMOTE | F.Cu/B.Cu | 4.5 | 16.0
