geyan21/yam-tactile-kit/engineering/prototypes/b2/pcb/b2_main_pin_net.csv

reference | pad | net | x_mm | y_mm
U1 | 1 | unused | 85.16650961360723 | 35.82579467582938
U1 | 5 | SDA0 | 84.86682357583014 | 33.59976945612464
U1 | 9 | GND | 82.64079835612542 | 33.89945549390172
U1 | 13 | GND | 82.94048439390251 | 36.12548071360646
U1 | 2 | 3V3 | 85.24605286549894 | 35.332162352051355
U1 | 6 | unused | 84.37319125205212 | 33.52022620423293
U1 | 10 | GND | 82.56125510423371 | 34.39308781767974
U1 | 14 | GND | 83.43411671768052 | 36.20502396549817
U1 | 3 | SCL0 | 85.32559611739066 | 34.838530028273325
U1 | 7 | unused | 83.8795589282741 | 33.44068295234122
U1 | 11 | GND | 82.48171185234199 | 34.88672014145777
U1 | 15 | 3V3 | 83.92774904145855 | 36.28456721738988
U1 | 4 | GND | 85.40513936928237 | 34.3448977044953
U1 | 8 | 3V3 | 83.38592660449608 | 33.361139700449506
U1 | 12 | GND | 82.40216860045028 | 35.380352465235795
U1 | 16 | GND | 84.42138136523657 | 36.36411046928159
U1 | 17 | GND | 83.90365398486632 | 34.86262508486555
C11 | 1 | 3V3 | 86.11400263521743 | 36.23169734150181
C11 | 2 | GND | 87.10126728277349 | 36.39078384528522
C12 | 1 | GND | 80.75704120057975 | 33.64655436909103
C12 | 2 | 3V3 | 81.74430584813581 | 33.80564087287444
R11 | 1 | 3V3 | 80.97976230587653 | 32.264383862512574
R11 | 2 | SCL0 | 81.9670269534326 | 32.42347036629599
R12 | 1 | 3V3 | 86.63430833499908 | 33.63135467585661
R12 | 2 | SDA0 | 87.62157298255514 | 33.79044117964003
TP1 | 1 | 3V3 | 82.04329564283874 | 31.321570603605984
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
U10 | 25 | GND | 14.3 | 17.7
U11 | 1 | GND | 11.8 | 25.2
U11 | 6 | VDD_HALF | 16.2 | 27.2
U11 | 2 | unused | 11.8 | 25.7
U11 | 7 | CHECK_HALF | 16.2 | 26.7
U11 | 3 | GND | 11.8 | 26.2
U11 | 8 | 3V3 | 16.2 | 26.2
U11 | 4 | T0 | 11.8 | 26.7
U11 | 9 | SDA | 16.2 | 25.7
U11 | 5 | T1 | 11.8 | 27.2
U11 | 10 | SCL | 16.2 | 25.2
R100 | 1 | 3V3 | 11.5 | 22.5
R100 | 2 | SCL | 12.5 | 22.5
R101 | 1 | 3V3 | 13.8 | 22.5
R101 | 2 | SDA | 14.8 | 22.5
R102 | 1 | 3V3 | 16.5 | 22.5
R102 | 2 | RESET | 17.5 | 22.5
C100 | 1 | 3V3 | 17.5 | 18.0
C100 | 2 | GND | 18.5 | 18.0
C101 | 1 | 3V3 | 17.5 | 23.7
C101 | 2 | GND | 18.5 | 23.7
C102 | 1 | 3V3 | 17.5 | 20.0
C102 | 2 | GND | 18.5 | 20.0
R103 | 1 | 3V3 | 11.5 | 29.1
R103 | 2 | VDD_HALF | 12.5 | 29.1
R104 | 1 | VDD_HALF | 11.5 | 30.6
R104 | 2 | GND | 12.5 | 30.6
R105 | 1 | 3V3 | 14.5 | 29.1
R105 | 2 | CHECK_HALF | 15.5 | 29.1
R106 | 1 | CHECK_HALF | 14.5 | 30.6
R106 | 2 | GND | 15.5 | 30.6
R107 | 1 | T0 | 17.5 | 29.1
R107 | 2 | GND | 18.5 | 29.1
R108 | 1 | T1 | 17.5 | 30.6
R108 | 2 | GND | 18.5 | 30.6
J1 | 1 | 3V3 | 9.8 | 24.25
J1 | 2 | GND | 9.8 | 22.75
J1 | 3 | SCL | 9.8 | 21.25
J1 | 4 | SDA | 9.8 | 19.75
J2 | 1 | 3V3 | 11.75 | 32.5
J2 | 2 | T0 | 13.25 | 32.5
J2 | 3 | 3V3 | 14.75 | 32.5
J2 | 4 | T1 | 16.25 | 32.5
