geyan21/yam-tactile-kit/engineering/release/b1/pcb/b1_head_pin_net.csv

reference | pad | signal | net
U1 | 1 | INT (unused) | unconnected
U1 | 2 | MS/CS | 3V3
U1 | 3 | SCL | SCL
U1 | 4 | NC→GND | GND
U1 | 5 | SDA | SDA
U1 | 6 | MISO (unused) | unconnected
U1 | 7 | INT/TRIG (unused) | unconnected
U1 | 8 | VDD_IO | 3V3
U1 | 9 | NC→GND | GND
U1 | 10 | NC→GND | GND
U1 | 11 | A1 | GND
U1 | 12 | A0 | GND
U1 | 13 | VSS | GND
U1 | 14 | NC→GND | GND
U1 | 15 | VDD | 3V3
U1 | 16 | NC→GND | GND
U1 | 17 | Exposed pad | GND
C1 | 1 | 3V3 | 3V3
C1 | 2 | GND | GND
C2 | 1 | GND | GND
C2 | 2 | 3V3 | 3V3
R1 | 1 | 3V3 | 3V3
R1 | 2 | SCL | SCL
R2 | 1 | 3V3 | 3V3
R2 | 2 | SDA | SDA
J1 | 1 | 3V3 | 3V3
J1 | 2 | GND | GND
J1 | 3 | SCL | SCL
J1 | 4 | SDA | SDA
