geyan21/yam-tactile-kit/engineering/prototypes/f1/cad/f1_ch1_columns_full_stiffener_pi.step

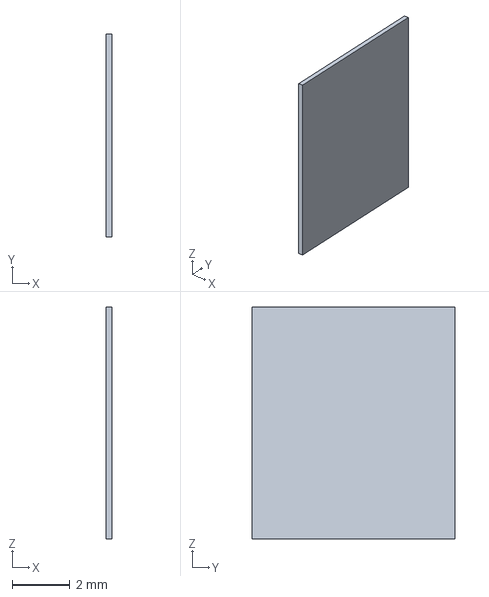
[picture p90: CAD file, 2026-10-12]
engineering/prototypes/f1/cad/f1_ch1_columns_full_stiffener_pi.step
0.2 x 7.00 x 8.00 mm
