geyan21/yam-tactile-kit/engineering/prototypes/f1/cad/f1_ch4_rows_complete_envelope.step

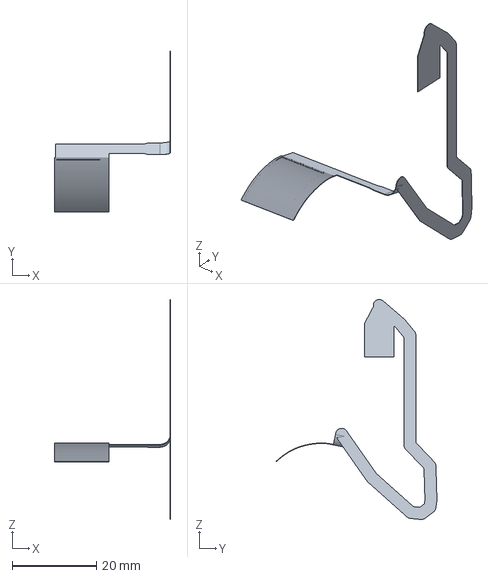
[picture p91: CAD file, 2026-10-12]
engineering/prototypes/f1/cad/f1_ch4_rows_complete_envelope.step
27.6 x 38.2 x 52.1 mm
