geyan21/yam-tactile-kit/engineering/prototypes/f1/cad/f1_ch1_columns_full_stiffener_bond.step

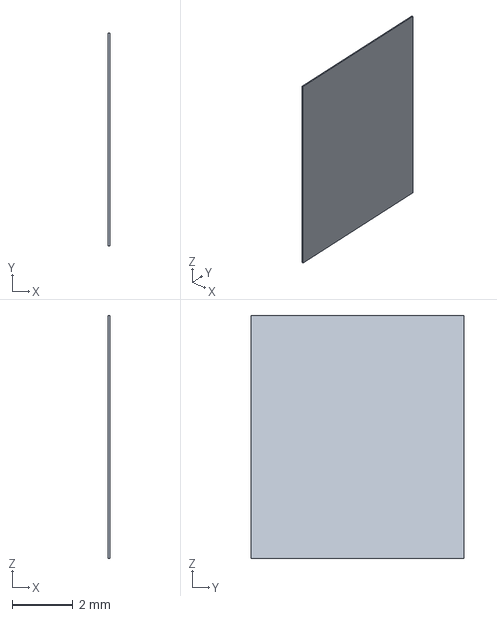
[picture p92: CAD file, 2026-10-12]
engineering/prototypes/f1/cad/f1_ch1_columns_full_stiffener_bond.step
0.05 x 7.00 x 8.00 mm
