geyan21/yam-tactile-kit/engineering/prototypes/f1/cad/f1_ch2_columns_complete_envelope.step

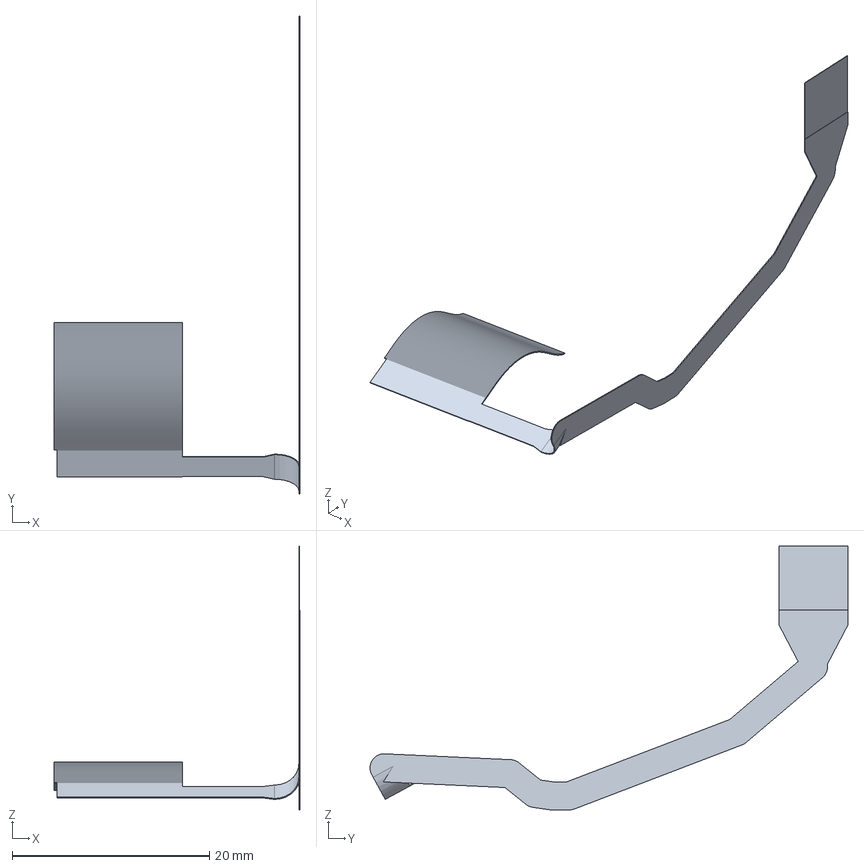
[picture p93: CAD file, 2026-10-12]
engineering/prototypes/f1/cad/f1_ch2_columns_complete_envelope.step
24.9 x 48.5 x 26.8 mm
