geyan21/yam-tactile-kit/engineering/prototypes/f1/cad/f1_ch1_columns_complete_envelope.step

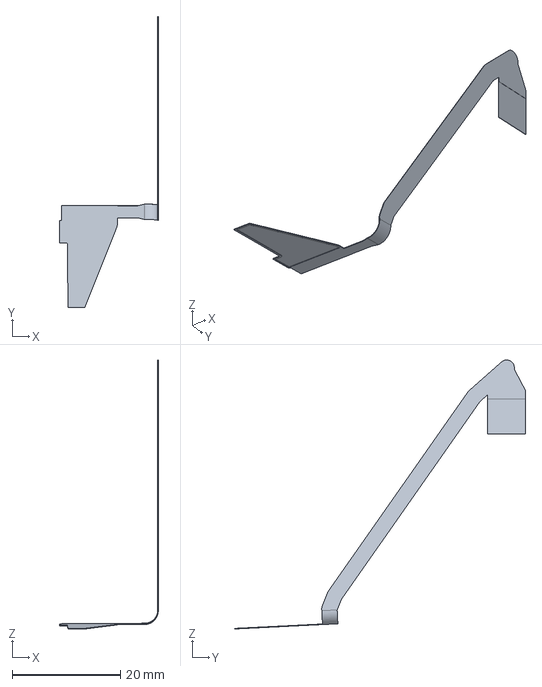
[picture p94: CAD file, 2026-10-12]
engineering/prototypes/f1/cad/f1_ch1_columns_complete_envelope.step
18.2 x 53.8 x 49.7 mm
