geyan21/yam-tactile-kit/engineering/prototypes/f1/cad/f1_ch1_rows_complete_envelope.step

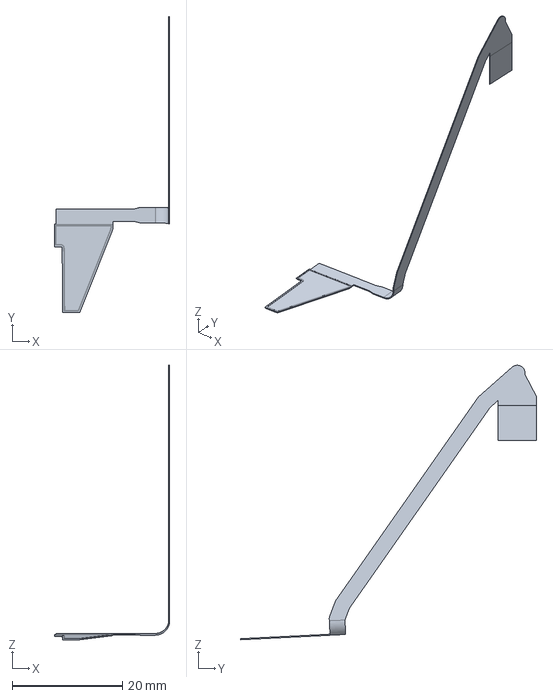
[picture p95: CAD file, 2026-10-12]
engineering/prototypes/f1/cad/f1_ch1_rows_complete_envelope.step
21.0 x 53.8 x 49.9 mm
