geyan21/yam-tactile-kit/engineering/prototypes/f1/cad/f1_ch2_rows_complete_envelope.step

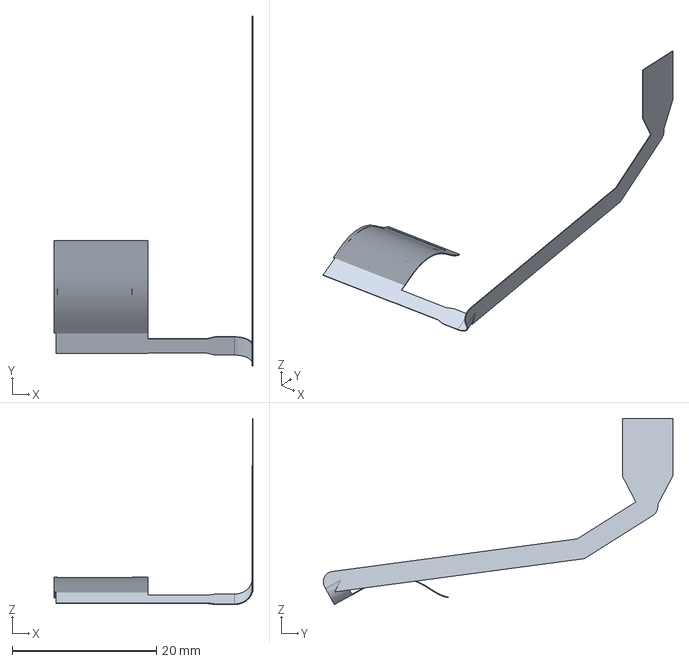
[picture p96: CAD file, 2026-10-12]
engineering/prototypes/f1/cad/f1_ch2_rows_complete_envelope.step
27.6 x 48.5 x 25.8 mm
