geyan21/yam-tactile-kit/engineering/prototypes/f1/cad/f1_ch3_rows_complete_envelope.step

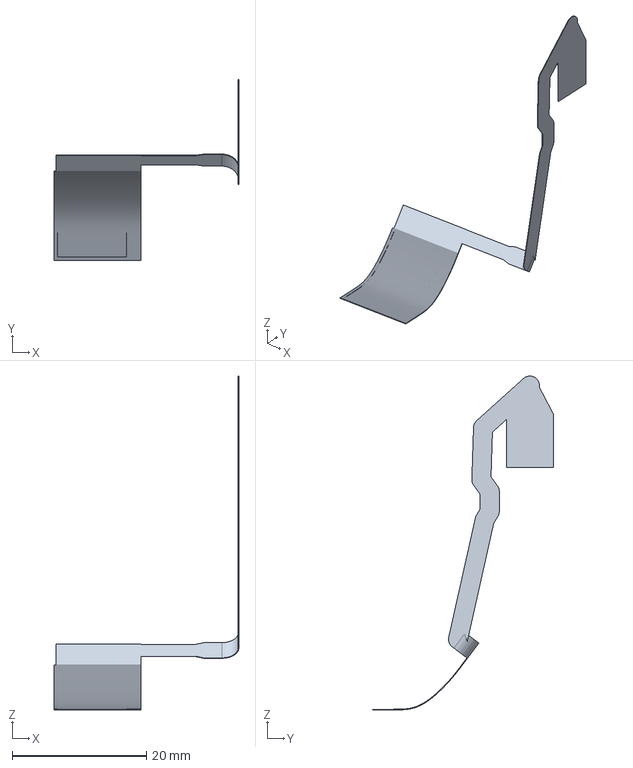
[picture p97: CAD file, 2026-10-12]
engineering/prototypes/f1/cad/f1_ch3_rows_complete_envelope.step
27.6 x 27.0 x 49.8 mm
