geyan21/yam-tactile-kit/engineering/prototypes/f1/cad/f1_ch5_columns_complete_envelope.step

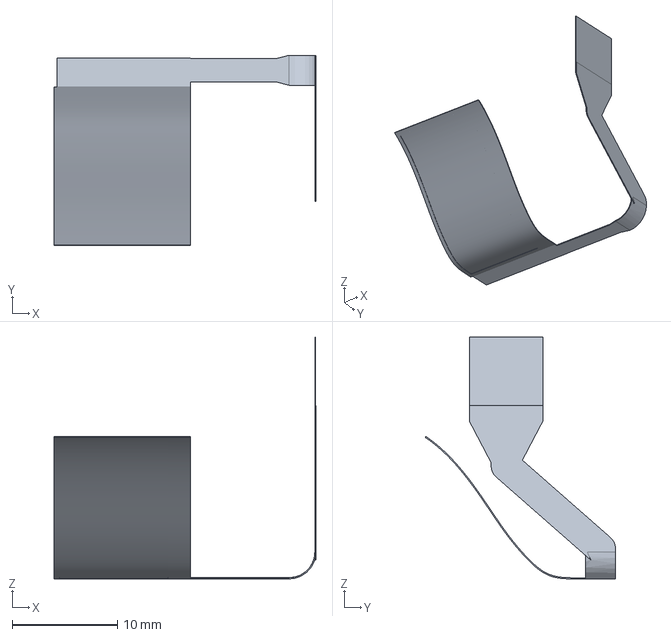
[picture p98: CAD file, 2026-10-12]
engineering/prototypes/f1/cad/f1_ch5_columns_complete_envelope.step
24.9 x 18.1 x 23.0 mm
