geyan21/yam-tactile-kit/engineering/prototypes/f1/cad/f1_ch3_columns_complete_envelope.step

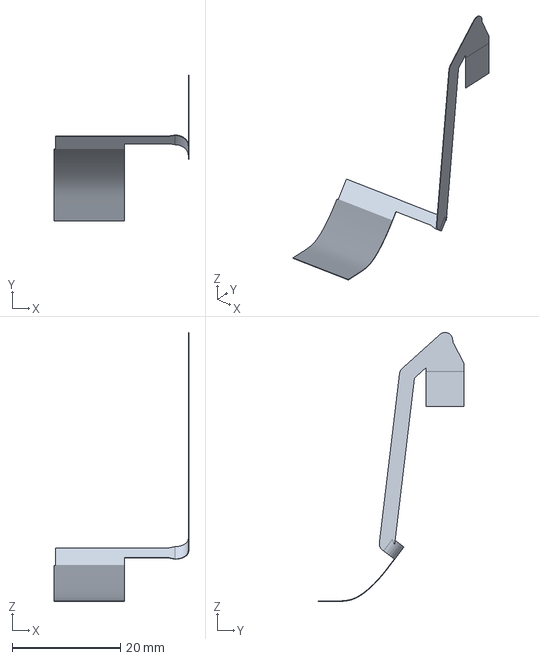
[picture p99: CAD file, 2026-10-12]
engineering/prototypes/f1/cad/f1_ch3_columns_complete_envelope.step
24.9 x 27.0 x 49.7 mm
