geyan21/yam-tactile-kit/engineering/prototypes/f1/cad/f1_ch0_layer_assembly_form.step

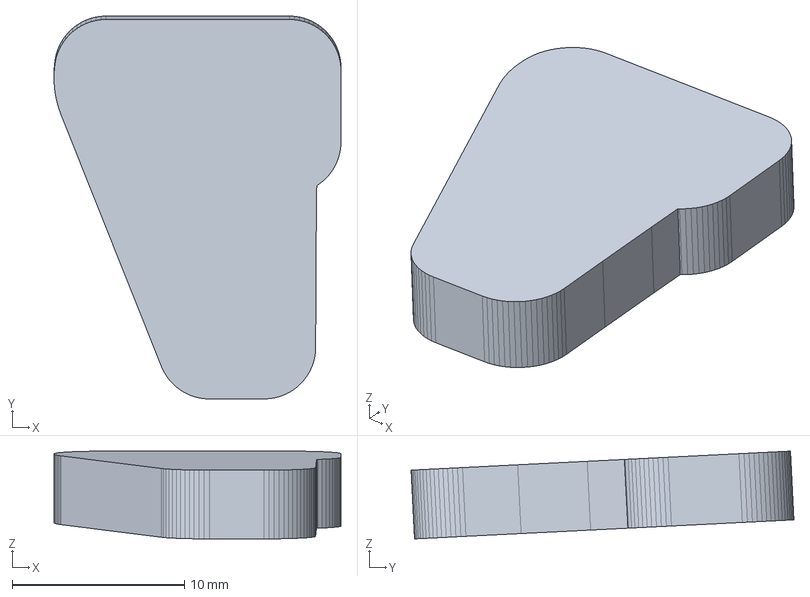
[picture p100: CAD file, 2026-10-12]
engineering/prototypes/f1/cad/f1_ch0_layer_assembly_form.step
16.7 x 22.3 x 5.10 mm
