geyan21/yam-tactile-kit/engineering/prototypes/f1/cad/f1_ch4_layer_assembly_form.step

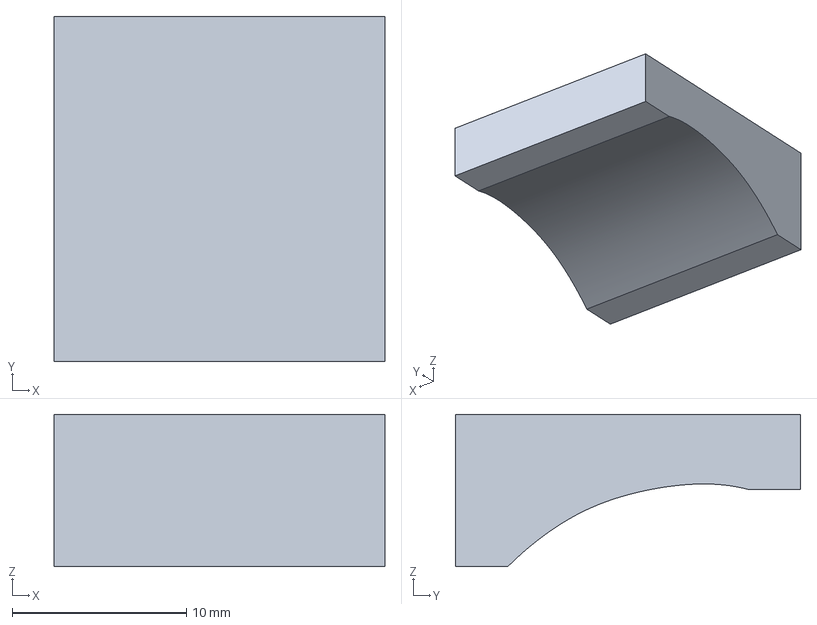
[picture p101: CAD file, 2026-10-12]
engineering/prototypes/f1/cad/f1_ch4_layer_assembly_form.step
19.0 x 19.8 x 8.75 mm
