geyan21/yam-tactile-kit/engineering/prototypes/f1/cad/f1_ch0_columns_complete_envelope.step

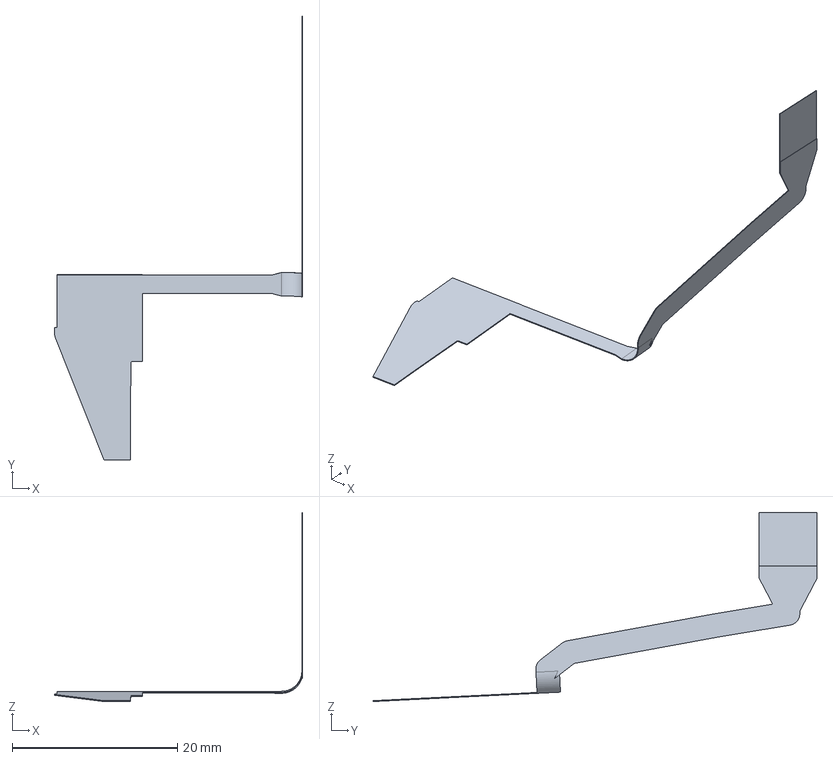
[picture p102: CAD file, 2026-10-12]
engineering/prototypes/f1/cad/f1_ch0_columns_complete_envelope.step
30.1 x 53.8 x 22.9 mm
