geyan21/yam-tactile-kit/engineering/prototypes/f1/cad/f1_ch5_rows_complete_envelope.step

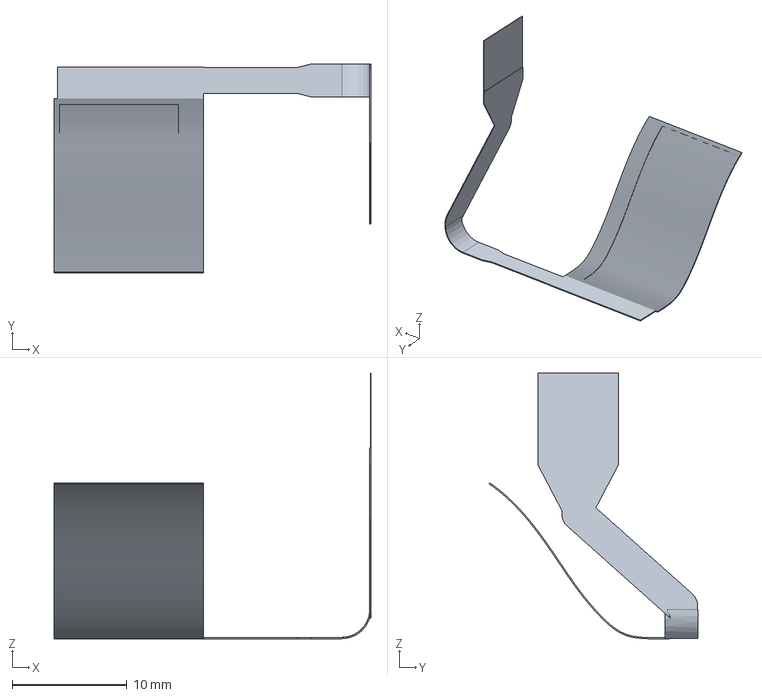
[picture p103: CAD file, 2026-10-12]
engineering/prototypes/f1/cad/f1_ch5_rows_complete_envelope.step
27.6 x 18.2 x 23.1 mm
