geyan21/yam-tactile-kit/engineering/prototypes/f1/cad/f1_ch4_columns_complete_envelope.step

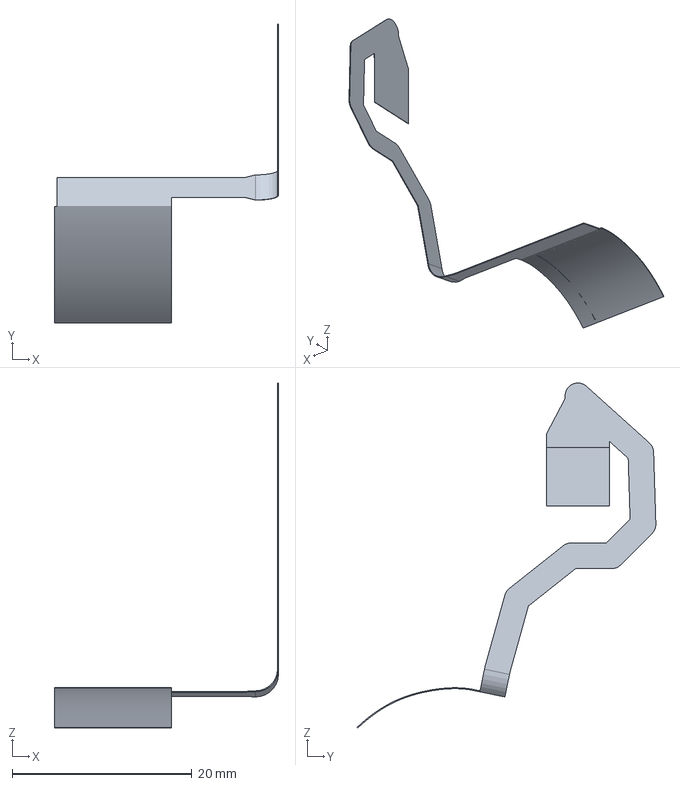
[picture p104: CAD file, 2026-10-12]
engineering/prototypes/f1/cad/f1_ch4_columns_complete_envelope.step
24.9 x 33.2 x 38.4 mm
