geyan21/yam-tactile-kit/engineering/prototypes/f1/cad/f1_ch0_rows_complete_envelope.step

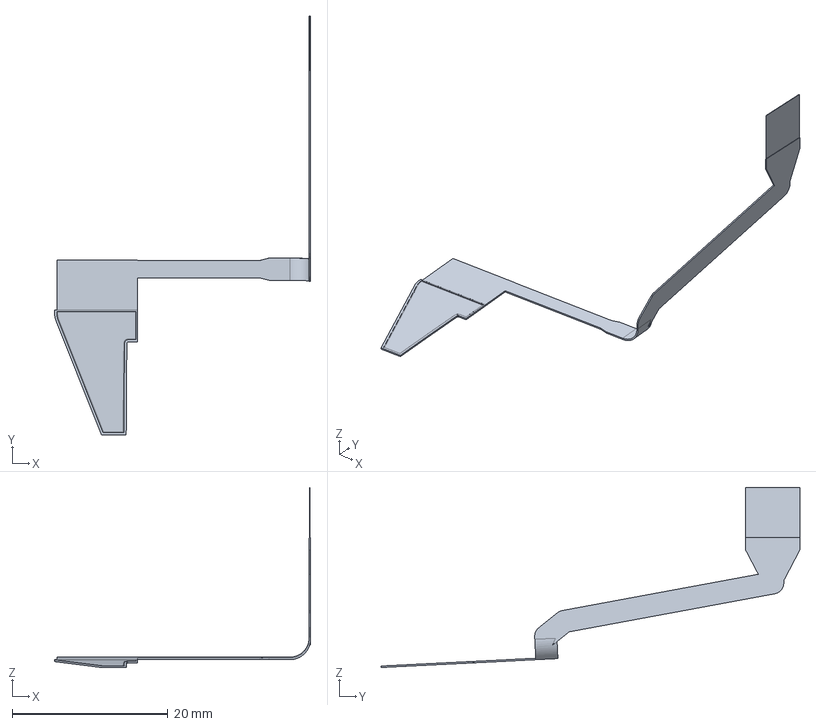
[picture p105: CAD file, 2026-10-12]
engineering/prototypes/f1/cad/f1_ch0_rows_complete_envelope.step
32.9 x 53.8 x 23.1 mm
