geyan21/yam-tactile-kit/engineering/prototypes/f1/cad/f1_ch3_layer_assembly_form.step

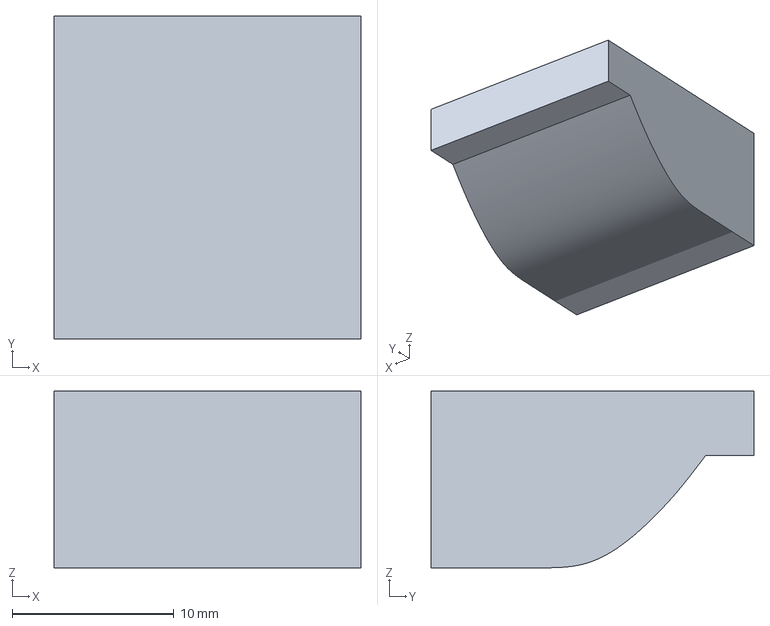
[picture p106: CAD file, 2026-10-12]
engineering/prototypes/f1/cad/f1_ch3_layer_assembly_form.step
19.0 x 20.0 x 10.9 mm
