geyan21/yam-tactile-kit/engineering/prototypes/f1/cad/f1_ch2_layer_assembly_form.step

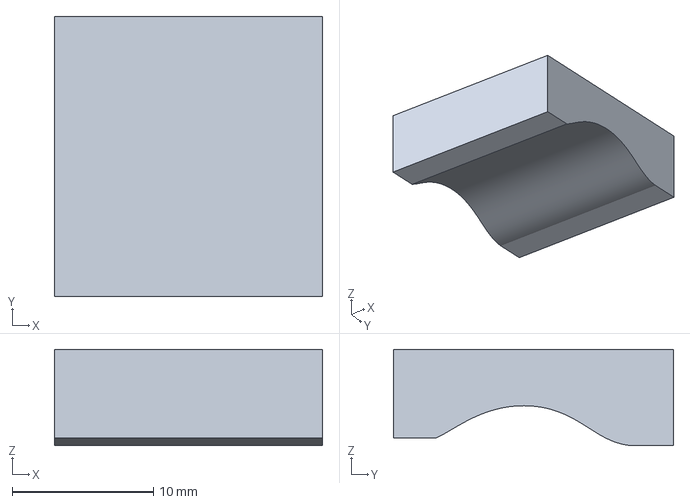
[picture p107: CAD file, 2026-10-12]
engineering/prototypes/f1/cad/f1_ch2_layer_assembly_form.step
19.0 x 19.8 x 6.83 mm
