geyan21/yam-tactile-kit/engineering/prototypes/f1/cad/f1_ch5_layer_assembly_form.step

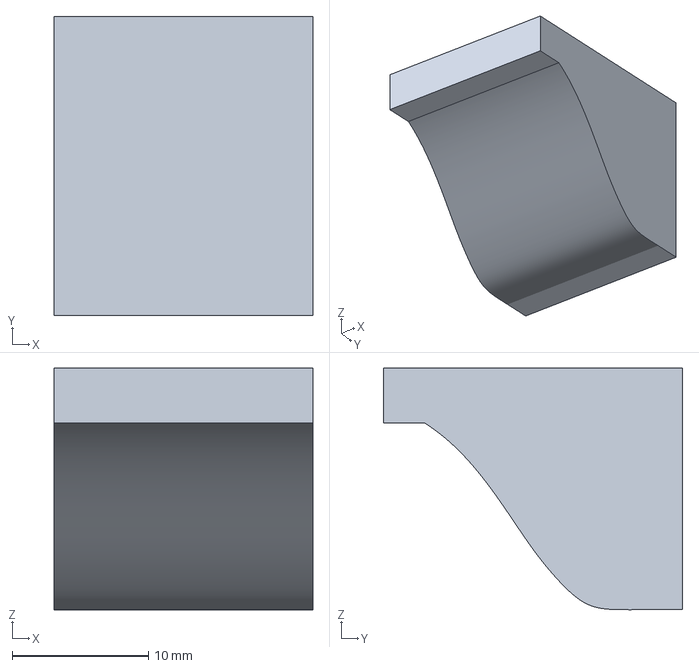
[picture p108: CAD file, 2026-10-12]
engineering/prototypes/f1/cad/f1_ch5_layer_assembly_form.step
19.0 x 22.0 x 17.7 mm
