geyan21/yam-tactile-kit/engineering/concepts/cad/c1_strain_beam_coupon.step

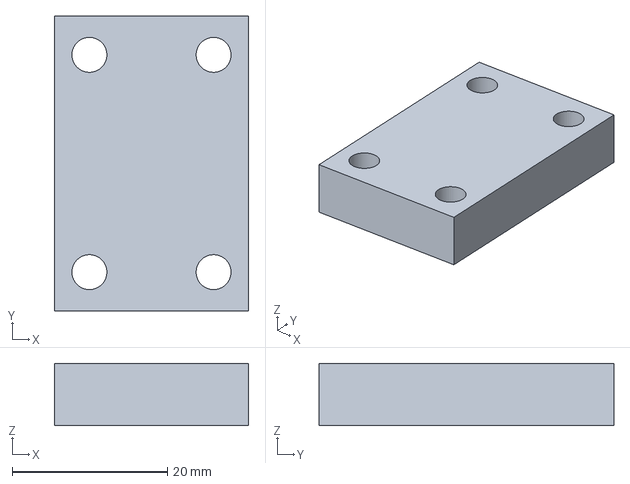
[picture p109: CAD file, 2026-10-10]
engineering/concepts/cad/c1_strain_beam_coupon.step
25.0 x 38.0 x 8.00 mm
