geyan21/yam-tactile-kit/engineering/development/capacitive/k1/cad/k1_ch1_post_stencil.step

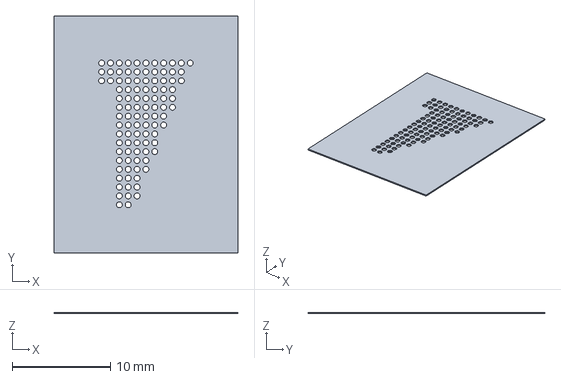
[picture p110: CAD file, 2026-10-11]
engineering/development/capacitive/k1/cad/k1_ch1_post_stencil.step
18.7 x 24.1 x 0.15 mm
