geyan21/yam-tactile-kit/engineering/development/f1/r3/cad/f1_ch5_cover_body.stl

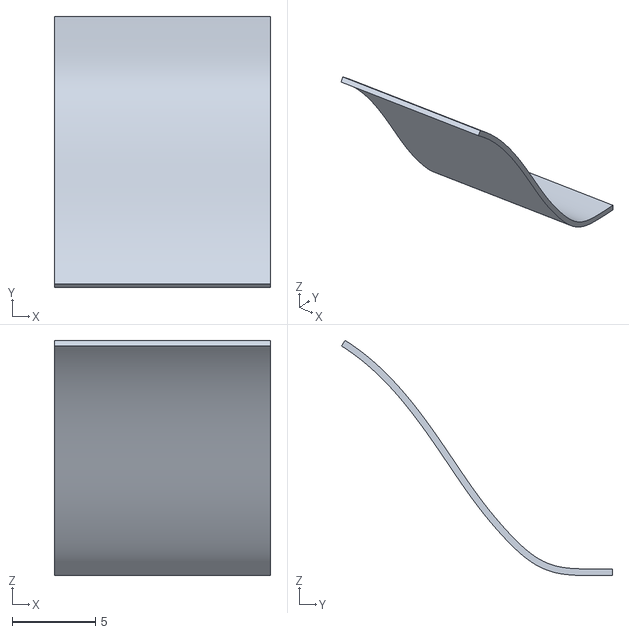
[picture p112: CAD file, 2026-10-11]
engineering/development/f1/r3/cad/f1_ch5_cover_body.stl
13.0 x 16.3 x 14.2
