geyan21/yam-tactile-kit/engineering/prototypes/b2/cad/b2_removable_backer.step

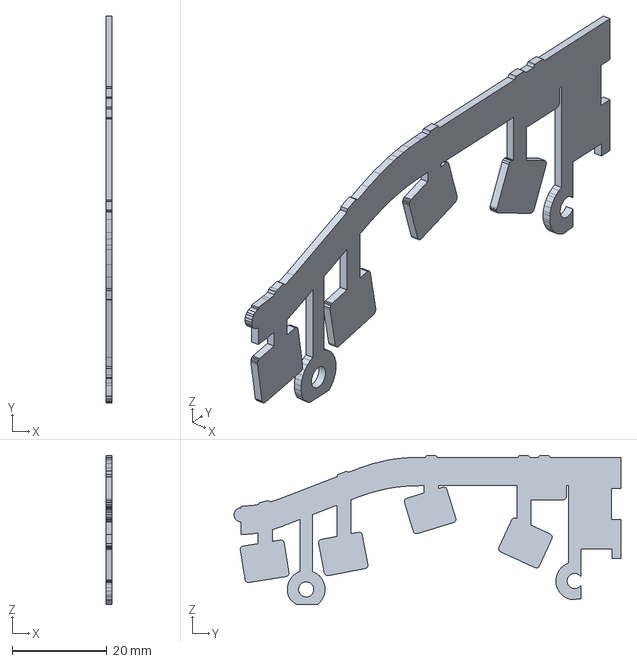
[picture p113: CAD file, 2026-10-10]
engineering/prototypes/b2/cad/b2_removable_backer.step
1.20 x 81.7 x 31.5 mm
