geyan21/yam-tactile-kit/engineering/prototypes/c1/cad/c1_strain_beam.step

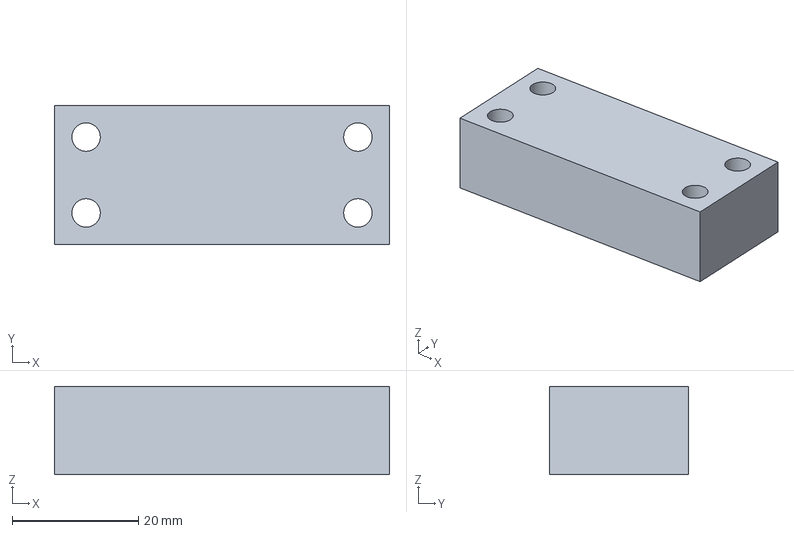
[picture p114: CAD file, 2026-10-11]
engineering/prototypes/c1/cad/c1_strain_beam.step
53.0 x 22.0 x 14.0 mm
