geyan21/yam-tactile-kit/engineering/prototypes/capacitive/cad/k1_ch0_post_sheet_flat.step

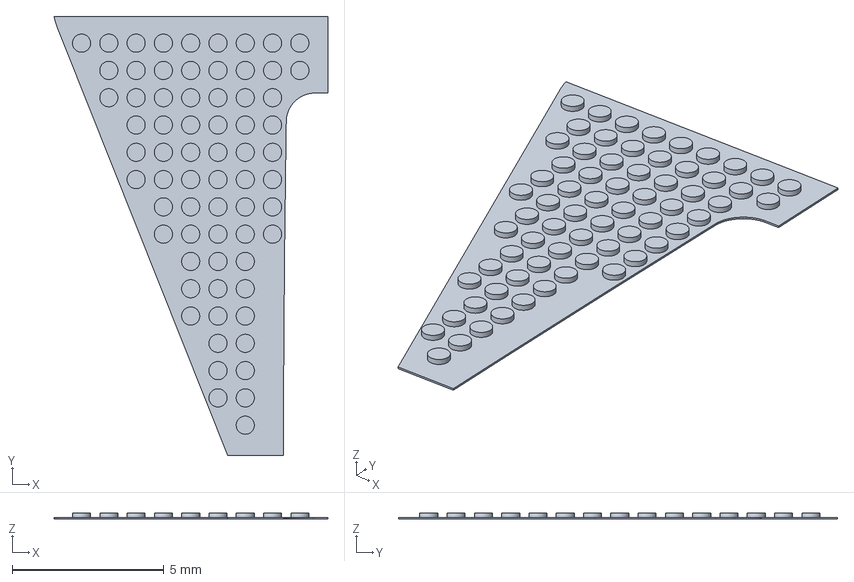
[picture p115: CAD file, 2026-10-11]
engineering/prototypes/capacitive/cad/k1_ch0_post_sheet_flat.step
9.04 x 14.5 x 0.2 mm
