geyan21/yam-tactile-kit/engineering/prototypes/f1/cad/f1_ch4_compliant_fit_base_mold_a.step

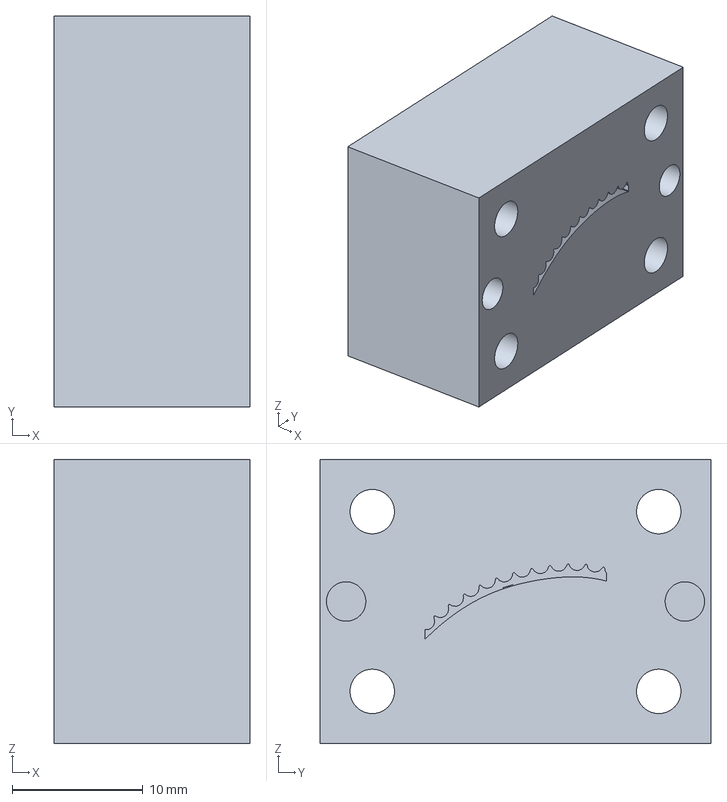
[picture p116: CAD file, 2026-10-12]
engineering/prototypes/f1/cad/f1_ch4_compliant_fit_base_mold_a.step
15.0 x 29.9 x 21.8 mm
