geyan21/yam-tactile-kit/engineering/prototypes/force_button/reference_tessellation/fb1_fma25_envelope_raw.stl

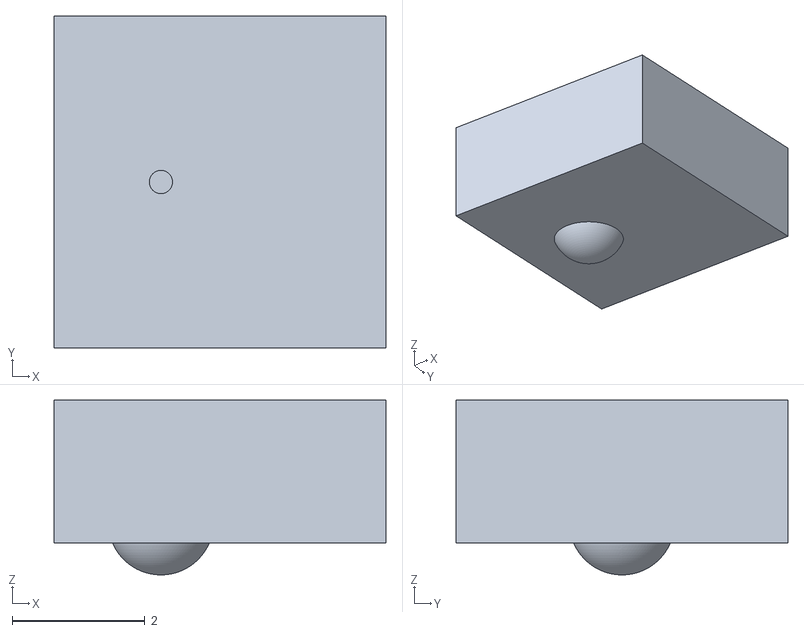
[picture p117: CAD file, 2026-10-11]
engineering/prototypes/force_button/reference_tessellation/fb1_fma25_envelope_raw.stl
5.00 x 5.00 x 2.63
