geyan21/yam-tactile-kit/engineering/prototypes/nail/cad/nail_right_fixed_carrier.step

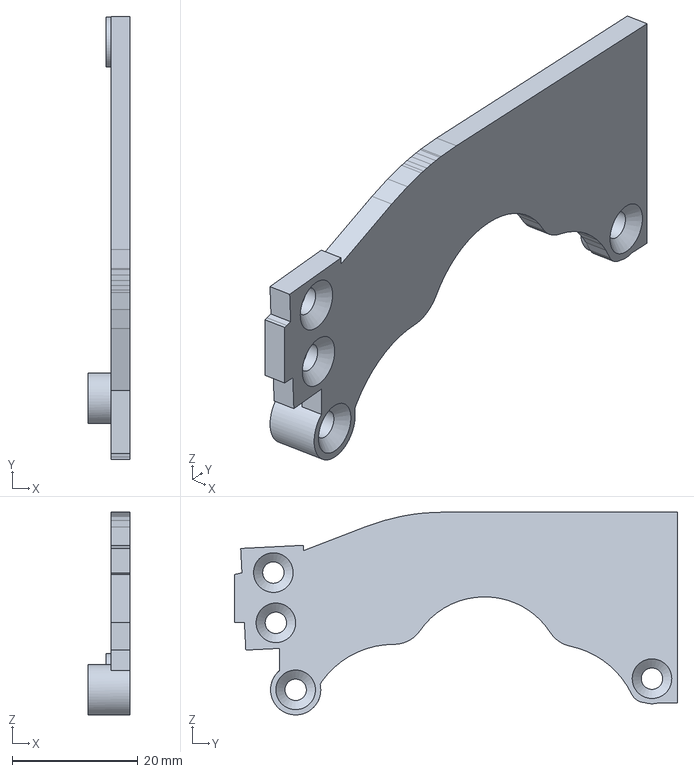
[picture p118: CAD file, 2026-10-11]
engineering/prototypes/nail/cad/nail_right_fixed_carrier.step
6.70 x 70.5 x 32.3 mm
