geyan21/yam-tactile-kit/engineering/prototypes/optical/provenance/assembly/mesh_diagnostics/o1_retained_gel_frame.unprocessed.stl

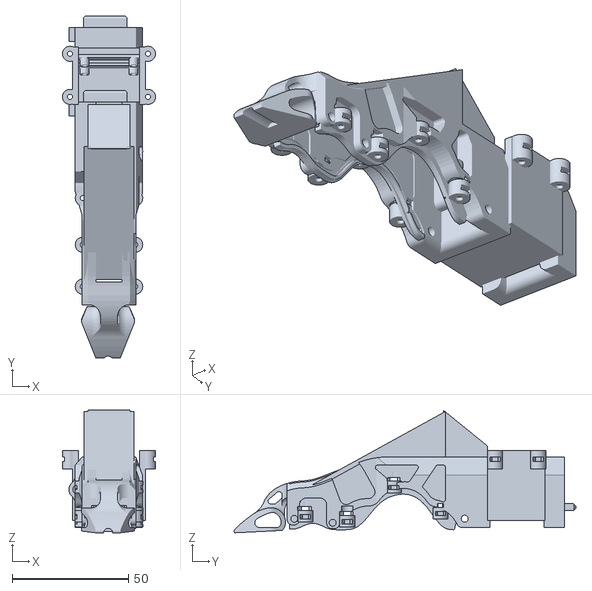
[picture p119: CAD file, 2026-10-12]
engineering/prototypes/optical/provenance/assembly/mesh_diagnostics/o1_retained_gel_frame.unprocessed.stl
40.0 x 146.9 x 52.7
