geyan21/yam-tactile-kit/engineering/prototypes/pneumatic/cad/p1_CP0_body_reference.step

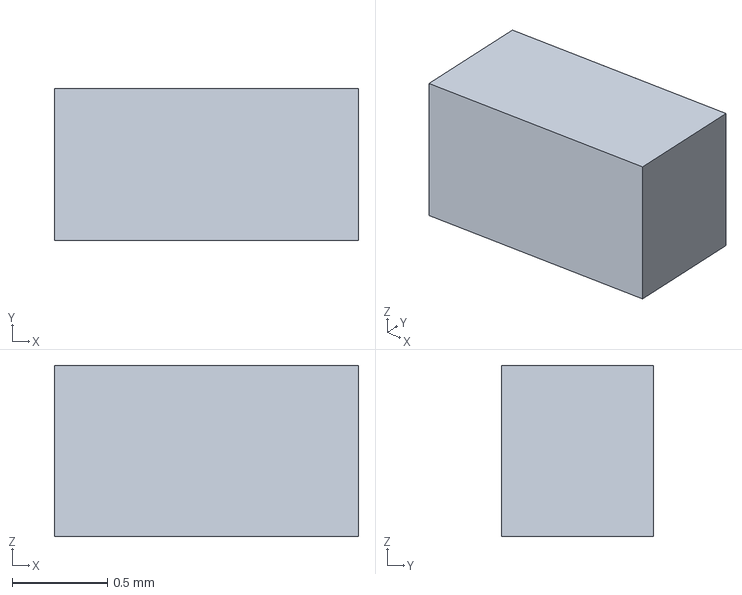
[picture p120: CAD file, 2026-10-12]
engineering/prototypes/pneumatic/cad/p1_CP0_body_reference.step
1.60 x 0.8 x 0.9 mm
