geyan21/yam-tactile-kit/engineering/prototypes/recessed/cad/recessed_pcb_fit_reference.step

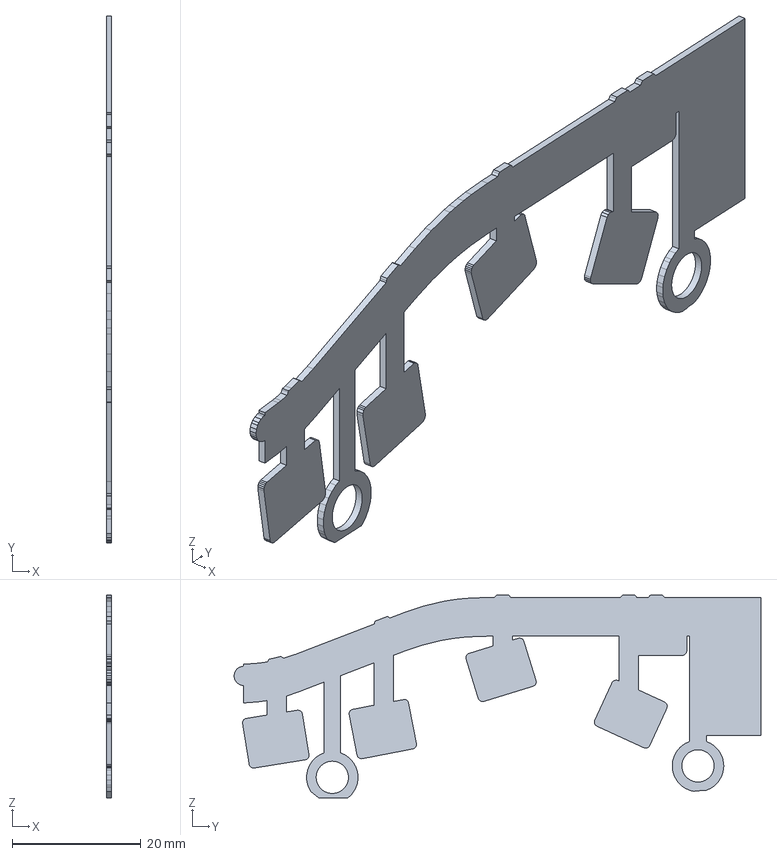
[picture p121: CAD file, 2026-10-11]
engineering/prototypes/recessed/cad/recessed_pcb_fit_reference.step
0.8 x 81.7 x 31.5 mm
