geyan21/yam-tactile-kit/engineering/release/b1/cad/b1_magnetic_tpu_insert.step

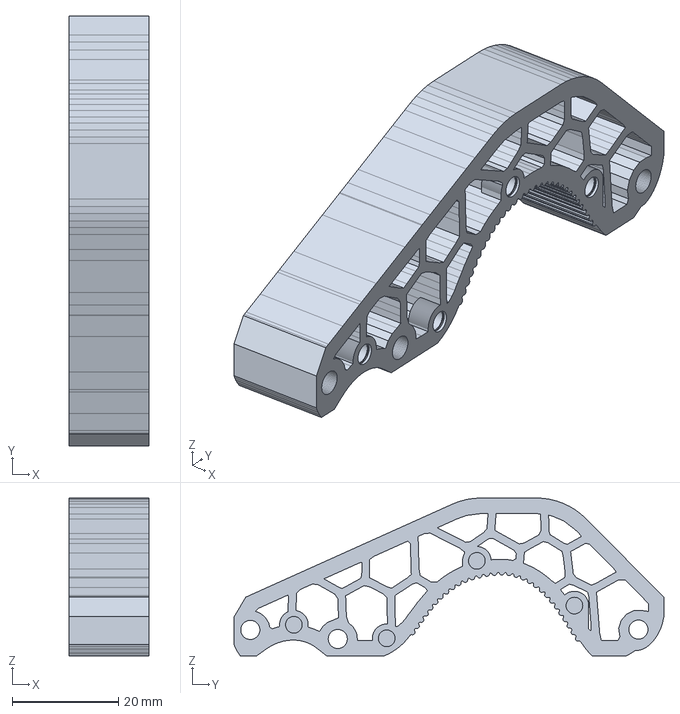
[picture p122: CAD file, 2026-10-10]
engineering/release/b1/cad/b1_magnetic_tpu_insert.step
15.0 x 81.0 x 29.8 mm
