geyan21/yam-tactile-kit/engineering/release/l1/cad/tal220b_reference.step

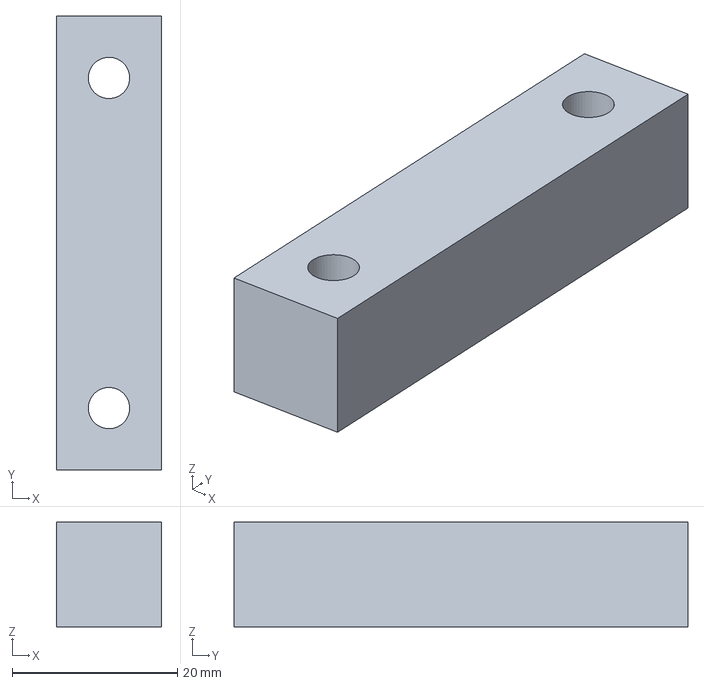
[picture p123: CAD file, 2026-10-10]
engineering/release/l1/cad/tal220b_reference.step
12.7 x 55.0 x 12.7 mm
