geyan21/yam-tactile-kit/engineering/concepts/cad/b2_pcb_fit_witness.step

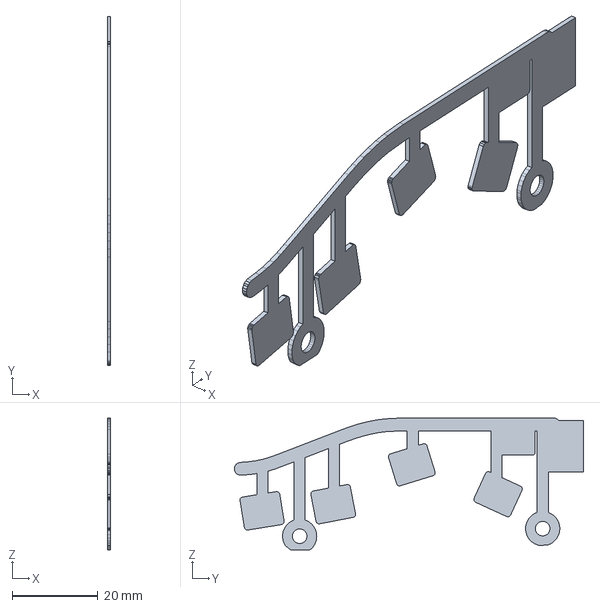
[picture p125: CAD file, 2026-10-10]
engineering/concepts/cad/b2_pcb_fit_witness.step
0.8 x 81.5 x 30.8 mm
