geyan21/yam-tactile-kit/engineering/development/capacitive/k1/cad/k1_ch4_post_sheet_flat.step

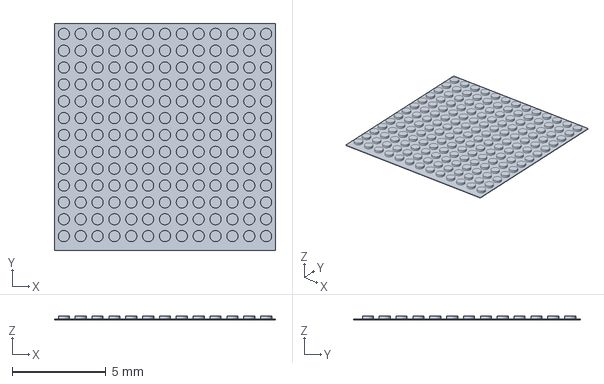
[picture p126: CAD file, 2026-10-11]
engineering/development/capacitive/k1/cad/k1_ch4_post_sheet_flat.step
11.8 x 12.1 x 0.2 mm
