geyan21/yam-tactile-kit/engineering/development/capacitive/k1/history/k1_ch4_rigid_saddle.step

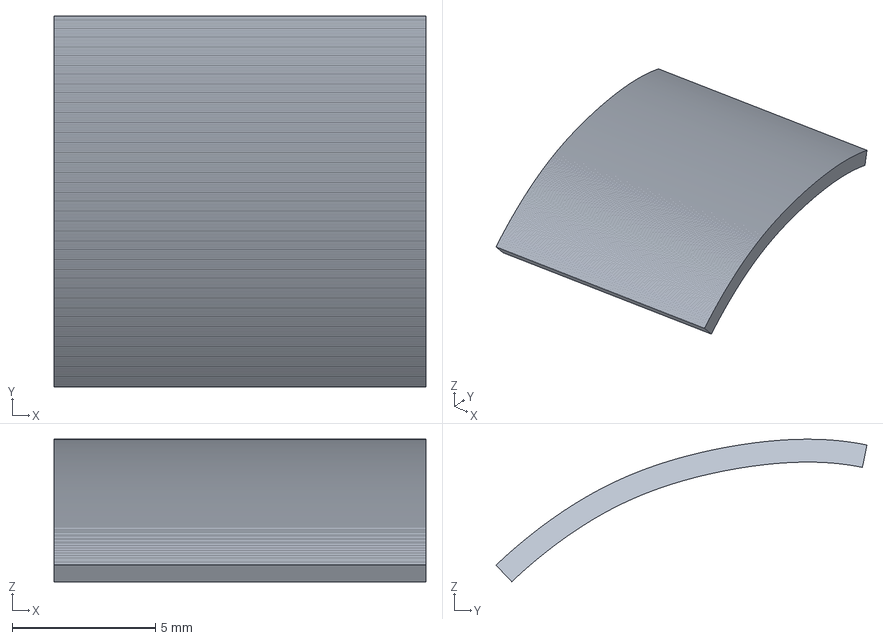
[picture p127: CAD file, 2026-10-11]
engineering/development/capacitive/k1/history/k1_ch4_rigid_saddle.step
13.0 x 13.0 x 4.98 mm
