geyan21/yam-tactile-kit/engineering/development/f1/mechanics/cad/f1_ch1_rows_fit_tail_reference.step

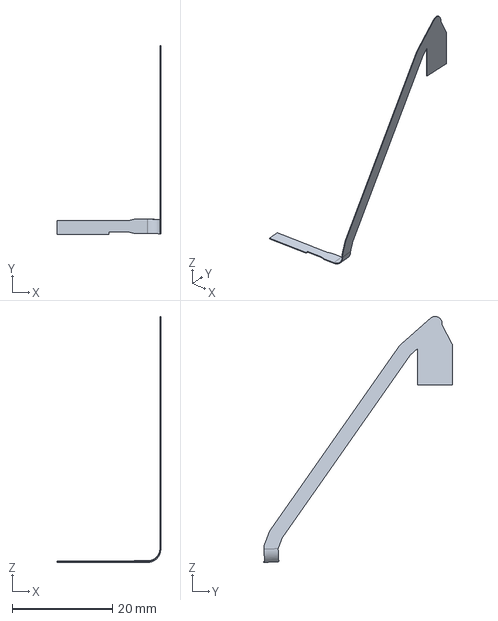
[picture p128: CAD file, 2026-10-11]
engineering/development/f1/mechanics/cad/f1_ch1_rows_fit_tail_reference.step
20.7 x 37.8 x 49.1 mm
