geyan21/yam-tactile-kit/engineering/development/f1/r3/cad/f1_ch0_rows_fit_tail_reference.step

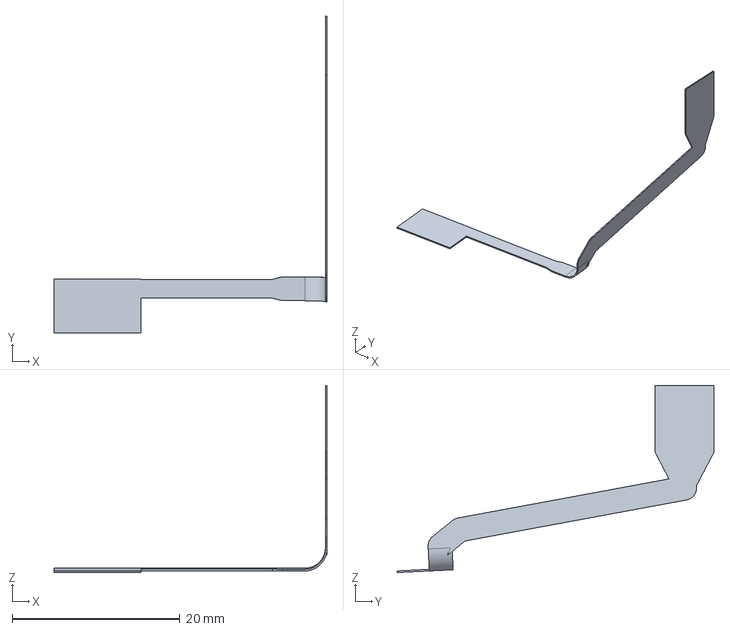
[picture p129: CAD file, 2026-10-11]
engineering/development/f1/r3/cad/f1_ch0_rows_fit_tail_reference.step
32.5 x 37.8 x 22.3 mm
