geyan21/yam-tactile-kit/engineering/prototypes/c1/cad/c1_floating_finger_carrier.step

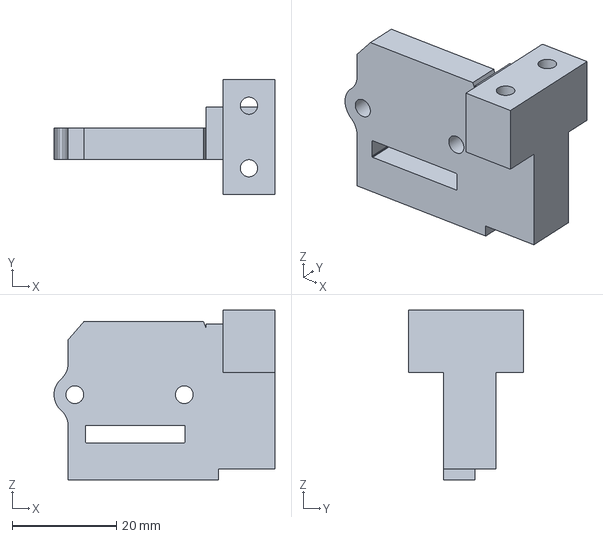
[picture p130: CAD file, 2026-10-11]
engineering/prototypes/c1/cad/c1_floating_finger_carrier.step
42.4 x 22.0 x 32.6 mm
