geyan21/yam-tactile-kit/engineering/prototypes/capacitive/cad/k1_reference_cover_bond_1.step

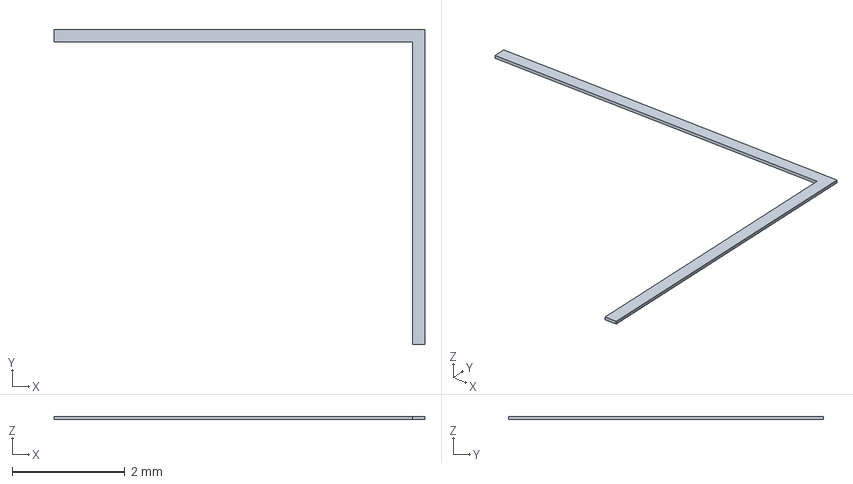
[picture p131: CAD file, 2026-10-11]
engineering/prototypes/capacitive/cad/k1_reference_cover_bond_1.step
6.57 x 5.57 x 0.05 mm
