geyan21/yam-tactile-kit/engineering/prototypes/nail/cad/nail_bare_sensing_fork.step

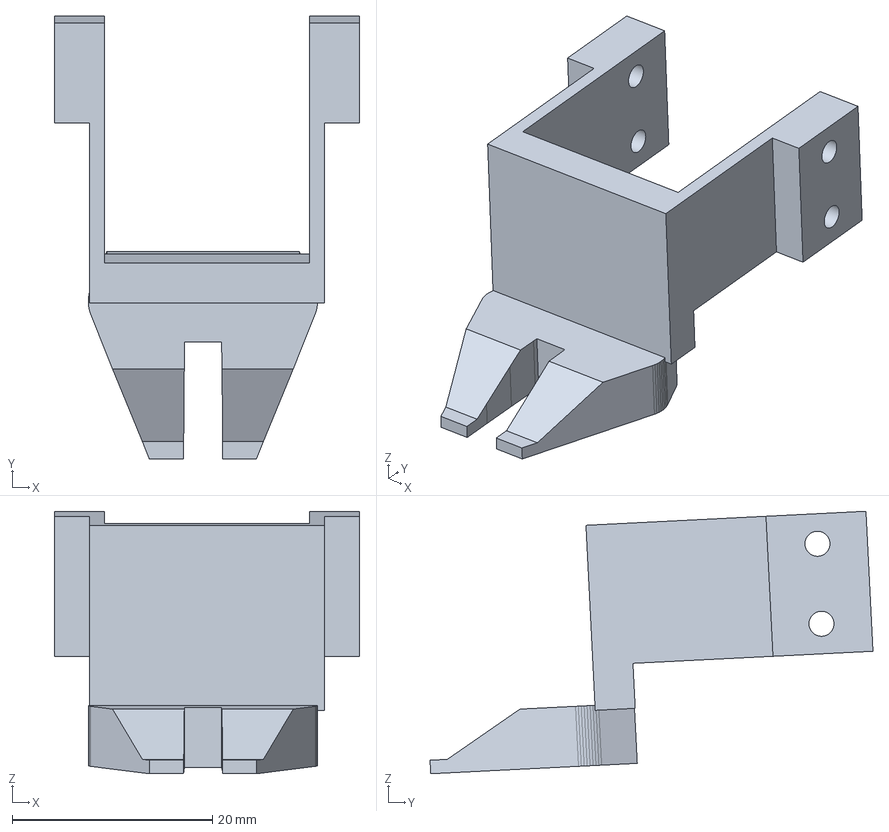
[picture p132: CAD file, 2026-10-11]
engineering/prototypes/nail/cad/nail_bare_sensing_fork.step
30.5 x 44.2 x 26.2 mm
