geyan21/yam-tactile-kit/engineering/prototypes/recessed/cad/recessed_locating_spacer_1.step

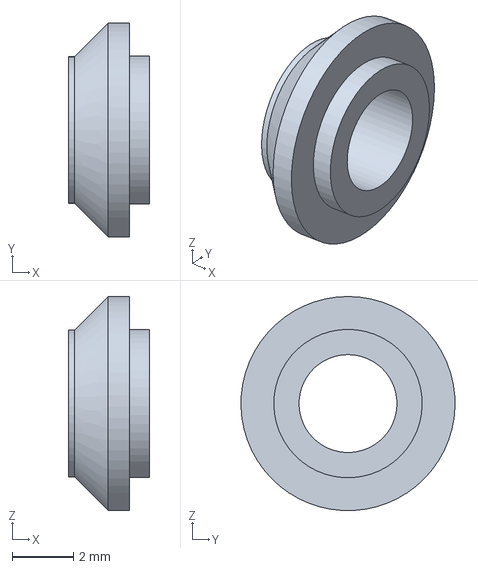
[picture p133: CAD file, 2026-10-11]
engineering/prototypes/recessed/cad/recessed_locating_spacer_1.step
2.65 x 7.00 x 7.00 mm
