geyan21/yam-tactile-kit/engineering/release/b1/cad/b1_magnet_reference.step

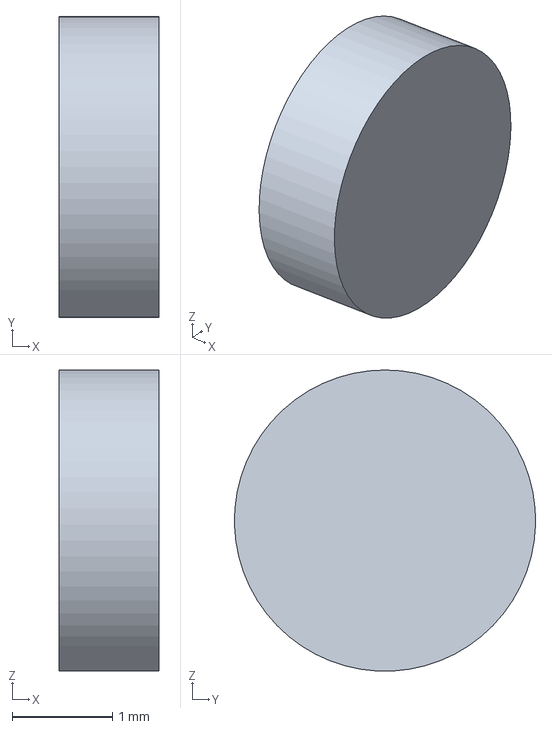
[picture p134: CAD file, 2026-10-10]
engineering/release/b1/cad/b1_magnet_reference.step
1.00 x 3.00 x 3.00 mm
