geyan21/yam-tactile-kit/engineering/release/l1/cad/l1_bench_live_spacer.step

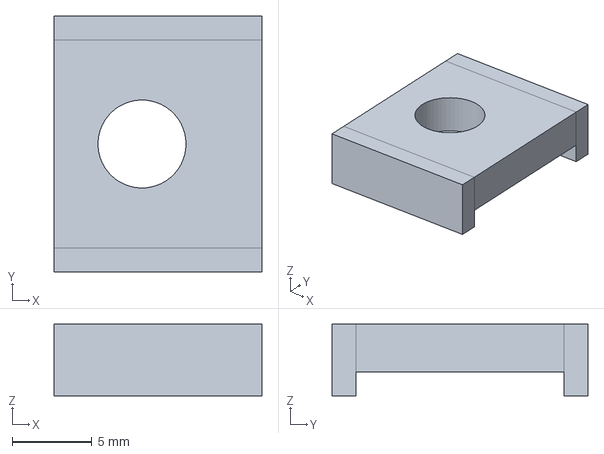
[picture p135: CAD file, 2026-10-10]
engineering/release/l1/cad/l1_bench_live_spacer.step
13.0 x 16.0 x 4.50 mm
