geyan21/yam-tactile-kit/engineering/release/r1/cad/coupon_mold_1p2.step

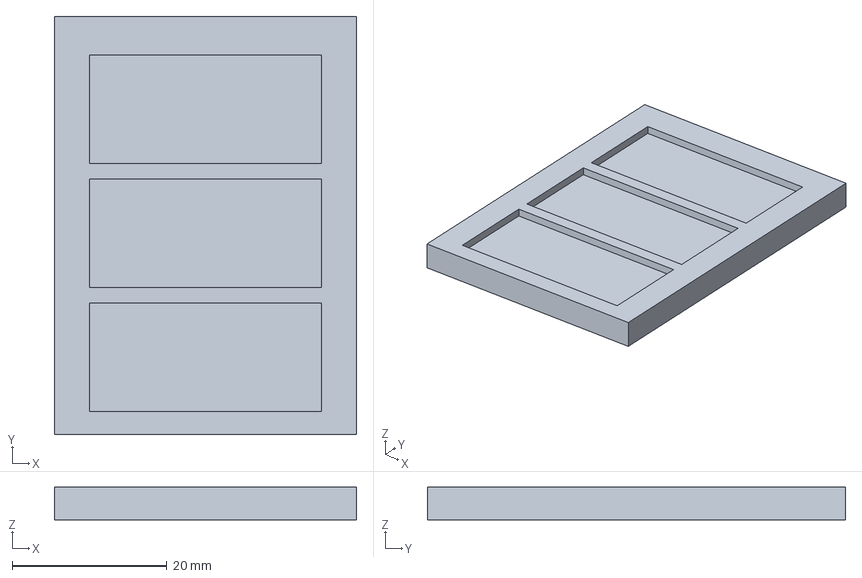
[picture p136: CAD file, 2026-10-10]
engineering/release/r1/cad/coupon_mold_1p2.step
39.0 x 54.0 x 4.20 mm
