geyan21/yam-tactile-kit/engineering/development/capacitive/k1/cad/k1_ch2_post_sheet_formed_reference.stl

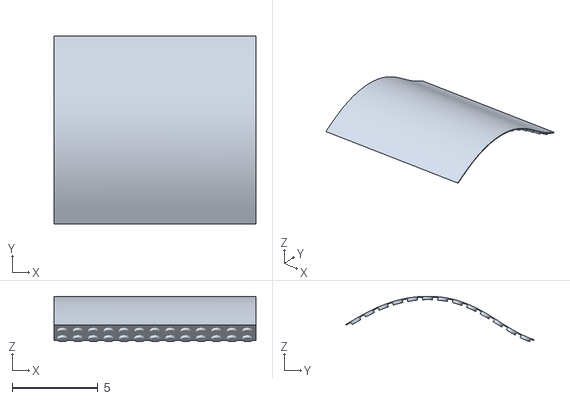
[picture p137: CAD file, 2026-10-11]
engineering/development/capacitive/k1/cad/k1_ch2_post_sheet_formed_reference.stl
11.8 x 11.0 x 2.66
