geyan21/yam-tactile-kit/engineering/development/capacitive/k1/history/k1_ch2_rigid_saddle.step

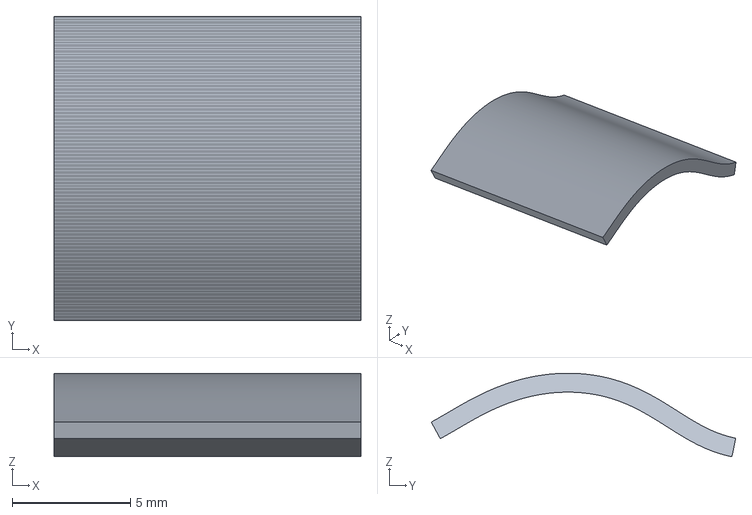
[picture p138: CAD file, 2026-10-11]
engineering/development/capacitive/k1/history/k1_ch2_rigid_saddle.step
13.0 x 12.9 x 3.53 mm
