geyan21/yam-tactile-kit/engineering/development/f1/mechanics/cad/f1_ch3_rows_body.stl

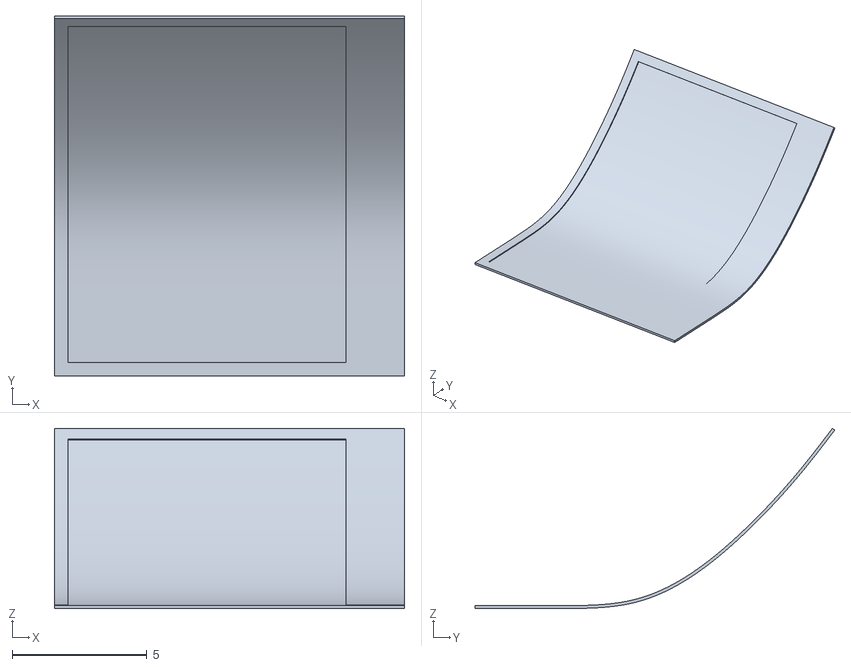
[picture p139: CAD file, 2026-10-11]
engineering/development/f1/mechanics/cad/f1_ch3_rows_body.stl
13.0 x 13.4 x 6.70
