geyan21/yam-tactile-kit/engineering/development/f1/r3/cad/f1_ch4_cover_body.stl

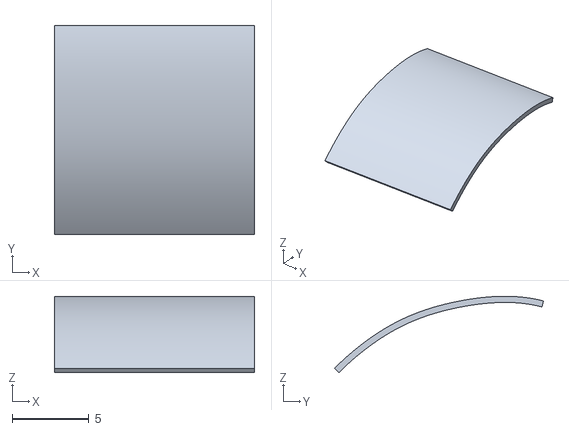
[picture p140: CAD file, 2026-10-11]
engineering/development/f1/r3/cad/f1_ch4_cover_body.stl
13.0 x 13.6 x 4.97
