geyan21/yam-tactile-kit/engineering/prototypes/b2/cad/b2_locating_spacer_1.step

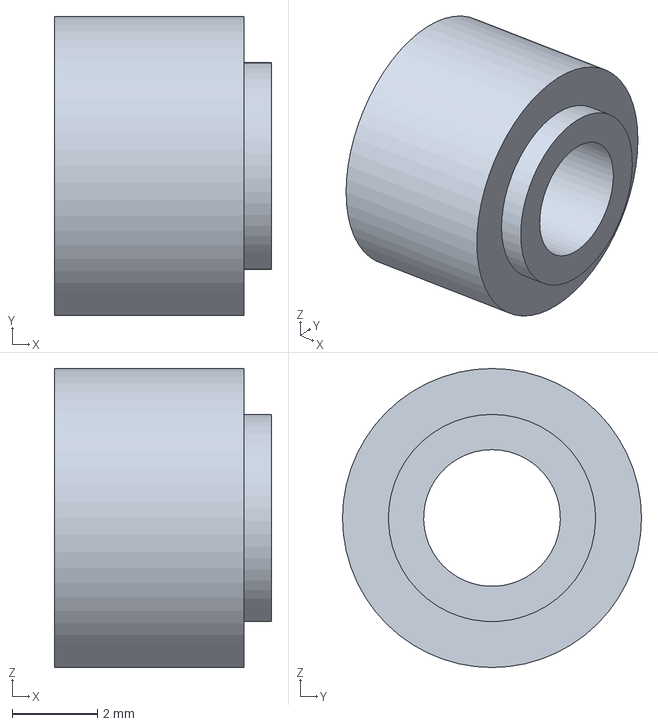
[picture p141: CAD file, 2026-10-10]
engineering/prototypes/b2/cad/b2_locating_spacer_1.step
5.09 x 7.00 x 7.00 mm
