geyan21/yam-tactile-kit/engineering/prototypes/c1/cad/c1_fixed_carrier_m3_clearance.step

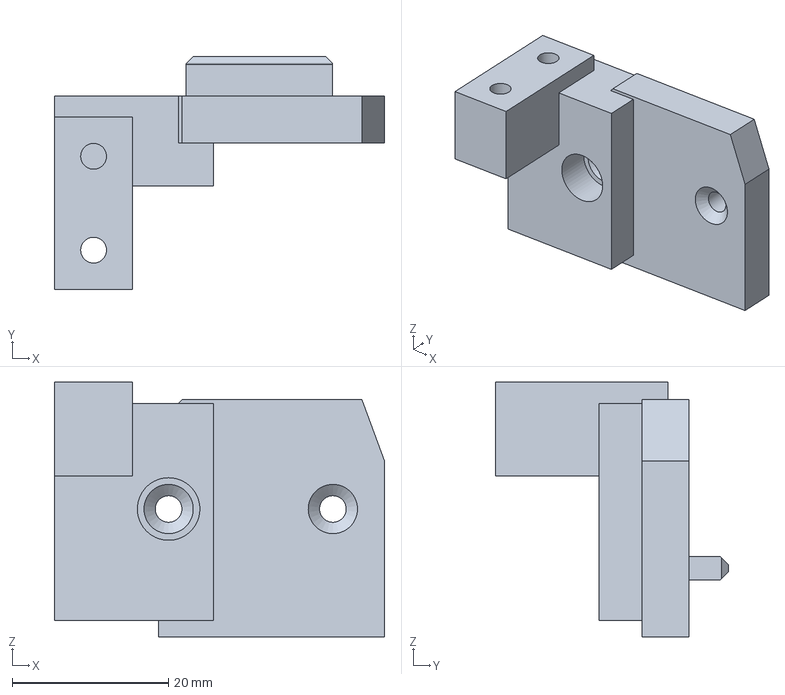
[picture p142: CAD file, 2026-10-11]
engineering/prototypes/c1/cad/c1_fixed_carrier_m3_clearance.step
42.2 x 29.7 x 32.6 mm
