geyan21/yam-tactile-kit/engineering/prototypes/capacitive/cad/k1_component_RP2.step

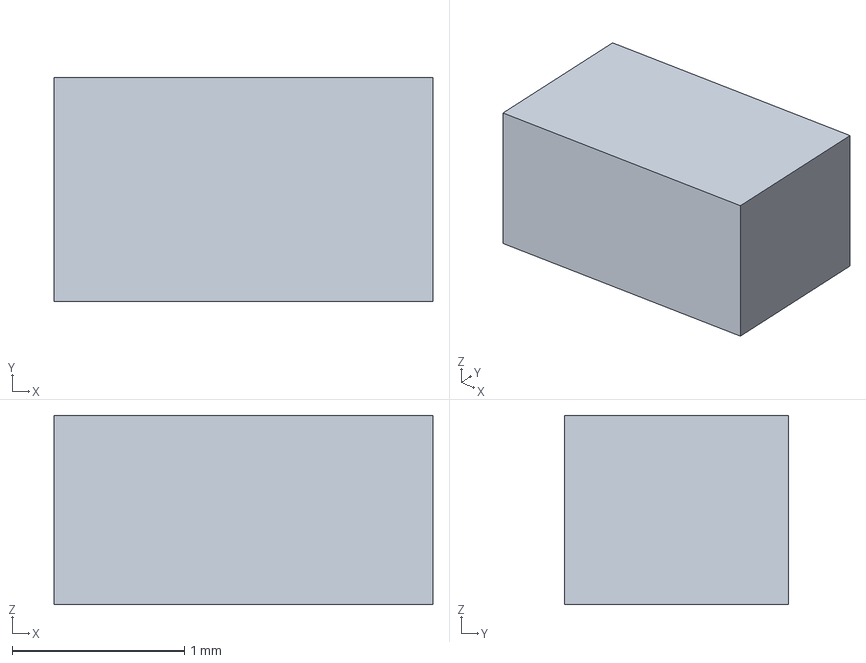
[picture p143: CAD file, 2026-10-11]
engineering/prototypes/capacitive/cad/k1_component_RP2.step
2.20 x 1.30 x 1.10 mm
