geyan21/yam-tactile-kit/engineering/prototypes/f1/cad/f1_ch1_foil_mount_bond.step

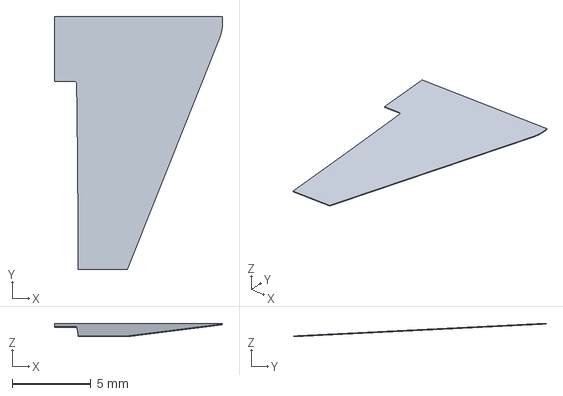
[picture p144: CAD file, 2026-10-12]
engineering/prototypes/f1/cad/f1_ch1_foil_mount_bond.step
10.7 x 16.1 x 0.856 mm
