geyan21/yam-tactile-kit/engineering/prototypes/force_button/cad/fb1_leaf_clamp_3_0.step

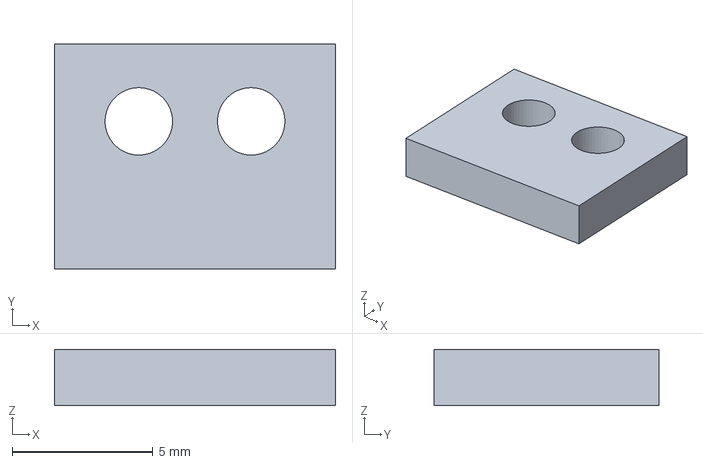
[picture p145: CAD file, 2026-10-11]
engineering/prototypes/force_button/cad/fb1_leaf_clamp_3_0.step
10.0 x 8.00 x 2.00 mm
