geyan21/yam-tactile-kit/engineering/prototypes/nail/cad/nail_revised_hard_frame.step

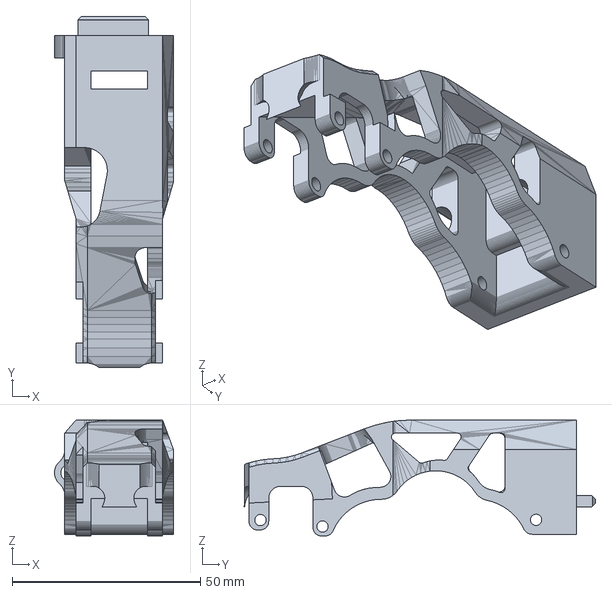
[picture p146: CAD file, 2026-10-11]
engineering/prototypes/nail/cad/nail_revised_hard_frame.step
31.6 x 93.2 x 30.8 mm
