geyan21/yam-tactile-kit/engineering/prototypes/optical/cad/o1_ch1_n0_laminate.step

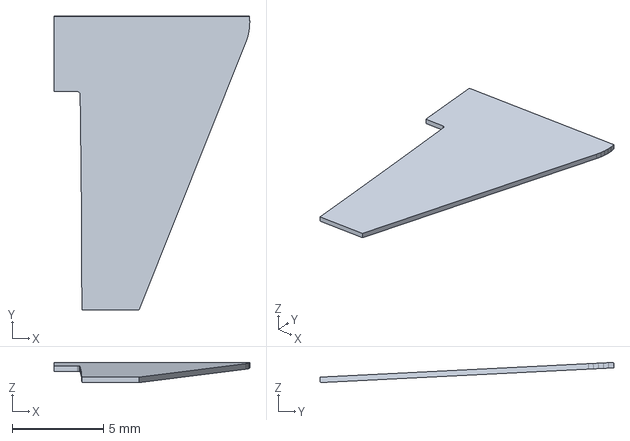
[picture p147: CAD file, 2026-10-12]
engineering/prototypes/optical/cad/o1_ch1_n0_laminate.step
10.7 x 16.1 x 1.11 mm
