geyan21/yam-tactile-kit/engineering/prototypes/recessed/cad/recessed_hard_frame.step

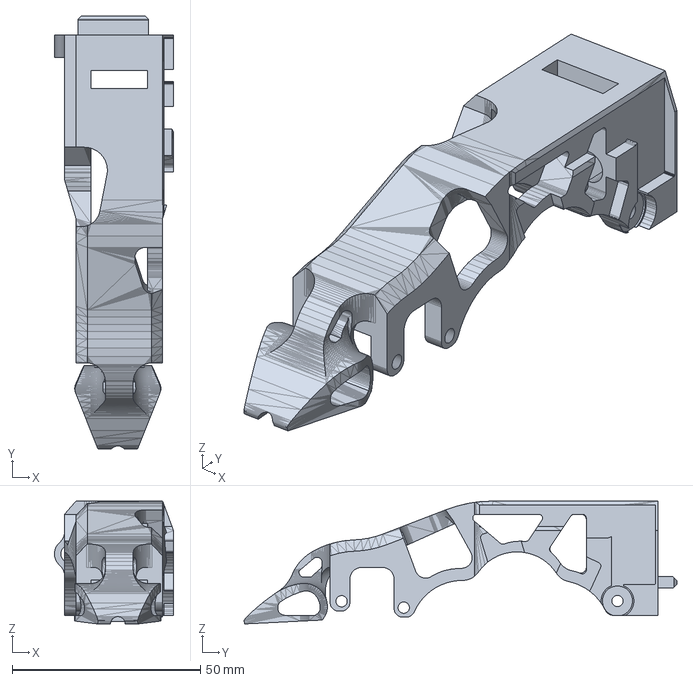
[picture p148: CAD file, 2026-10-11]
engineering/prototypes/recessed/cad/recessed_hard_frame.step
31.6 x 114.9 x 32.6 mm
