geyan21/yam-tactile-kit/engineering/release/b1/cad/b1_fixed_sensor_spine.step

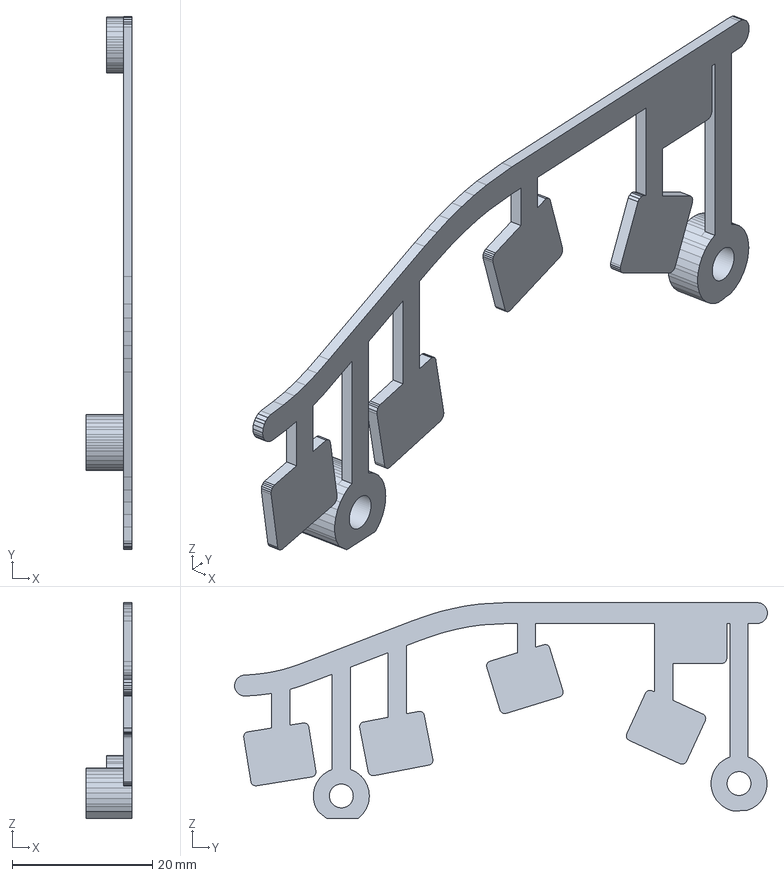
[picture p149: CAD file, 2026-10-10]
engineering/release/b1/cad/b1_fixed_sensor_spine.step
6.49 x 76.0 x 30.8 mm
