geyan21/yam-tactile-kit/engineering/release/l1/cad/l1_bench_fixed_shoe.step

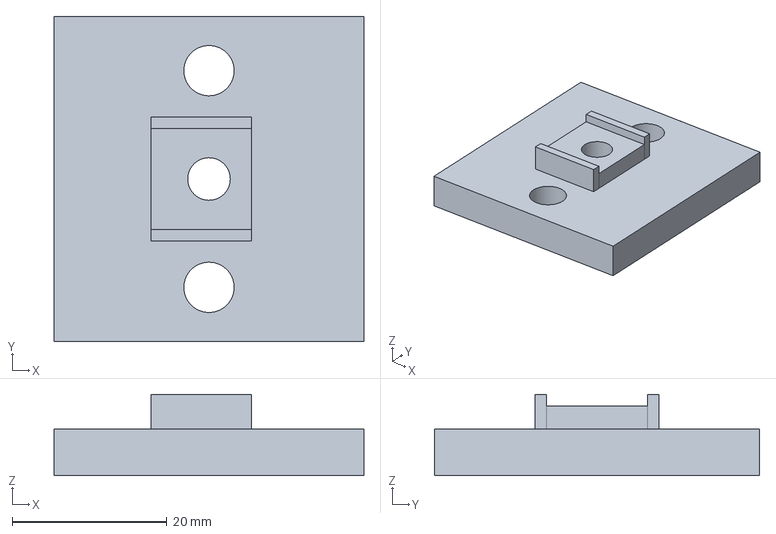
[picture p150: CAD file, 2026-10-10]
engineering/release/l1/cad/l1_bench_fixed_shoe.step
40.0 x 42.0 x 10.5 mm
