geyan21/yam-tactile-kit/engineering/release/r1/cad/nail_cover_mold.step

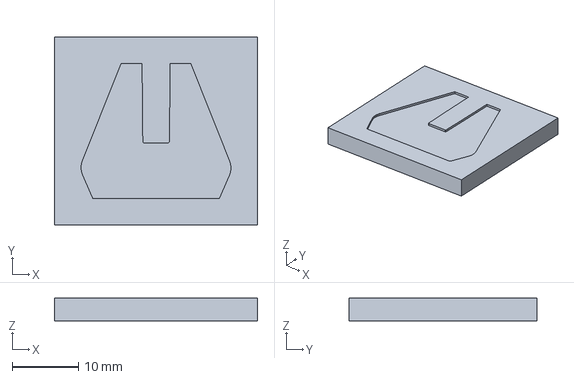
[picture p151: CAD file, 2026-10-10]
engineering/release/r1/cad/nail_cover_mold.step
30.6 x 28.4 x 3.40 mm
