geyan21/yam-tactile-kit/engineering/development/capacitive/k1/cad/k1_ch5_post_sheet_formed_reference.stl

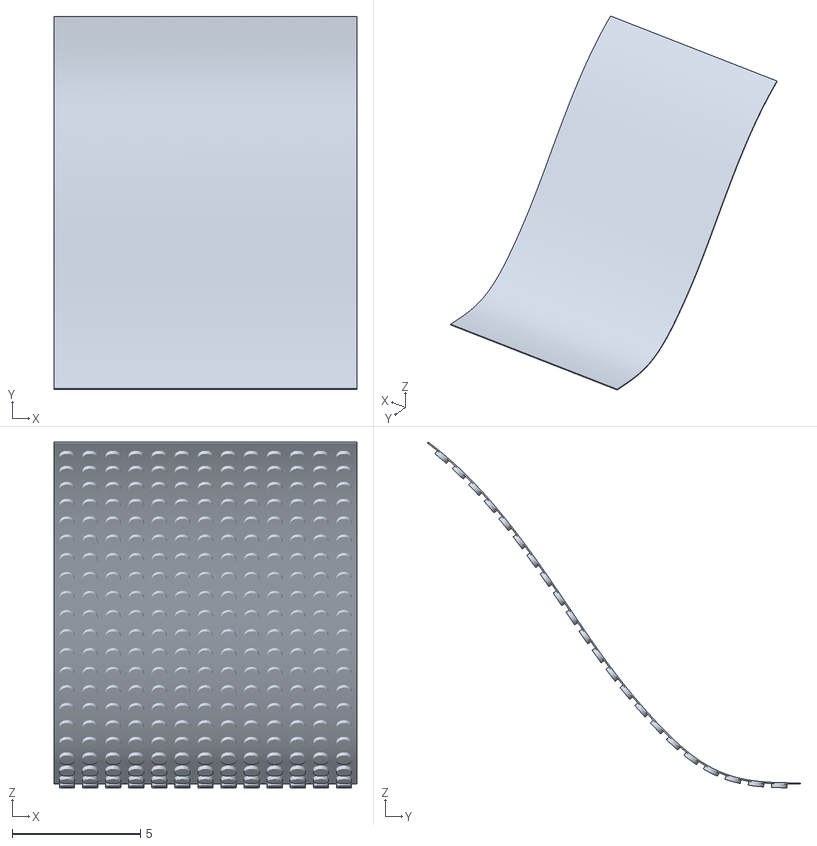
[picture p152: CAD file, 2026-10-11]
engineering/development/capacitive/k1/cad/k1_ch5_post_sheet_formed_reference.stl
11.8 x 14.5 x 13.5
