geyan21/yam-tactile-kit/engineering/development/capacitive/k1/history/k1_ch5_rigid_saddle.step

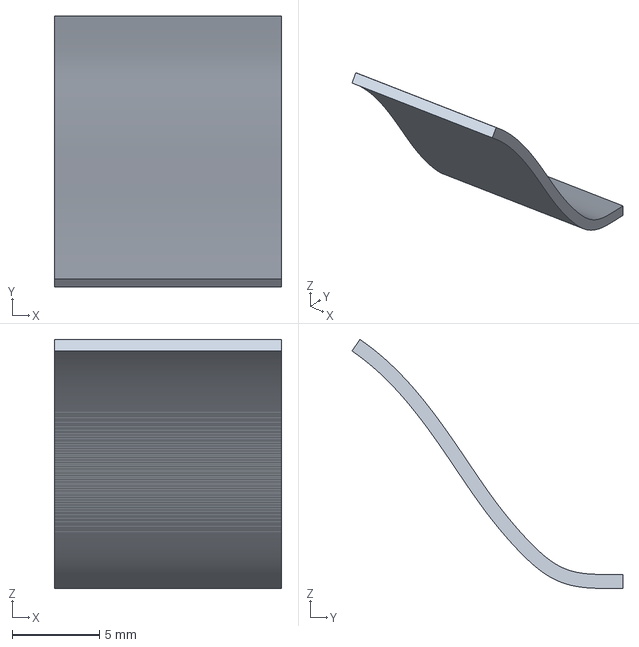
[picture p153: CAD file, 2026-10-11]
engineering/development/capacitive/k1/history/k1_ch5_rigid_saddle.step
13.0 x 15.5 x 14.2 mm
