geyan21/yam-tactile-kit/engineering/development/f1/mechanics/cad/f1_ch5_film_body.step

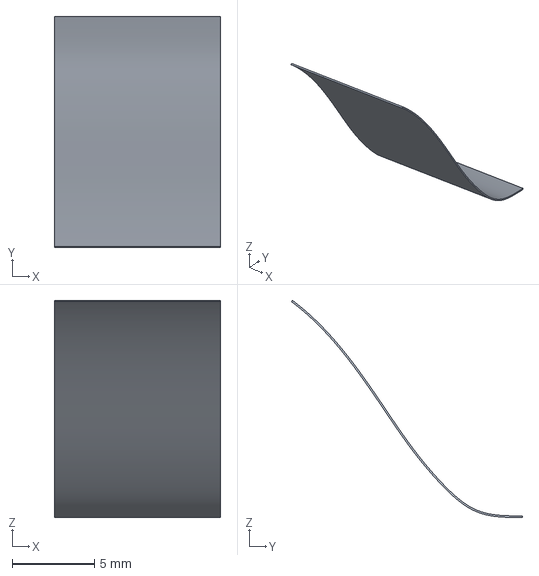
[picture p154: CAD file, 2026-10-11]
engineering/development/f1/mechanics/cad/f1_ch5_film_body.step
10.1 x 14.0 x 13.2 mm
