geyan21/yam-tactile-kit/engineering/development/f1/r3/cad/f1_ch2_rows_body.step

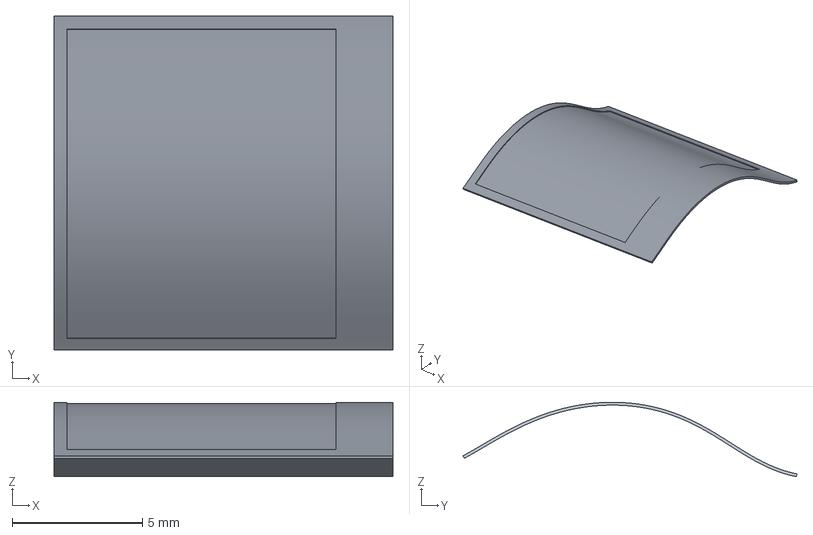
[picture p155: CAD file, 2026-10-11]
engineering/development/f1/r3/cad/f1_ch2_rows_body.step
13.0 x 12.8 x 2.86 mm
