geyan21/yam-tactile-kit/engineering/prototypes/b2/cad/b2_locating_spacer_2.step

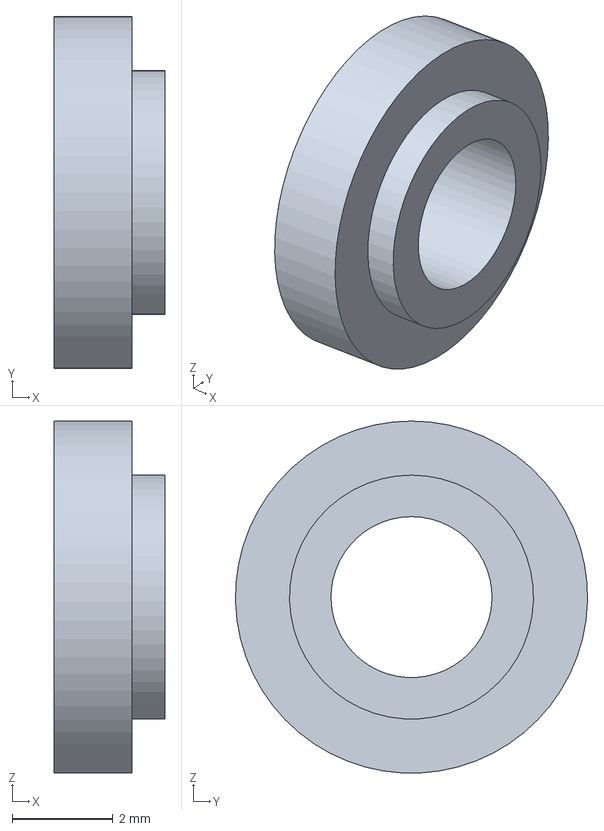
[picture p156: CAD file, 2026-10-10]
engineering/prototypes/b2/cad/b2_locating_spacer_2.step
2.20 x 7.00 x 7.00 mm
