geyan21/yam-tactile-kit/engineering/prototypes/c1/cad/c1_grid_alignment_stencil.step

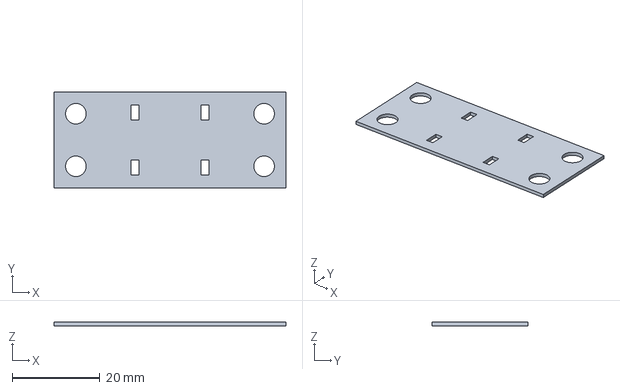
[picture p157: CAD file, 2026-10-11]
engineering/prototypes/c1/cad/c1_grid_alignment_stencil.step
53.0 x 22.0 x 0.8 mm
