geyan21/yam-tactile-kit/engineering/prototypes/capacitive/cad/k1_ch4_cover_bond_2.step

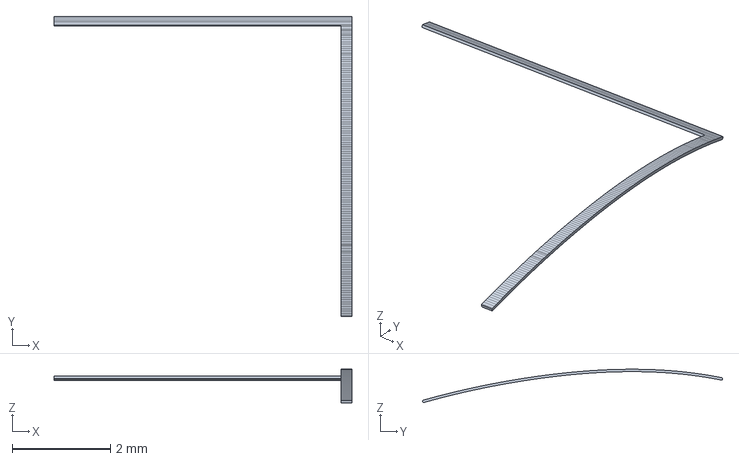
[picture p158: CAD file, 2026-10-11]
engineering/prototypes/capacitive/cad/k1_ch4_cover_bond_2.step
6.07 x 6.12 x 0.684 mm
