geyan21/yam-tactile-kit/engineering/prototypes/f1/cad/f1_ch0_cover_foot_bond_0.step

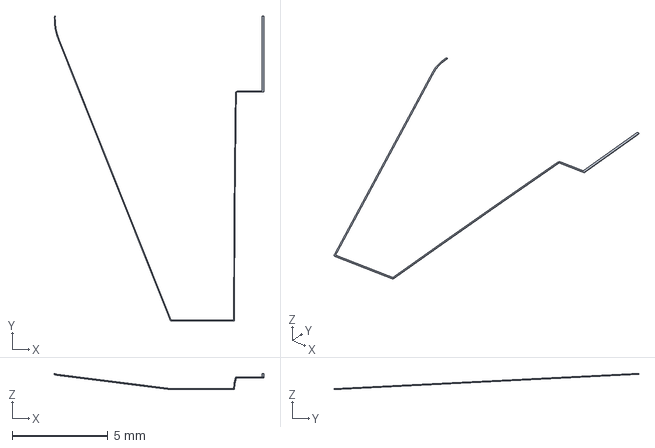
[picture p159: CAD file, 2026-10-12]
engineering/prototypes/f1/cad/f1_ch0_cover_foot_bond_0.step
10.9 x 15.9 x 0.848 mm
