geyan21/yam-tactile-kit/engineering/prototypes/force_button/cad/fb1_sensor_backing_clamp.step

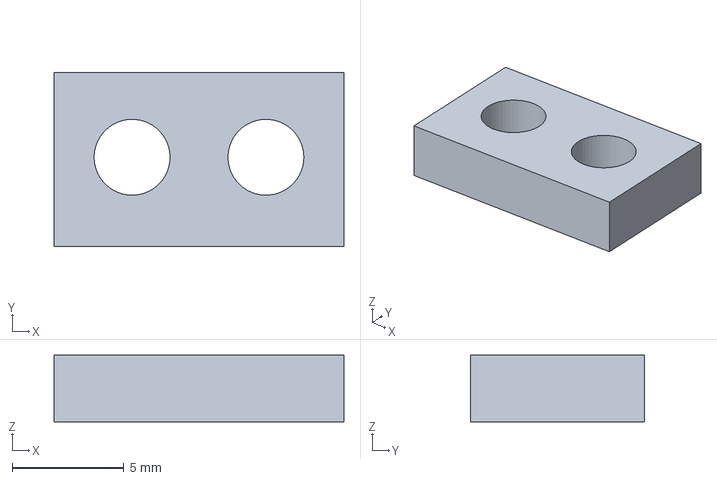
[picture p160: CAD file, 2026-10-11]
engineering/prototypes/force_button/cad/fb1_sensor_backing_clamp.step
13.0 x 7.80 x 3.00 mm
