geyan21/yam-tactile-kit/engineering/prototypes/nail/cad/nail_left_fixed_carrier.step

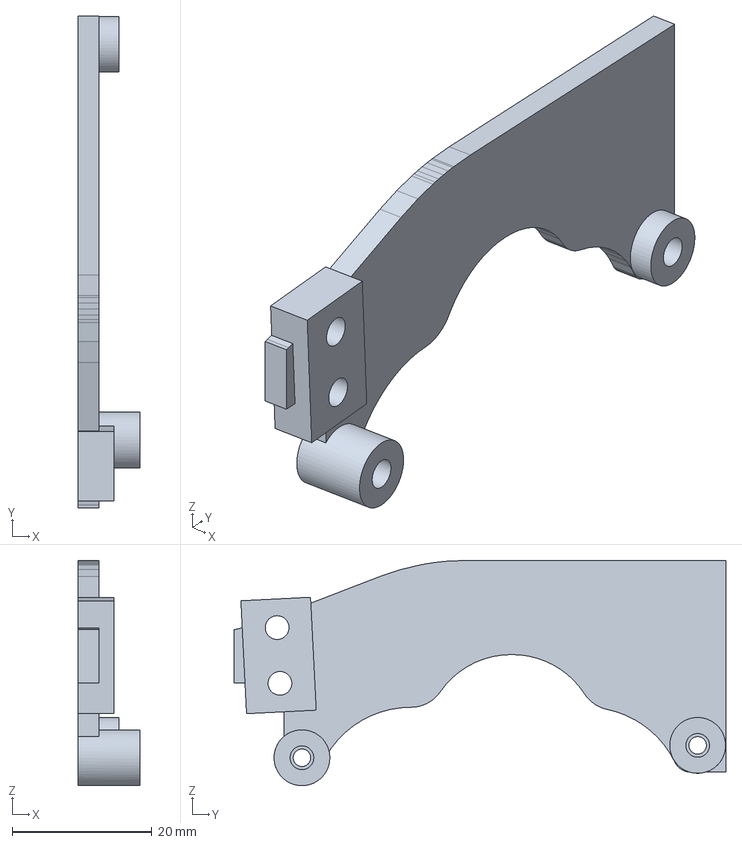
[picture p161: CAD file, 2026-10-11]
engineering/prototypes/nail/cad/nail_left_fixed_carrier.step
8.90 x 70.5 x 32.3 mm
