geyan21/yam-tactile-kit/engineering/prototypes/pneumatic/cad/p1_JP2_body_reference.step

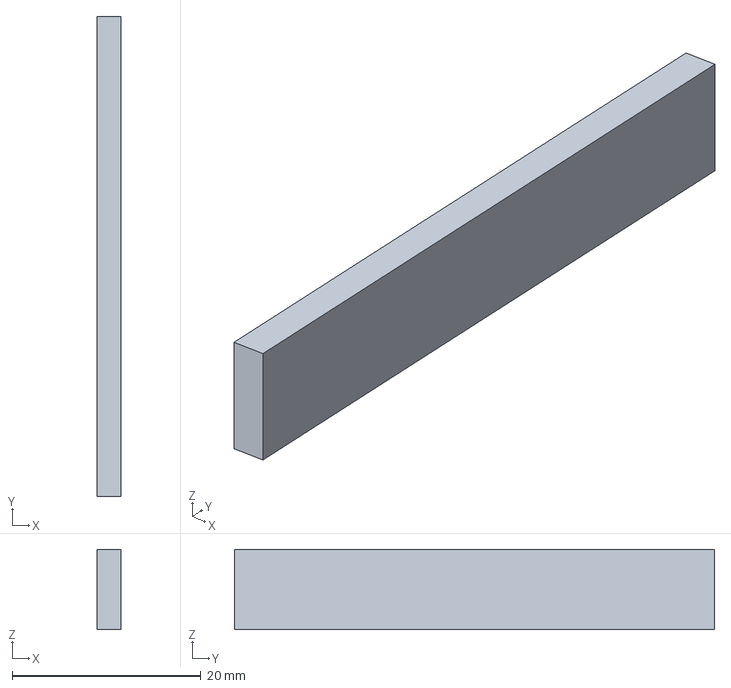
[picture p162: CAD file, 2026-10-12]
engineering/prototypes/pneumatic/cad/p1_JP2_body_reference.step
2.54 x 50.8 x 8.50 mm
