geyan21/yam-tactile-kit/engineering/release/b1/cad/b1_flush_magnet_plug.step

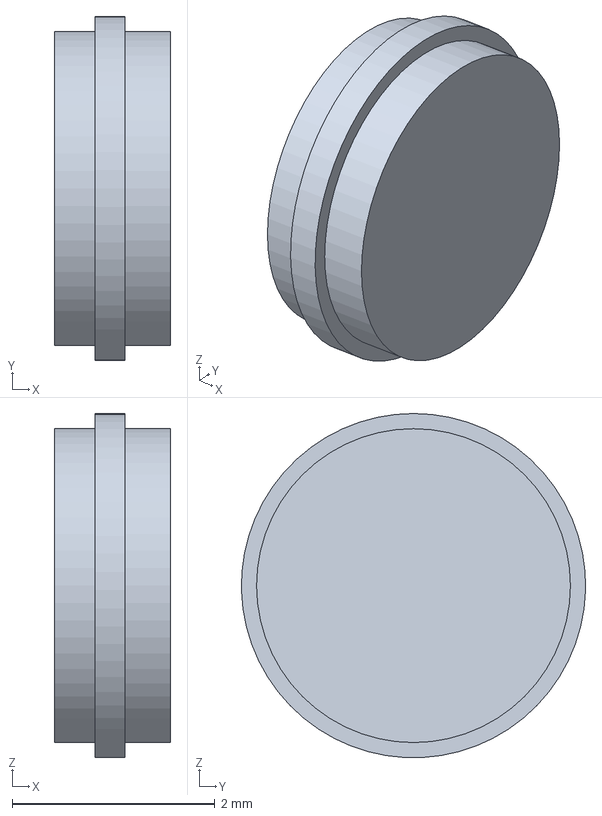
[picture p163: CAD file, 2026-10-10]
engineering/release/b1/cad/b1_flush_magnet_plug.step
1.15 x 3.40 x 3.40 mm
