geyan21/yam-tactile-kit/engineering/release/l1/cad/l1_fixed_carrier_m3_clearance.step

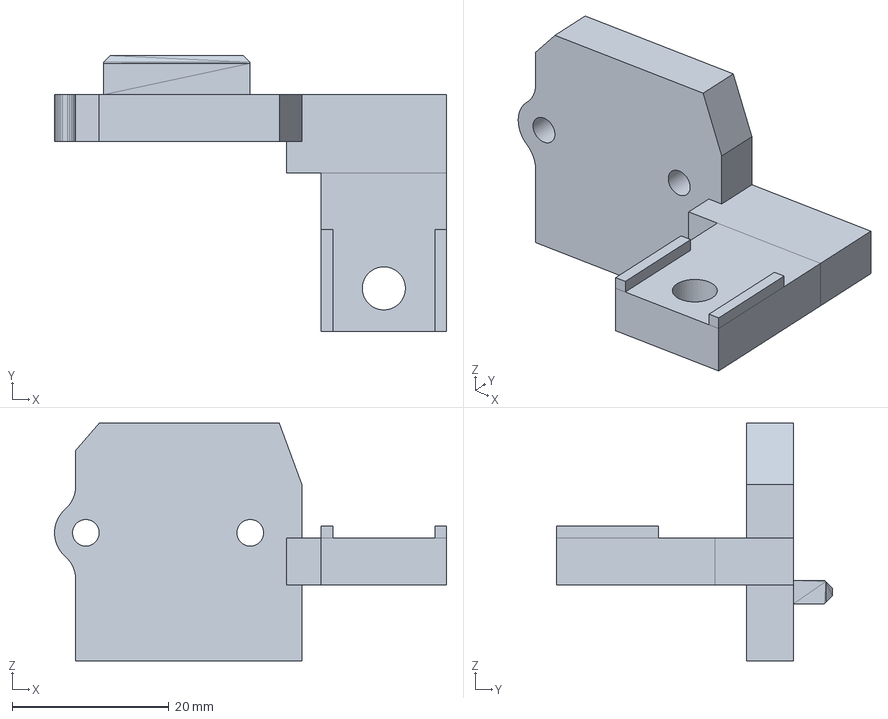
[picture p164: CAD file, 2026-10-10]
engineering/release/l1/cad/l1_fixed_carrier_m3_clearance.step
50.1 x 35.2 x 30.3 mm
