geyan21/yam-tactile-kit/engineering/release/r1/cad/pad_3_saddle_witness.step

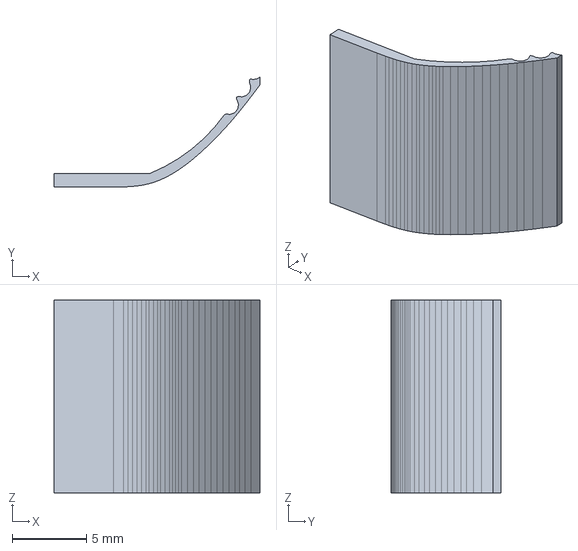
[picture p165: CAD file, 2026-10-10]
engineering/release/r1/cad/pad_3_saddle_witness.step
13.9 x 7.45 x 13.0 mm
