geyan21/yam-tactile-kit/engineering/development/capacitive/k1/cad/k1_ch0_post_sheet_flat.step

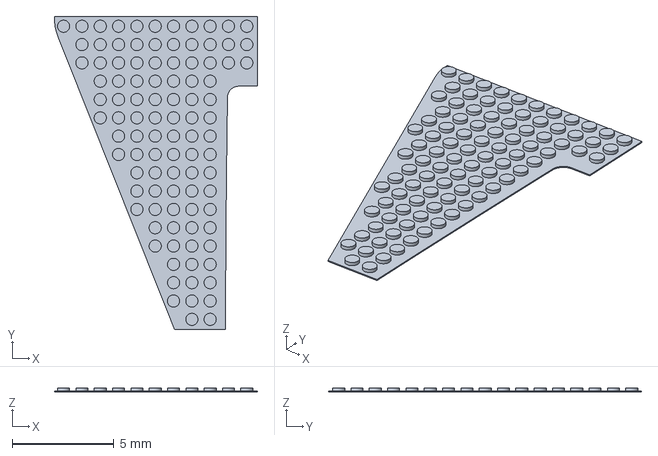
[picture p166: CAD file, 2026-10-11]
engineering/development/capacitive/k1/cad/k1_ch0_post_sheet_flat.step
9.98 x 15.4 x 0.2 mm
