geyan21/yam-tactile-kit/engineering/development/f1/mechanics/cad/f1_r2_pcb_fit_reference.step

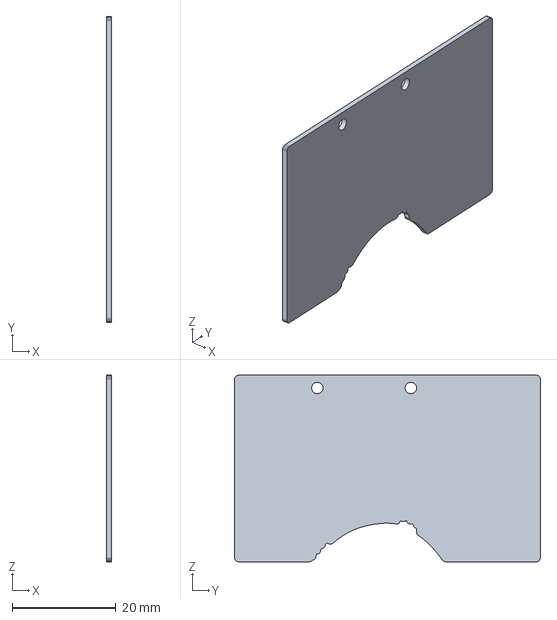
[picture p167: CAD file, 2026-10-11]
engineering/development/f1/mechanics/cad/f1_r2_pcb_fit_reference.step
1.00 x 58.9 x 35.9 mm
