geyan21/yam-tactile-kit/engineering/prototypes/c1/cad/c1_bench_receiver.step

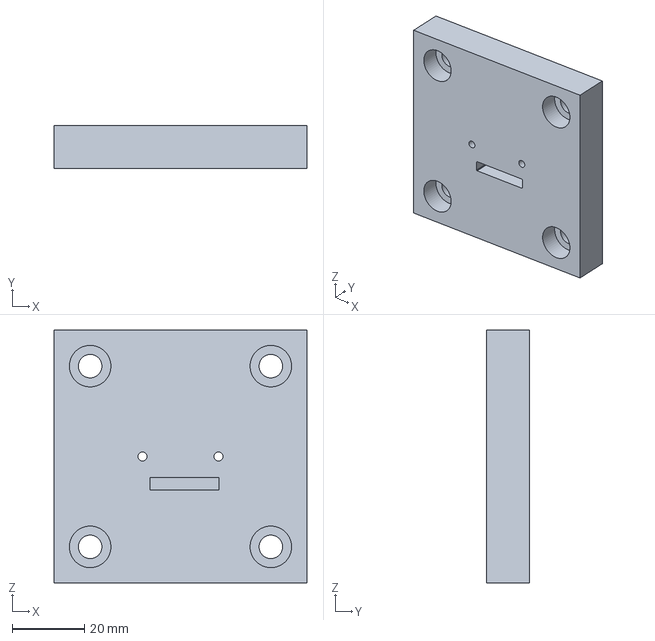
[picture p168: CAD file, 2026-10-11]
engineering/prototypes/c1/cad/c1_bench_receiver.step
70.0 x 12.0 x 70.0 mm
