geyan21/yam-tactile-kit/engineering/prototypes/capacitive/cad/k1_ch4_stop_3_bond.step

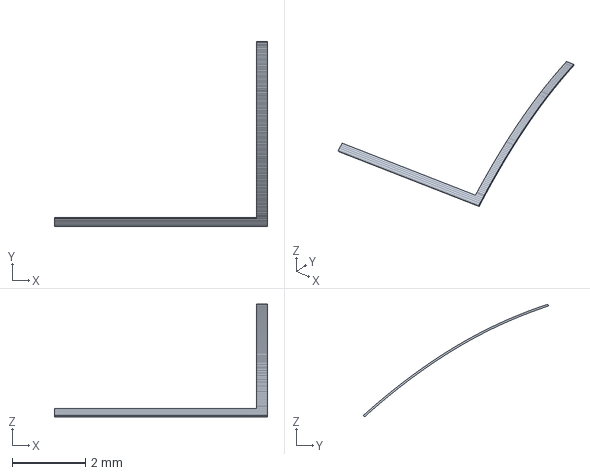
[picture p169: CAD file, 2026-10-11]
engineering/prototypes/capacitive/cad/k1_ch4_stop_3_bond.step
5.80 x 5.04 x 3.07 mm
