geyan21/yam-tactile-kit/engineering/prototypes/force_button/cad/fb1_stop_locknut_0_reference.step

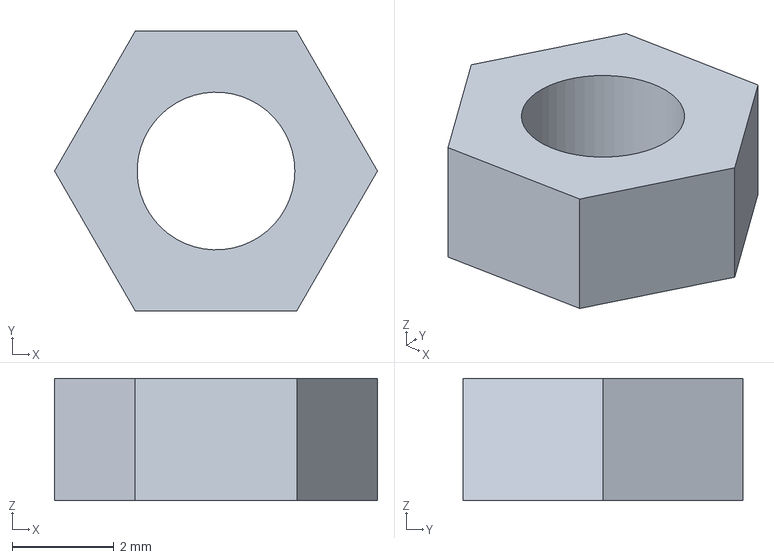
[picture p170: CAD file, 2026-10-11]
engineering/prototypes/force_button/cad/fb1_stop_locknut_0_reference.step
6.35 x 5.50 x 2.40 mm
