geyan21/yam-tactile-kit/engineering/prototypes/optical/cad/o1_R3_body_reference.step

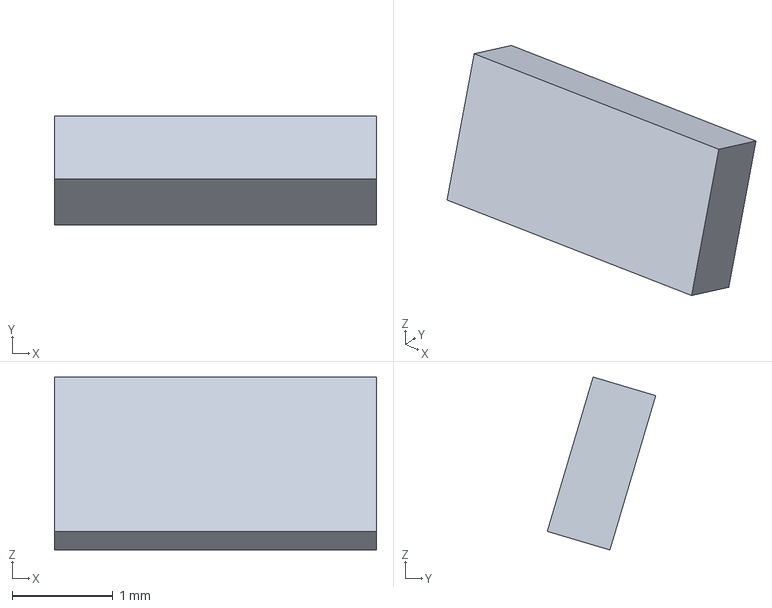
[picture p171: CAD file, 2026-10-12]
engineering/prototypes/optical/cad/o1_R3_body_reference.step
3.20 x 1.08 x 1.72 mm
