geyan21/yam-tactile-kit/engineering/release/b1/cad/b1_sensor_pcb_reference.step

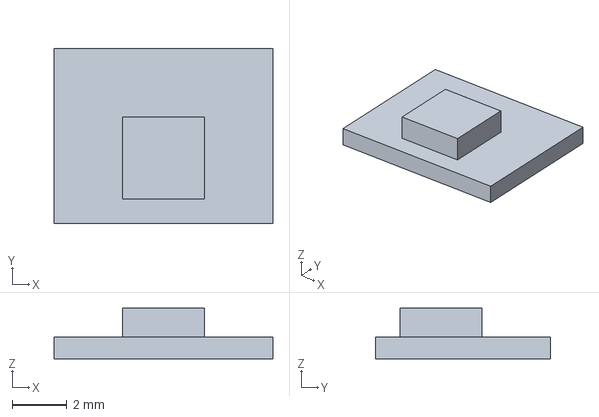
[picture p172: CAD file, 2026-10-10]
engineering/release/b1/cad/b1_sensor_pcb_reference.step
8.00 x 6.40 x 1.85 mm
