geyan21/yam-tactile-kit/engineering/release/l1/cad/l1_floating_finger_carrier.step

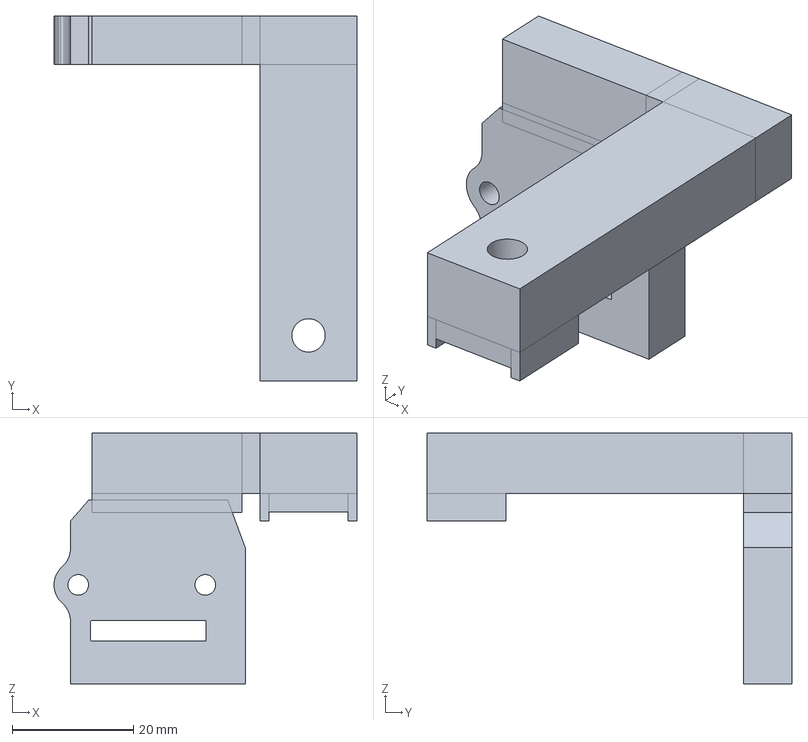
[picture p173: CAD file, 2026-10-10]
engineering/release/l1/cad/l1_floating_finger_carrier.step
50.1 x 60.2 x 41.4 mm
