geyan21/yam-tactile-kit/engineering/release/r1/cad/pad_2_saddle_mold.step

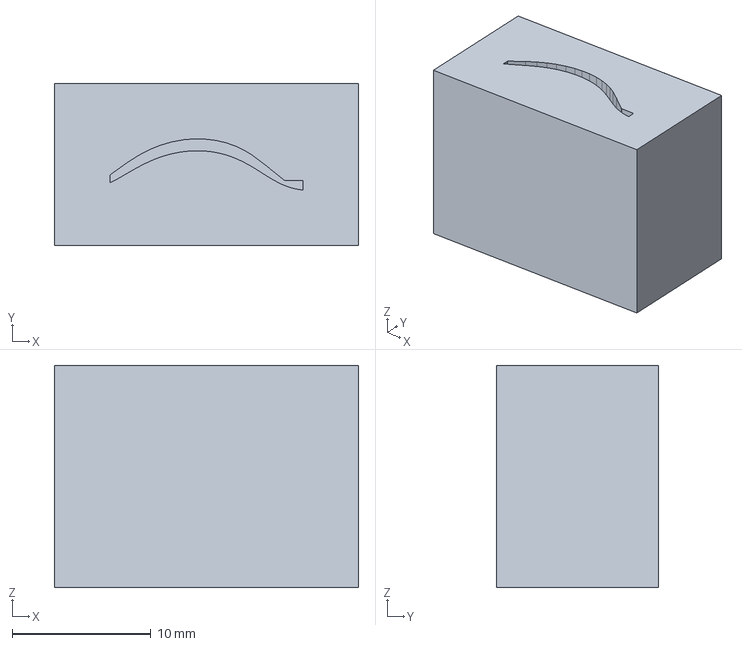
[picture p174: CAD file, 2026-10-10]
engineering/release/r1/cad/pad_2_saddle_mold.step
21.9 x 11.7 x 16.0 mm
