geyan21/yam-tactile-kit/engineering/development/capacitive/k1/cad/k1_ch2_cover_reference.step

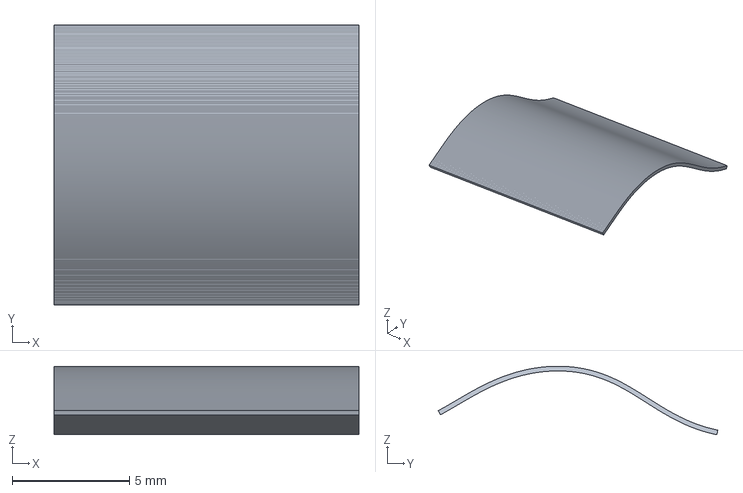
[picture p175: CAD file, 2026-10-11]
engineering/development/capacitive/k1/cad/k1_ch2_cover_reference.step
13.0 x 11.9 x 2.92 mm
