geyan21/yam-tactile-kit/engineering/prototypes/c1/cad/c1_fixed_end_clamp.step

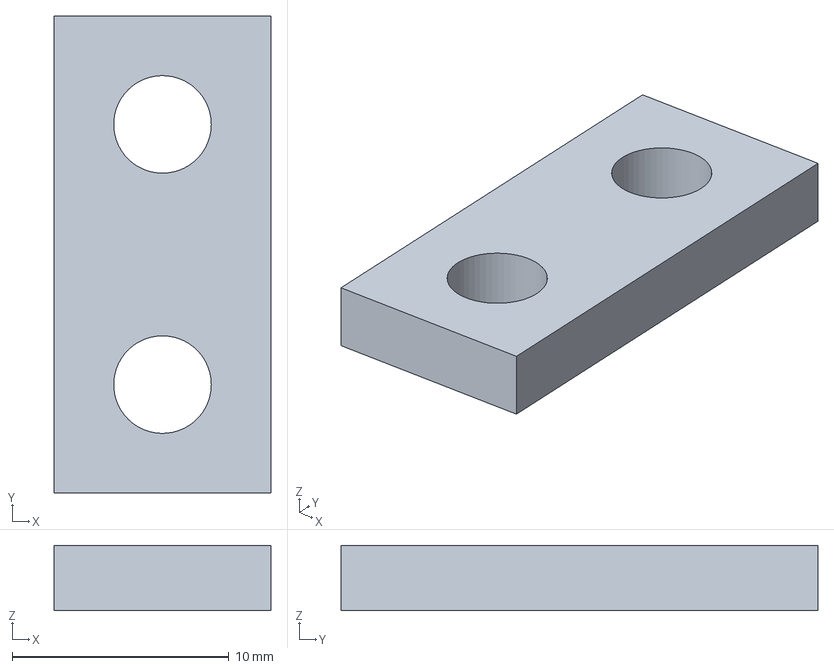
[picture p176: CAD file, 2026-10-11]
engineering/prototypes/c1/cad/c1_fixed_end_clamp.step
10.00 x 22.0 x 3.00 mm
