geyan21/yam-tactile-kit/engineering/prototypes/capacitive/cad/k1_ch2_joint_1.step

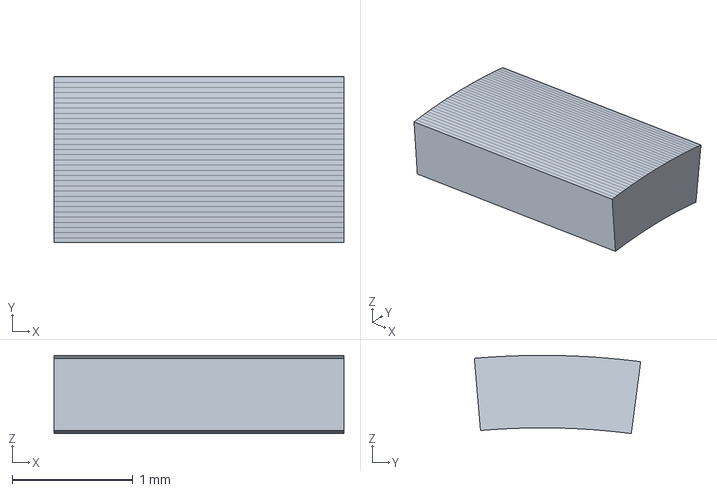
[picture p177: CAD file, 2026-10-11]
engineering/prototypes/capacitive/cad/k1_ch2_joint_1.step
2.40 x 1.38 x 0.647 mm
