geyan21/yam-tactile-kit/engineering/release/l1/cad/l1_cross_test_arm.step

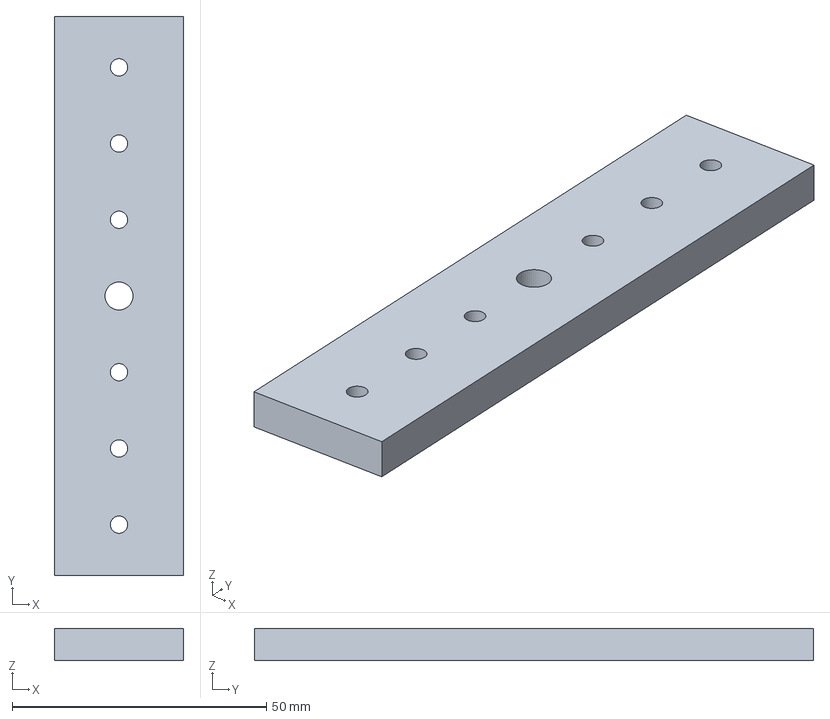
[picture p179: CAD file, 2026-10-10]
engineering/release/l1/cad/l1_cross_test_arm.step
25.4 x 110.0 x 6.35 mm
