geyan21/yam-tactile-kit/engineering/release/r1/cad/pad_4_saddle_mold.step

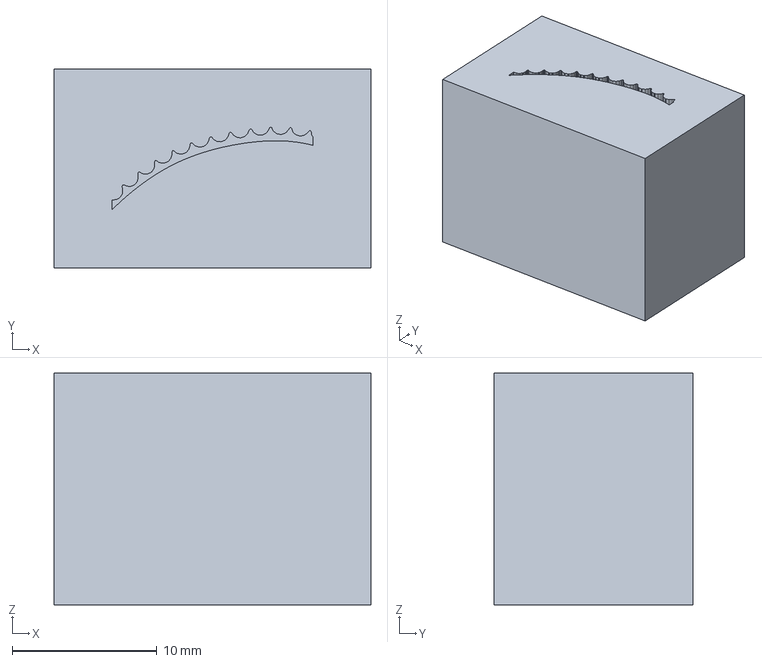
[picture p180: CAD file, 2026-10-10]
engineering/release/r1/cad/pad_4_saddle_mold.step
21.9 x 13.7 x 16.0 mm
