geyan21/yam-tactile-kit/engineering/development/f1/mechanics/cad/f1_ch4_rows_fit_tail_reference.step

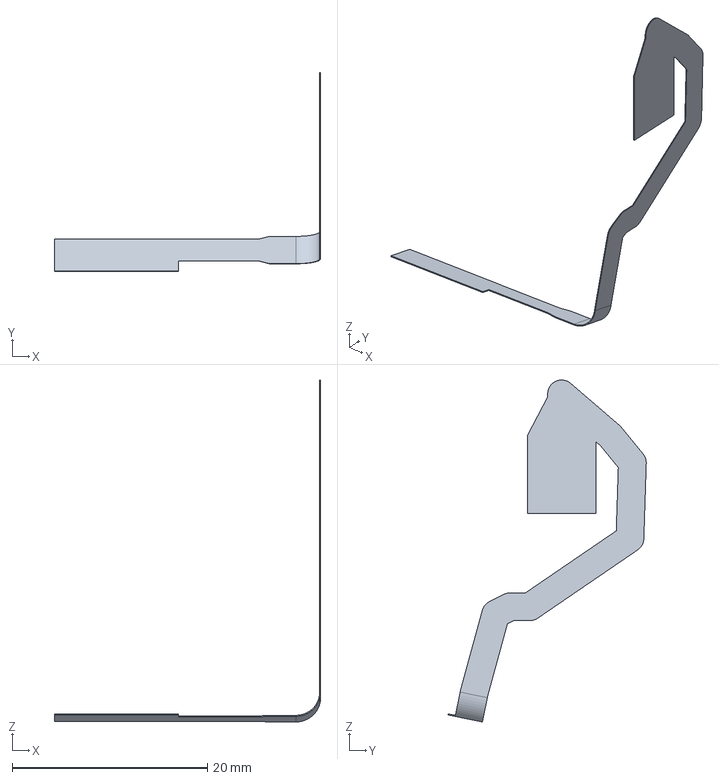
[picture p181: CAD file, 2026-10-11]
engineering/development/f1/mechanics/cad/f1_ch4_rows_fit_tail_reference.step
27.3 x 20.3 x 35.0 mm
