geyan21/yam-tactile-kit/engineering/prototypes/capacitive/cad/k1_ch2_stop_0_bond.step

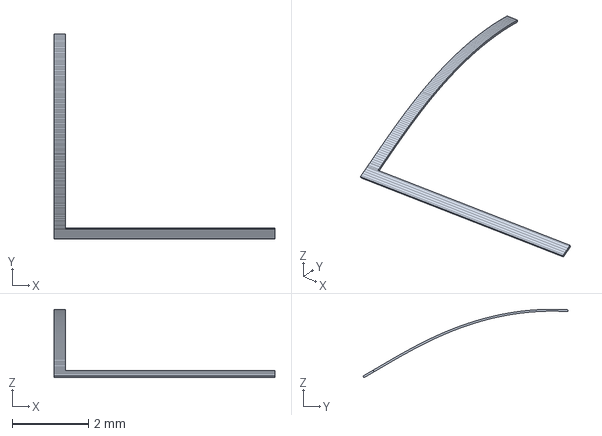
[picture p182: CAD file, 2026-10-11]
engineering/prototypes/capacitive/cad/k1_ch2_stop_0_bond.step
5.80 x 5.38 x 1.80 mm
