geyan21/yam-tactile-kit/engineering/prototypes/f1/cad/f1_ch2_retained_cover.step

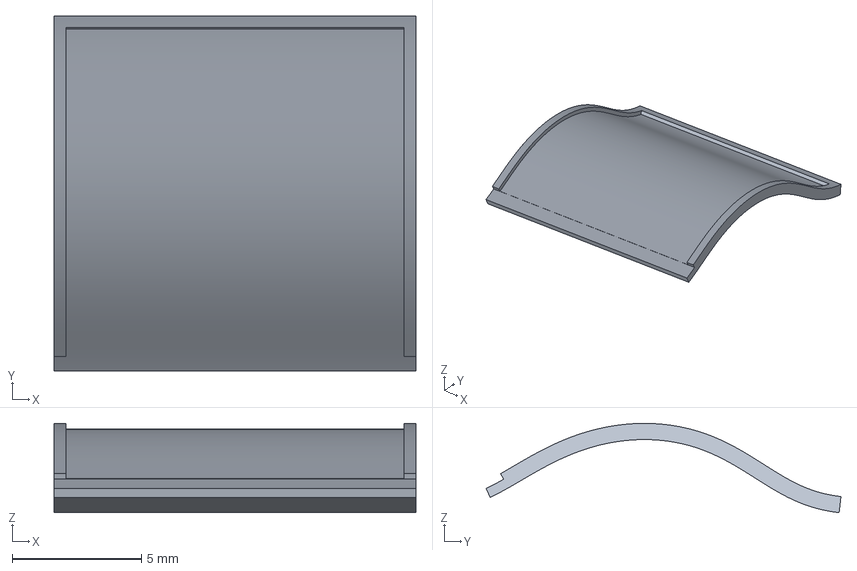
[picture p183: CAD file, 2026-10-12]
engineering/prototypes/f1/cad/f1_ch2_retained_cover.step
14.0 x 13.7 x 3.45 mm
