geyan21/yam-tactile-kit/engineering/prototypes/force_button/cad/fb1_plunger_locknut_reference.step

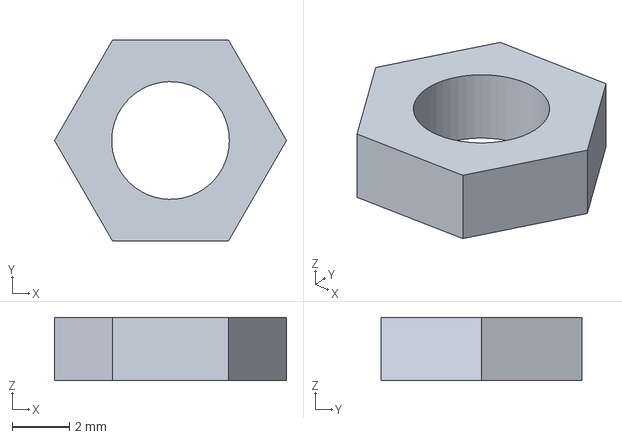
[picture p184: CAD file, 2026-10-11]
engineering/prototypes/force_button/cad/fb1_plunger_locknut_reference.step
8.08 x 7.00 x 2.20 mm
