geyan21/yam-tactile-kit/engineering/release/r1/cad/coupon_mold_0p4.step

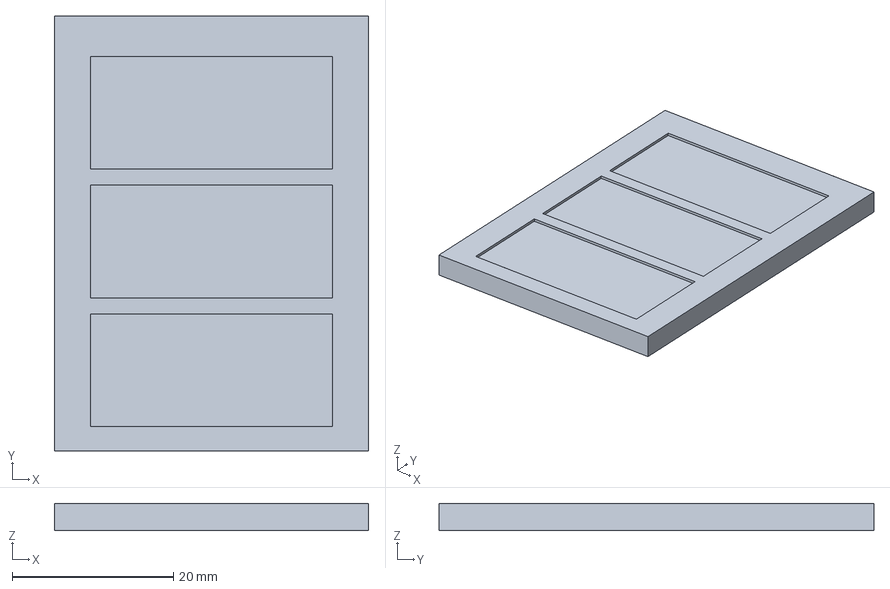
[picture p185: CAD file, 2026-10-10]
engineering/release/r1/cad/coupon_mold_0p4.step
39.0 x 54.0 x 3.40 mm
