geyan21/yam-tactile-kit/engineering/development/capacitive/k1/cad/k1_ch4_post_sheet_formed_reference.stl

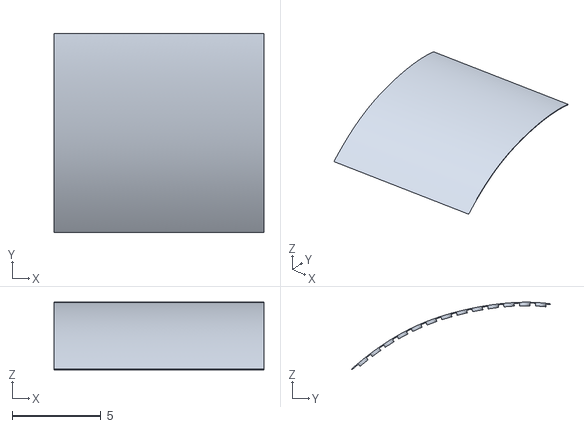
[picture p186: CAD file, 2026-10-11]
engineering/development/capacitive/k1/cad/k1_ch4_post_sheet_formed_reference.stl
11.8 x 11.2 x 3.80
