geyan21/yam-tactile-kit/engineering/development/f1/mechanics/cad/f1_ch5_columns_body.step

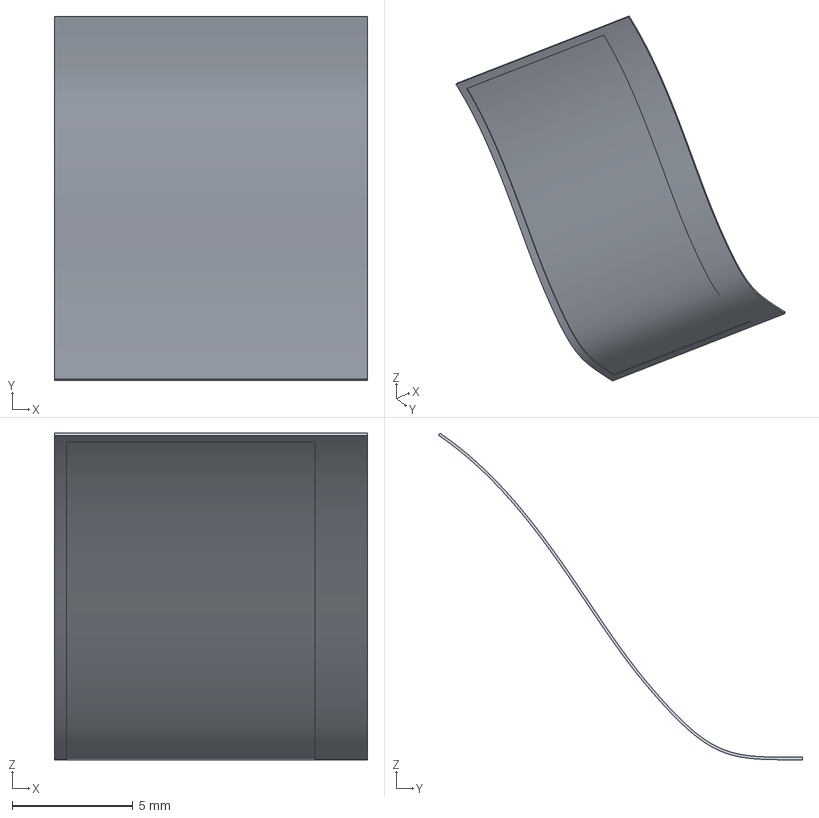
[picture p187: CAD file, 2026-10-11]
engineering/development/f1/mechanics/cad/f1_ch5_columns_body.step
13.0 x 15.1 x 13.6 mm
