geyan21/yam-tactile-kit/engineering/development/f1/r3/cad/f1_ch5_columns_fit_tail_reference.step

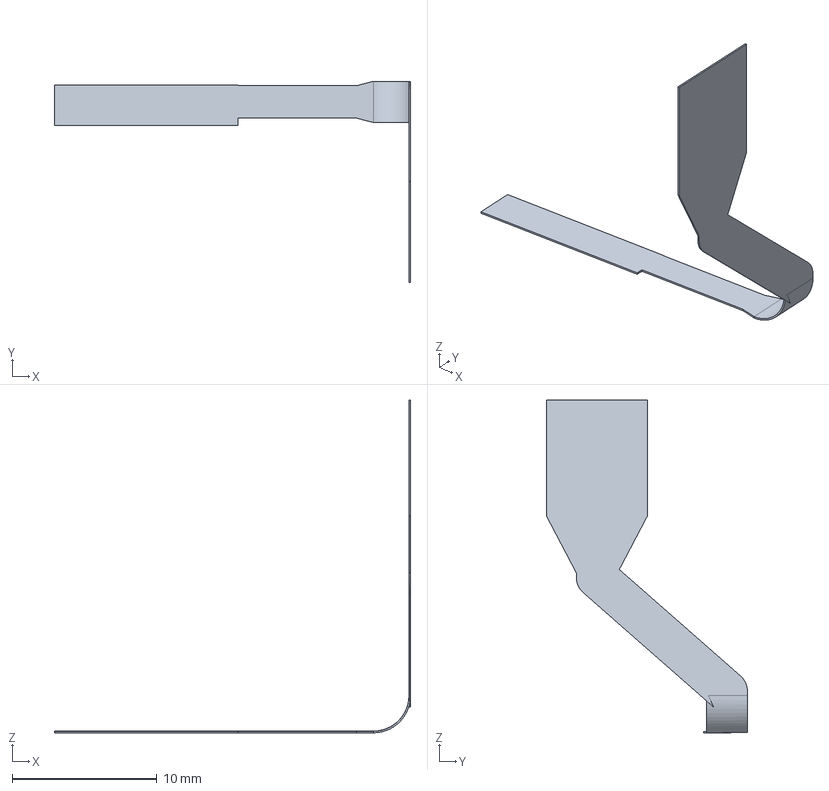
[picture p188: CAD file, 2026-10-11]
engineering/development/f1/r3/cad/f1_ch5_columns_fit_tail_reference.step
24.6 x 13.9 x 23.0 mm
