geyan21/yam-tactile-kit/engineering/prototypes/f1/cad/f1_ch2_compliant_fit_base.step

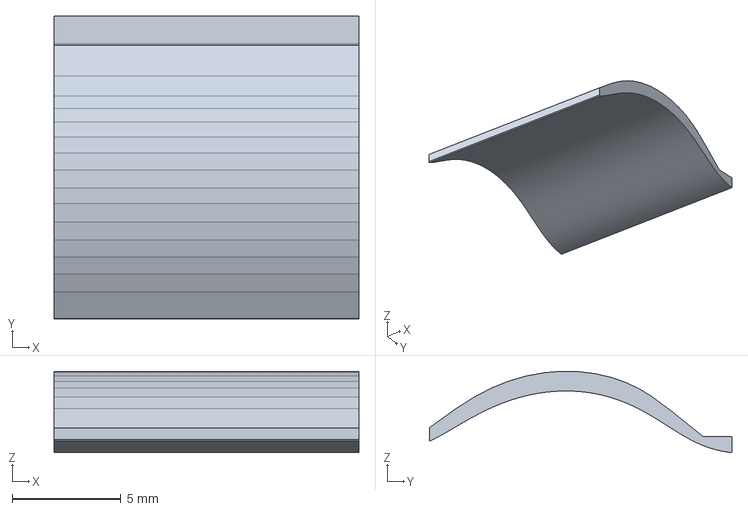
[picture p189: CAD file, 2026-10-12]
engineering/prototypes/f1/cad/f1_ch2_compliant_fit_base.step
14.0 x 13.9 x 3.73 mm
