geyan21/yam-tactile-kit/engineering/prototypes/force_button/cad/fb1_pcb_insulating_film.step

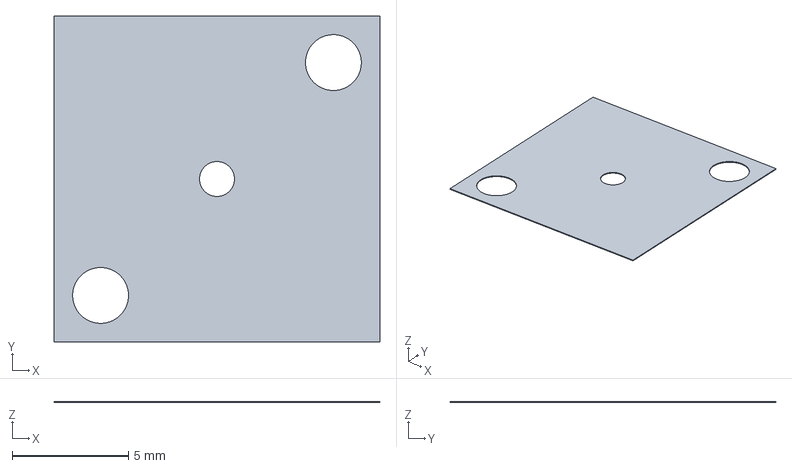
[picture p190: CAD file, 2026-10-11]
engineering/prototypes/force_button/cad/fb1_pcb_insulating_film.step
14.0 x 14.0 x 0.05 mm
