geyan21/yam-tactile-kit/engineering/prototypes/optical/cad/o1_D4_body_reference.step

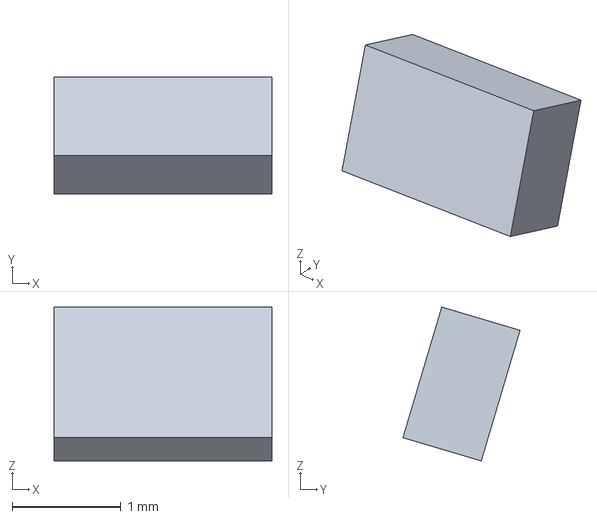
[picture p191: CAD file, 2026-10-12]
engineering/prototypes/optical/cad/o1_D4_body_reference.step
2.00 x 1.07 x 1.41 mm
