geyan21/yam-tactile-kit/engineering/release/l1/cad/l1_combined_load_plate.step

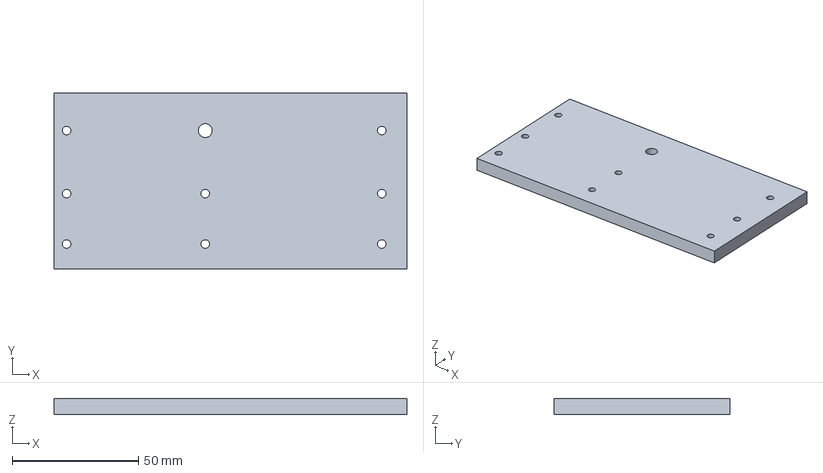
[picture p192: CAD file, 2026-10-10]
engineering/release/l1/cad/l1_combined_load_plate.step
140.0 x 70.0 x 6.35 mm
