geyan21/yam-tactile-kit/engineering/release/r1/cad/mount_pitch_fit_gauge.step

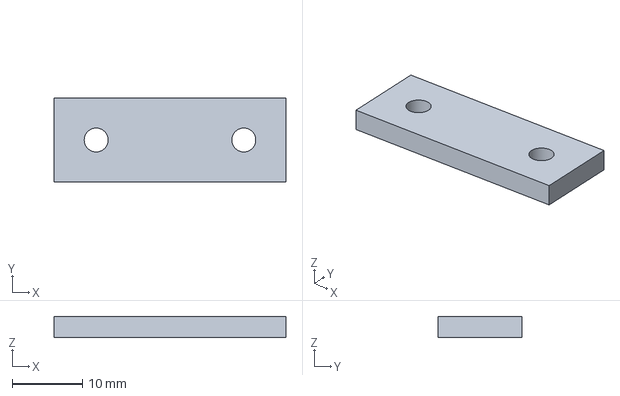
[picture p193: CAD file, 2026-10-10]
engineering/release/r1/cad/mount_pitch_fit_gauge.step
33.0 x 12.0 x 3.00 mm
