geyan21/yam-tactile-kit/engineering/development/capacitive/k1/cad/k1_ch4_conforming_saddle.step

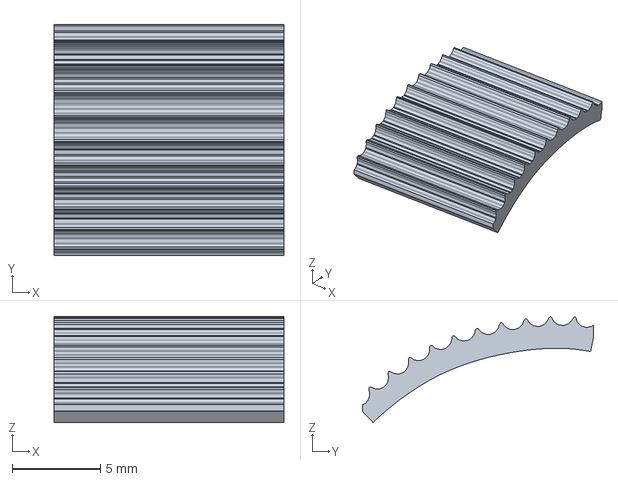
[picture p194: CAD file, 2026-10-11]
engineering/development/capacitive/k1/cad/k1_ch4_conforming_saddle.step
13.0 x 13.1 x 5.99 mm
