geyan21/yam-tactile-kit/engineering/development/f1/mechanics/cad/f1_ch4_film_body.step

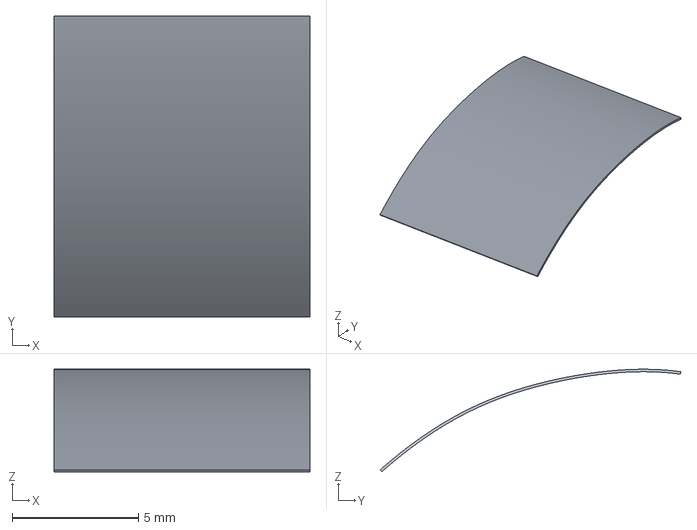
[picture p195: CAD file, 2026-10-11]
engineering/development/f1/mechanics/cad/f1_ch4_film_body.step
10.1 x 11.9 x 4.06 mm
