geyan21/yam-tactile-kit/engineering/development/f1/r3/cad/f1_ch0_cover_body.step

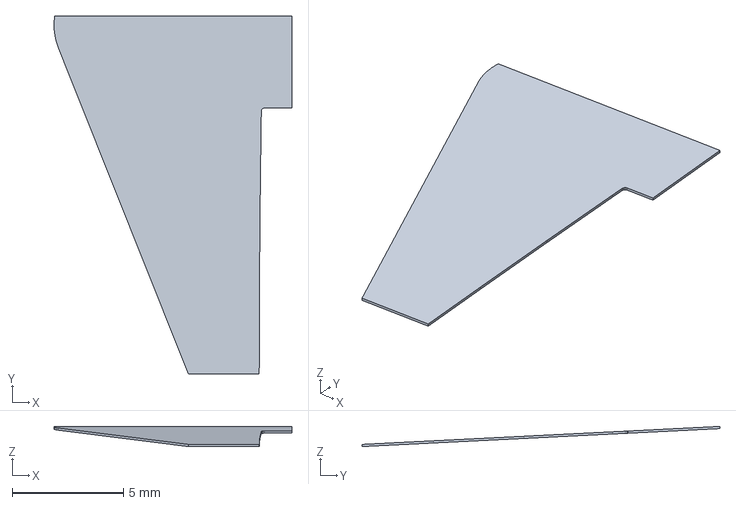
[picture p196: CAD file, 2026-10-11]
engineering/development/f1/r3/cad/f1_ch0_cover_body.step
10.7 x 16.1 x 0.906 mm
