geyan21/yam-tactile-kit/engineering/prototypes/c1/cad/c1_bench_calibration_arm.step

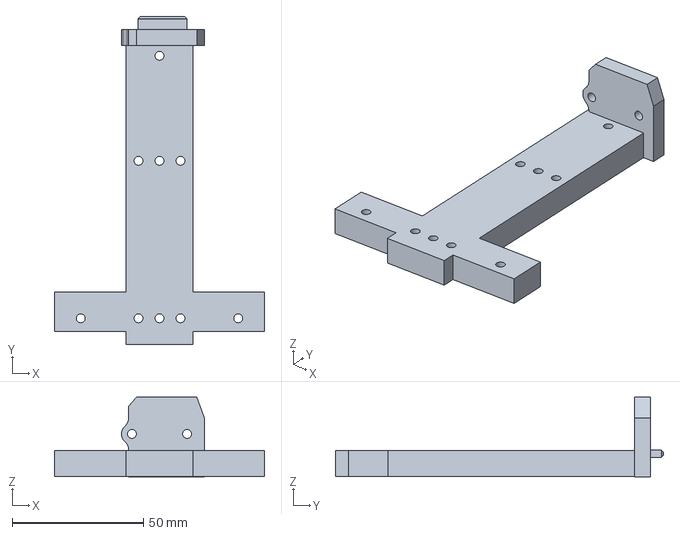
[picture p197: CAD file, 2026-10-11]
engineering/prototypes/c1/cad/c1_bench_calibration_arm.step
80.0 x 125.0 x 30.3 mm
