geyan21/yam-tactile-kit/engineering/prototypes/capacitive/cad/k1_ch2_cover_bond_1.step

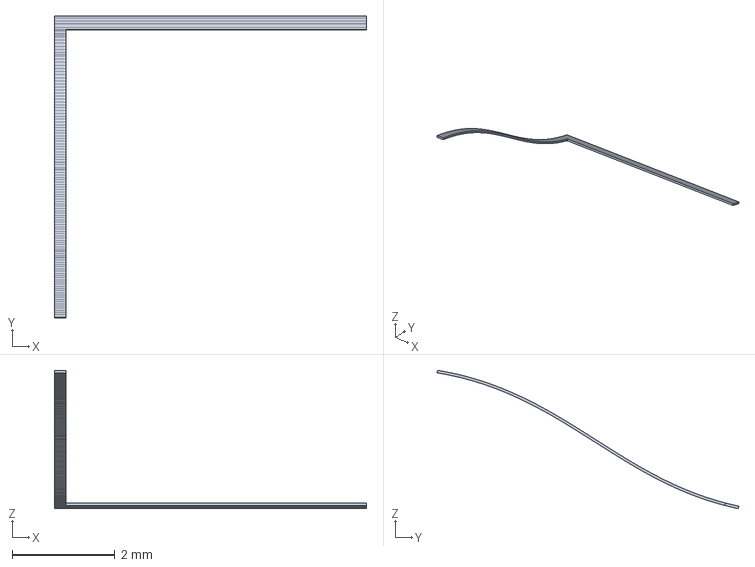
[picture p198: CAD file, 2026-10-11]
engineering/prototypes/capacitive/cad/k1_ch2_cover_bond_1.step
6.07 x 5.87 x 2.69 mm
