geyan21/yam-tactile-kit/engineering/prototypes/f1/cad/f1_ch4_foil_mount_bond.step

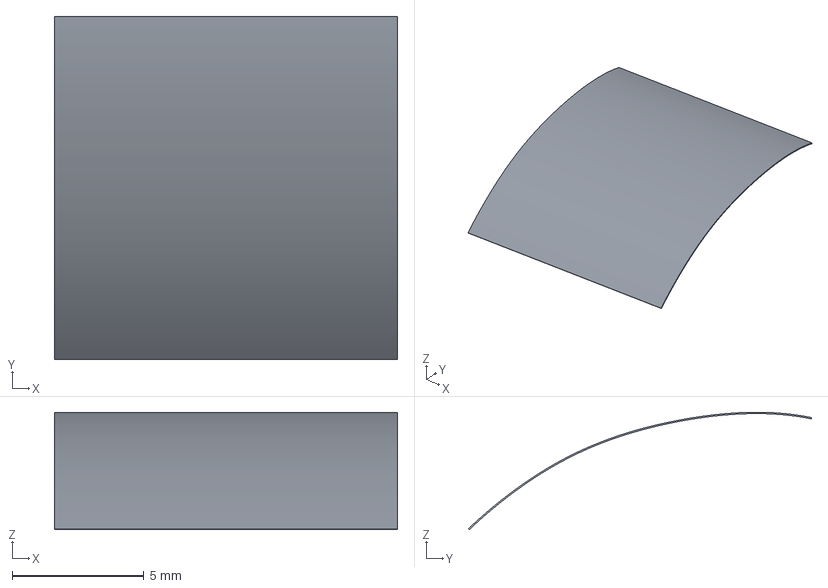
[picture p199: CAD file, 2026-10-12]
engineering/prototypes/f1/cad/f1_ch4_foil_mount_bond.step
13.0 x 13.0 x 4.45 mm
