geyan21/yam-tactile-kit/engineering/prototypes/optical/cad/o1_camera_rear_clearance_reference_2.step

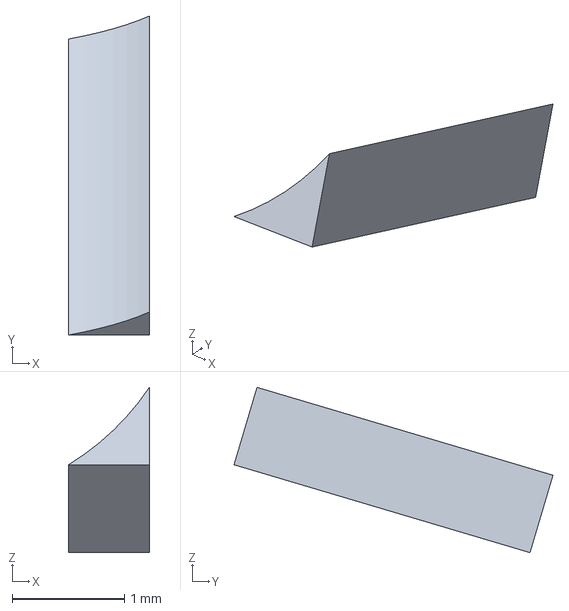
[picture p200: CAD file, 2026-10-12]
engineering/prototypes/optical/cad/o1_camera_rear_clearance_reference_2.step
0.719 x 2.84 x 1.47 mm
