geyan21/yam-tactile-kit/engineering/prototypes/pneumatic/cad/p1_U3_body_reference.step

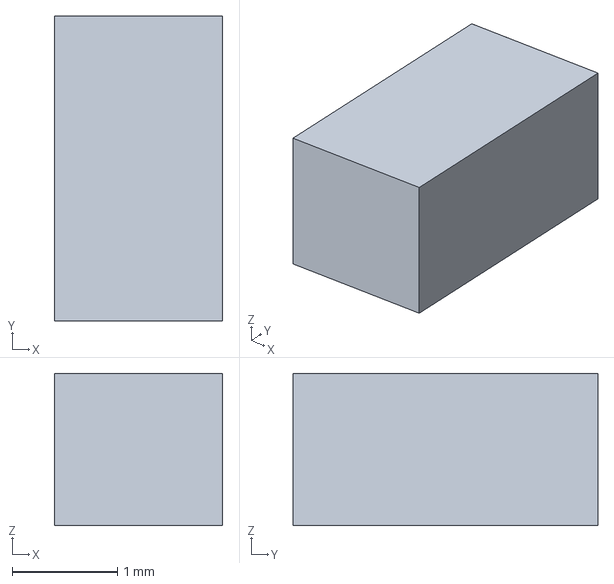
[picture p201: CAD file, 2026-10-12]
engineering/prototypes/pneumatic/cad/p1_U3_body_reference.step
1.60 x 2.90 x 1.45 mm
