geyan21/yam-tactile-kit/engineering/release/l1/cad/l1_center_load_cap.step

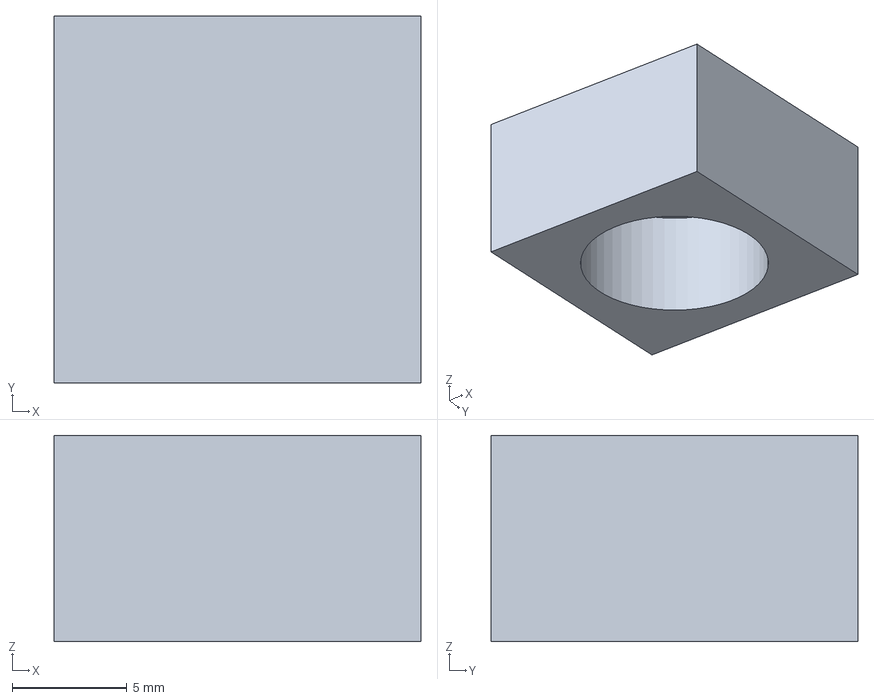
[picture p202: CAD file, 2026-10-10]
engineering/release/l1/cad/l1_center_load_cap.step
16.0 x 16.0 x 9.00 mm
