geyan21/yam-tactile-kit/engineering/release/r1/cad/pad_4_saddle_witness.step

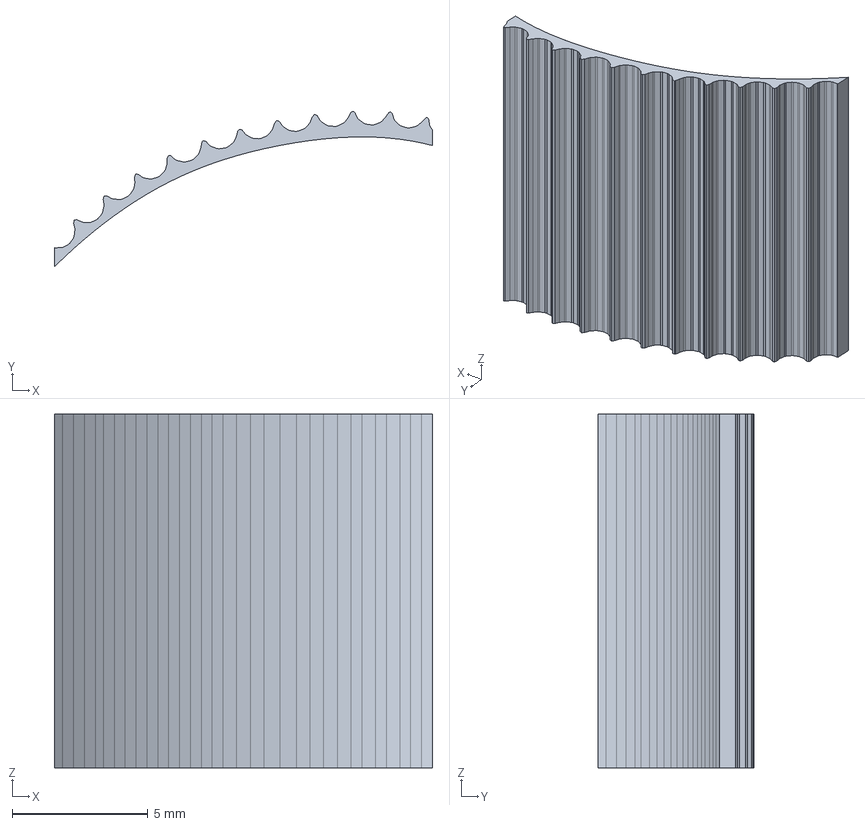
[picture p203: CAD file, 2026-10-10]
engineering/release/r1/cad/pad_4_saddle_witness.step
13.9 x 5.73 x 13.0 mm
