geyan21/yam-tactile-kit/(list of files, cad)

Other CAD files:
engineering/prototypes/f1/cad/f1_ch3_rows_full_stiffener_bond.step
engineering/prototypes/f1/cad/f1_ch3_columns_full_stiffener_bond.step
engineering/prototypes/f1/cad/f1_ch4_columns_full_stiffener_bond.step
engineering/prototypes/f1/cad/f1_ch5_columns_full_stiffener_bond.step
engineering/prototypes/f1/cad/f1_ch4_rows_full_stiffener_bond.step
engineering/prototypes/f1/cad/f1_ch4_rows_full_stiffener_pi.step
engineering/prototypes/f1/cad/f1_ch4_columns_full_stiffener_pi.step
engineering/prototypes/f1/cad/f1_ch2_columns_full_stiffener_bond.step
engineering/prototypes/f1/cad/f1_ch5_rows_full_stiffener_bond.step
engineering/prototypes/f1/cad/f1_ch2_rows_full_stiffener_bond.step
engineering/prototypes/f1/cad/f1_ch3_rows_full_stiffener_pi.step
engineering/prototypes/f1/cad/f1_ch5_columns_full_stiffener_pi.step
engineering/prototypes/f1/cad/f1_ch2_rows_full_stiffener_pi.step
engineering/prototypes/f1/cad/f1_ch0_columns_full_stiffener_bond.step
engineering/prototypes/f1/cad/f1_ch0_columns_full_stiffener_pi.step
engineering/prototypes/f1/cad/f1_ch2_columns_full_stiffener_pi.step
engineering/prototypes/f1/cad/f1_ch3_columns_full_stiffener_pi.step
engineering/prototypes/f1/cad/f1_ch1_layer_assembly_form.step
engineering/prototypes/f1/cad/f1_ch5_rows_full_stiffener_pi.step
engineering/development/f1/mechanics/cad/f1_ch4_forming_mandrel.step
engineering/prototypes/b2/cad/b2_pcb_fit_reference.step
engineering/prototypes/pneumatic/cad/p1_RC2_body_reference.step
engineering/prototypes/recessed/cad/recessed_locating_spacer_2.step
engineering/development/f1/r3/cad/f1_ch3_columns_body.step
engineering/prototypes/recessed/cad/recessed_removable_backer.step
engineering/development/f1/mechanics/cad/f1_ch0_rows_fit_tail_reference.step
engineering/development/f1/r3/cad/f1_ch2_forming_mandrel.step
engineering/prototypes/force_button/cad/fb1_stop_locknut_1_reference.step
engineering/development/capacitive/k1/cad/k1_ch3_ground_spreader.step
engineering/development/f1/r3/cad/f1_ch3_rows_body.step
engineering/prototypes/c1/cad/c1_floating_end_clamp.step
engineering/prototypes/pneumatic/cad/p1_RD1_body_reference.step
engineering/release/l1/cad/l1_fixed_carrier_m3_tap_drill.step
engineering/prototypes/c1/cad/c1_fixed_carrier_m3_tap_drill.step
engineering/prototypes/capacitive/cad/k1_reference_cover_bond_0.step
engineering/prototypes/pneumatic/cad/p1_ch1_n0_laminate.step
engineering/concepts/cad/b2_pcb_fit_witness.stl
engineering/concepts/cad/c1_strain_beam_coupon.stl
engineering/development/capacitive/k1/cad/k1_ch0_backing_spacer.step
engineering/development/capacitive/k1/cad/k1_ch0_backing_spacer.stl
engineering/development/capacitive/k1/cad/k1_ch0_cover_reference.step
engineering/development/capacitive/k1/cad/k1_ch0_cover_reference.stl
engineering/development/capacitive/k1/cad/k1_ch0_flex_reference.step
engineering/development/capacitive/k1/cad/k1_ch0_flex_reference.stl
engineering/development/capacitive/k1/cad/k1_ch0_ground_spreader.step
engineering/development/capacitive/k1/cad/k1_ch0_ground_spreader.stl
engineering/development/capacitive/k1/cad/k1_ch0_post_sheet_flat.stl
engineering/development/capacitive/k1/cad/k1_ch0_post_sheet_formed_reference.stl
engineering/development/capacitive/k1/cad/k1_ch0_post_stencil.step
engineering/development/capacitive/k1/cad/k1_ch0_post_stencil.stl
engineering/development/capacitive/k1/cad/k1_ch0_spreader_form.step
engineering/development/capacitive/k1/cad/k1_ch0_spreader_form.stl
engineering/development/capacitive/k1/cad/k1_ch1_backing_spacer.step
engineering/development/capacitive/k1/cad/k1_ch1_backing_spacer.stl
engineering/development/capacitive/k1/cad/k1_ch1_cover_reference.step
engineering/development/capacitive/k1/cad/k1_ch1_cover_reference.stl
engineering/development/capacitive/k1/cad/k1_ch1_flex_reference.step
engineering/development/capacitive/k1/cad/k1_ch1_flex_reference.stl
engineering/development/capacitive/k1/cad/k1_ch1_ground_spreader.step
engineering/development/capacitive/k1/cad/k1_ch1_ground_spreader.stl
engineering/development/capacitive/k1/cad/k1_ch1_post_sheet_flat.step
engineering/development/capacitive/k1/cad/k1_ch1_post_sheet_flat.stl
engineering/development/capacitive/k1/cad/k1_ch1_post_sheet_formed_reference.stl
engineering/development/capacitive/k1/cad/k1_ch1_post_stencil.stl
engineering/development/capacitive/k1/cad/k1_ch1_spreader_form.step
engineering/development/capacitive/k1/cad/k1_ch1_spreader_form.stl
engineering/development/capacitive/k1/cad/k1_ch2_backing_spacer.step
engineering/development/capacitive/k1/cad/k1_ch2_backing_spacer.stl
engineering/development/capacitive/k1/cad/k1_ch2_conforming_saddle.step
engineering/development/capacitive/k1/cad/k1_ch2_conforming_saddle.stl
engineering/development/capacitive/k1/cad/k1_ch2_cover_reference.stl
engineering/development/capacitive/k1/cad/k1_ch2_flex_reference.step
engineering/development/capacitive/k1/cad/k1_ch2_flex_reference.stl
engineering/development/capacitive/k1/cad/k1_ch2_ground_spreader.step
engineering/development/capacitive/k1/cad/k1_ch2_ground_spreader.stl
engineering/development/capacitive/k1/cad/k1_ch2_post_sheet_flat.step
engineering/development/capacitive/k1/cad/k1_ch2_post_sheet_flat.stl
engineering/development/capacitive/k1/cad/k1_ch2_post_stencil.step
engineering/development/capacitive/k1/cad/k1_ch2_post_stencil.stl
engineering/development/capacitive/k1/cad/k1_ch2_spreader_form.step
engineering/development/capacitive/k1/cad/k1_ch2_spreader_form.stl
engineering/development/capacitive/k1/cad/k1_ch3_backing_spacer.step
engineering/development/capacitive/k1/cad/k1_ch3_backing_spacer.stl
engineering/development/capacitive/k1/cad/k1_ch3_conforming_saddle.step
engineering/development/capacitive/k1/cad/k1_ch3_cover_reference.step
engineering/development/capacitive/k1/cad/k1_ch3_cover_reference.stl
engineering/development/capacitive/k1/cad/k1_ch3_flex_reference.step
engineering/development/capacitive/k1/cad/k1_ch3_flex_reference.stl
engineering/development/capacitive/k1/cad/k1_ch3_ground_spreader.stl
engineering/development/capacitive/k1/cad/k1_ch3_post_sheet_flat.step
engineering/development/capacitive/k1/cad/k1_ch3_post_sheet_flat.stl
engineering/development/capacitive/k1/cad/k1_ch3_post_sheet_formed_reference.stl
engineering/development/capacitive/k1/cad/k1_ch3_post_stencil.step
engineering/development/capacitive/k1/cad/k1_ch3_post_stencil.stl
engineering/development/capacitive/k1/cad/k1_ch3_spreader_form.step
engineering/development/capacitive/k1/cad/k1_ch3_spreader_form.stl
engineering/development/capacitive/k1/cad/k1_ch4_backing_spacer.step
engineering/development/capacitive/k1/cad/k1_ch4_backing_spacer.stl
engineering/development/capacitive/k1/cad/k1_ch4_cover_reference.step
engineering/development/capacitive/k1/cad/k1_ch4_cover_reference.stl
engineering/development/capacitive/k1/cad/k1_ch4_flex_reference.step
engineering/development/capacitive/k1/cad/k1_ch4_flex_reference.stl
engineering/development/capacitive/k1/cad/k1_ch4_ground_spreader.step
engineering/development/capacitive/k1/cad/k1_ch4_ground_spreader.stl
engineering/development/capacitive/k1/cad/k1_ch4_post_sheet_flat.stl
engineering/development/capacitive/k1/cad/k1_ch4_post_stencil.step
engineering/development/capacitive/k1/cad/k1_ch4_post_stencil.stl
engineering/development/capacitive/k1/cad/k1_ch4_spreader_form.step
engineering/development/capacitive/k1/cad/k1_ch4_spreader_form.stl
engineering/development/capacitive/k1/cad/k1_ch5_backing_spacer.step
engineering/development/capacitive/k1/cad/k1_ch5_backing_spacer.stl
engineering/development/capacitive/k1/cad/k1_ch5_conforming_saddle.step
engineering/development/capacitive/k1/cad/k1_ch5_cover_reference.step
engineering/development/capacitive/k1/cad/k1_ch5_cover_reference.stl
engineering/development/capacitive/k1/cad/k1_ch5_flex_reference.step
engineering/development/capacitive/k1/cad/k1_ch5_flex_reference.stl
engineering/development/capacitive/k1/cad/k1_ch5_ground_spreader.step
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
