geyan21/yam-tactile-kit/engineering/prototypes/optical/visuals/o1_assembly.pdf

O1.0 • fixed optics and removable gel cartridge CAD only • casting, mating, optics, precision and 20 N response require physical tests

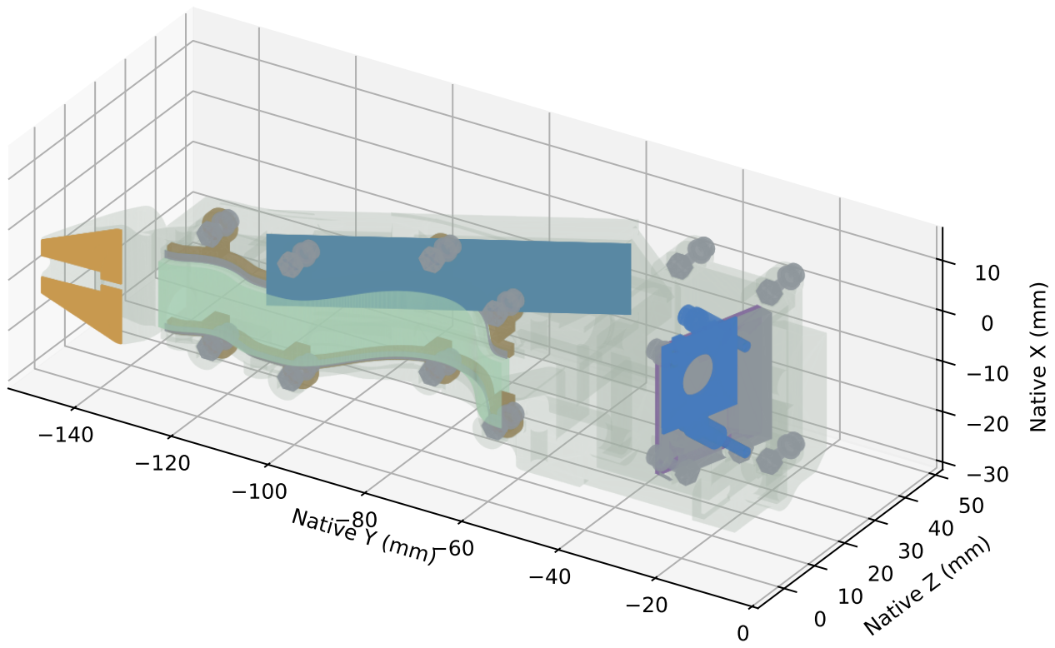
[picture p213: figure]
Native Y (mm); Native Z (mm); Native X (mm)
