geyan21/yam-tactile-kit/engineering/prototypes/pneumatic/visuals/p1_assembly_iso.pdf

P1.0 · blue front / purple back air channels, orange N0 nail cells Original hard frame retained · 0 physical builds · hose slack and 20 N performance unverified

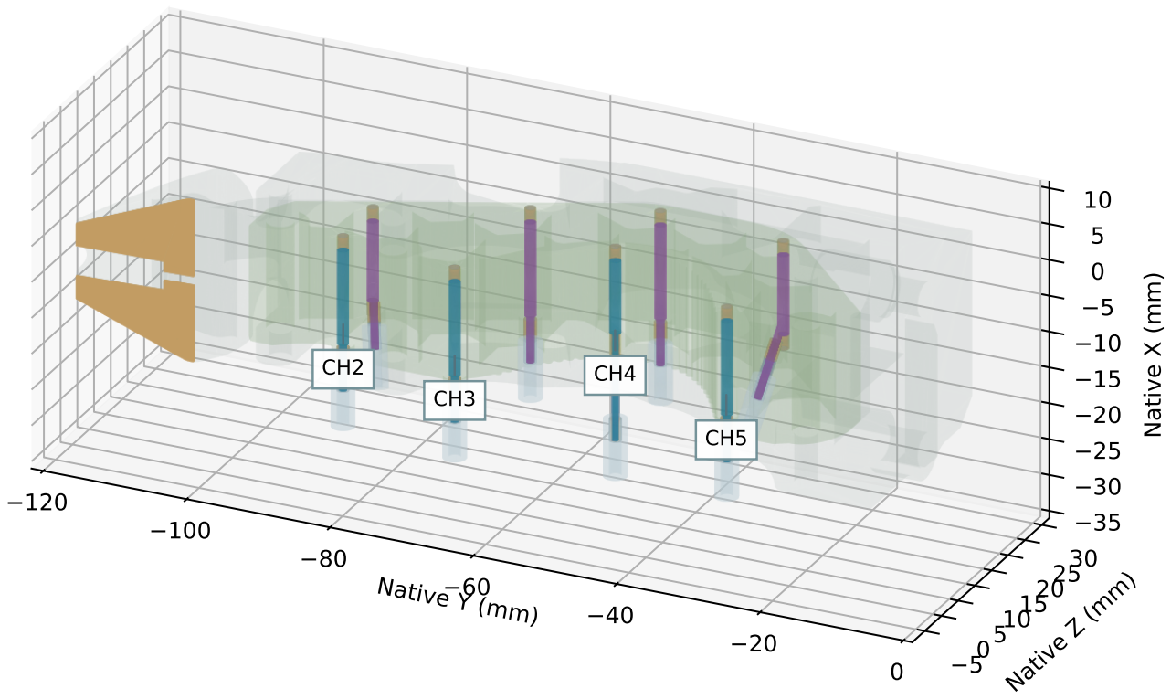
[picture p214: figure]
Native Y (mm); 1015202530 Native Z (mm); Native X (mm)
