geyan21/yam-tactile-kit/engineering/development/f1/mechanics/visuals/carrier_assembly.png

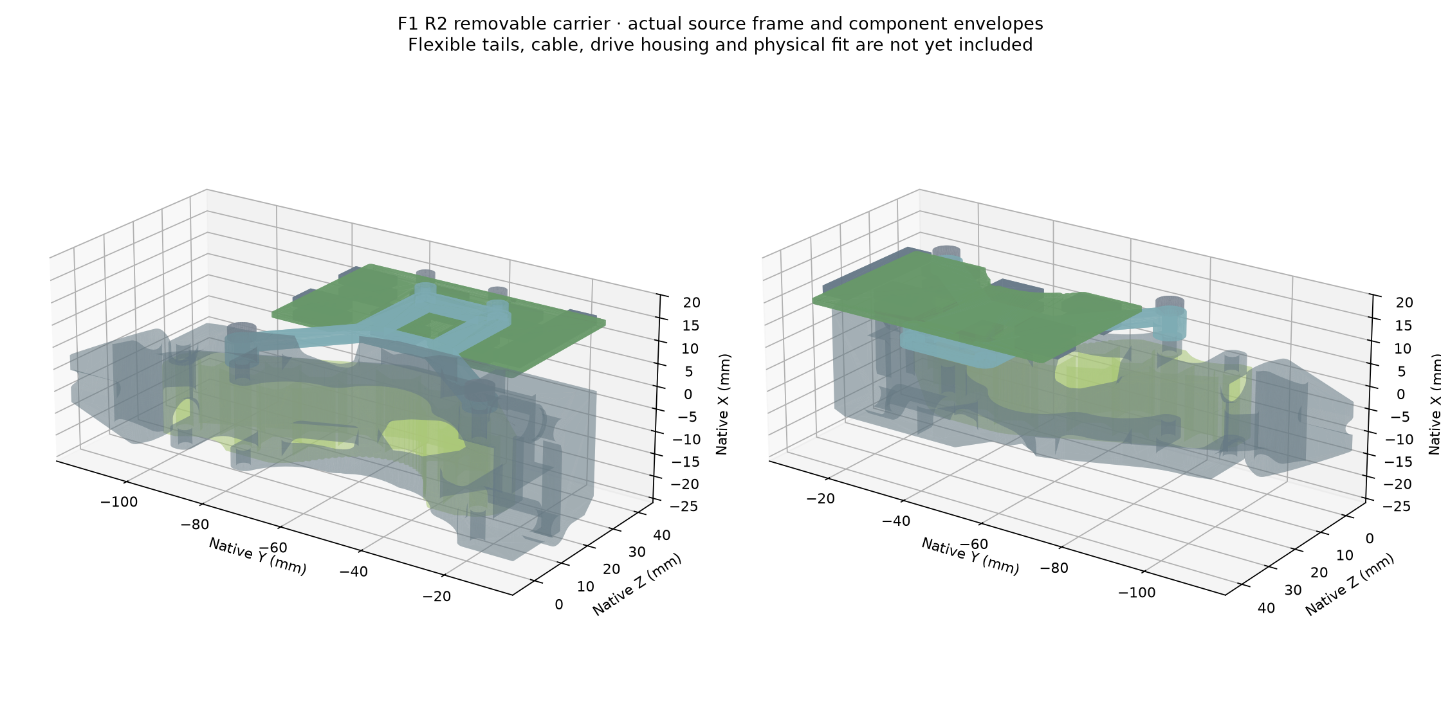
engineering/development/f1/mechanics/visuals/carrier_assembly.png
