geyan21/yam-tactile-kit/engineering/prototypes/b2/b2_assembly.png

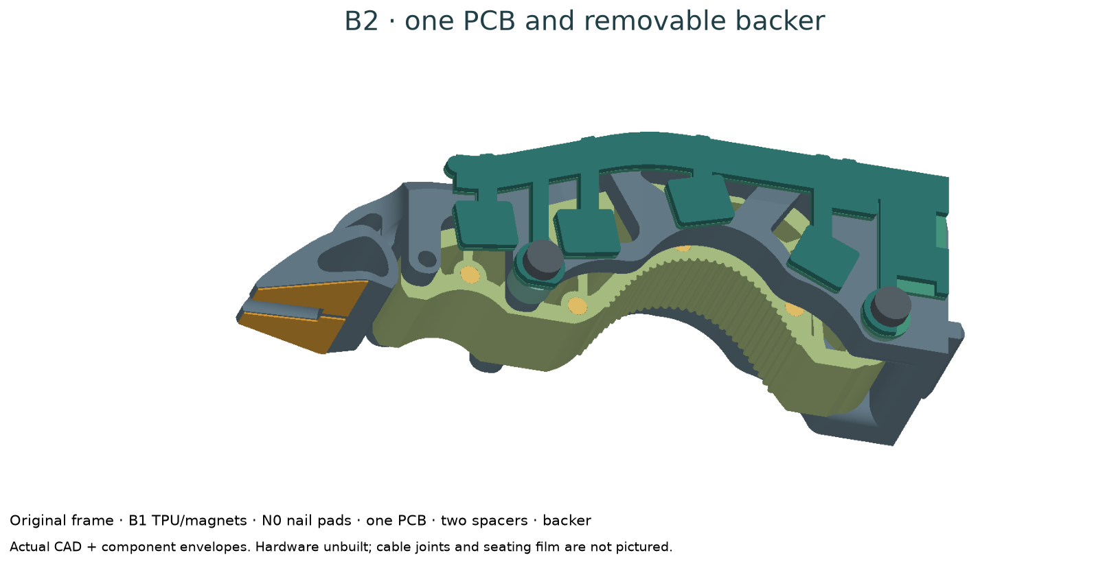
engineering/prototypes/b2/b2_assembly.png
