geyan21/yam-tactile-kit/engineering/prototypes/c1/c1_assembly.png

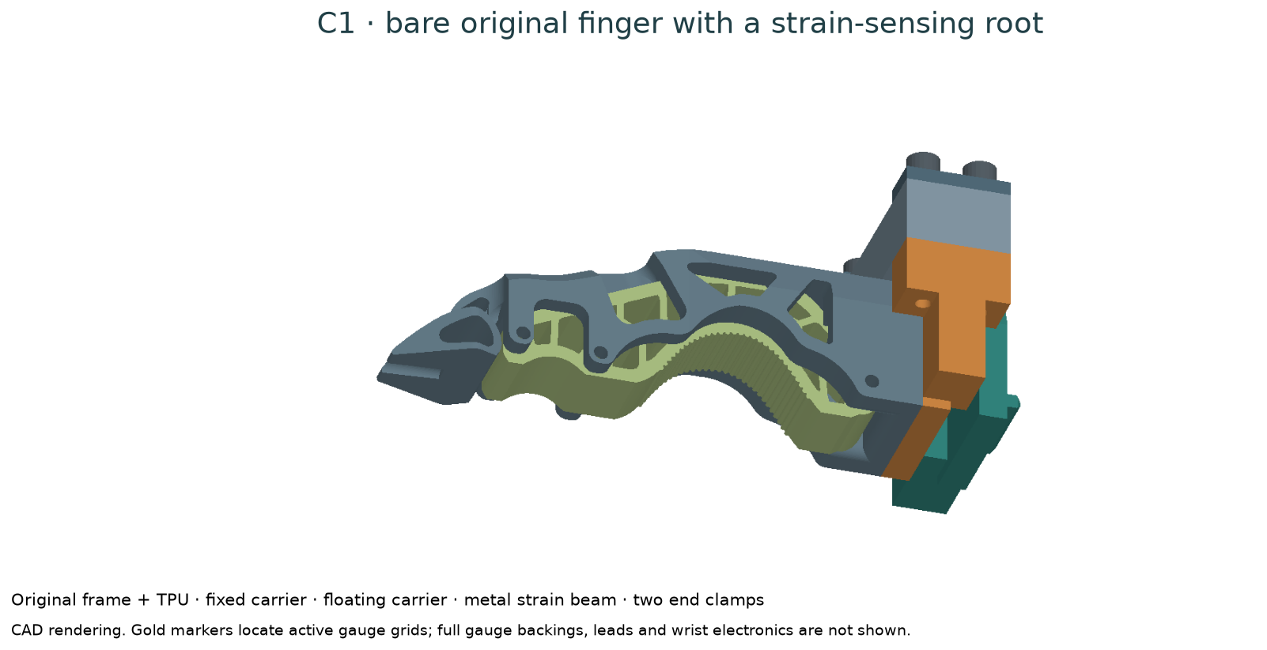
engineering/prototypes/c1/c1_assembly.png
