geyan21/yam-tactile-kit/engineering/prototypes/f1/visuals/f1_r4_assembly.png

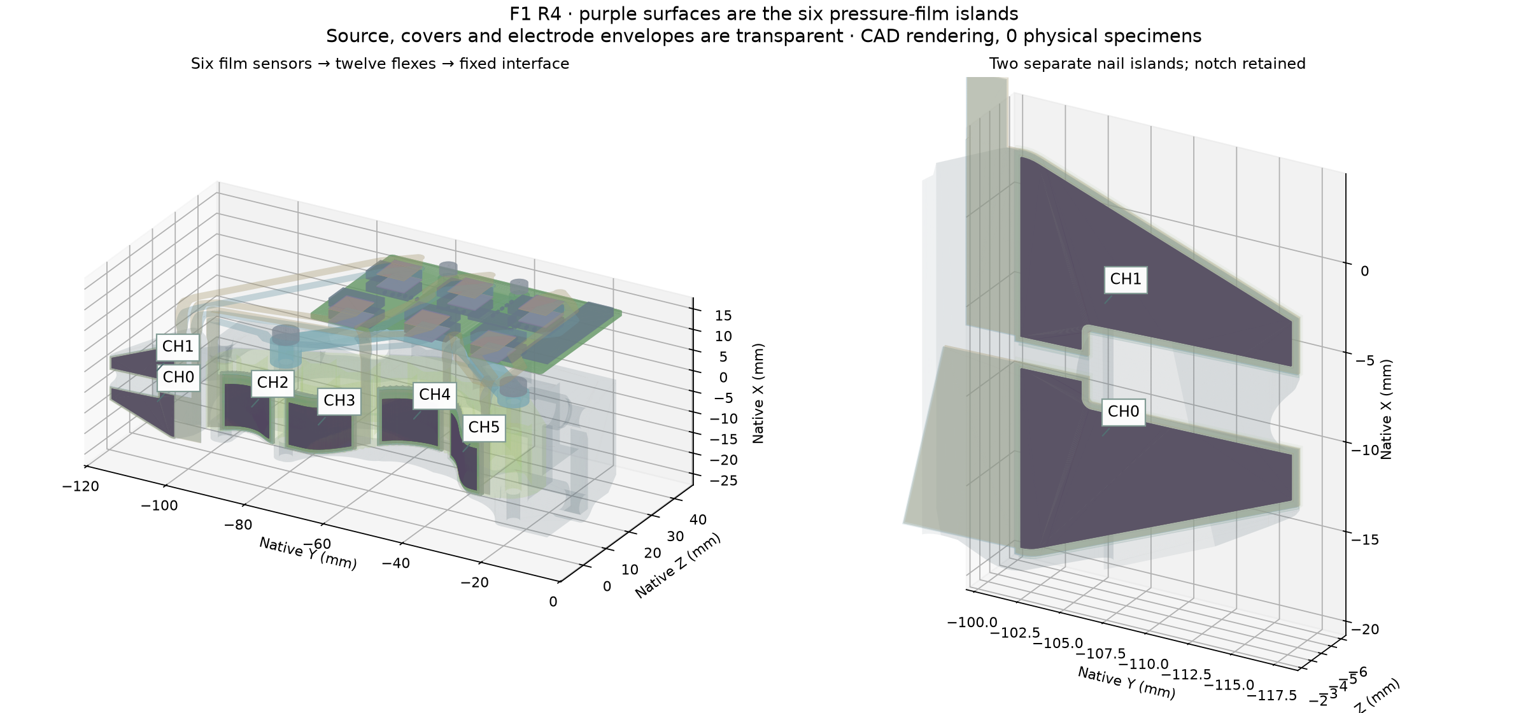
engineering/prototypes/f1/visuals/f1_r4_assembly.png
