geyan21/yam-tactile-kit/engineering/prototypes/nail/nail_assembly.png

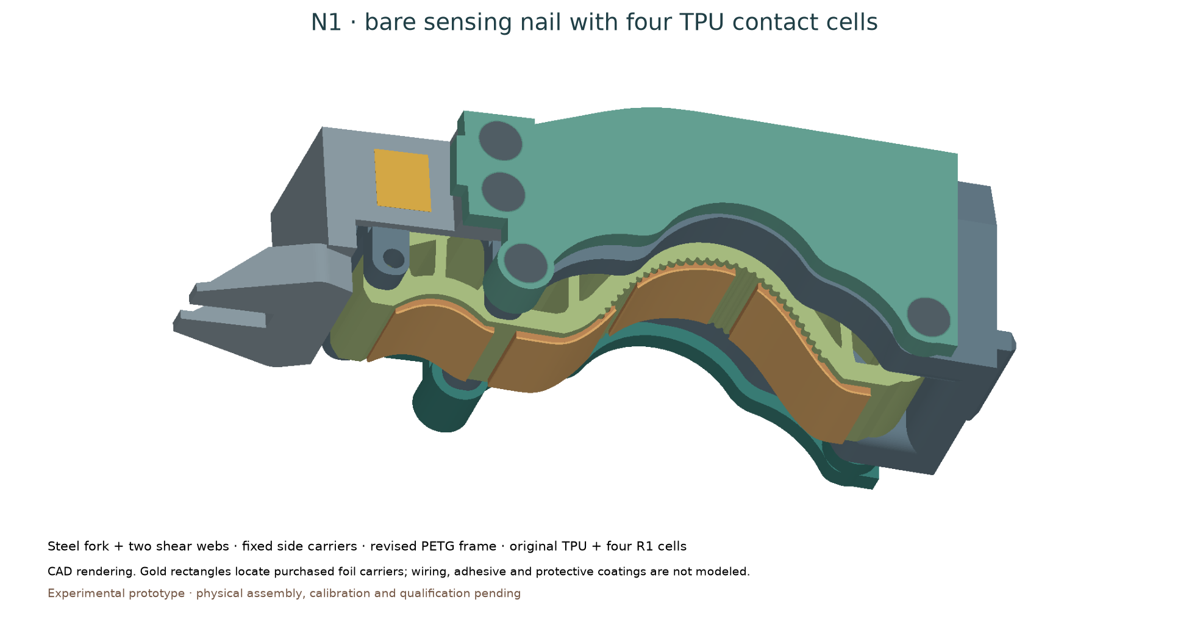
engineering/prototypes/nail/nail_assembly.png
