geyan21/yam-tactile-kit/engineering/prototypes/optical/visuals/o1_assembly.png

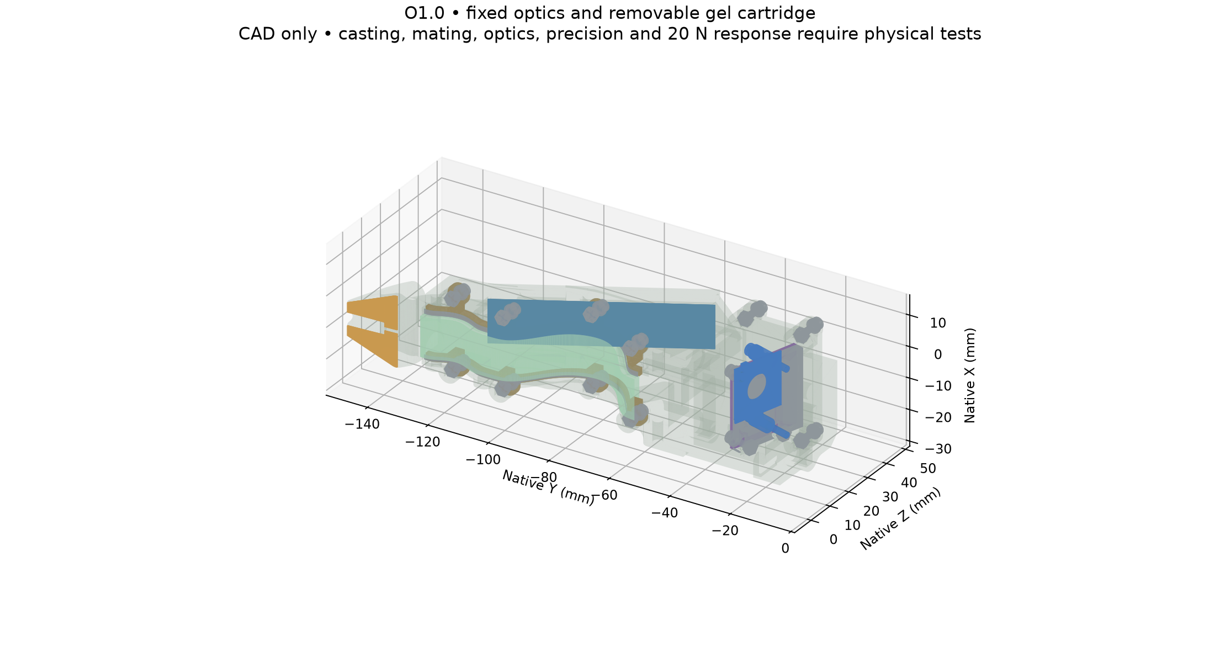
engineering/prototypes/optical/visuals/o1_assembly.png
