geyan21/yam-tactile-kit/engineering/prototypes/optical/visuals/o1_wiring.png

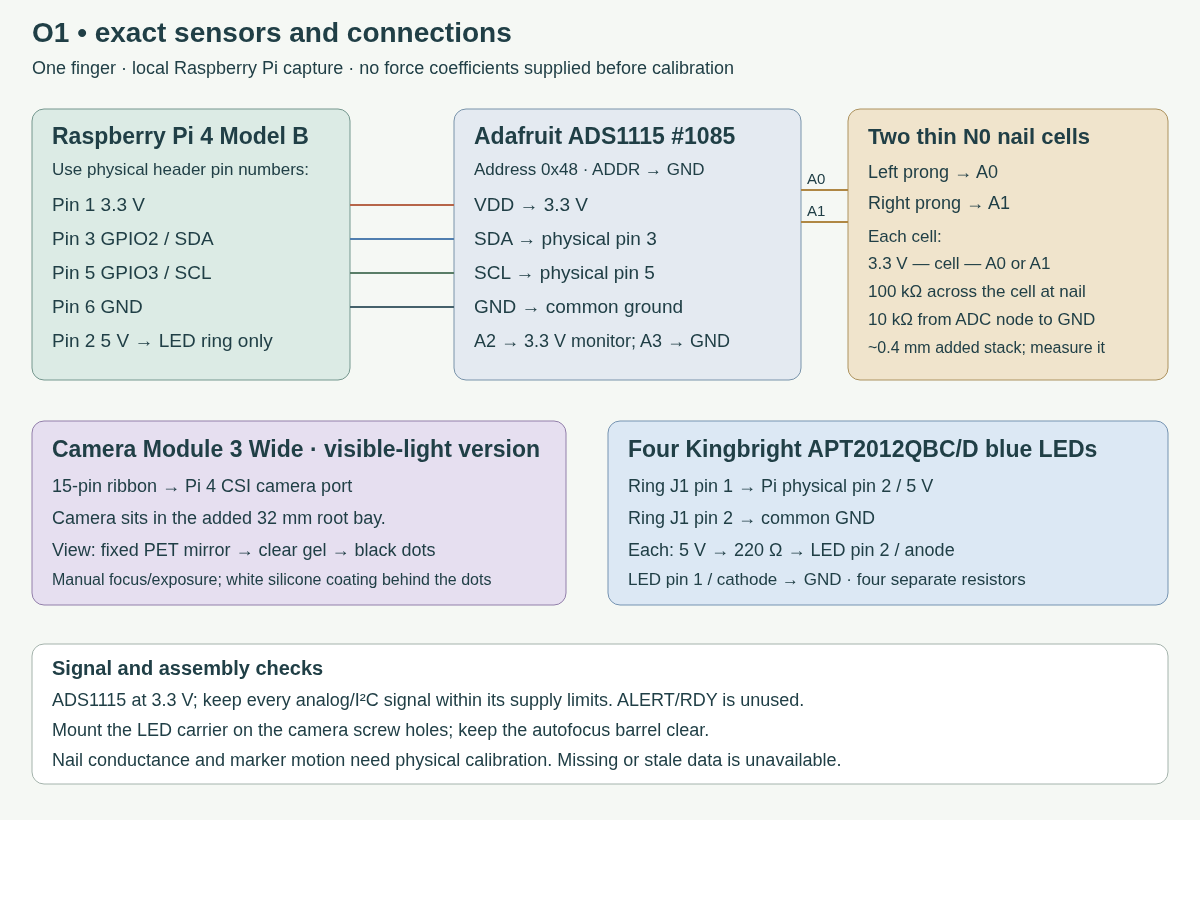
engineering/prototypes/optical/visuals/o1_wiring.png
