geyan21/yam-tactile-kit/engineering/prototypes/pneumatic/visuals/p1_wiring.png

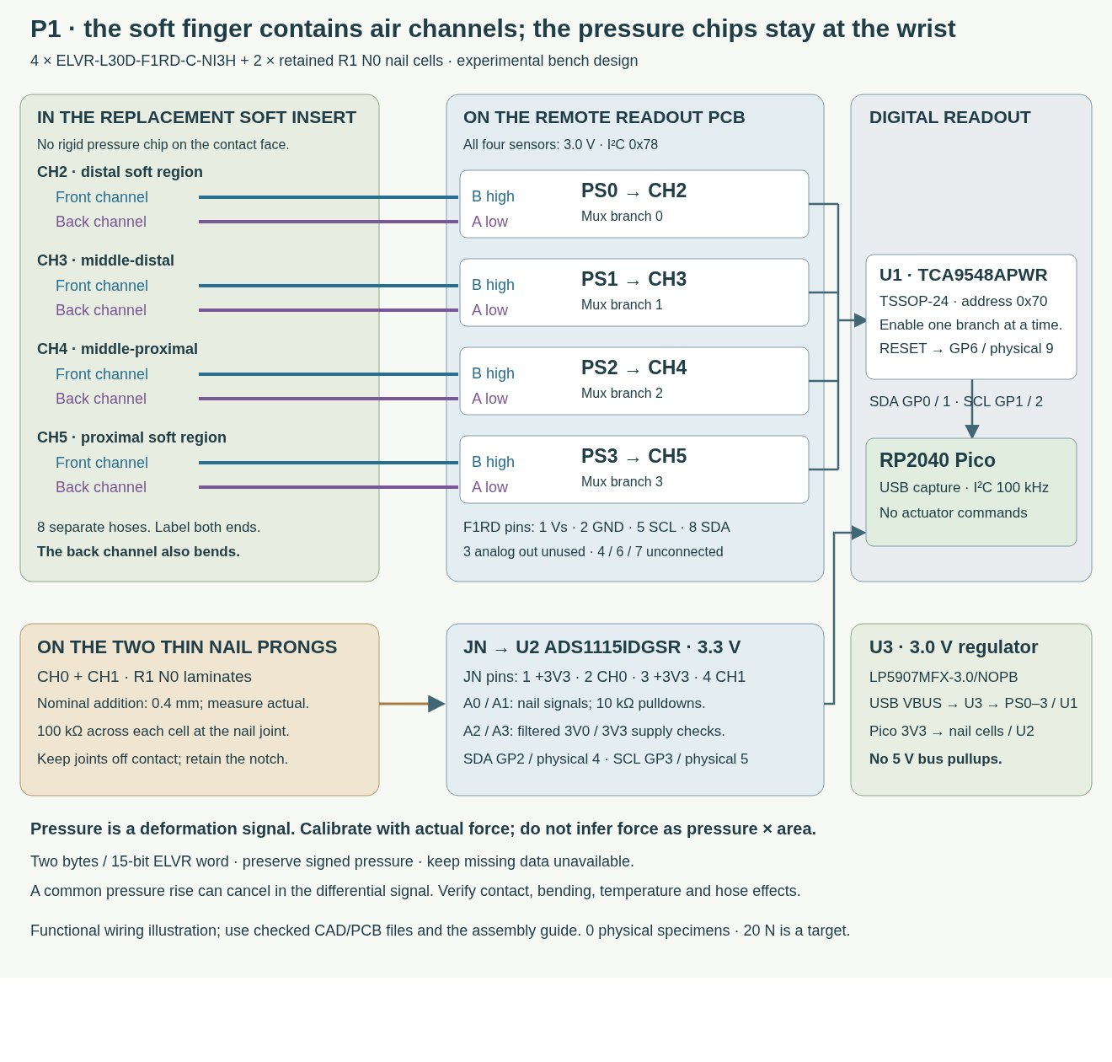
engineering/prototypes/pneumatic/visuals/p1_wiring.png
