geyan21/yam-tactile-kit/engineering/prototypes/recessed/recessed_assembly.png

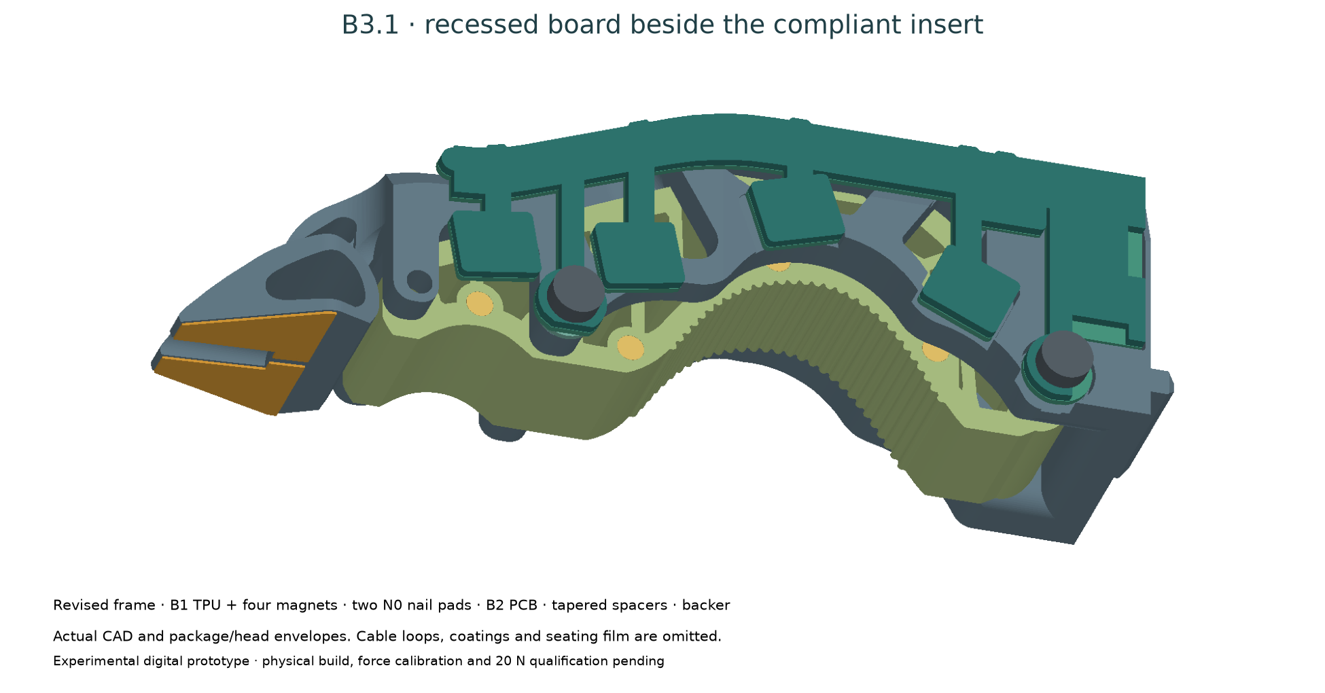
engineering/prototypes/recessed/recessed_assembly.png
