geyan21/yam-tactile-kit/engineering/release/baseline/baseline_assembly.png

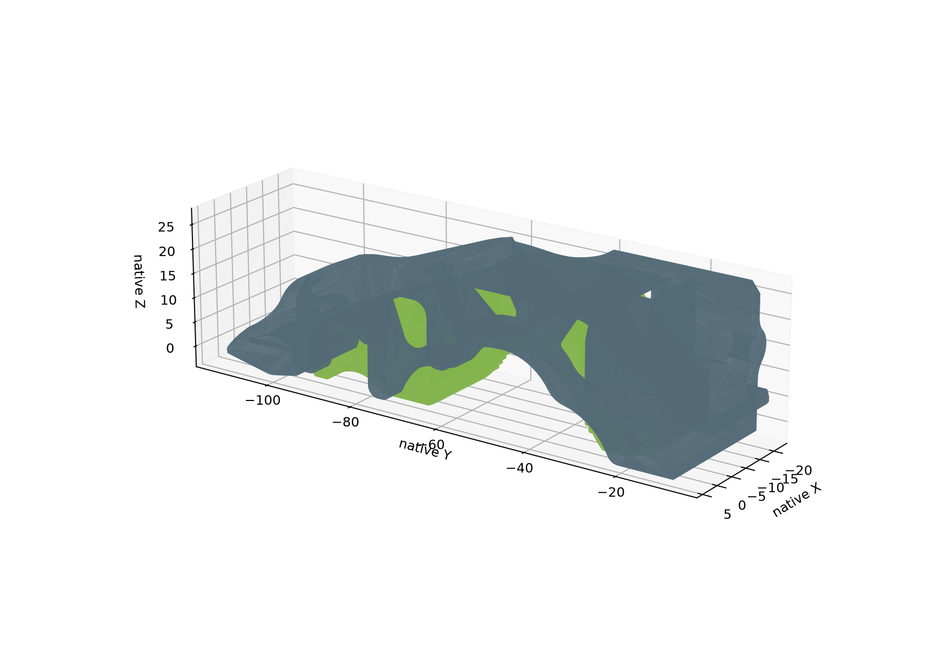
engineering/release/baseline/baseline_assembly.png
