geyan21/yam-tactile-kit/reproduction/calibration.csv

dataset_kind | sensor_id | sample_id | partition | contact_z_mm | raw_1 | raw_2 | reference_force_n
synthetic | SYNTHETIC-DEMO-ONLY | synthetic-001 | train | 30 | 74.464046 | -85.961098 | 0
synthetic | SYNTHETIC-DEMO-ONLY | synthetic-002 | train | 30 | 99.890123 | -49.920423 | 0
synthetic | SYNTHETIC-DEMO-ONLY | synthetic-003 | train | 30 | 125.441709 | -14.023664 | 0
synthetic | SYNTHETIC-DEMO-ONLY | synthetic-004 | train | 30 | 125.465603 | -42.769523 | 1
synthetic | SYNTHETIC-DEMO-ONLY | synthetic-005 | train | 30 | 150.921670 | -6.825747 | 1
synthetic | SYNTHETIC-DEMO-ONLY | synthetic-006 | train | 30 | 176.488763 | 29.268589 | 1
synthetic | SYNTHETIC-DEMO-ONLY | synthetic-007 | train | 30 | 176.503160 | 0.358621 | 2
synthetic | SYNTHETIC-DEMO-ONLY | synthetic-008 | train | 30 | 202.025175 | 36.320894 | 2
synthetic | SYNTHETIC-DEMO-ONLY | synthetic-009 | train | 30 | 227.462828 | 72.351771 | 2
synthetic | SYNTHETIC-DEMO-ONLY | synthetic-010 | train | 30 | 329.561825 | 130.043118 | 5
synthetic | SYNTHETIC-DEMO-ONLY | synthetic-011 | train | 30 | 354.900433 | 165.956472 | 5
synthetic | SYNTHETIC-DEMO-ONLY | synthetic-012 | train | 30 | 380.586986 | 201.974510 | 5
synthetic | SYNTHETIC-DEMO-ONLY | synthetic-013 | train | 30 | 584.541575 | 345.989052 | 10
synthetic | SYNTHETIC-DEMO-ONLY | synthetic-014 | train | 30 | 609.912614 | 382.057104 | 10
synthetic | SYNTHETIC-DEMO-ONLY | synthetic-015 | train | 30 | 635.514647 | 418.115167 | 10
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
synthetic | SYNTHETIC-DEMO-ONLY | synthetic-061 | train | 60 | 2114.391758 | 2218.112783 | 20
synthetic | SYNTHETIC-DEMO-ONLY | synthetic-062 | train | 60 | 2139.976099 | 2253.989122 | 20
synthetic | SYNTHETIC-DEMO-ONLY | synthetic-063 | train | 60 | 2165.619195 | 2289.934740 | 20
synthetic | SYNTHETIC-DEMO-ONLY | synthetic-064 | test | 55 | 74.534017 | -86.020962 | 0
synthetic | SYNTHETIC-DEMO-ONLY | synthetic-065 | test | 55 | 100.057449 | -49.986155 | 0
synthetic | SYNTHETIC-DEMO-ONLY | synthetic-066 | test | 55 | 125.506519 | -14.020124 | 0
synthetic | SYNTHETIC-DEMO-ONLY | synthetic-067 | test | 55 | 168.097160 | 17.124402 | 1
synthetic | SYNTHETIC-DEMO-ONLY | synthetic-068 | test | 55 | 193.467202 | 53.252017 | 1
synthetic | SYNTHETIC-DEMO-ONLY | synthetic-069 | test | 55 | 219.010038 | 89.185100 | 1
synthetic | SYNTHETIC-DEMO-ONLY | synthetic-070 | test | 55 | 261.589961 | 120.291164 | 2
synthetic | SYNTHETIC-DEMO-ONLY | synthetic-071 | test | 55 | 286.938080 | 156.408305 | 2
synthetic | SYNTHETIC-DEMO-ONLY | synthetic-072 | test | 55 | 312.576526 | 192.360895 | 2
synthetic | SYNTHETIC-DEMO-ONLY | synthetic-073 | test | 55 | 542.087765 | 429.993634 | 5
synthetic | SYNTHETIC-DEMO-ONLY | synthetic-074 | test | 55 | 567.391766 | 465.966660 | 5
synthetic | SYNTHETIC-DEMO-ONLY | synthetic-075 | test | 55 | 593.060875 | 502.026875 | 5
synthetic | SYNTHETIC-DEMO-ONLY | synthetic-076 | test | 55 | 1009.478480 | 946.003290 | 10
synthetic | SYNTHETIC-DEMO-ONLY | synthetic-077 | test | 55 | 1035.059279 | 981.953501 | 10
synthetic | SYNTHETIC-DEMO-ONLY | synthetic-078 | test | 55 | 1060.468918 | 1017.990293 | 10
synthetic | SYNTHETIC-DEMO-ONLY | synthetic-079 | test | 55 | 1476.882275 | 1461.981092 | 15
synthetic | SYNTHETIC-DEMO-ONLY | synthetic-080 | test | 55 | 1502.500674 | 1498.025060 | 15
synthetic | SYNTHETIC-DEMO-ONLY | synthetic-081 | test | 55 | 1528.109557 | 1534.036977 | 15
synthetic | SYNTHETIC-DEMO-ONLY | synthetic-082 | test | 55 | 1944.554249 | 1978.040672 | 20
synthetic | SYNTHETIC-DEMO-ONLY | synthetic-083 | test | 55 | 1970.029624 | 2014.056695 | 20
synthetic | SYNTHETIC-DEMO-ONLY | synthetic-084 | test | 55 | 1995.554395 | 2050.090264 | 20
