geyan21/yam-tactile-kit/engineering/release/l1/l1_test_map.png

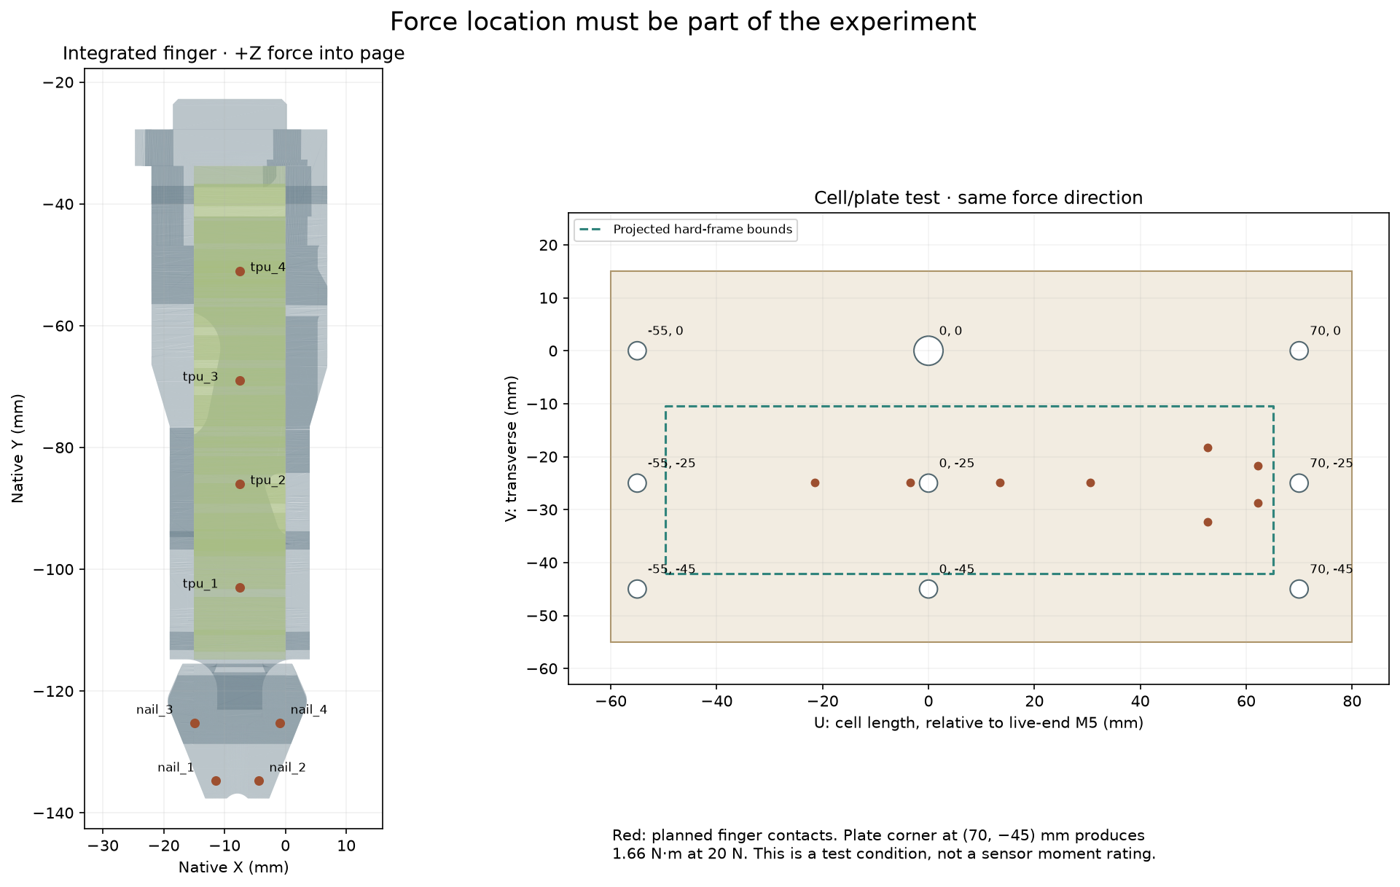
engineering/release/l1/l1_test_map.png
