geyan21/yam-tactile-kit/engineering/prototypes/force_button/history/STOPPED_SESSION_67979.md

# Intentionally stopped FB1 structural attempt

Recorded 2026-10-11 at 19:30:24 UTC, immediately after the stop.

- Owned unified execution session: `67979`.
- Command: `/home/geyan/projects/flex-pi_release/yam-tactile-kit/build/repo/build/engineering/tools/cad-venv/bin/python engineering/scripts/run_force_button_fea.py build/engineering/prototypes/force_button/cad_runs/20261011T191838.967011Z --fit-check build/engineering/prototypes/force_button/fit_checks/20261011T192045.263484Z/report.json --mesh-mm 2 --leaf-mm 0.65 --sensor-compliance 0.0001`
- Started around 19:21:42 UTC. No completed mesh, solver log or result was produced.
- Sent Ctrl-C through the owning execution session. The tool reported terminal exit code **130**.
- No PID was exposed by the execution tool; two searches restricted to this script found no visible process. No process outside the owning session was signaled.
- Reason: more than eight minutes without a mesh result or progress output. A new attempt will use progress logging and a parent process with a declared timeout.
- The partial input directory is retained. This attempt establishes no structural result.
