geyan21/yam-tactile-kit/engineering/development/f1/mechanics/history/previous_crossing/README.md

# Preserved crossing example

These are the two exact tail solids involved in the earlier CH2-column / CH3-row crossing. Their common volume was 0.03376448474123263 mm³. The complete earlier report is `../../checks/previous_crossing_failure.json`. The original manifest retains provenance for that older run; only its two involved CAD parts are copied into this example. Current fit files are under `../../cad/` and `../../patterns/`.
