geyan21/yam-tactile-kit/engineering/concepts/concept_review.pdf

## B2 concept: one rigid board, same five magnetic head poses

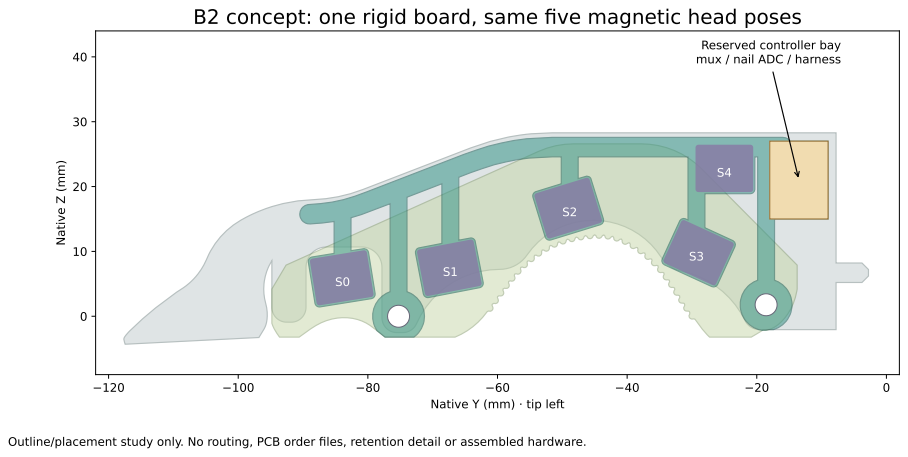
[picture p230: page 1]
Native Z (mm)

Reserved controller bay
mux / nail ADC / harness

Native Y (mm) · tip left

Outline/placement study only. No routing, PCB order files, retention detail or assembled hardware.

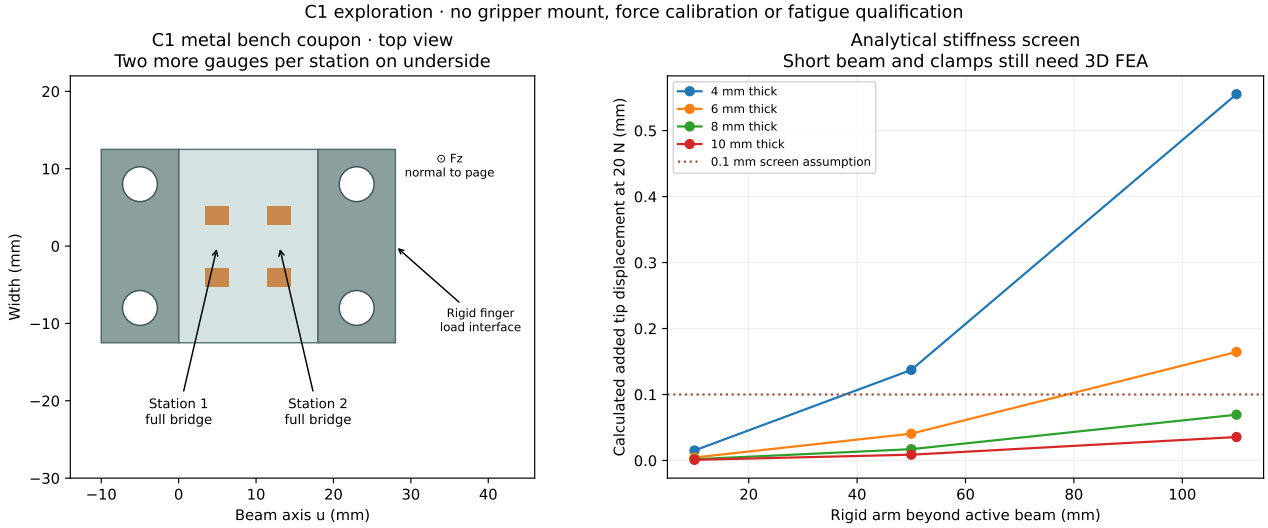
[picture p231: page 2]
Width (mm); Station 1 full bridge; Station 2 full bridge; Rigid finger; load interface

C1 exploration · no gripper mount, force calibration or fatigue qualification

Analytical stiffness screen

C1 metal bench coupon · top view
Two more gauges per station on underside

Short beam and clamps still need 3D FEA

4 mm 6 mm 8 mm | thick thick thick

Calculated added tip displacement at 20 N (mm)

10 mm thick 0.1 mm screen assumption

normal to page

Beam axis u (mm)

Rigid arm beyond active beam (mm)
