geyan21/yam-tactile-kit/engineering/prototypes/optical/visuals/o1_refraction.pdf

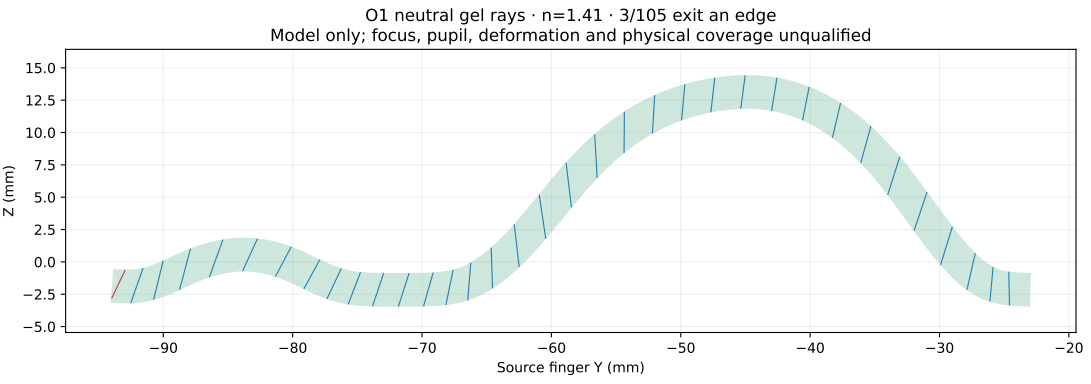
[picture p232: page 1]

O1 neutral gel rays · n=1.41 · 3/105 exit an edge

Model only; focus, pupil, deformation and physical coverage unqualified

Source finger Y (mm)
