geyan21/yam-tactile-kit/engineering/prototypes/optical/visuals/o1_sensor_placement.pdf

### O1.0 • sensor placement and folded camera view

Nominal CAD section; blue lines are viewing rays. No physical force or optical qualification.

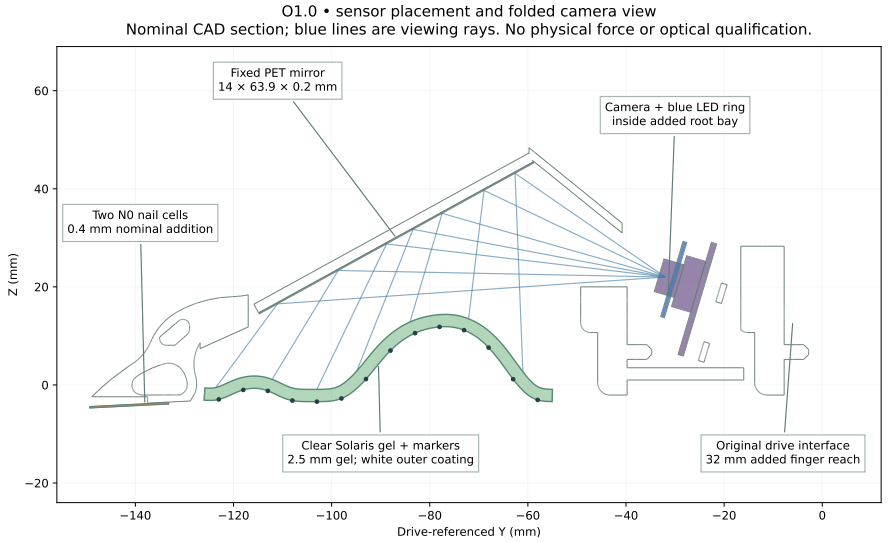
[picture p233: page 1]
Clear; Solaris gel + markers; gel; white outer; coating; mm added finger reach

Fixed PET mirror 14 | × 63.9 × 0.2 mm

Camera + blue LED ring inside added root bay

Two N0 0.4 mm nominal addition | nail cells

Original drive interface

Drive-referenced Y (mm)
