geyan21/yam-tactile-kit/engineering/prototypes/pneumatic/visuals/p1_assembly.pdf

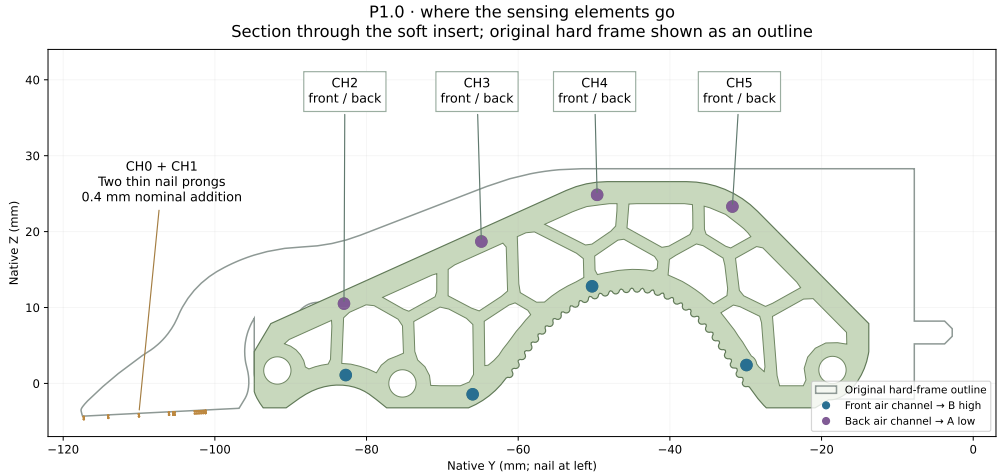
[picture p234: page 1]
Native Z (mm)

P1.0 · where the sensing elements go

Section through the soft insert; original hard frame shown as an outline

CH2 front / back | CH3 front / back | CH4 front / back | CH5 front / back

CH0 + CH1 Two thin nail prongs 0.4 mm nominal addition

Original hard-frame outline
Front air channel → B high
Back air channel → A low

Native Y (mm; nail at left)
