geyan21/yam-tactile-kit/engineering/prototypes/capacitive/visuals/assembly_sensitivity.pdf

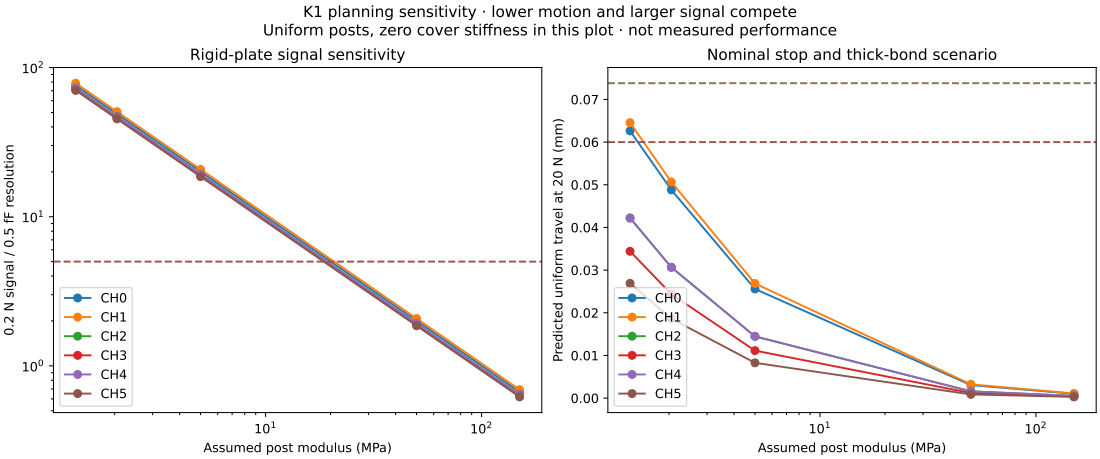
[picture p235: page 1]

K1 planning sensitivity · lower motion and larger signal compete
Uniform posts, zero cover stiffness in this plot · not measured performance

Rigid-plate signal sensitivity

Nominal stop and thick-bond scenario

Predicted uniform travel at 20 N (mm)

0.2 N signal / 0.5 fF resolution

Assumed post modulus (MPa)
