geyan21/yam-tactile-kit/engineering/development/f1/r3/visuals/carrier_assembly.pdf

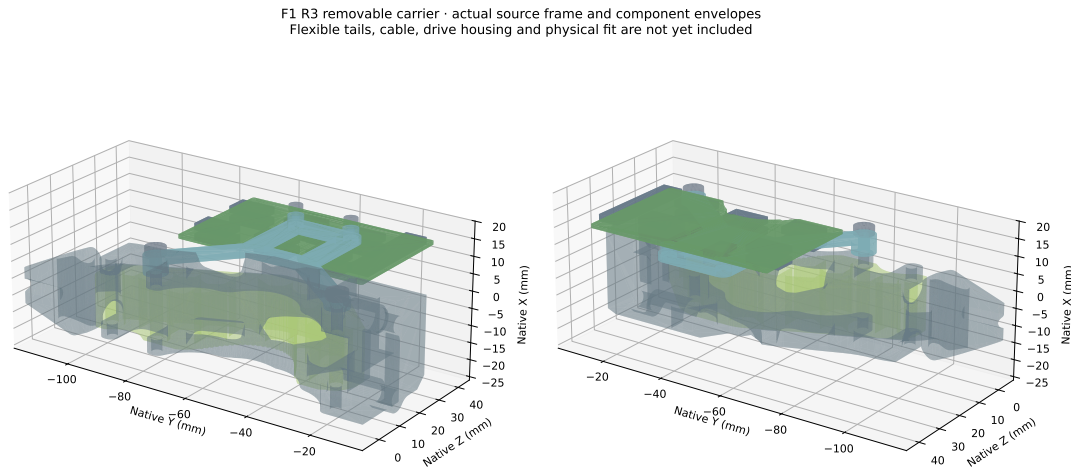
[picture p236: page 1]
Native Y (mm); 40 Native Z (mm); Native X (mm); 40 Native Z ⁽mm⁾

F1 R3 removable carrier · actual source frame and component envelopes
Flexible tails, cable, drive housing and physical fit are not yet included
