geyan21/yam-tactile-kit/engineering/development/f1/r3/visuals/nominal_assembly.pdf

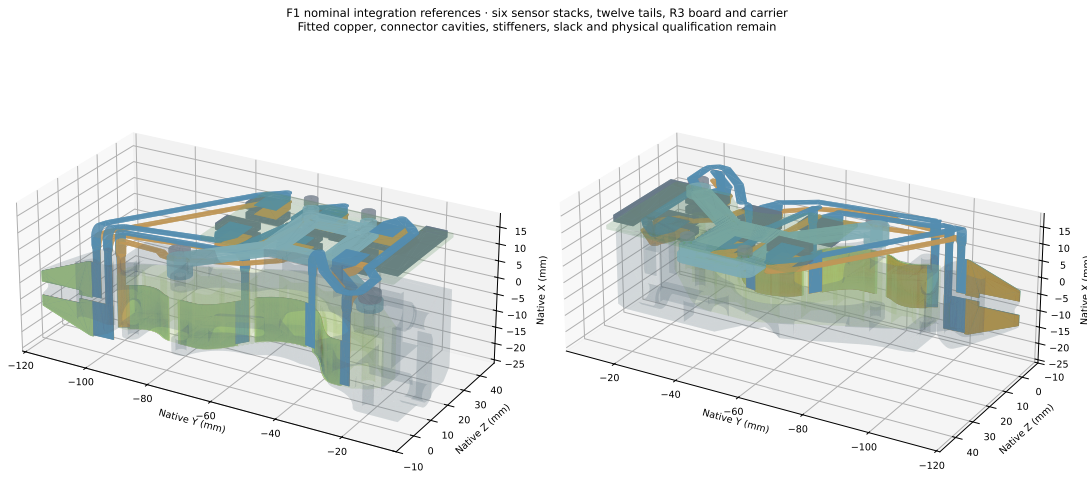
[picture p237: page 1]
Native Y (mm); 40 Native Z (mm); Native X (mm); 40 Native Z ⁽mm⁾

F1 nominal integration references · six sensor stacks, twelve tails, R3 board and carrier
Fitted copper, connector cavities, stiffeners, slack and physical qualification remain
