geyan21/yam-tactile-kit/engineering/development/f1/mechanics/visuals/exit_sections.pdf

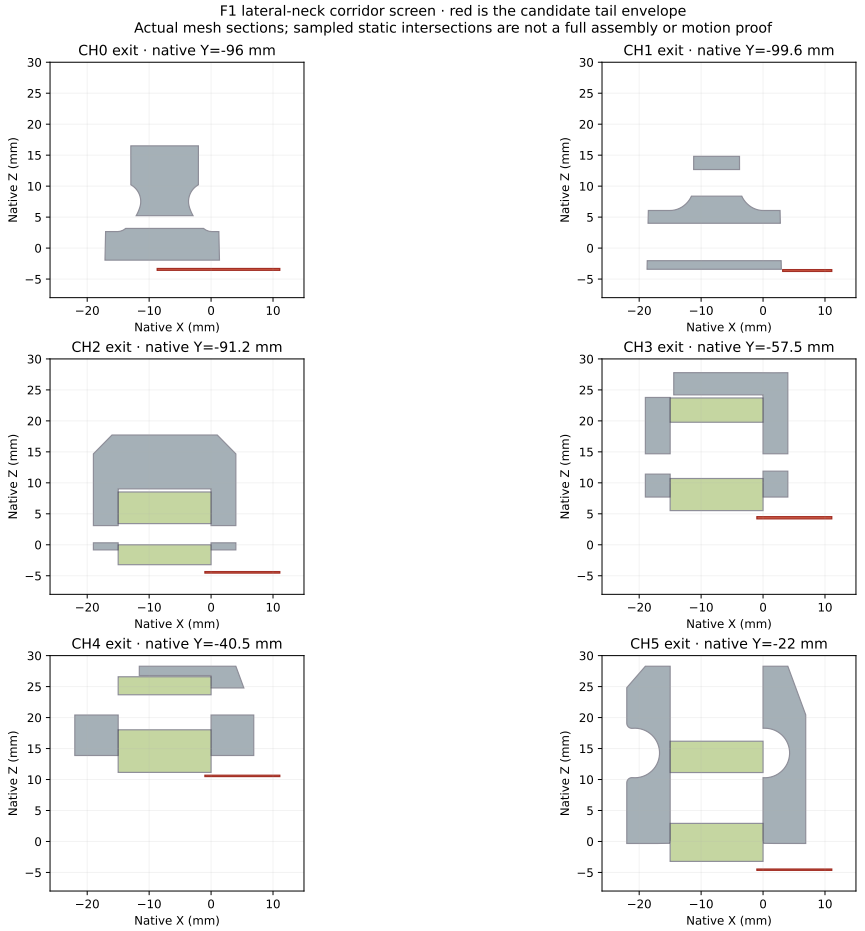
[picture p238: page 1]
Native X (mm); Native Z (mm)

F1 lateral-neck corridor screen · red is the candidate tail envelope

Actual mesh sections; sampled static intersections are not a full assembly or motion proof

CH0 exit · native Y=-96 mm

CH1 exit · native Y=-99.6 mm

CH2 exit · native Y=-91.2 mm

CH3 exit · native Y=-57.5 mm

CH4 exit · native Y=-40.5 mm

CH5 exit · native Y=-22 mm
