geyan21/yam-tactile-kit/engineering/development/f1/mechanics/visuals/stack_bodies.pdf

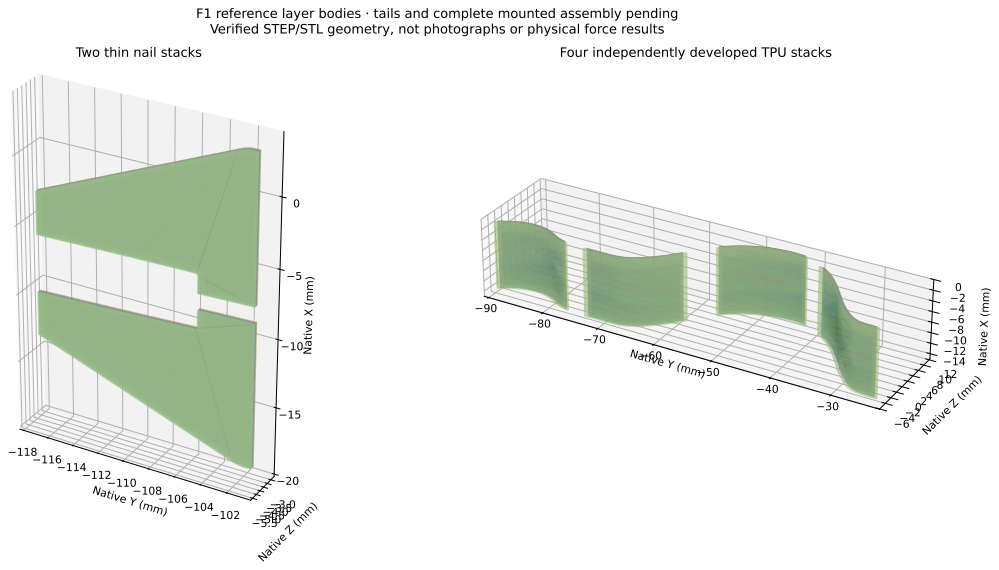
[picture p239: page 1]
Native Y (mm); −−5.5 −5.0 −4.5 −4.0 −3.53.0 Native Z ⁽mm⁾; Native X (mm); Native Y (mm) −6; 1012 Native Z ⁽mm⁾

F1 reference layer bodies · tails and complete mounted assembly pending
Verified STEP/STL geometry, not photographs or physical force results

Two thin nail stacks

Four independently developed TPU stacks
