geyan21/yam-tactile-kit/engineering/development/f1/mechanics/visuals/stack_surfaces.pdf

### F1 mounted layer references · geometry development Separate conductor cut lengths; no fitted tails or physical performance claim

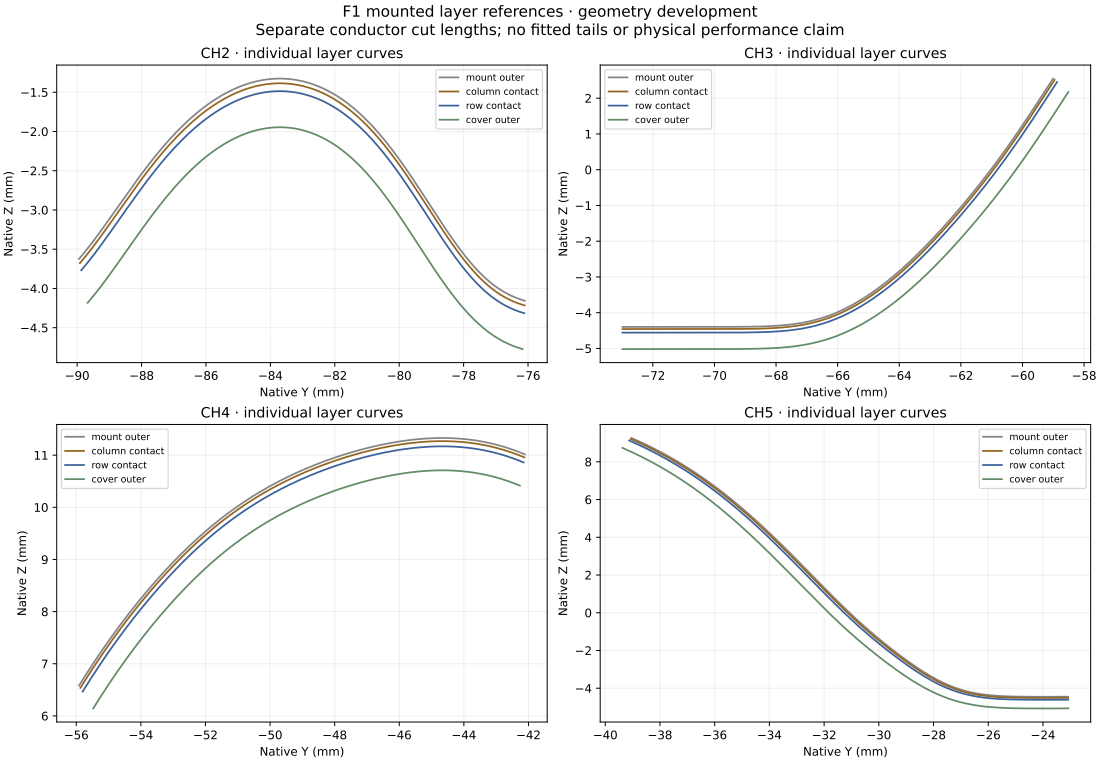
[picture p240: page 1]
Native Z (mm); mount outer column contact; Native Y (mm); mount outer column contact row contact cover outer

CH2 · individual layer curves

CH3 · individual layer curves

row contact cover outer

Native Y (mm)
CH4 · individual layer curves

CH5 · individual layer curves
