geyan21/yam-tactile-kit/engineering/development/f1/mechanics/visuals/tab_placement.pdf

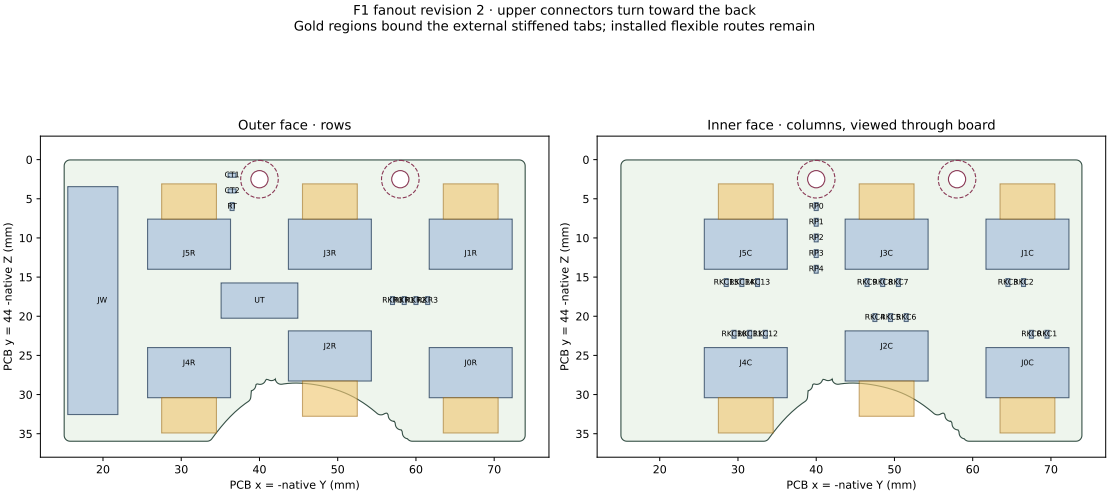
[picture p241: page 1]
RKR0RKR1RKR2RKR3; RKC0RKC1; RKC3RKC2; RKC4RKC5RKC6; RKC9RKC8RKC7; RKC10RKC11RKC12; RKC15RKC14RKC13

F1 fanout revision 2 · upper connectors turn toward the back

Gold regions bound the external stiffened tabs; installed flexible routes remain

Outer face · rows

Inner face · columns, viewed through board

PCB y = 44 -native Z (mm)

PCB x = -native Y (mm)
