geyan21/yam-tactile-kit/engineering/development/f1/readout-study/visuals/feedback_results.pdf

### F1 selected-column feedback · manufacturer-model simulation 96 AC cases + 8 current-step cases · no physical force measurements

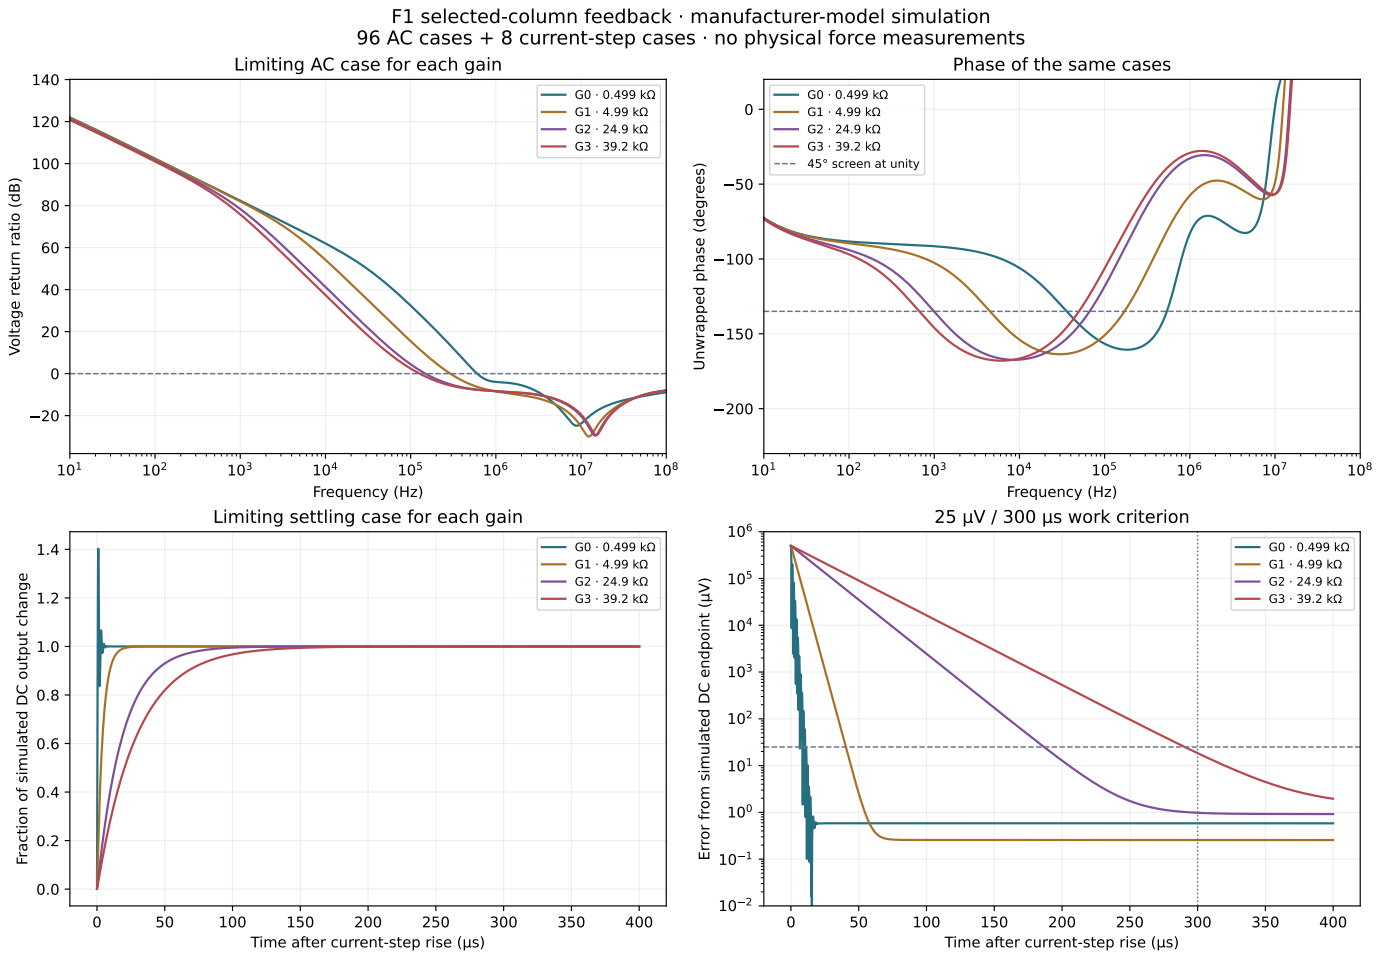
[picture p242: page 1]
Frequency (Hz); 45° screen at unity

Limiting AC case for each gain

Phase of the same cases

Unwrapped phase (degrees)

Voltage return ratio (dB)

Limiting settling case for each gain

25 µV / 300 µs work criterion

Fraction of simulated DC output change

Error from simulated DC endpoint (µV)

Time after current-step rise (µs)
