geyan21/yam-tactile-kit/engineering/release/l1/l1_review_drawings.pdf

# l1 fixed carrier m3 clearance

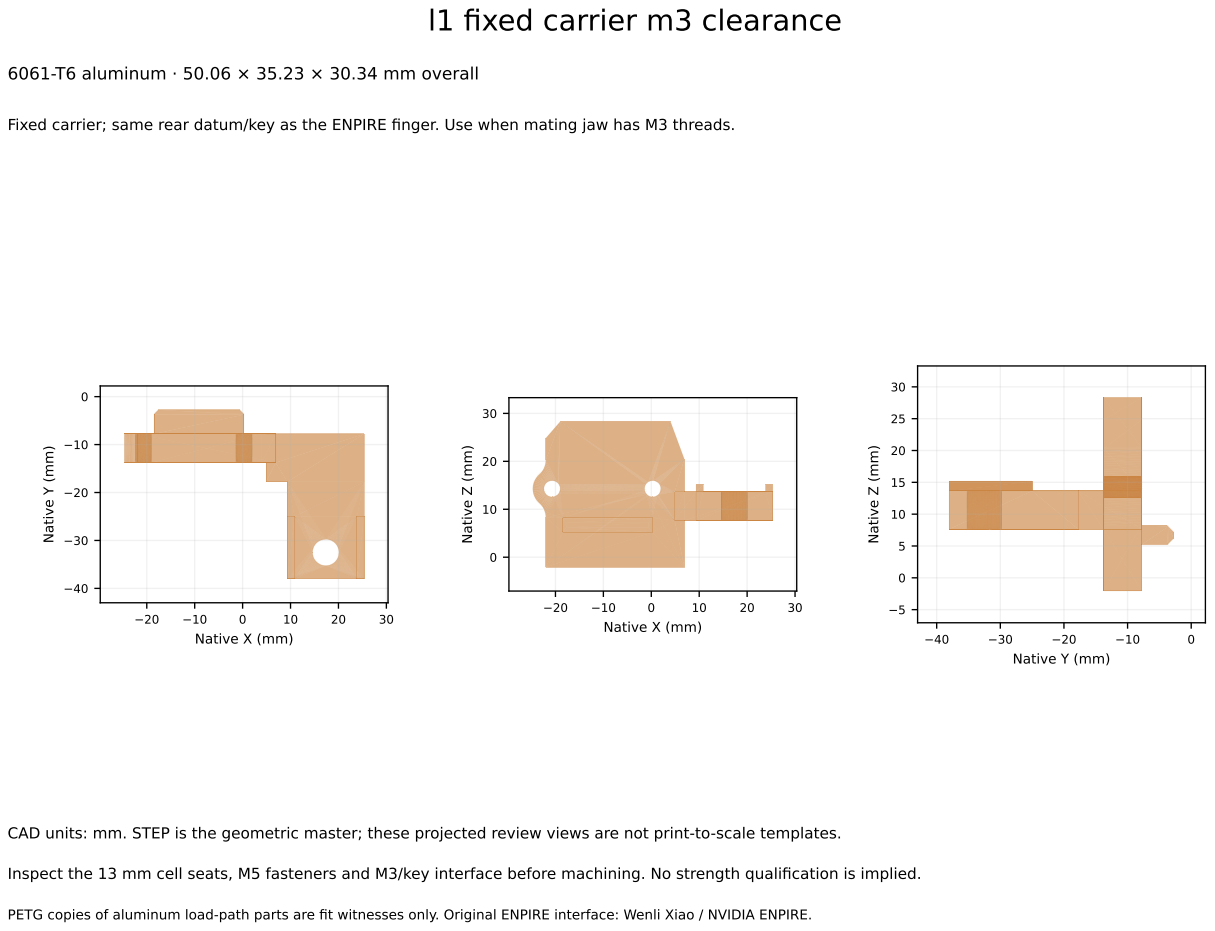
[picture p250: page 1]
Native X (mm); Native Y (mm); Native Z (mm)

6061-T6 aluminum · 50.06 × 35.23 × 30.34 mm overall

Fixed carrier; same rear datum/key as the ENPIRE finger. Use when mating jaw has M3 threads.

CAD units: mm. STEP is the geometric master; these projected review views are not print-to-scale templates.

Inspect the 13 mm cell seats, M5 fasteners and M3/key interface before machining. No strength qualification is implied.

PETG copies of aluminum load-path parts are fit witnesses only. Original ENPIRE interface: Wenli Xiao / NVIDIA ENPIRE.

# l1 fixed carrier m3 tap drill

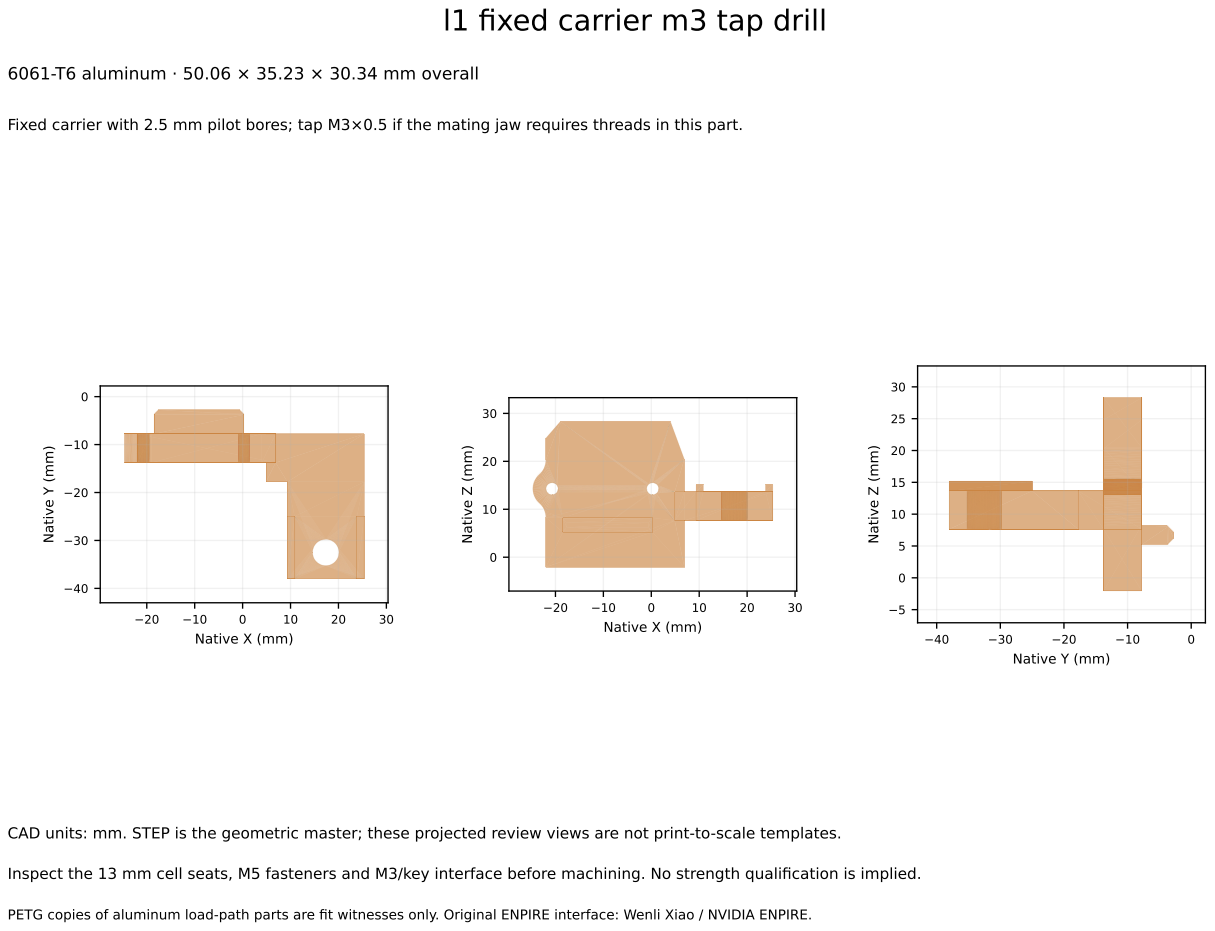
[picture p251: page 2]
Native X (mm); Native Y (mm); Native Z (mm)

6061-T6 aluminum · 50.06 × 35.23 × 30.34 mm overall

Fixed carrier with 2.5 mm pilot bores; tap M3×0.5 if the mating jaw requires threads in this part.

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

# l1 floating finger carrier

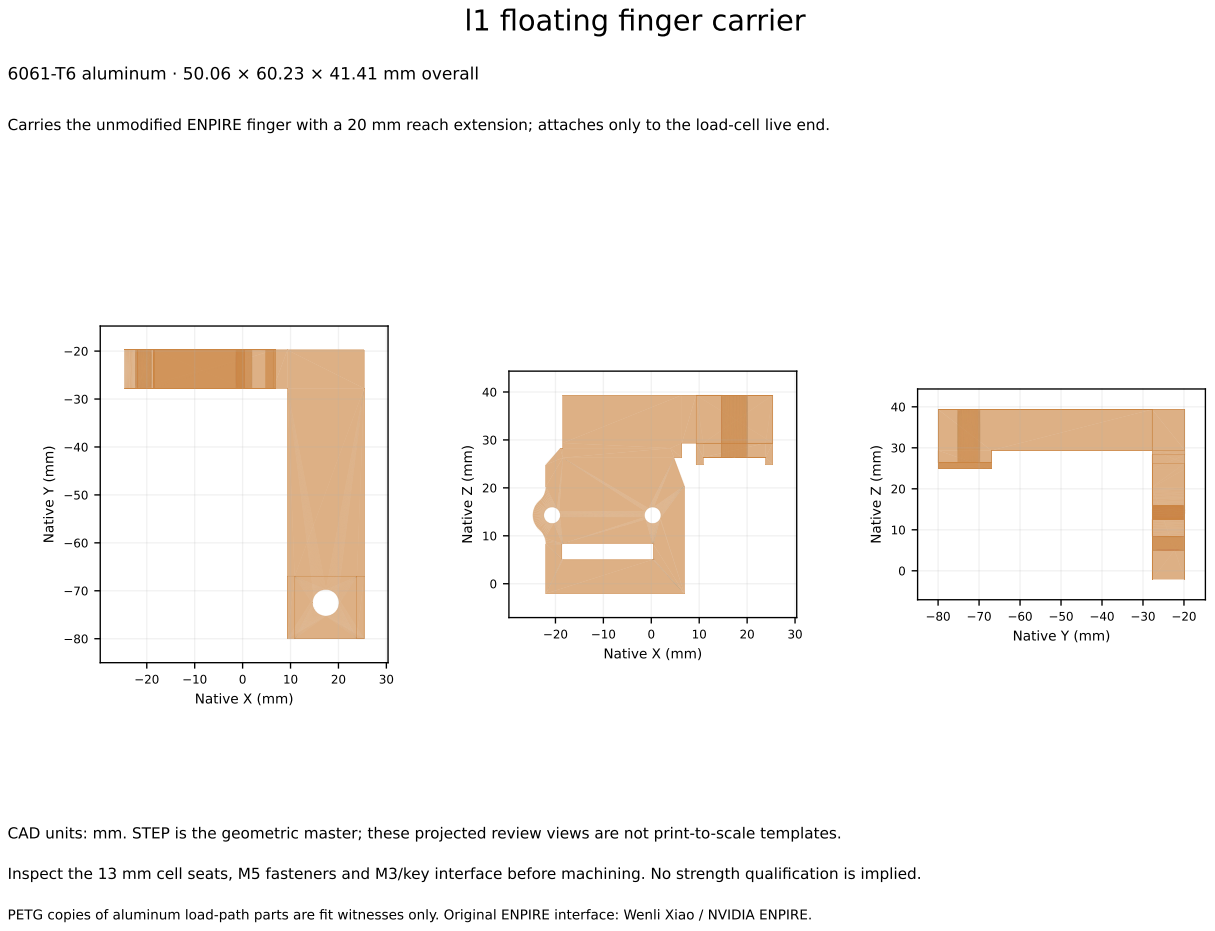
[picture p252: page 3]
Native X (mm); Native Y (mm); Native Z (mm)

6061-T6 aluminum · 50.06 × 60.23 × 41.41 mm overall

Carries the unmodified ENPIRE finger with a 20 mm reach extension; attaches only to the load-cell live end.

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

# tal220b reference

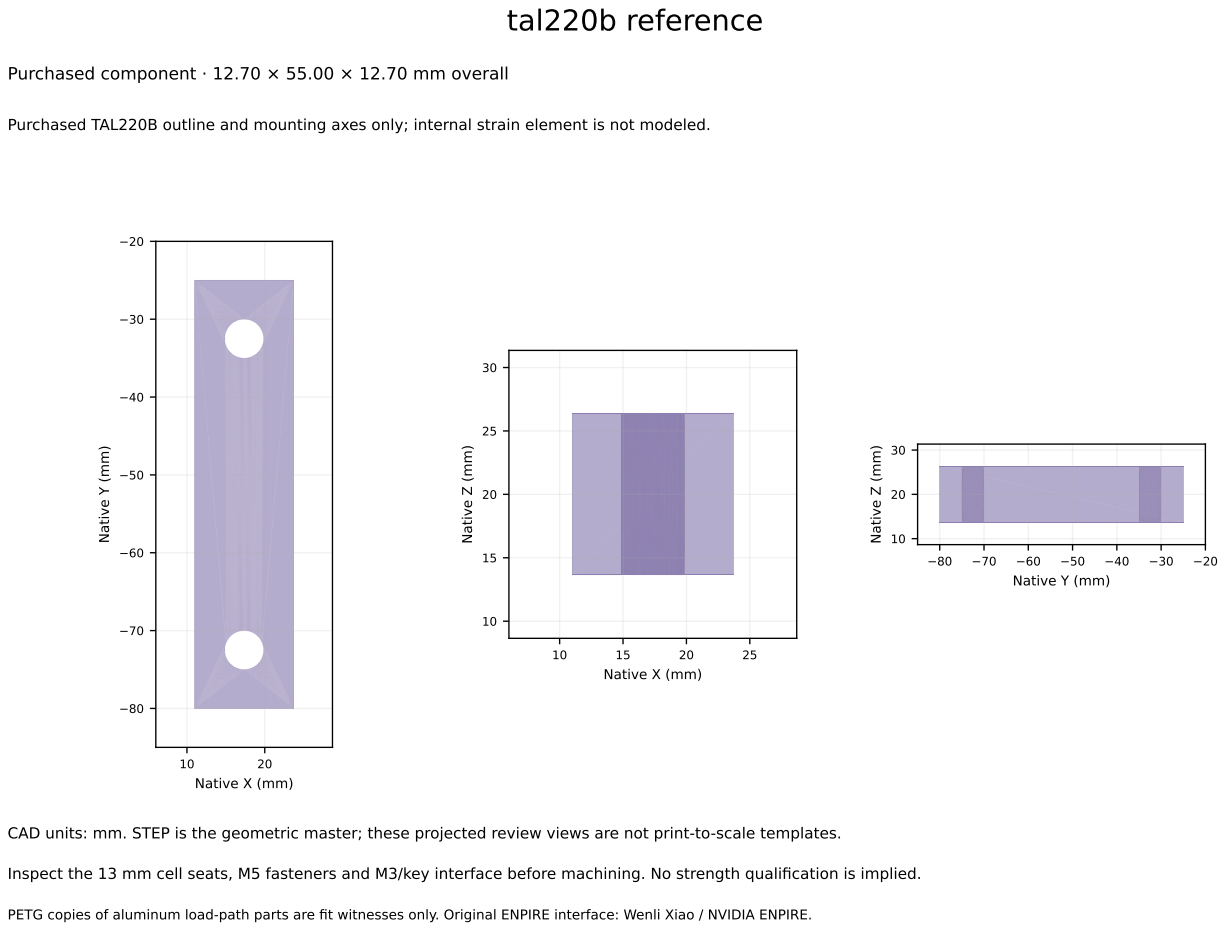
[picture p253: page 4]
Native X (mm); Native Y (mm); Native Z (mm)

Purchased component · 12.70 × 55.00 × 12.70 mm overall

Purchased TAL220B outline and mounting axes only; internal strain element is not modeled.

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

# l1 bench fixed shoe

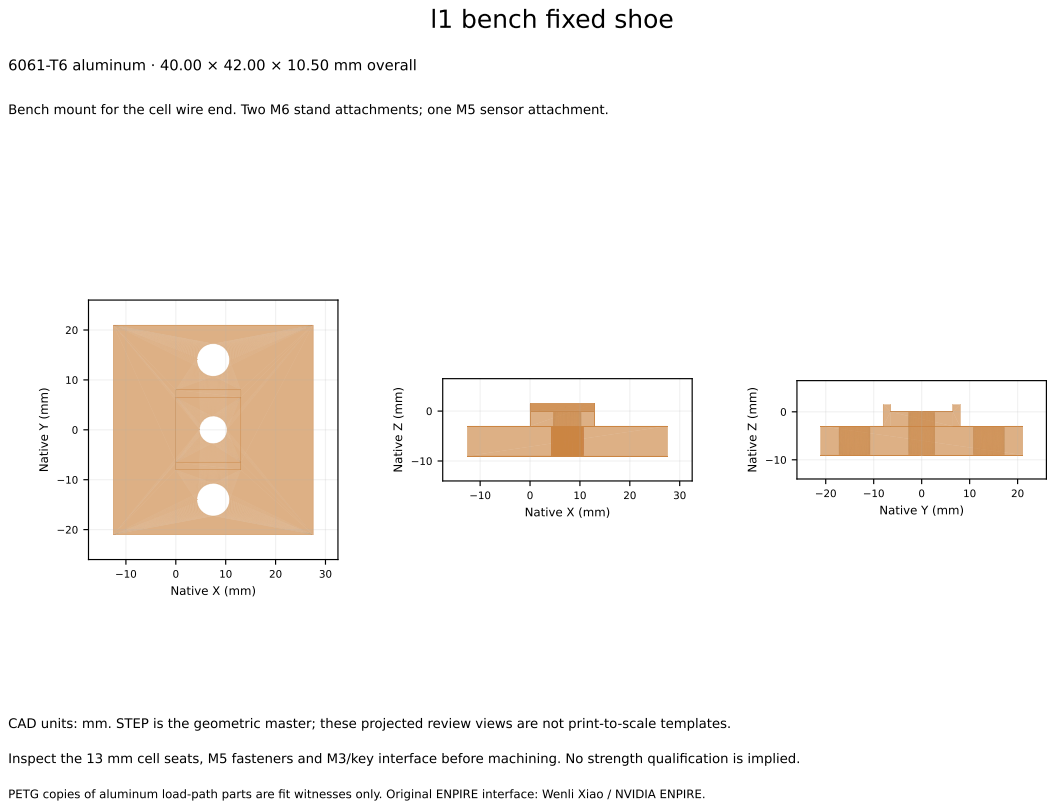
[picture p254: page 5]
Native X (mm); Native Y (mm); Native Z (mm)

6061-T6 aluminum · 40.00 × 42.00 × 10.50 mm overall

Bench mount for the cell wire end. Two M6 stand attachments; one M5 sensor attachment.

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

# l1 bench live spacer

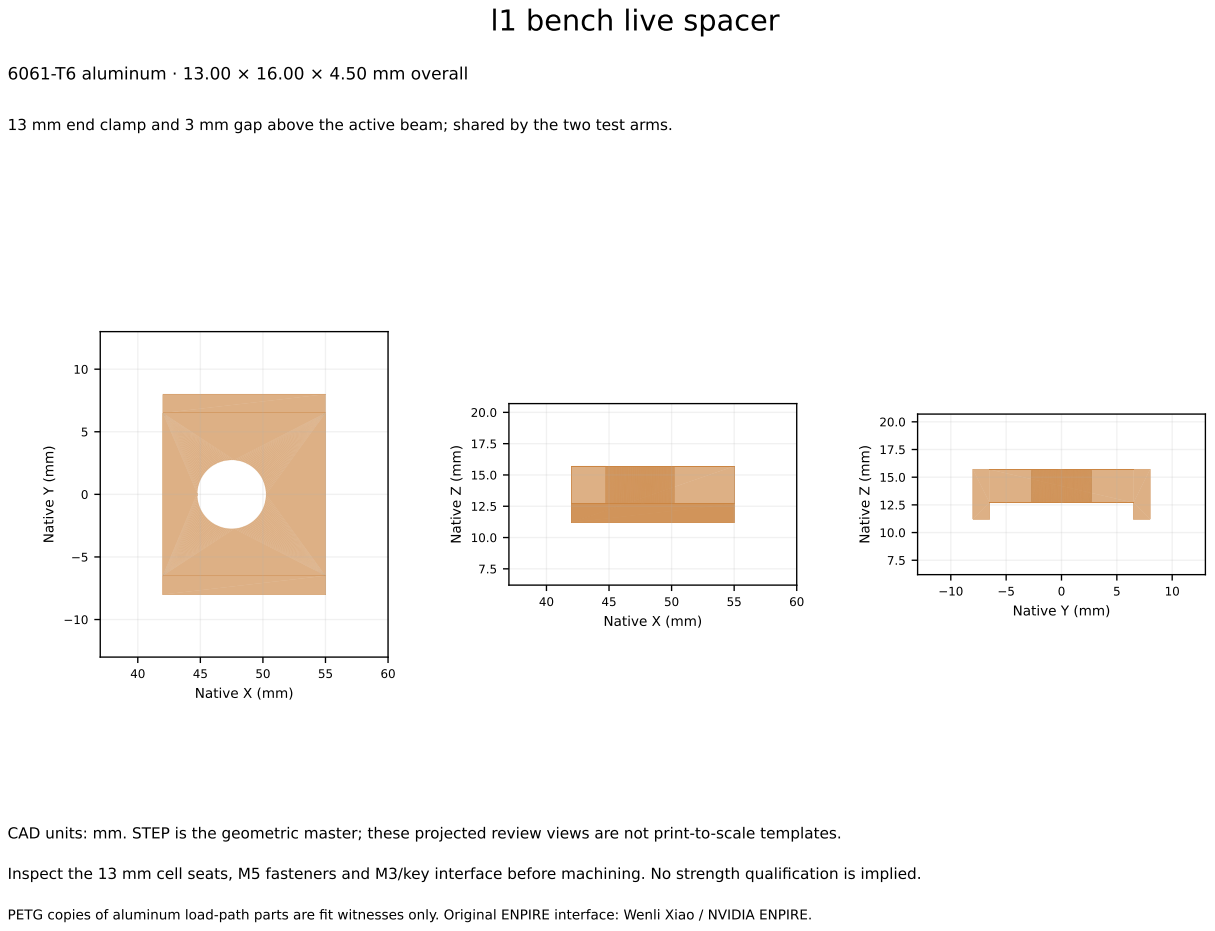
[picture p255: page 6]
Native X (mm); Native Y (mm); Native Z (mm)

6061-T6 aluminum · 13.00 × 16.00 × 4.50 mm overall

13 mm end clamp and 3 mm gap above the active beam; shared by the two test arms.

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

# l1 long test arm

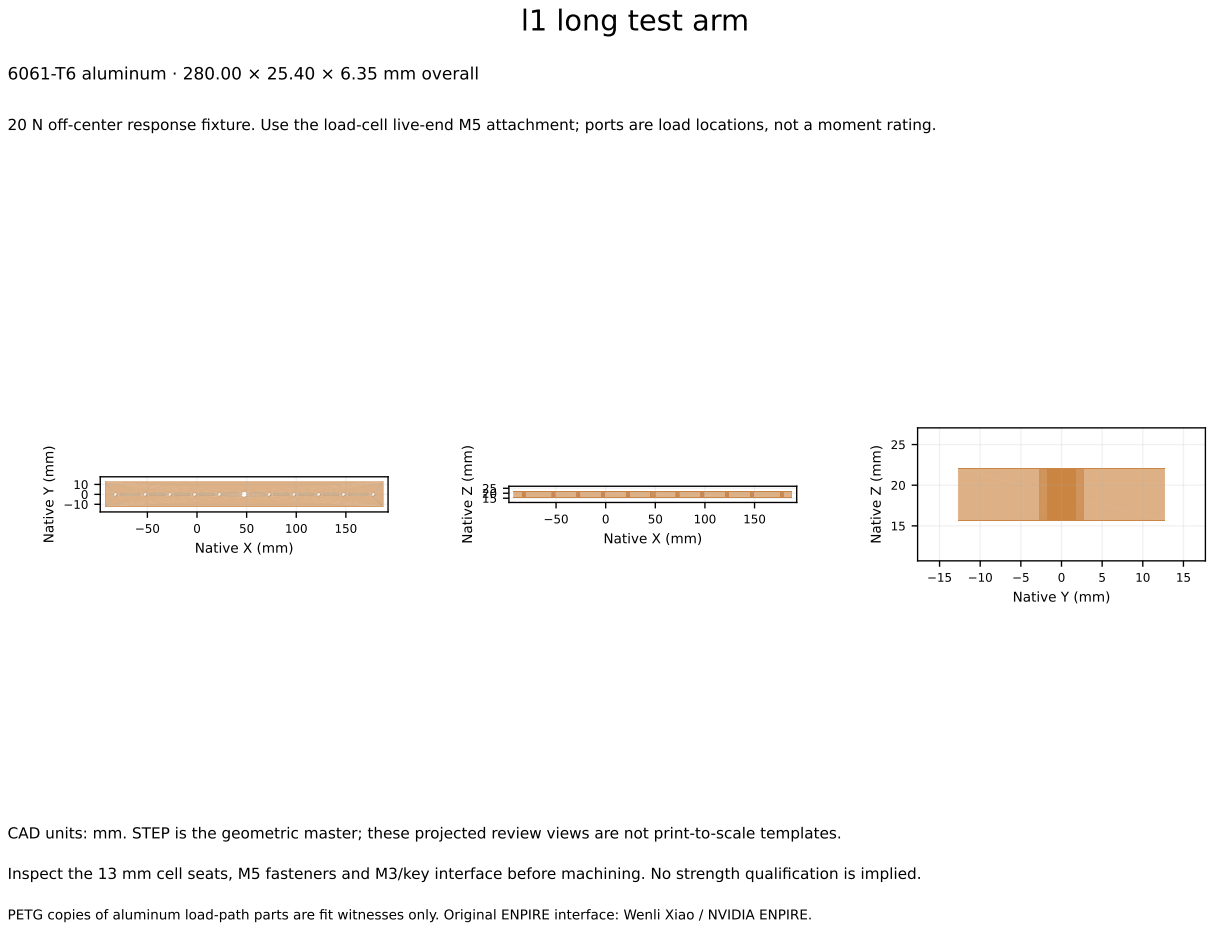
[picture p256: page 7]
Native X (mm); Native Y (mm); Native Z (mm)

6061-T6 aluminum · 280.00 × 25.40 × 6.35 mm overall

20 N off-center response fixture. Use the load-cell live-end M5 attachment; ports are load locations, not a moment rating.

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

# l1 cross test arm

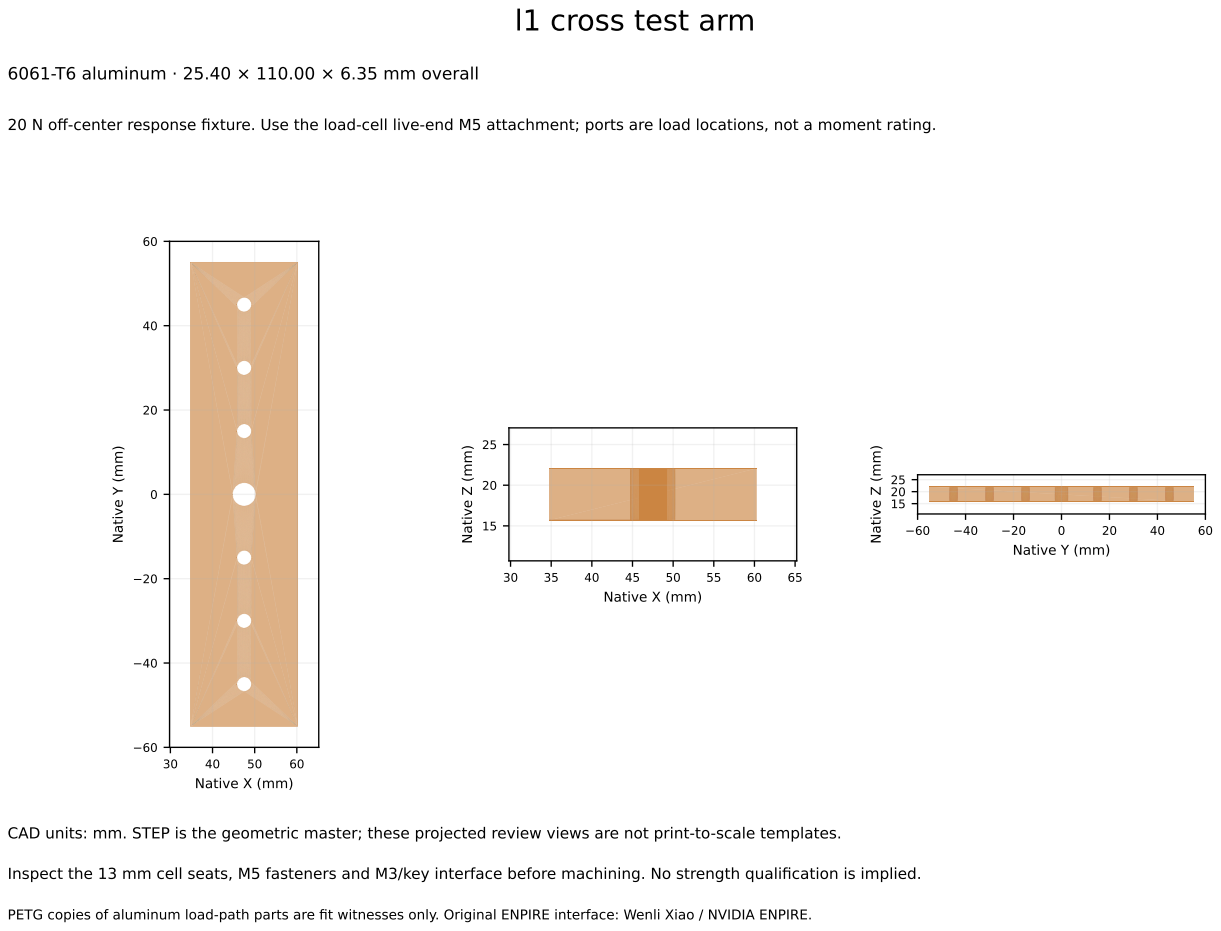
[picture p257: page 8]
Native X (mm); Native Y (mm); Native Z (mm)

6061-T6 aluminum · 25.40 × 110.00 × 6.35 mm overall

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

# l1 center load cap

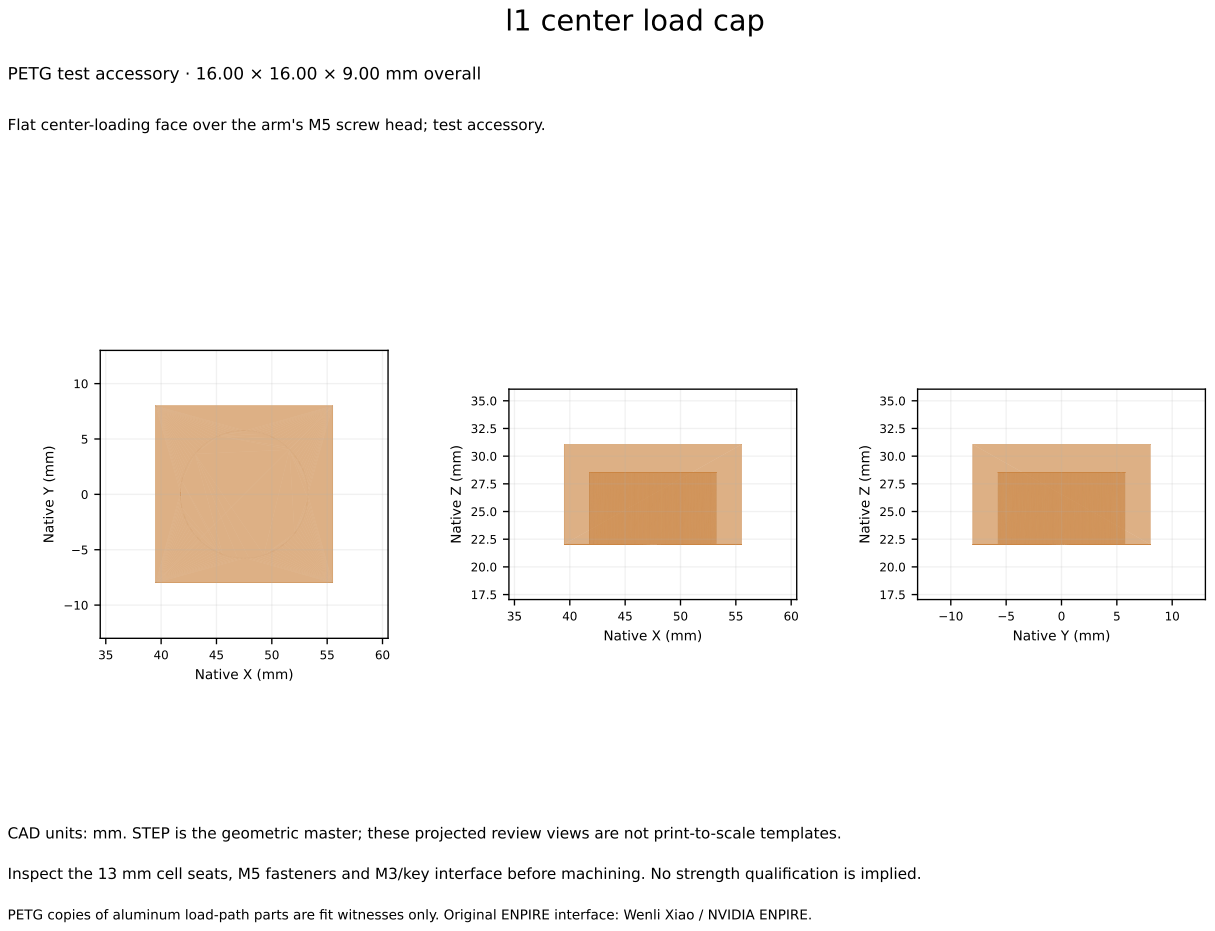
[picture p258: page 9]
Native X (mm); Native Y (mm); Native Z (mm)

PETG test accessory · 16.00 × 16.00 × 9.00 mm overall

Flat center-loading face over the arm's M5 screw head; test accessory.

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

# l1 combined load plate

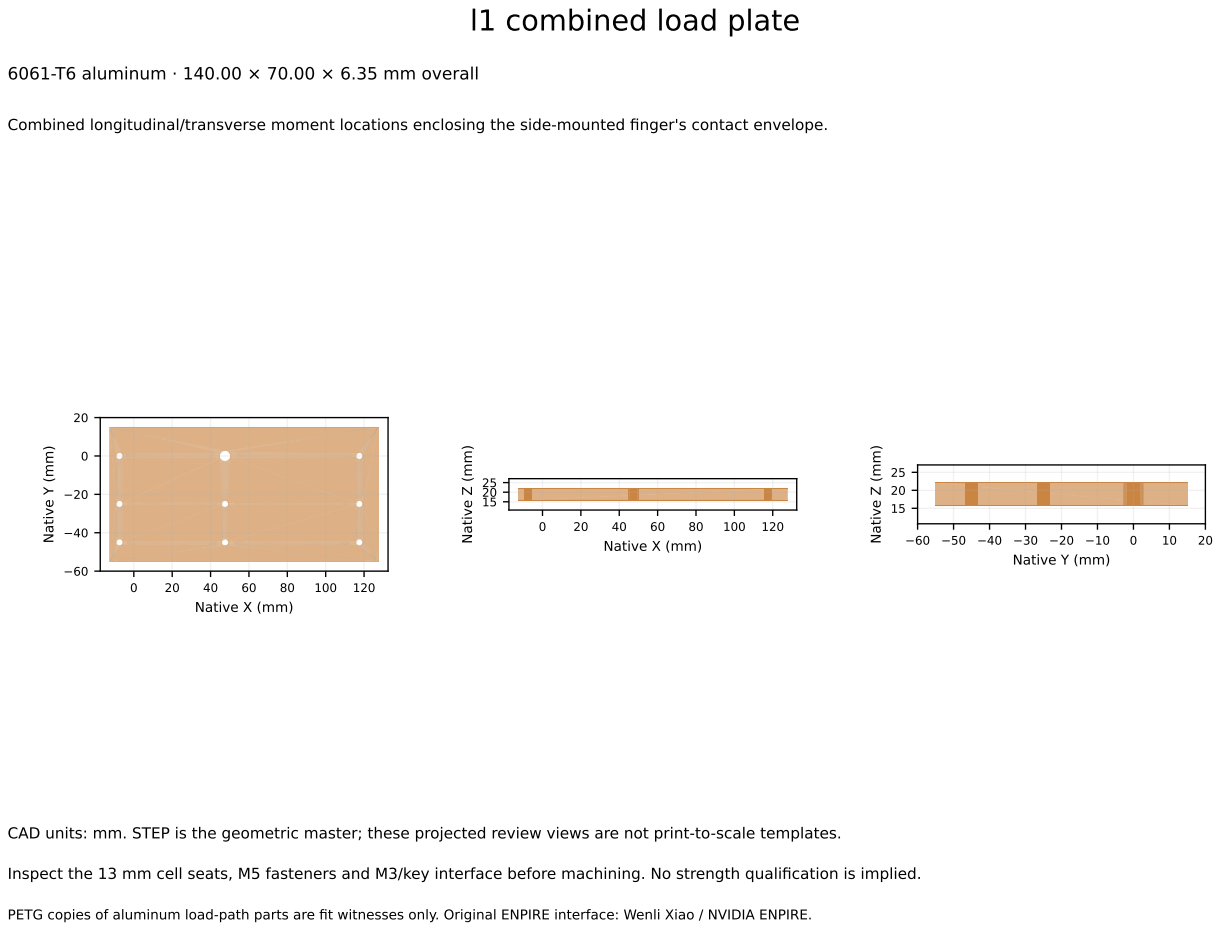
[picture p259: page 10]
Native X (mm); Native Y (mm); Native Z (mm)

6061-T6 aluminum · 140.00 × 70.00 × 6.35 mm overall

Combined longitudinal/transverse moment locations enclosing the side-mounted finger's contact envelope.

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
