geyan21/yam-tactile-kit/engineering/prototypes/pneumatic/patterns/r1_cut_sheet.pdf

# R1.0 — ENPIRE electrode and film cut sheet

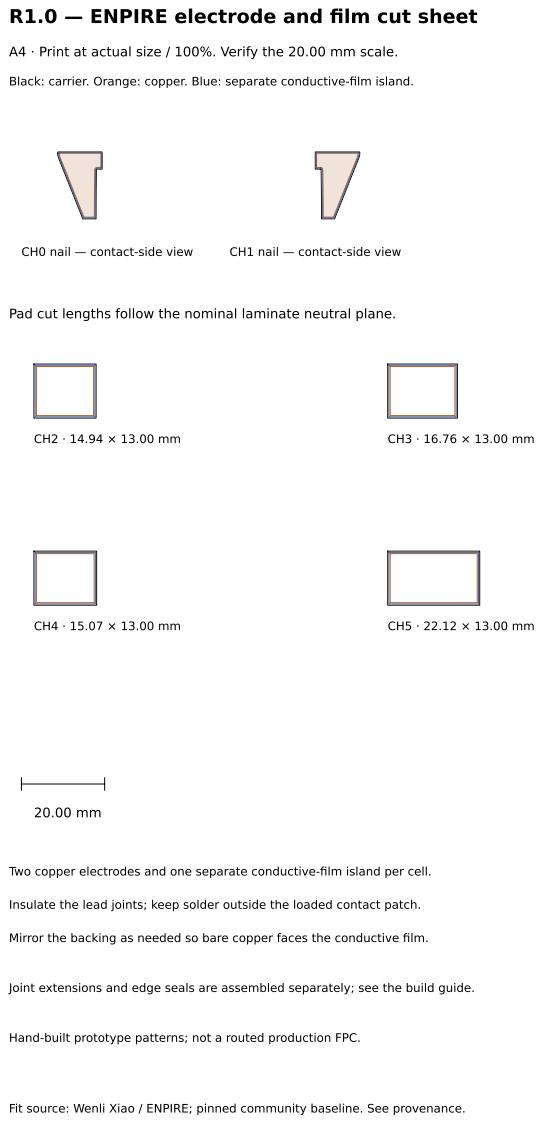
[picture p260: page 1]
CH0 nail — contact-side view; CH1 nail — contact-side view

A4 · Print at actual size / 100%. Verify the 20.00 mm scale.

Black: carrier. Orange: copper. Blue: separate conductive-film island.

Pad cut lengths follow the nominal laminate neutral plane.

Two copper electrodes and one separate conductive-film island per cell.

Insulate the lead joints; keep solder outside the loaded contact patch.

Mirror the backing as needed so bare copper faces the conductive film.

Joint extensions and edge seals are assembled separately; see the build guide.

Hand-built prototype patterns; not a routed production FPC.

Fit source: Wenli Xiao / ENPIRE; pinned community baseline. See provenance.
