geyan21/yam-tactile-kit/engineering/prototypes/pneumatic/visuals/p1_pressure_sensitivity.pdf

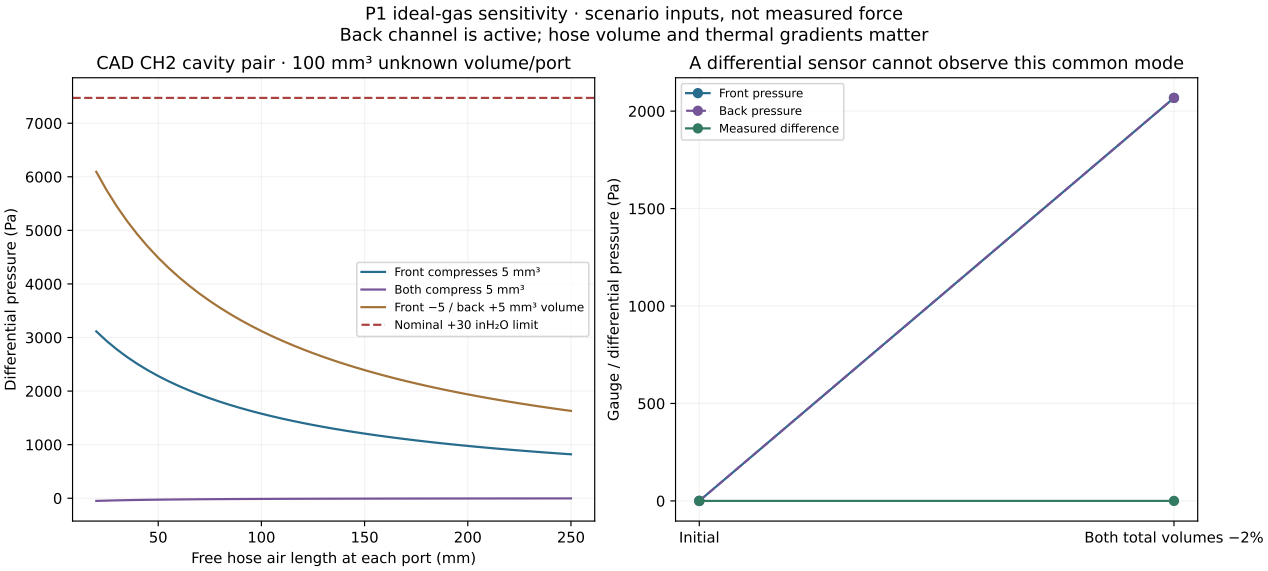
[picture p261: page 1]
Initial; Both total volumes −2%; Gauge / di

P1 ideal-gas sensitivity · scenario inputs, not measured force
Back channel is active; hose volume and thermal gradients matter

A differential sensor cannot observe this common mode

CAD CH2 cavity pair · 100 mm³ unknown volume/port

Front pressure Back pressure

Measured difference

fferential pressure (Pa)

Front compresses 5 mm³
Both compress 5 mm³ Front −5 / back +5 mm³ volume Nominal +30 inH₂O limit

Free hose air length at each port (mm)
