geyan21/yam-tactile-kit/engineering/prototypes/f1/visuals/routed_dc_screen.pdf

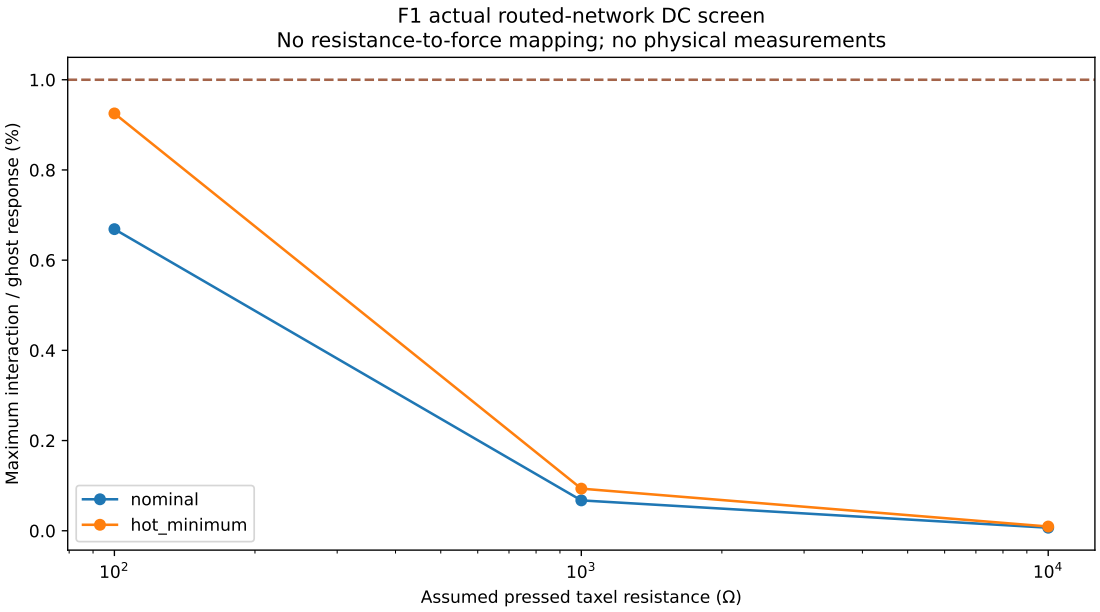
[picture p262: page 1]
nominal; hot_minimum

F1 actual routed-network DC screen

No resistance-to-force mapping; no physical measurements

Maximum interaction / ghost response (%)

Assumed pressed taxel resistance (
