geyan21/yam-tactile-kit/engineering/prototypes/force_button/visuals/fb1_structural_screen.pdf

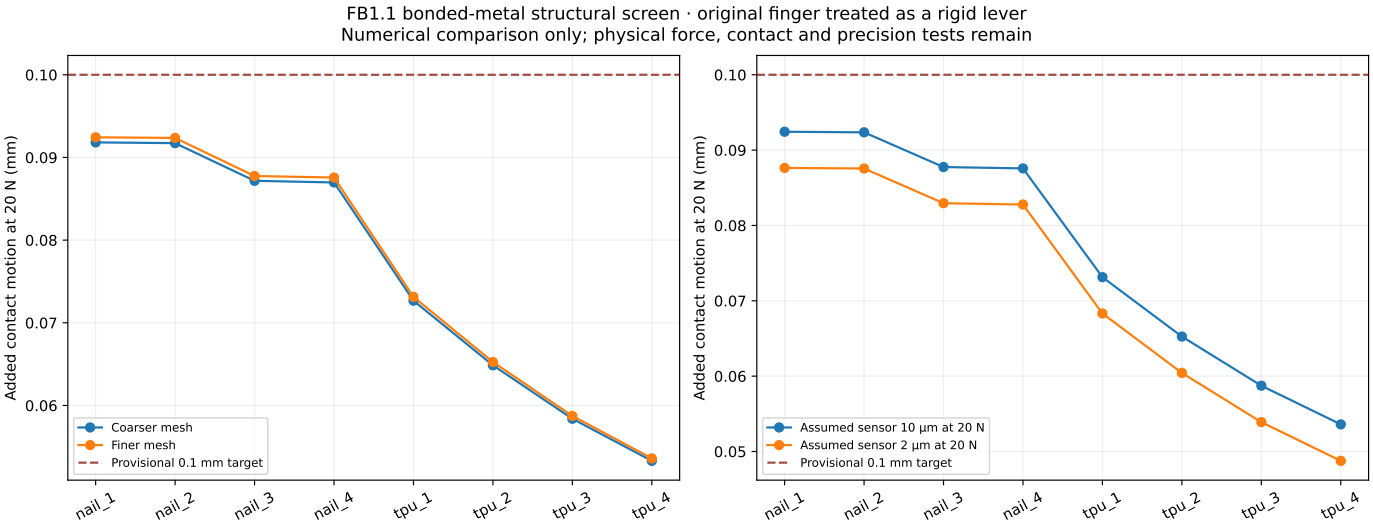
[picture p263: page 1]
nail_1; nail_2; nail_3; nail_4; tpu_1; tpu_2; tpu_3; tpu_4

FB1.1 bonded-metal structural screen · original finger treated as a rigid lever
Numerical comparison only; physical force, contact and precision tests remain

Added contact motion at 20 N (mm)

Coarser mesh Finer mesh Provisional | 0.1 mm target

Assumed sensor 10 µm Assumed sensor 2 µm at 20 N | | at 20 N

Provisional | 0.1 mm target
