geyan21/yam-tactile-kit/engineering/development/capacitive/k1/visuals/k1_cell_placement.pdf

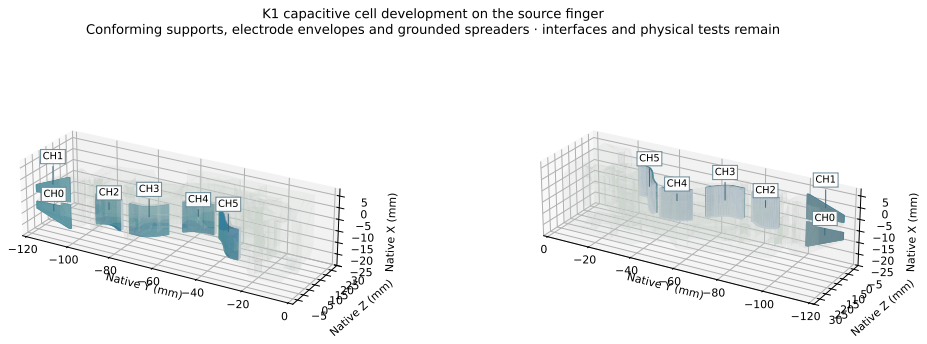
[picture p264: page 1]
Native Y (mm); 1015202530 Native Z ⁽mm⁾; Native X (mm); −5 05 10 15 20 25 30 Native Z ⁽mm⁾

K1 capacitive cell development on the source finger

Conforming supports, electrode envelopes and grounded spreaders · interfaces and physical tests remain
