geyan21/yam-tactile-kit/engineering/development/capacitive/k1/visuals/post_layout.pdf

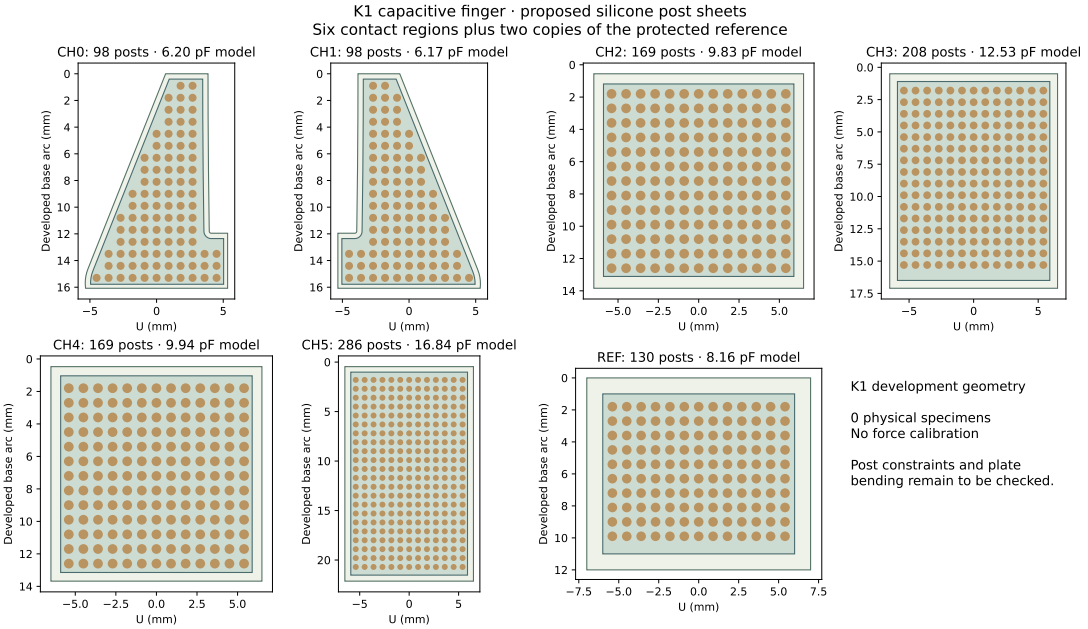
[picture p265: page 1]
CH0: 98 posts · 6.20 pF model; CH4: 169 posts · 9.94 pF model

K1 capacitive finger · proposed silicone post sheets
Six contact regions plus two copies of the protected reference
CH1: 98 posts · 6.17 pF model
CH5: 286 posts · 16.84 pF model

CH2: 169 posts · 9.83 pF model

CH3: 208 posts · 12.53 pF model

Developed base arc (mm)

REF: 130 posts · 8.16 pF model

K1 development geometry
0 physical specimens
No force calibration
Post constraints and plate
bending remain to be checked.
