geyan21/yam-tactile-kit/engineering/development/f1/fitted-foils-r3/review/fitted_contact_map.pdf

0

2

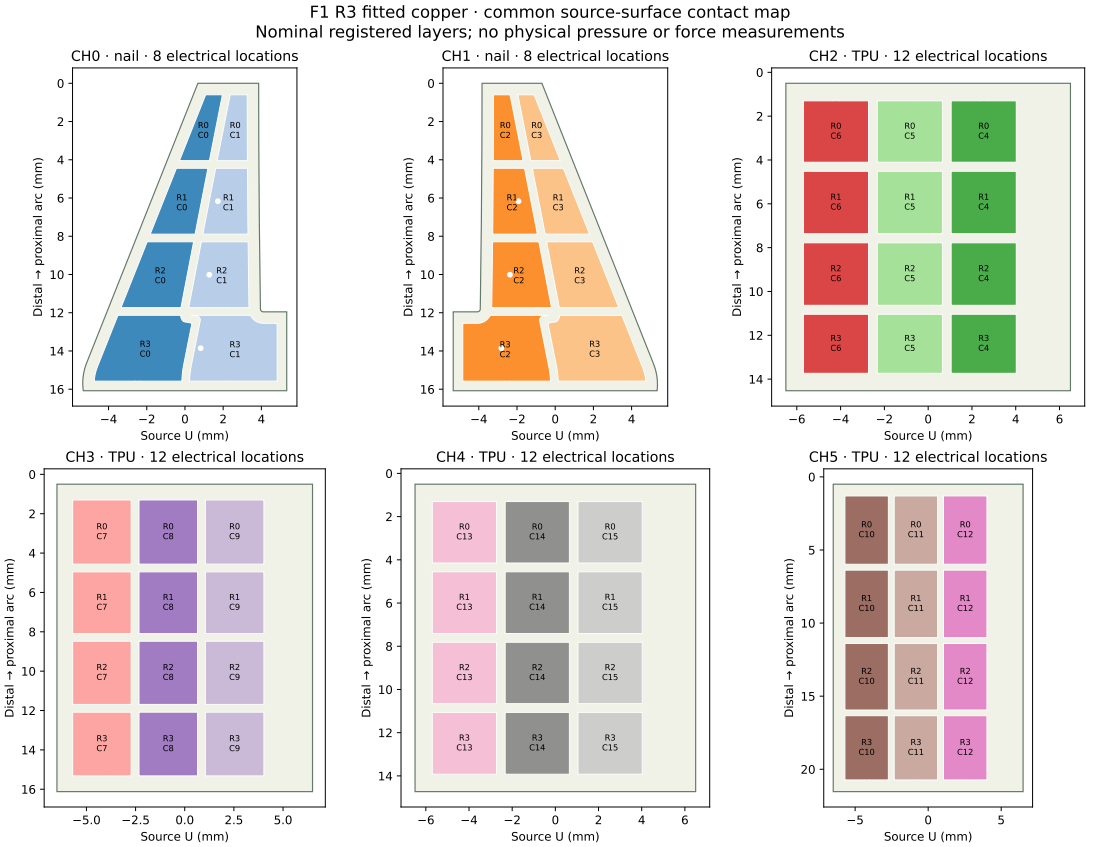
[picture p266: page 1]

F1 R3 fitted copper · common source-surface contact map
Nominal registered layers; no physical pressure or force measurements
