geyan21/yam-tactile-kit/engineering/development/f1/r3/visuals/placement.pdf

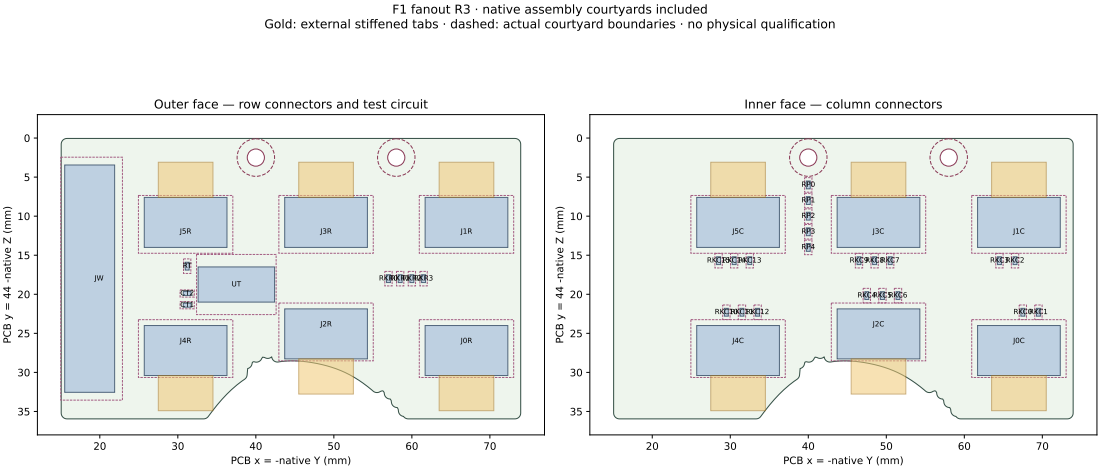
[picture p267: page 1]
RKR0RKR1RKR2RKR3; RKC0RKC1; RKC3RKC2; RKC4RKC5RKC6; RKC9RKC8RKC7; RKC10RKC11RKC12; RKC15RKC14RKC13

F1 fanout R3 · native assembly courtyards included

Gold: external stiffened tabs · dashed: actual courtyard boundaries · no physical qualification

Outer face — row connectors and test circuit

Inner face — column connectors

PCB y = 44 -native Z (mm)

PCB x = -native Y (mm)
