geyan21/yam-tactile-kit/engineering/development/f1/wrist/visuals/wrist_faces.pdf

## Front • F.Cu

## Rear • B.Cu, viewed from the back

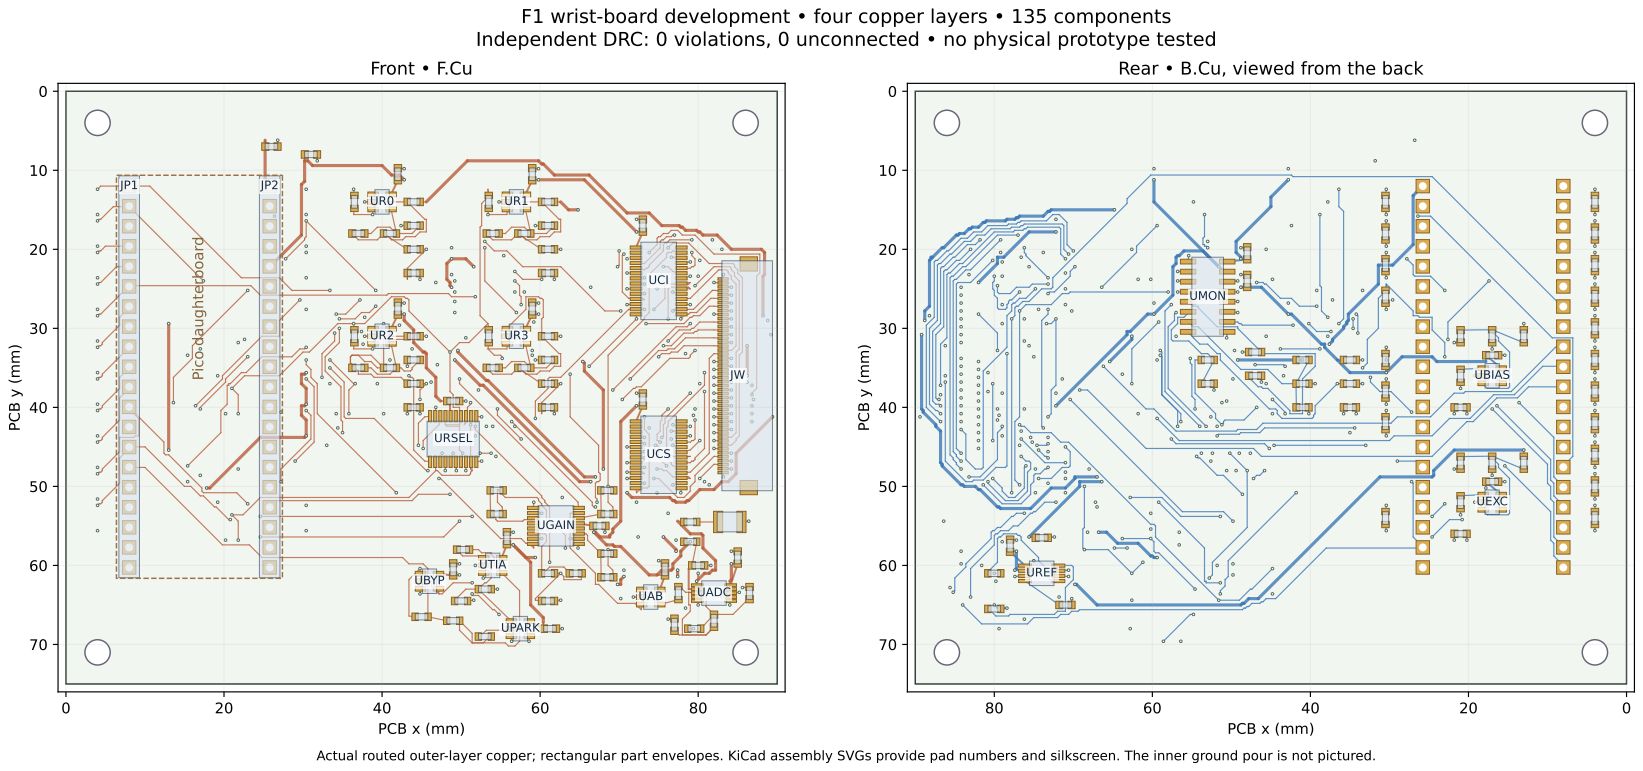
[picture p268: page 1]
PCB x (mm); PCB y (mm); UCI; UCS; URSEL; UTIA; UGAIN; UBYP; UPARK; UAB; UADC; Pico daughterboard; UREF; UBIAS; UEXC; UMON

F1 wrist-board development • four copper layers • 135 components
Independent DRC: 0 violations, 0 unconnected • no physical prototype tested

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
