geyan21/yam-tactile-kit/engineering/development/f1/fitted-foils-r3/foils/f1_ch0_rows/f1_ch0_rows.pdf

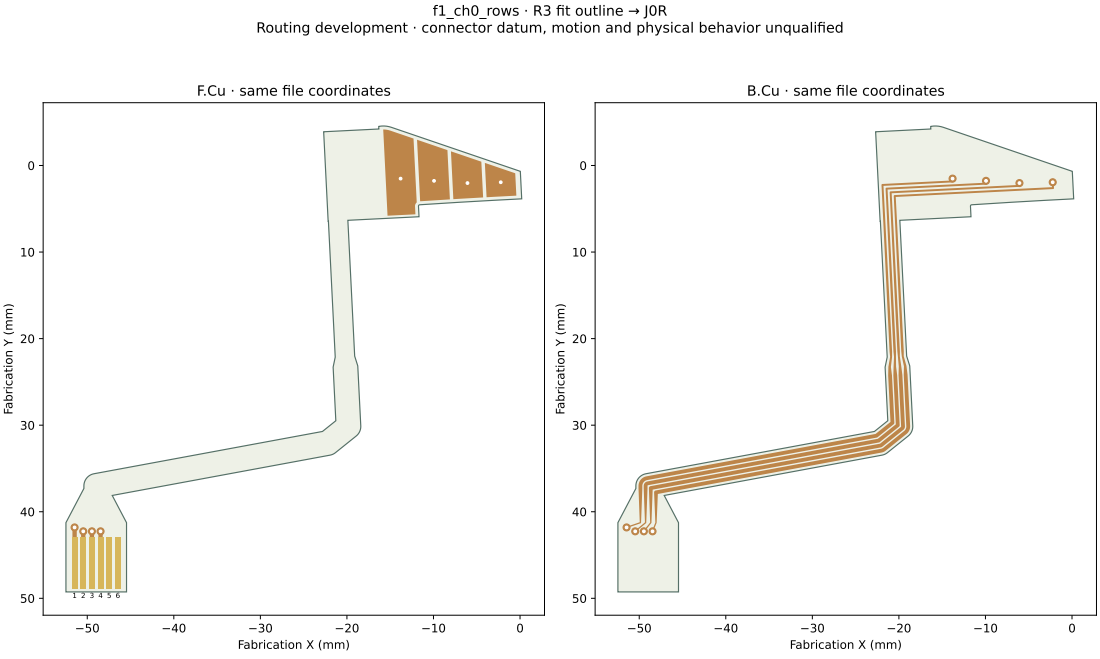
[picture p270: page 1]
Fabrication X (mm); Fabrication Y (mm); f1_ch0_rows · R3 fit outline → J0R

Routing development · connector datum, motion and physical behavior unqualified

F.Cu · same file coordinates

B.Cu · same file coordinates
