geyan21/yam-tactile-kit/engineering/development/f1/fitted-foils-r3/foils/f1_ch2_columns/f1_ch2_columns.pdf

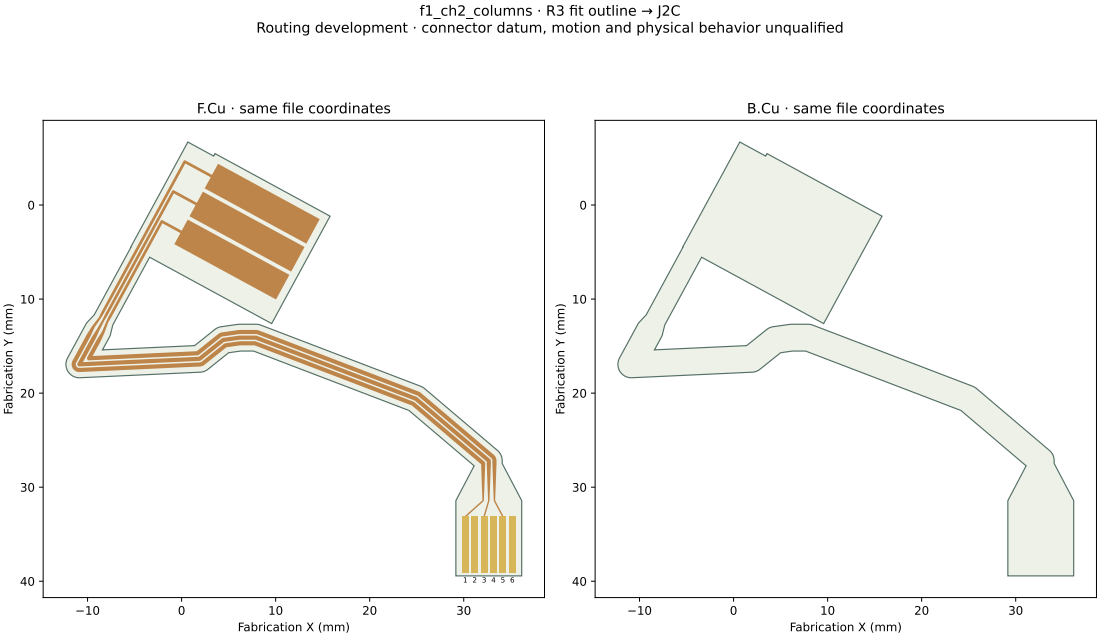
[picture p273: page 1]
Fabrication X (mm); Fabrication Y (mm); f1_ch2_columns · R3 fit outline → J2C

Routing development · connector datum, motion and physical behavior unqualified

F.Cu · same file coordinates

B.Cu · same file coordinates
