geyan21/yam-tactile-kit/engineering/development/f1/fitted-foils-r3/foils/f1_ch5_columns/f1_ch5_columns.pdf

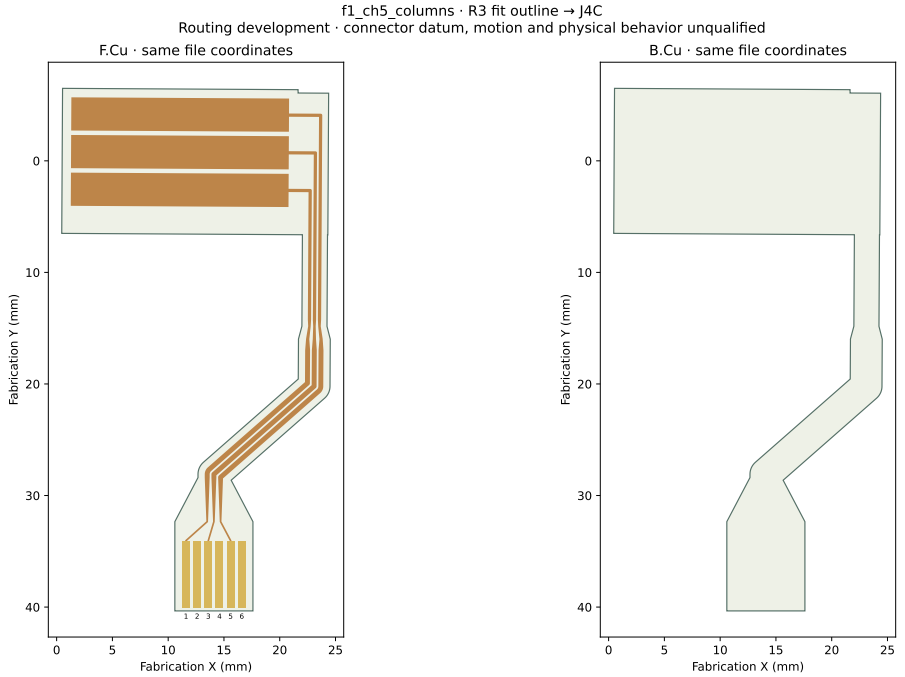
[picture p279: page 1]
Fabrication X (mm); Fabrication Y (mm); f1_ch5_columns · R3 fit outline → J4C

Routing development · connector datum, motion and physical behavior unqualified

F.Cu · same file coordinates

B.Cu · same file coordinates
