geyan21/yam-tactile-kit/engineering/development/f1/mechanics/visuals/tail_routes.pdf

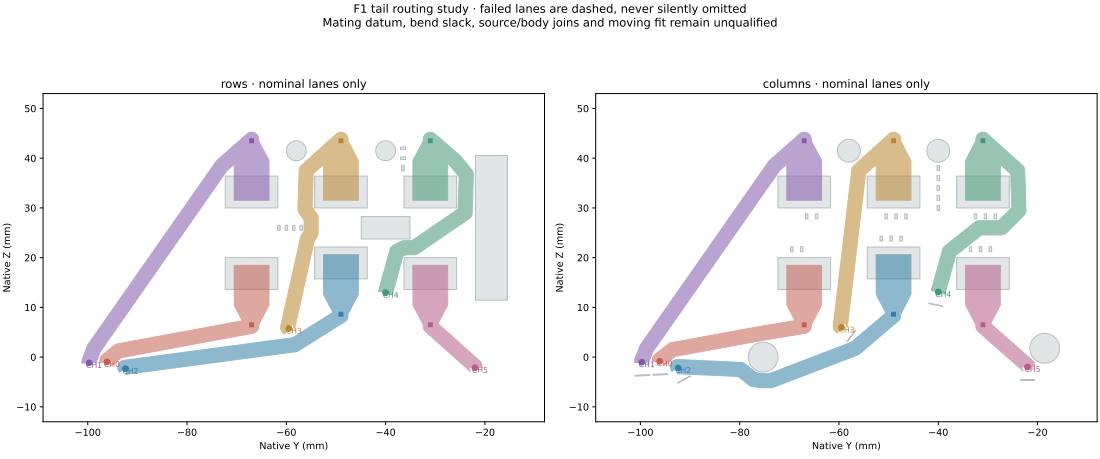
[picture p281: page 1]
Native Y (mm); Native Z (mm)

F1 tail routing study · failed lanes are dashed, never silently omitted
Mating datum, bend slack, source/body joins and moving fit remain unqualified

rows · nominal lanes only

columns · nominal lanes only
