geyan21/yam-tactile-kit/engineering/development/f1/support-studies/visuals/support_results.pdf

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

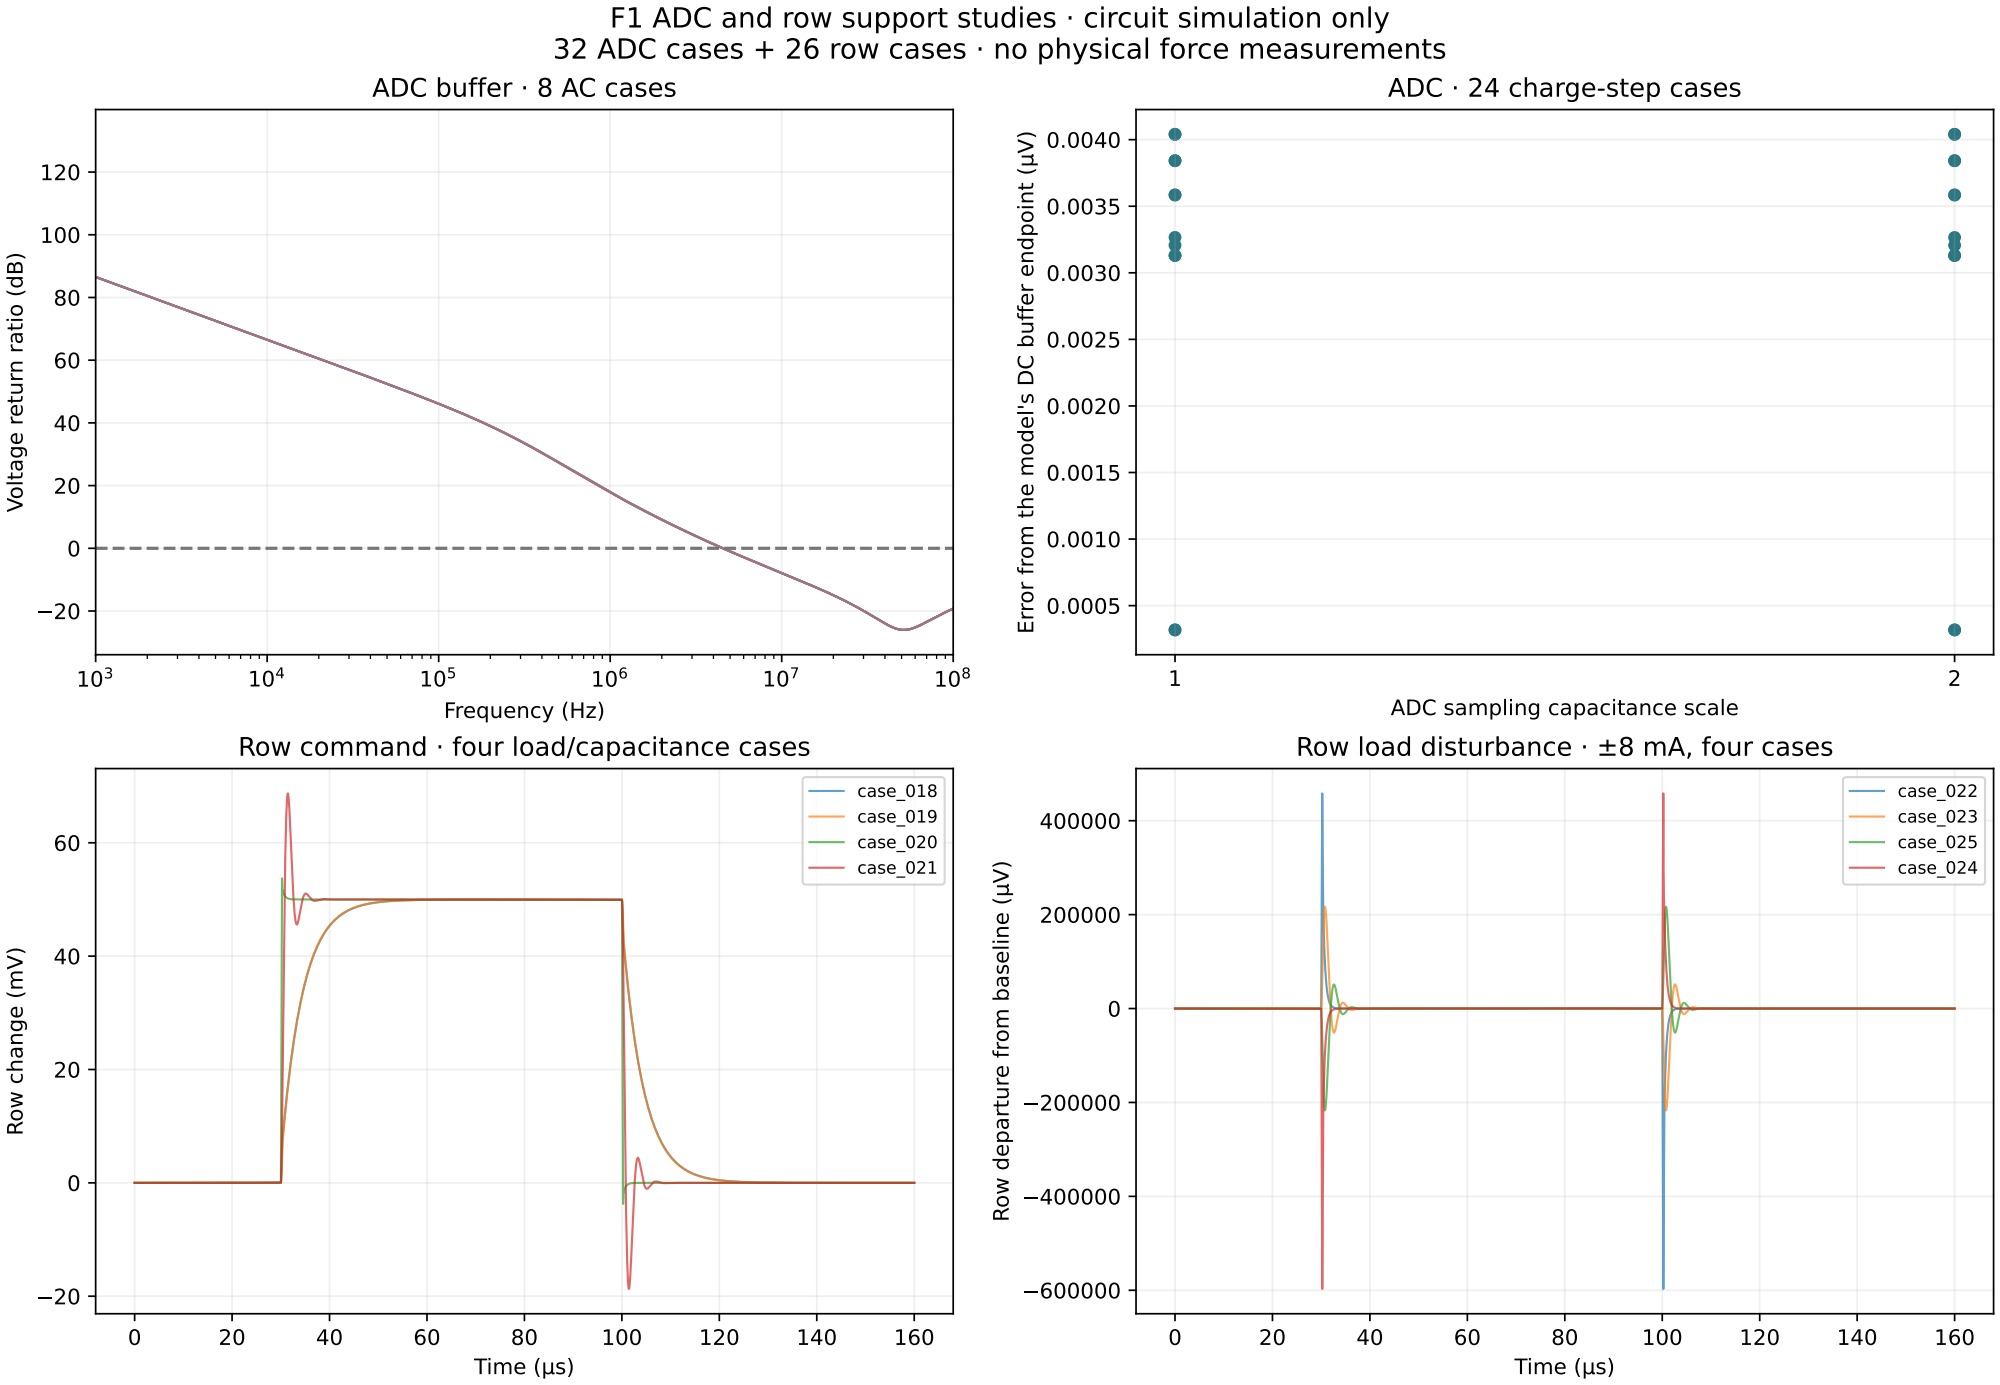
[picture p282: page 1]
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
