geyan21/yam-tactile-kit/engineering/prototypes/f1/electronics/wrist/visuals/inner_ground.pdf

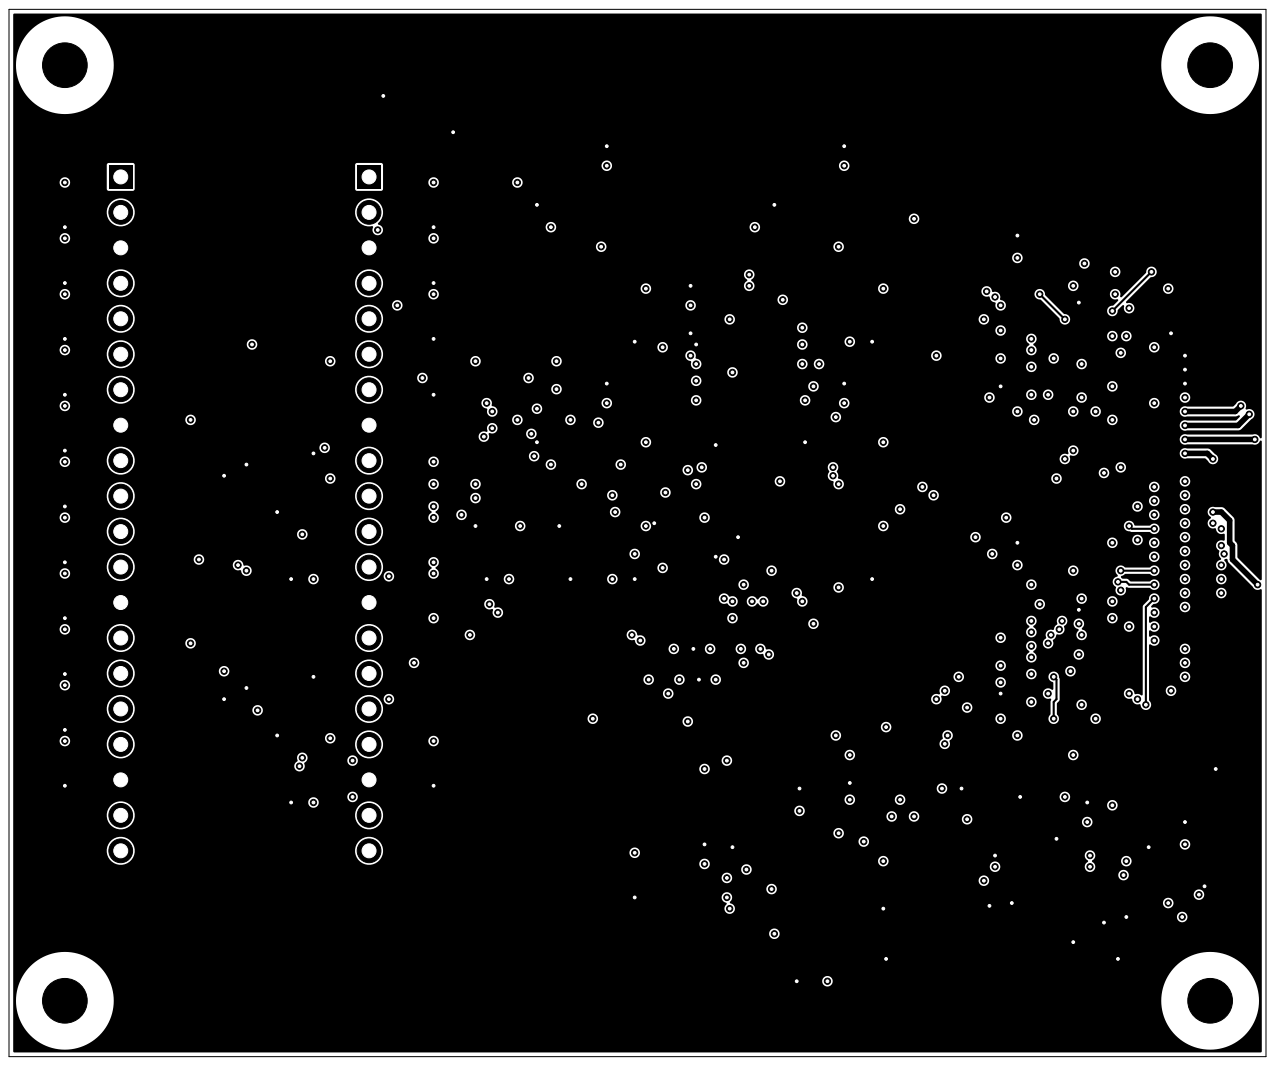
[picture p283: page 1]
