geyan21/yam-tactile-kit/engineering/development/f1/r3/visuals/inner_ground.pdf

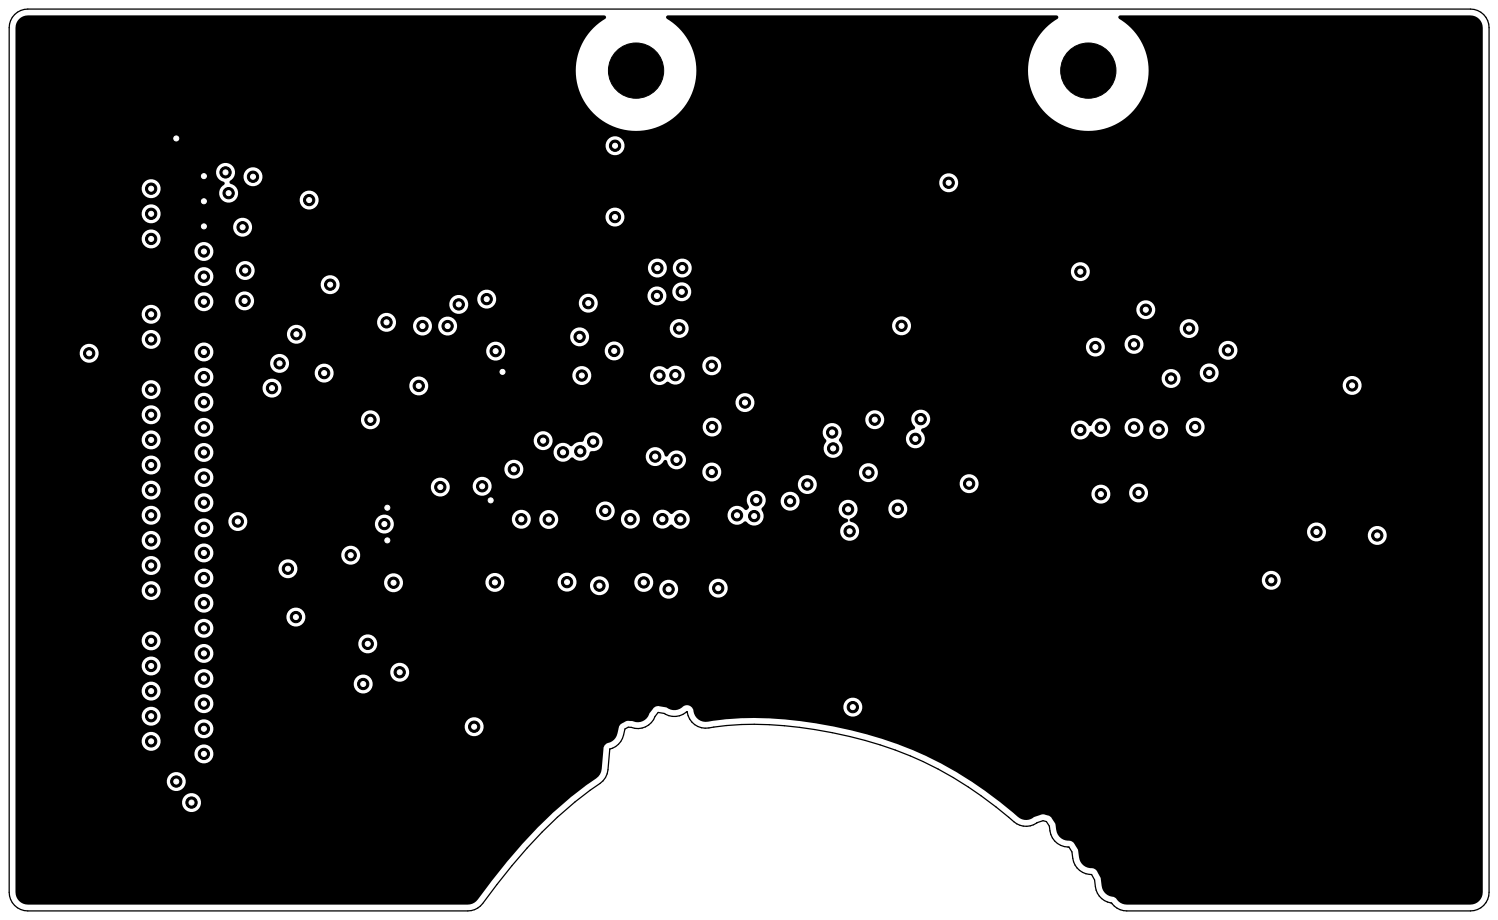
[picture p284: page 1]
