geyan21/yam-tactile-kit/engineering/development/f1/readout-study/visuals/f1_feedback_topology.pdf

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

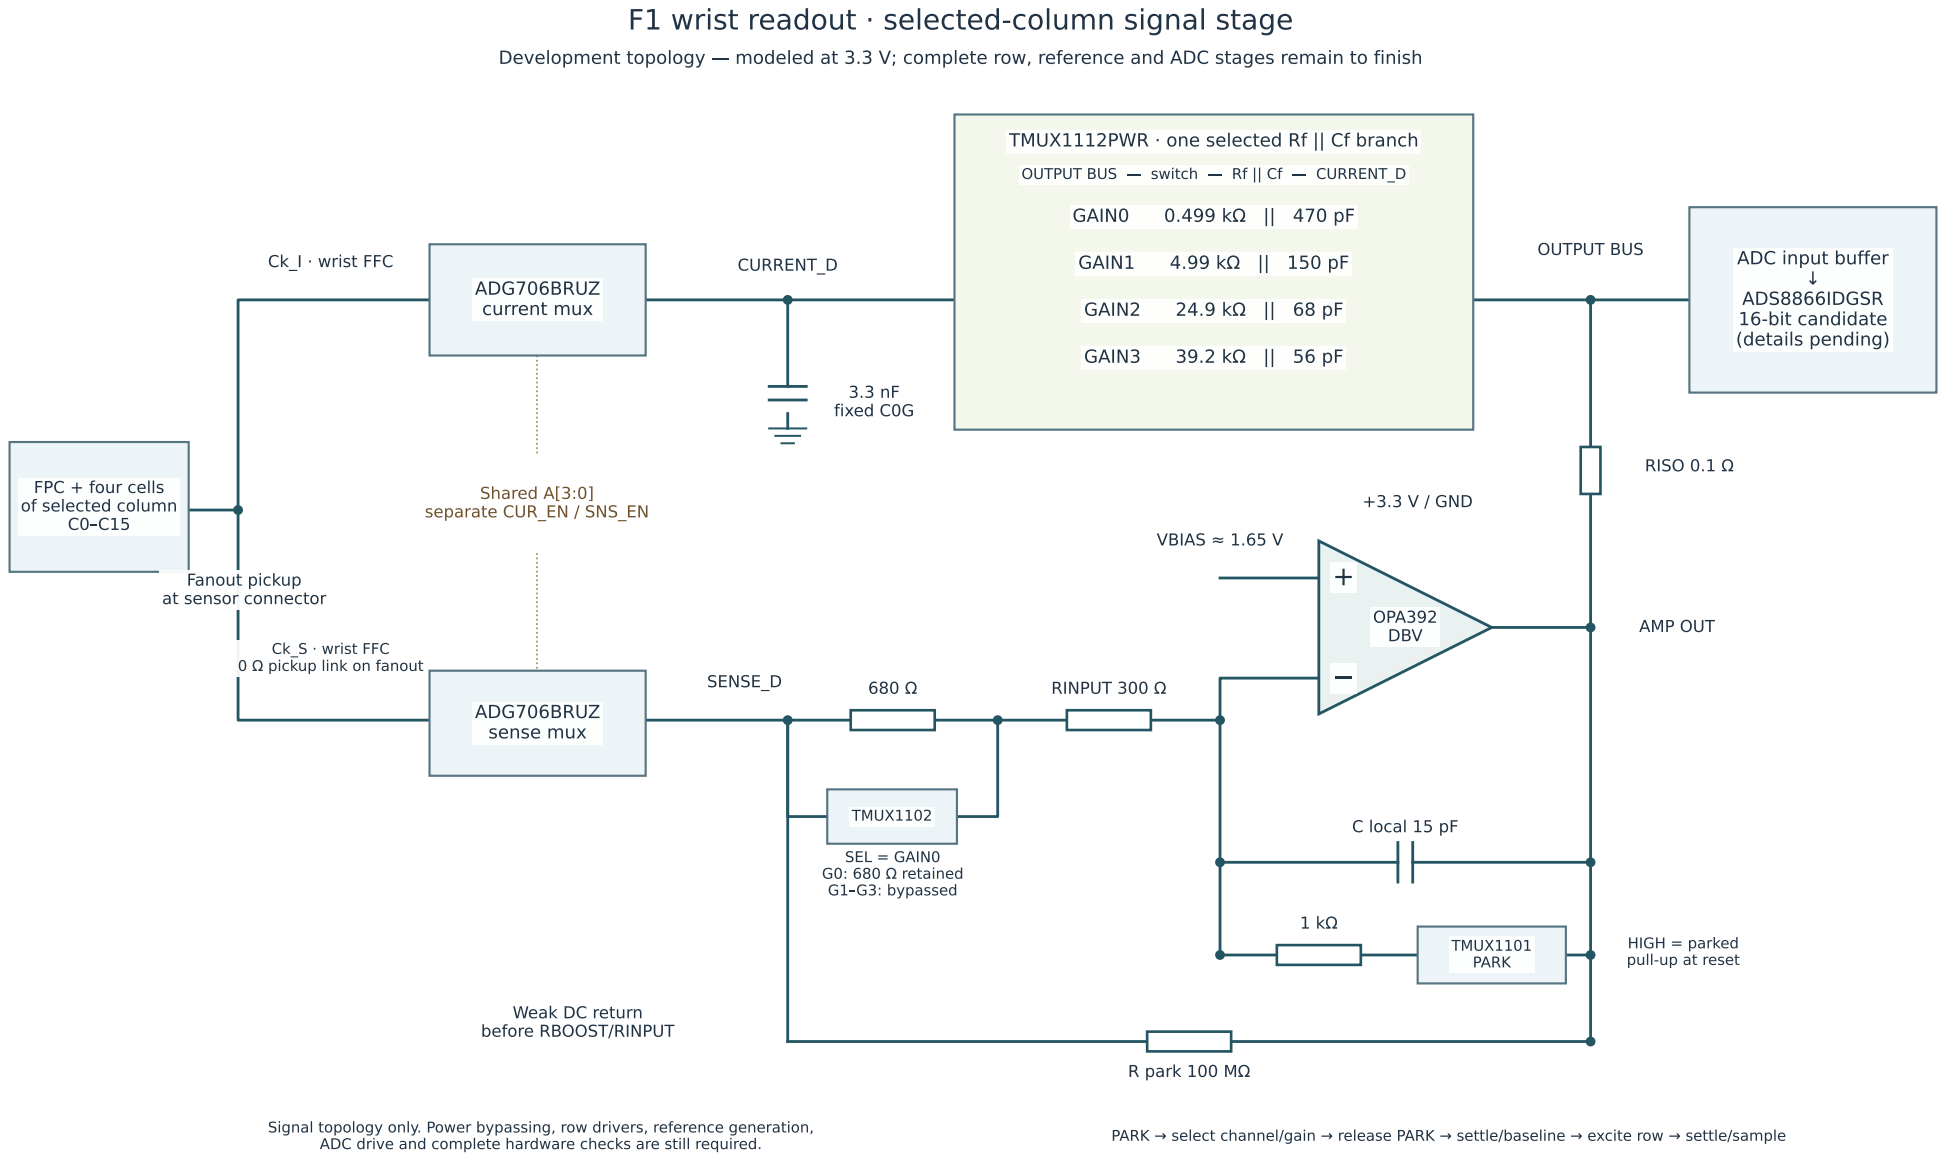
[picture p286: page 1]
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
