geyan21/yam-tactile-kit/(list of files, drawings)

Other design files:
engineering/development/capacitive/k1/checks/pcb_drc.json
engineering/development/capacitive/k1/checks/pcb_summary.json
engineering/development/f1/r2-routing-study/routing-evidence/f1_r2_input.dsn
engineering/development/f1/r3/checks/pcb_drc.json
engineering/prototypes/b2/pcb/pcb_checks.json
engineering/prototypes/c1/pcb/pcb_checks.json
engineering/prototypes/capacitive/flex/k1_ch0_flex/checks/20261011T211642.400133Z/pcb_checks.json
engineering/prototypes/capacitive/flex/k1_ch1_flex/checks/20261011T211643.563033Z/pcb_checks.json
engineering/prototypes/capacitive/flex/k1_ch2_flex/checks/20261011T211644.671015Z/pcb_checks.json
engineering/prototypes/capacitive/flex/k1_ch3_flex/checks/20261011T211645.722822Z/pcb_checks.json
engineering/prototypes/capacitive/flex/k1_ch4_flex/checks/20261011T211646.734084Z/pcb_checks.json
engineering/prototypes/capacitive/flex/k1_ch5_flex/checks/20261011T211647.833975Z/pcb_checks.json
engineering/prototypes/capacitive/flex/k1_ref_flex/checks/20261011T211648.885741Z/pcb_checks.json
engineering/prototypes/force_button/pcb/pcb_checks.json
engineering/prototypes/optical/electronics/led/checks/20261012T083049.813416Z/pcb_checks.json
engineering/prototypes/pneumatic/electronics/readout/checks/20261012T044854.471552Z/pcb_checks.json
engineering/release/b1/pcb/pcb_checks.json
