geyan21/yam-tactile-kit/engineering/prototypes/optical/electronics/led/checks/20261012T083049.813416Z/o1_blue_ring.kicad_pcb

## KiCad design engineering/prototypes/optical/electronics/led/checks/20261012T083049.813416Z/o1_blue_ring.kicad_pcb (2026-10-12)

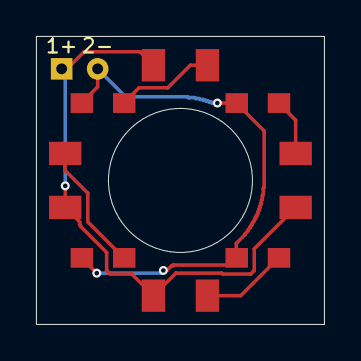
[picture p287: board o1_blue_ring.kicad_pcb from above]

Board: 2 copper layers, 16.0 x 16.0 mm, 10 parts (0 on the bottom side), 6 nets.

Parts:
D1: Kingbright APT2012QBC/D; D1
D2: Kingbright APT2012QBC/D; D2
D3: Kingbright APT2012QBC/D; D3
D4: Kingbright APT2012QBC/D; D4
H1: Lens aperture; H1
J1: 28 AWG soldered leads: 1=+5V, 2=GND; J1
R1: 220 ohm 1% 1206 >=0.25 W; R1
R2: 220 ohm 1% 1206 >=0.25 W; R2
R3: 220 ohm 1% 1206 >=0.25 W; R3
R4: 220 ohm 1% 1206 >=0.25 W; R4

Connections:
A1: D1.2, R1.2
A2: D2.2, R2.2
A3: D3.2, R3.2
A4: D4.2, R4.2
GND: D1.1, D2.1, D3.1, D4.1, J1.2
LED_5V: J1.1, R1.1, R2.1, R3.1, R4.1
