geyan21/yam-tactile-kit/engineering/prototypes/pneumatic/provenance/bench/inputs/build/engineering/prototypes/pneumatic/boards/20261012T044642.938727Z/p1_readout.kicad_pcb

## KiCad design engineering/prototypes/pneumatic/provenance/bench/inputs/build/engineering/prototypes/pneumatic/boards/20261012T044642.938727Z/p1_readout.kicad_pcb (2026-10-12)

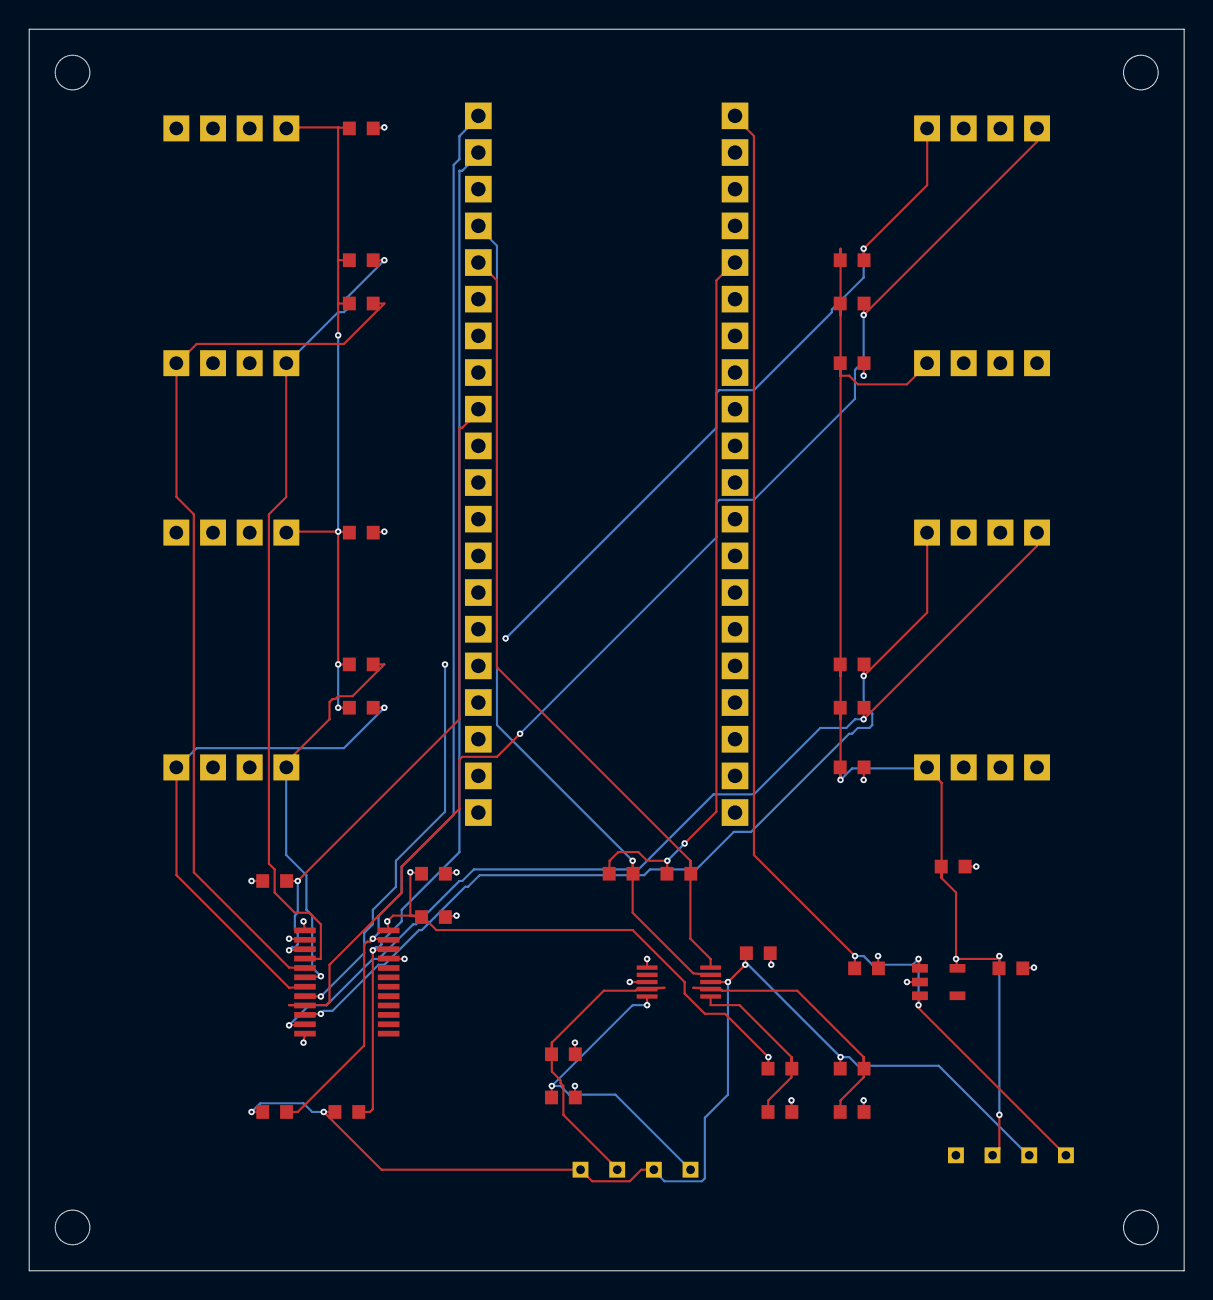
[picture p288: board p1_readout.kicad_pcb from above]

Board: 4 copper layers, 80.0 x 86.0 mm, 40 parts (0 on the bottom side), 21 nets.

Parts:
CA: 100nF 16V X7R 0603; CA
CB: 2.2uF 16V X7R 0603; CB
CH0: 10nF 50V C0G 0603; CH0
CH1: 10nF 50V C0G 0603; CH1
CI: 2.2uF 16V X7R 0603 effective >=1uF at 5V; CI
CM1: 100nF 16V X7R 0603; CM1
CM2: 1uF 16V X7R 0603; CM2
CO: 2.2uF 16V X7R 0603 effective >=1uF at 3V; CO
CP0: 100nF 16V X7R 0603; CP0
CP1: 100nF 16V X7R 0603; CP1
CP2: 100nF 16V X7R 0603; CP2
CP3: 100nF 16V X7R 0603; CP3
JN: Rear-exit solder wires; JN
JP1: 1x20 2.54mm female socket for original Pico; JP1
JP2: 1x20 2.54mm female socket for original Pico; JP2
JT: Rear-exit solder wires; JT
PS0: ELVR-L30D-F1RD-C-NI3H; PS0
PS1: ELVR-L30D-F1RD-C-NI3H; PS1
PS2: ELVR-L30D-F1RD-C-NI3H; PS2
PS3: ELVR-L30D-F1RD-C-NI3H; PS3
RC0: 2.2k 1% 0603; RC0
RC1: 2.2k 1% 0603; RC1
RC2: 2.2k 1% 0603; RC2
RC3: 2.2k 1% 0603; RC3
RD0: 2.2k 1% 0603; RD0
RD1: 2.2k 1% 0603; RD1
RD2: 2.2k 1% 0603; RD2
RD3: 2.2k 1% 0603; RD3
RM: 10k 1% 0603; RM
RM0: 1k 1% 0603; RM0
RM1: 1k 1% 0603; RM1
RN0: 10k 1% 0603; RN0
RN1: 10k 1% 0603; RN1
RNC: 4.7k 1% 0603; RNC
RND: 4.7k 1% 0603; RND
RPC: 4.7k 1% 0603; RPC
RPD: 4.7k 1% 0603; RPD
U1: TCA9548APWR; U1
U2: ADS1115IDGSR; U2
U3: LP5907MFX-3.0/NOPB; U3

Connections:
3V0: CB.1, CM1.1, CM2.1, CO.1, CP0.1, CP1.1, CP2.1, CP3.1, JT.2, PS0.1, PS1.1, PS2.1, PS3.1, RC0.1, RC1.1, RC2.1, RC3.1, RD0.1, RD1.1, RD2.1, RD3.1, RM.1, RM0.1, U1.24, U3.5
3V3: CA.1, JN.1, JN.3, JP2.5, JT.3, RM1.1, RNC.1, RND.1, RPC.1, RPD.1, U2.8
5V_USB: CI.1, JP2.1, JT.4, U3.1, U3.3
GND: CA.2, CB.2, CH0.2, CH1.2, CI.2, CM1.2, CM2.2, CO.2, CP0.2, CP1.2, CP2.2, CP3.2, JP1.3, JP1.8, JP1.13, JP1.18, JP2.3, JP2.8, JP2.13, JP2.18, JT.1, PS0.2, PS1.2, PS2.2, PS3.2, RN0.2, RN1.2, U1.1, U1.2, U1.12, U1.21, U2.1, U2.3, U3.2
MON_3V0: CH0.1, RM0.2, U2.6
MON_3V3: CH1.1, RM1.2, U2.7
MUX_RST: JP1.9, RM.2, U1.3
NAIL0: JN.2, RN0.1, U2.4
NAIL1: JN.4, RN1.1, U2.5
N_SCL: JP1.5, RNC.2, U2.10
N_SDA: JP1.4, RND.2, U2.9
P_SCL: JP1.2, RPC.2, U1.22
P_SDA: JP1.1, RPD.2, U1.23
SC0: PS0.5, RC0.2, U1.5
SC1: PS1.5, RC1.2, U1.7
SC2: PS2.5, RC2.2, U1.9
SC3: PS3.5, RC3.2, U1.11
SD0: PS0.8, RD0.2, U1.4
SD1: PS1.8, RD1.2, U1.6
SD2: PS2.8, RD2.2, U1.8
SD3: PS3.8, RD3.2, U1.10
