geyan21/yam-tactile-kit/engineering/prototypes/f1/electronics/wrist/checks/checked_f1_wrist.kicad_pcb

## KiCad design engineering/prototypes/f1/electronics/wrist/checks/checked_f1_wrist.kicad_pcb (2026-10-12)

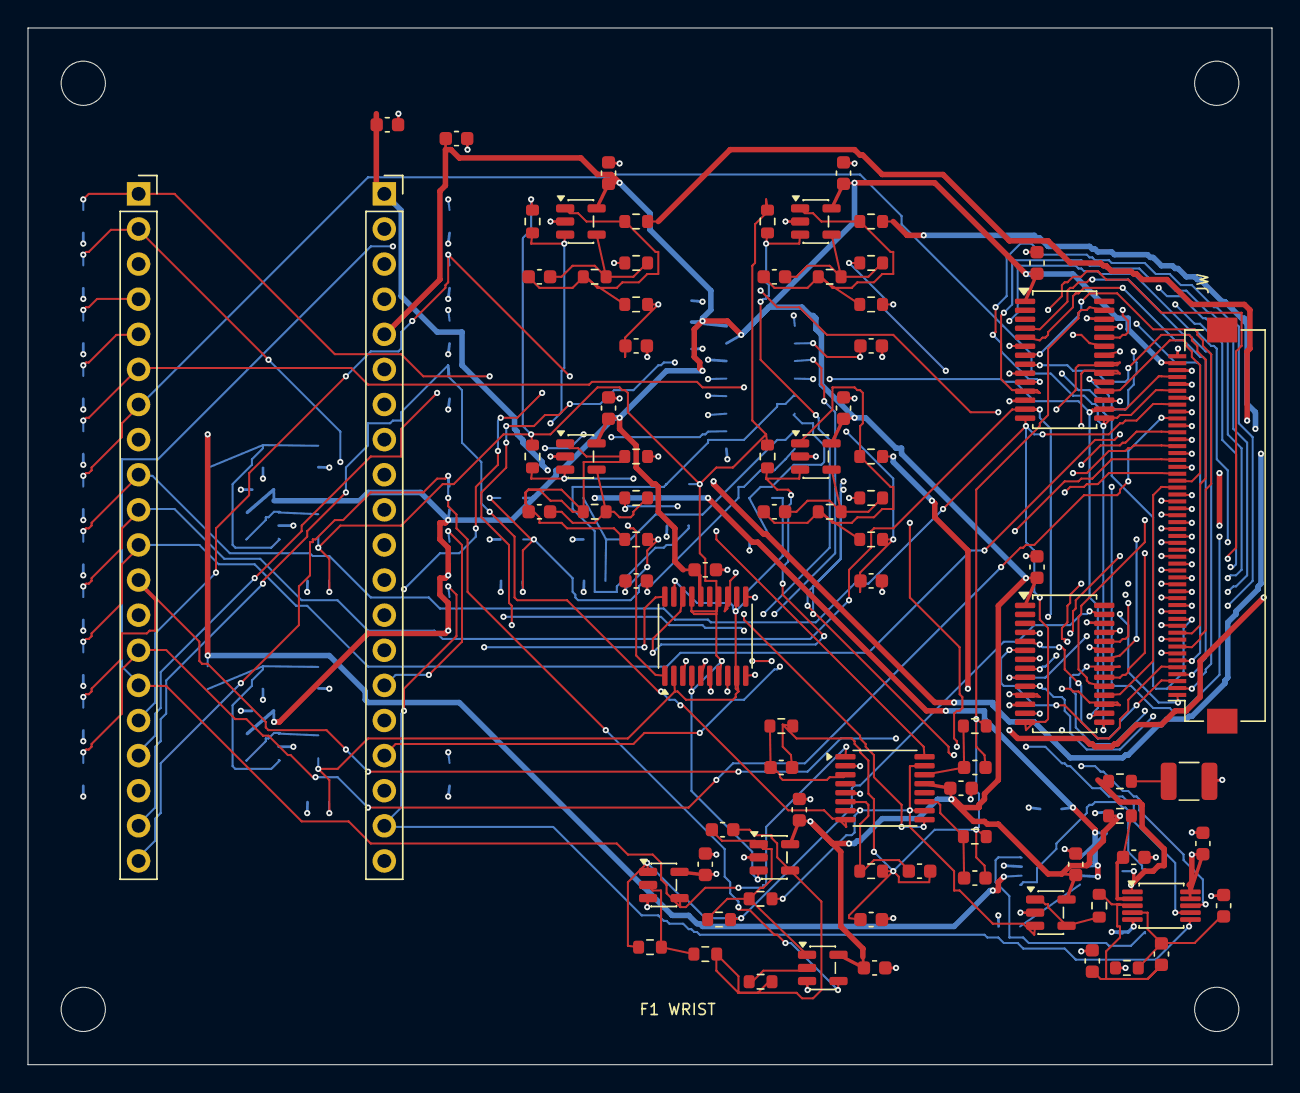
[picture p289: board checked_f1_wrist.kicad_pcb from above]

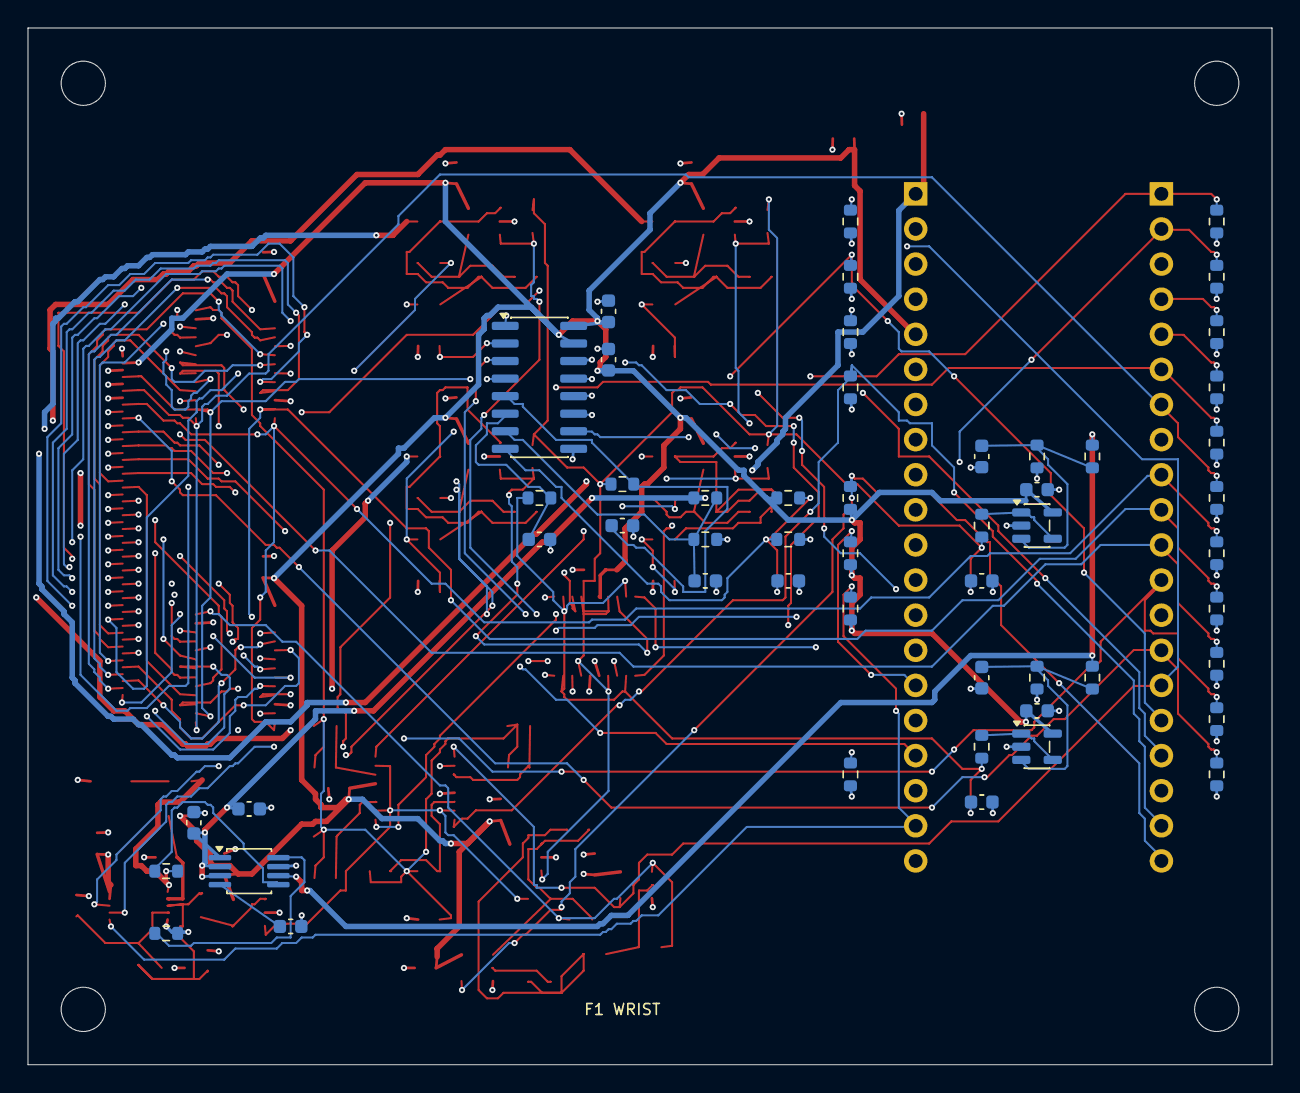
[picture p290: board checked_f1_wrist.kicad_pcb from below]

Board: 4 copper layers, 90.0 x 75.0 mm, 139 parts (52 on the bottom side), 110 nets.

Parts:
CADCD: 2.2n C0G; CADCD
CADCN: 2.2n C0G; CADCN
CADCP: 2.2n C0G; CADCP
CAVDD: 1u X7R 10V; CAVDD
CBIASIN: 100n X7R 10V; CBIASIN
CBIASOUT: 100n X7R 10V; CBIASOUT
CBMON: 1u X7R 10V; CBMON
CBULK3: 10u X7R 10V; CBULK3
CBULK5: 4.7u X7R 10V; CBULK5
CCURRENT: 3.3n C0G; CCURRENT
CDAB: 100n X7R 10V; CDAB
CDBIAS: 100n X7R 10V; CDBIAS
CDBYP: 100n X7R 10V; CDBYP
CDEXC: 100n X7R 10V; CDEXC
CDGAIN: 100n X7R 10V; CDGAIN
CDMON: 100n X7R 10V; CDMON
CDPARK: 100n X7R 10V; CDPARK
CDR0: 100n X7R 10V; CDR0
CDR1: 100n X7R 10V; CDR1
CDR2: 100n X7R 10V; CDR2
CDR3: 100n X7R 10V; CDR3
CDTIA: 100n X7R 10V; CDTIA
CDVDD: 1u X7R 10V; CDVDD
CEXCIN: 100n X7R 10V; CEXCIN
CEXCOUT: 100n X7R 10V; CEXCOUT
CFB0: 100p C0G; CFB0
CFB1: 100p C0G; CFB1
CFB2: 100p C0G; CFB2
CFB3: 100p C0G; CFB3
CFILT: 2.2u X7R 10V; effective >=1u; CFILT
CLOCAL: 15p C0G; CLOCAL
CMB: 10n X7R 10V; CMB
CME: 10n X7R 10V; CME
CMON0: 10n X7R 10V; CMON0
CMON1: 10n X7R 10V; CMON1
CMON2: 10n X7R 10V; CMON2
CMON3: 10n X7R 10V; CMON3
CREF: 22u X7R 25V; effective 10-47u verified; CREF
CREFIN1: 100n X7R 10V; CREFIN1
CREFIN2: 1u X7R 10V; CREFIN2
CRSEL: 100n X7R 10V; CRSEL
CTIA0: 470p C0G; CTIA0
CTIA1: 150p C0G; CTIA1
CTIA2: 68p C0G; CTIA2
CTIA3: 56p C0G; CTIA3
CUCI: 100n X7R 10V; CUCI
CUCS: 100n X7R 10V; CUCS
CV3: 10n X7R 10V; CV3
CV5: 10n X7R 10V; CV5
H1, H2, H3, H4: (no value)
JP1: 1x20 female socket 2.54 mm; Pico header; JP1
JP2: 1x20 female socket 2.54 mm; Pico header; JP2
JW: FH12-50S-0.5SH(55); JW
PD_A0: 100k; PD_A0
PD_A1: 100k; PD_A1
PD_A2: 100k; PD_A2
PD_A3: 100k; PD_A3
PD_CUR_EN: 100k; PD_CUR_EN
PD_GAIN0: 100k; PD_GAIN0
PD_GAIN1: 100k; PD_GAIN1
PD_GAIN2: 100k; PD_GAIN2
PD_GAIN3: 100k; PD_GAIN3
PD_MISO: 100k; PD_MISO
PD_ROW0: 100k; PD_ROW0
PD_ROW1: 100k; PD_ROW1
PD_ROW2: 100k; PD_ROW2
PD_ROW3: 100k; PD_ROW3
PD_SNS_EN: 100k; PD_SNS_EN
PD_TEST_EN: 100k; PD_TEST_EN
PU_ADC_CONV: 100k; PU_ADC_CONV
PU_MON_CS: 100k; PU_MON_CS
PU_PARK: 100k; PU_PARK
RACTIVEPARK: 1k; RACTIVEPARK
RADCN: 22 0.1%; RADCN
RADCP: 22 0.1%; RADCP
RAVDD: 2.2; RAVDD
RBIAS0: 1M; RBIAS0
RBIAS1: 1M; RBIAS1
RBIAS2: 1M; RBIAS2
RBIAS3: 1M; RBIAS3
RBIASB: 10000 0.01% 10ppm/K; RBIASB
RBIASOUT: 47; RBIASOUT
RBIAST: 10000 0.01% 10ppm/K; RBIAST
RBOOST: 680; RBOOST
REXCB: 17000 0.01% 10ppm/K; REXCB
REXCOUT: 47; REXCOUT
REXCT: 16000 0.01% 10ppm/K; REXCT
RFB0: 100M; RFB0
RFB1: 100M; RFB1
RFB2: 100M; RFB2
RFB3: 100M; RFB3
RGNDS: 0 sense pickup; RGNDS
RINPUT: 300; RINPUT
RISO0: 47; RISO0
RISO1: 47; RISO1
RISO2: 47; RISO2
RISO3: 47; RISO3
RMB: 4.7k; RMB
RME: 4.7k; RME
RMON0: 4.7k; RMON0
RMON1: 4.7k; RMON1
RMON2: 4.7k; RMON2
RMON3: 4.7k; RMON3
ROUT: 0.1; ROUT
RPARK: 100M; RPARK
RREFESR: 0.047 1%; RREFESR
RREFS: 0 sense pickup; RREFS
RSNS0: 4700; RSNS0
RSNS1: 4700; RSNS1
RSNS2: 4700; RSNS2
RSNS3: 4700; RSNS3
RTIA0: 499 0.1%; RTIA0
RTIA1: 4990 0.1%; RTIA1
RTIA2: 24900 0.1%; RTIA2
RTIA3: 39200 0.1%; RTIA3
RV3B: 10k 0.1%; RV3B
RV3T: 10k 0.1%; RV3T
RV5B: 10k 0.1%; RV5B
RV5T: 10k 0.1%; RV5T
UAB: OPA320AQDBVRQ1; UAB
UADC: ADS8866IDGSR; UADC
UBIAS: OPA392DBVR; UBIAS
UBYP: TMUX1102DBVR; UBYP
UCI: ADG706BRUZ; UCI
UCS: ADG706BRUZ; UCS
UEXC: OPA392DBVR; UEXC
UGAIN: TMUX1112PWR; UGAIN
UMON: MCP3208-B/SL; UMON
UPARK: TMUX1101DBVR; UPARK
UR0: OPA392DBVR; UR0
UR1: OPA392DBVR; UR1
UR2: OPA392DBVR; UR2
UR3: OPA392DBVR; UR3
UREF: REF6033IDGKR; UREF
URSEL: TMUX1134PWR; URSEL
UTIA: OPA392DBVR; UTIA

Connections:
+3V3: CBMON.1, CBULK3.1, CDAB.1, CDBIAS.1, CDBYP.1, CDEXC.1, CDGAIN.1, CDMON.1, CDPARK.1, CDR0.1, CDR1.1, CDR2.1, CDR3.1, CDTIA.1, CDVDD.1, CRSEL.1, CUCI.1, CUCS.1, JP2.5, JW.49, PU_ADC_CONV.2, PU_MON_CS.2, PU_PARK.2, RAVDD.1, RV3T.1, UAB.5, UADC.9, UADC.10, UBIAS.5, UBYP.5, UCI.1, UCS.1, UEXC.5, UGAIN.13, UMON.15, UMON.16, UPARK.5, UR0.5, UR1.5, UR2.5, UR3.5, URSEL.16, UTIA.5
+3V3_DIV2: CV3.1, RV3B.1, RV3T.2, UMON.8
+5V: CBULK5.1, CREFIN1.1, CREFIN2.1, JP2.1, RV5T.1, UREF.1, UREF.2, UREF.3
+5V_DIV2: CV5.1, RV5B.1, RV5T.2, UMON.7
A0: JP1.6, JW.47, PD_A0.1, UCI.16, UCS.16
A1: JP1.7, JW.45, PD_A1.1, UCI.15, UCS.15
A2: JP1.9, JW.43, PD_A2.1, UCI.14, UCS.14
A3: JP1.10, JW.42, PD_A3.1, UCI.13, UCS.13
ADC_AVDD: CAVDD.1, RAVDD.2, UADC.2
ADC_BUFFER: RADCP.1, UAB.1, UAB.4
ADC_CONV: JP2.19, PU_ADC_CONV.1, UADC.6
AINN: CADCD.2, CADCN.1, RADCN.2, UADC.4
AINP: CADCD.1, CADCP.1, RADCP.2, UADC.3
AMP_OUT: CLOCAL.1, ROUT.1, RPARK.1, UPARK.1, UTIA.1
BIAS_BUFFER: RBIASOUT.1, UBIAS.1, UBIAS.4
BIAS_DIV: CBIASIN.1, RBIASB.1, RBIAST.2, UBIAS.3
BIAS_MON: CMB.1, RMB.2, UMON.5
C0_I: JW.32, UCI.18
C0_S: JW.31, UCS.18
C1_I: JW.30, UCI.19
C1_S: JW.29, UCS.19
C2_I: JW.28, UCI.20
C2_S: JW.27, UCS.20
C3_I: JW.26, UCI.21
C3_S: JW.25, UCS.21
C4_I: JW.24, UCI.22
C4_S: JW.23, UCS.22
C5_I: JW.22, UCI.23
C5_S: JW.21, UCS.23
C6_I: JW.20, UCI.24
C6_S: JW.19, UCS.24
C7_I: JW.18, UCI.25
C7_S: JW.17, UCS.25
C8_I: JW.16, UCI.11
C8_S: JW.15, UCS.11
C9_I: JW.14, UCI.10
C9_S: JW.13, UCS.10
C10_I: JW.12, UCI.9
C10_S: JW.11, UCS.9
C11_I: JW.10, UCI.8
C11_S: JW.9, UCS.8
C12_I: JW.8, UCI.7
C12_S: JW.7, UCS.7
C13_I: JW.6, UCI.6
C13_S: JW.5, UCS.6
C14_I: JW.4, UCI.5
C14_S: JW.3, UCS.5
C15_I: JW.2, UCI.4
C15_S: JW.1, UCS.4
COMP_MID: RBOOST.2, RINPUT.1, UBYP.2
CURRENT_D: CCURRENT.1, CTIA0.2, CTIA1.2, CTIA2.2, CTIA3.2, RTIA0.2, RTIA1.2, RTIA2.2, RTIA3.2, UCI.27
CUR_EN: JP1.11, PD_CUR_EN.1, UCI.17
EXCITE_MON: CME.1, RME.2, UMON.6
EXC_BUFFER: REXCOUT.1, UEXC.1, UEXC.4
EXC_DIV: CEXCIN.1, REXCB.1, REXCT.2, UEXC.3
GAIN0: JP1.15, PD_GAIN0.1, UBYP.4, UGAIN.1
GAIN1: JP1.16, PD_GAIN1.1, UGAIN.16
GAIN2: JP1.17, PD_GAIN2.1, UGAIN.9
GAIN3: JP1.19, PD_GAIN3.1, UGAIN.8
GAIN_BRANCH0: CTIA0.1, RTIA0.1, UGAIN.3
GAIN_BRANCH1: CTIA1.1, RTIA1.1, UGAIN.14
GAIN_BRANCH2: CTIA2.1, RTIA2.1, UGAIN.11
GAIN_BRANCH3: CTIA3.1, RTIA3.1, UGAIN.6
GND: CADCN.2, CADCP.2, CAVDD.2, CBIASIN.2, CBIASOUT.2, CBMON.2, CBULK3.2, CBULK5.2, CCURRENT.2, CDAB.2, CDBIAS.2, CDBYP.2, CDEXC.2, CDGAIN.2, CDMON.2, CDPARK.2, CDR0.2, CDR1.2, CDR2.2, CDR3.2, CDTIA.2, CDVDD.2, CEXCIN.2, CEXCOUT.2, CFILT.2, CMB.2, CME.2, CMON0.2, CMON1.2, CMON2.2, CMON3.2, CREF.2, CREFIN1.2, CREFIN2.2, CRSEL.2, CUCI.2, CUCS.2, CV3.2, CV5.2, JP1.3, JP1.8, JP1.13, JP1.18, JP2.3, JP2.8, JP2.13, JP2.18, JW.44, JW.46, JW.48, JW.50, PD_A0.2, PD_A1.2, PD_A2.2, PD_A3.2, PD_CUR_EN.2, PD_GAIN0.2, PD_GAIN1.2, PD_GAIN2.2, PD_GAIN3.2, PD_MISO.2, PD_ROW0.2, PD_ROW1.2, PD_ROW2.2, PD_ROW3.2, PD_SNS_EN.2, PD_TEST_EN.2, RADCN.1, RBIASB.2, REXCB.2, RGNDS.2, RV3B.2, RV5B.2, UAB.2, UADC.5, UBIAS.2, UBYP.3, UCI.12, UCI.26, UCS.12, UCS.26, UEXC.2, UGAIN.5, UMON.9, UMON.14, UPARK.3, UR0.2, UR1.2, UR2.2, UR3.2, UREF.7, URSEL.5, URSEL.6, UTIA.2
MON_CS: JP2.15, PU_MON_CS.1, UMON.10
OUTPUT_BUS: ROUT.2, UAB.3, UGAIN.2, UGAIN.7, UGAIN.10, UGAIN.15
PARK: JP1.20, PU_PARK.1, UPARK.4
PARK_LINK: RACTIVEPARK.1, UPARK.2
R0_I: JW.40, RISO0.2
R0_S: JW.39, RSNS0.1
R1_I: JW.38, RISO1.2
R1_S: JW.37, RSNS1.1
R2_I: JW.36, RISO2.2
R2_S: JW.35, RSNS2.1
R3_I: JW.34, RISO3.2
R3_S: JW.33, RSNS3.1
REF_CAP: CREF.1, RREFESR.2
REF_FILT: CFILT.1, UREF.4
REF_GND_SENSE: RGNDS.1, UREF.8
ROW0: JP1.1, PD_ROW0.1, URSEL.1
ROW0_CMD: RBIAS0.1, UR0.3, URSEL.3
ROW0_FB: CFB0.2, RFB0.2, RSNS0.2, UR0.4
ROW0_MON: CMON0.1, RMON0.2, UMON.1
ROW0_OUT: CFB0.1, RFB0.1, RISO0.1, RMON0.1, UR0.1
ROW1: JP1.2, PD_ROW1.1, URSEL.10
ROW1_CMD: RBIAS1.1, UR1.3, URSEL.8
ROW1_FB: CFB1.2, RFB1.2, RSNS1.2, UR1.4
ROW1_MON: CMON1.1, RMON1.2, UMON.2
ROW1_OUT: CFB1.1, RFB1.1, RISO1.1, RMON1.1, UR1.1
ROW2: JP1.4, PD_ROW2.1, URSEL.11
ROW2_CMD: RBIAS2.1, UR2.3, URSEL.13
ROW2_FB: CFB2.2, RFB2.2, RSNS2.2, UR2.4
ROW2_MON: CMON2.1, RMON2.2, UMON.3
ROW2_OUT: CFB2.1, RFB2.1, RISO2.1, RMON2.1, UR2.1
ROW3: JP1.5, PD_ROW3.1, URSEL.20
ROW3_CMD: RBIAS3.1, UR3.3, URSEL.18
ROW3_FB: CFB3.2, RFB3.2, RSNS3.2, UR3.4
ROW3_MON: CMON3.1, RMON3.2, UMON.4
ROW3_OUT: CFB3.1, RFB3.1, RISO3.1, RMON3.1, UR3.1
SENSE_D: RBOOST.1, RPARK.2, UBYP.1, UCS.27
SNS_EN: JP1.12, PD_SNS_EN.1, UCS.17
SPI_MISO: JP2.20, PD_MISO.1, UADC.7, UMON.12
SPI_MOSI: JP2.16, UMON.11
SPI_SCK: JP2.17, UADC.8, UMON.13
TEST_EN: JP1.14, JW.41, PD_TEST_EN.1
TIA_FB: CLOCAL.2, RACTIVEPARK.2, RINPUT.2, UTIA.4
VBIAS: CBIASOUT.1, RBIAS0.2, RBIAS1.2, RBIAS2.2, RBIAS3.2, RBIASOUT.2, RMB.1, URSEL.4, URSEL.7, URSEL.14, URSEL.17, UTIA.3
VEXCITE: CEXCOUT.1, REXCOUT.2, RME.1, URSEL.2, URSEL.9, URSEL.12, URSEL.19
VREF33: RBIAST.1, REXCT.1, RREFESR.1, RREFS.2, UADC.1, UREF.6
VREF_SENSE: RREFS.1, UREF.5
