geyan21/yam-tactile-kit/engineering/prototypes/capacitive/readout/pcb/k1_readout.kicad_pcb

## KiCad design engineering/prototypes/capacitive/readout/pcb/k1_readout.kicad_pcb (2026-10-11)

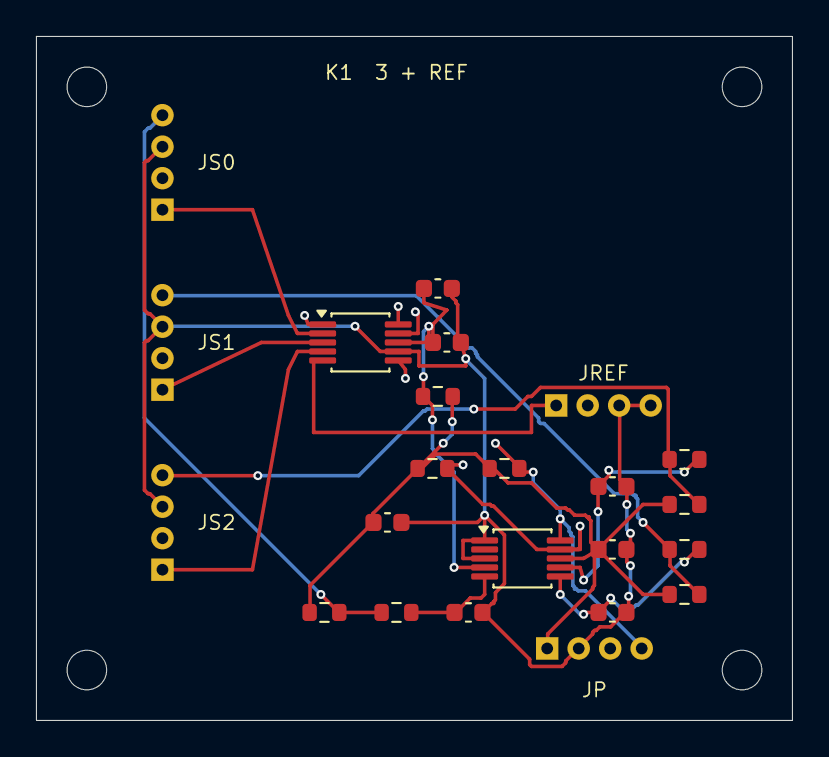
[picture p291: board k1_readout.kicad_pcb from above]

Board: 4 copper layers, 42.0 x 38.0 mm, 27 parts (0 on the bottom side), 17 nets.

Parts:
CB: 1uF 16V X7R; CB
CD: 100nF 16V X7R; CD
CF1: 100nF 16V X7R; CF1
CF2: 1uF 16V X7R; verify effective capacitance; CF2
CI0: 1nF 50V C0G; CI0
CI1: 1nF 50V C0G; CI1
CI2: 1nF 50V C0G; CI2
H1, H2, H3, H4: M2 clearance; MOUNT_M2
JP: 3V3 / GND / SDA / SCL; JP
JREF: Protected reference: CIN4 / SHLD2 / GND / GND; JREF
JS0: CIN / driven shield / ground drive / ground return; JS0
JS1: CIN / driven shield / ground drive / ground return; JS1
JS2: CIN / driven shield / ground drive / ground return; JS2
RF: 10 ohm 1%; RF
RI0: 1k 1%; RI0
RI1: 1k 1%; RI1
RI2: 1k 1%; RI2
RP0: 100k 1%; RP0
RP1: 100k 1%; RP1
RP2: 100k 1%; RP2
RSCL: 4.7k 1%; RSCL
RSDA: 4.7k 1%; RSDA
U1: FDC1004DGSR; U1
U2: ADS1115IDGSR; U2

Connections:
3V3: CB.1, CD.1, JP.1, RF.2, RP0.1, RP1.1, RP2.1, RSCL.1, RSDA.1, U2.8
CIN1: JS0.1, U1.2
CIN2: JS1.1, U1.3
CIN3: JS2.1, U1.4
CIN4: JREF.1, U1.5
GND: CB.2, CD.2, CF1.2, CF2.2, CI0.2, CI1.2, CI2.2, JP.2, JREF.3, JREF.4, JS0.3, JS1.3, JS2.3, U1.7, U2.1, U2.3
RET0: JS0.4, RI0.1, RP0.2
RET0_F: CI0.1, RI0.2, U2.5
RET1: JS1.4, RI1.1, RP1.2
RET1_F: CI1.1, RI1.2, U2.6
RET2: JS2.4, RI2.1, RP2.2
RET2_F: CI2.1, RI2.2, U2.7
SCL: JP.4, RSCL.2, U1.9, U2.10
SDA: JP.3, RSDA.2, U1.10, U2.9
SHLD1: JS0.2, JS1.2, JS2.2, U1.1
SHLD2: JREF.2, U1.6
VDD_FDC: CF1.1, CF2.1, RF.1, U1.8, U2.4
