geyan21/yam-tactile-kit/engineering/prototypes/force_button/pcb/fb1_sensor.kicad_pcb

## KiCad design engineering/prototypes/force_button/pcb/fb1_sensor.kicad_pcb (2026-10-11)

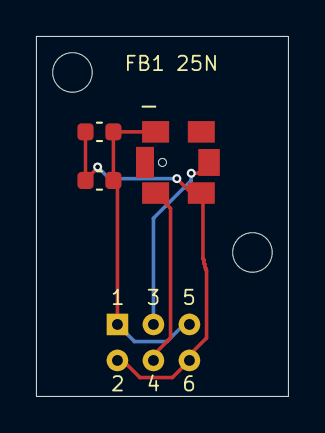
[picture p292: board fb1_sensor.kicad_pcb from above]

Board: 2 copper layers, 14.0 x 20.0 mm, 6 parts (0 on the bottom side), 4 nets.

Parts:
C1: 100nF 16V X7R; C1
C2: 1uF 16V X7R; effective capacitance to be verified; C2
H1, H2: M2 clearance; MOUNT_M2
JW: Six separate soldered cable conductors; JW
U1: FMAMSDXX025WC2C3; U1

Connections:
GND_REMOTE: C1.2, C2.2, JW.2, JW.6, U1.3
SCL: JW.4, U1.4
SDA: JW.3, U1.5
VDD_REMOTE: C1.1, C2.1, JW.1, JW.5, U1.1
