geyan21/yam-tactile-kit/engineering/scripts/build_site.py

#!/usr/bin/python3
"""Build the engineering website, offline guide, and complete portable packet."""

from __future__ import annotations

import hashlib
import html
import json
from pathlib import Path
import posixpath
import re
import shutil
import sys
import zipfile

ROOT=Path(__file__).resolve().parents[2]
sys.path.insert(0,str(ROOT/"src"))
sys.path.insert(0,str(Path(__file__).resolve().parent))
from tactile_kit.records import execution
from tactile_kit.render import markdown
from design_pages import load_catalog,build_design_pages,design_content

SITE=ROOT/"build/site"
RELEASE=ROOT/"engineering/release"
WEB=ROOT/"engineering/web"
DOCS=[
    ("BUILD_ALL","build-all","Build & compare all designs"),
    ("SENSORS","sensors","Sensor choice & placement"),
    ("ARCHITECTURE","architecture","Scalability & better designs"),
    ("START","start","Student starting packet"),("GEOMETRY","geometry","Measured geometry"),
    ("BUILD_R1","build-r1","Build R1"),("ELECTRONICS","electronics","Electronics & code"),
    ("BUILD_L1","build-l1","Build L1 root force"),("L1_ELECTRONICS","l1-electronics","L1 wiring & code"),
    ("L1_TESTING","l1-testing","L1 force & moment tests"),
    ("MATERIALS","materials","Material comparison"),("COMPARISON","comparison","Sensor comparison"),
    ("TESTING","testing","Test protocol"),
    ("CONTACT","contact","Contact reliability"),
    ("BUILD_B1","build-b1","Build B1 magnetic insert"),
    ("B1_ELECTRONICS","b1-electronics","B1 wiring & code"),
    ("B1_TESTING","b1-testing","B1 bending & force tests"),
    ("BUILD_B2","build-b2","Build B2 consolidated PCB"),
    ("BUILD_C1","build-c1","Build C1 strain root"),
    ("C1_TESTING","c1-testing","C1 calibration & tests"),
    ("C1_ANALYSIS","c1-analysis","C1 digital results"),
    ("BUILD_NAIL","build-nail","Build N1 bare sensing nail"),
    ("NAIL_TESTING","nail-testing","N1 calibration & tests"),
    ("NAIL_ANALYSIS","nail-analysis","N1 digital results"),
    ("BUILD_RECESSED","build-recessed","Build B3 recessed board"),
    ("RECESSED_TESTING","recessed-testing","B3 paired physical tests"),
    ("RECESSED_ANALYSIS","recessed-analysis","B3 digital results"),
    ("BUILD_F1","build-f1","F1 development & fit packet"),
    ("F1_WRIST_CAPTURE","f1-capture","F1 wiring & raw capture"),
    ("F1_MANUFACTURING","f1-manufacturing","F1 R4 materials & assembly"),
    ("F1_TESTING","f1-testing","F1 stationary-force tests"),
    ("F1_REPRODUCE","f1-reproduce","Reproduce F1 R4"),
    ("BUILD_CAPACITIVE","build-capacitive","Build K1 capacitive cells"),
    ("CAPACITIVE_TESTING","capacitive-testing","K1 calibration & tests"),
    ("BUILD_FORCE_BUTTON","build-force-button","Build FB1 force button"),
    ("FORCE_BUTTON_TESTING","force-button-testing","FB1 calibration & tests"),
    ("BUILD_PNEUMATIC","build-pneumatic","Build P1 pneumatic"),
    ("PNEUMATIC_ELECTRONICS","pneumatic-electronics","P1 sensors, hoses & capture"),
    ("PNEUMATIC_TESTING","pneumatic-testing","P1 physical comparison"),
    ("PNEUMATIC_REPRODUCE","pneumatic-reproduce","Reproduce P1"),
    ("BUILD_OPTICAL","build-optical","Build O1 optical"),
    ("OPTICAL_ELECTRONICS","optical-electronics","O1 wiring & camera capture"),
    ("OPTICAL_TESTING","optical-testing","O1 physical comparison"),
    ("OPTICAL_REPRODUCE","optical-reproduce","Reproduce O1"),
]


def verify_snapshot():
    manifest=json.loads((RELEASE/"release_manifest.json").read_text())
    for name,expected in manifest["source_hashes"].items():
        if hashlib.sha256((ROOT/name).read_bytes()).hexdigest()!=expected:
            raise ValueError(f"Stale geometry snapshot: {name}. Rebuild CAD and freeze the release.")
    for name,expected in manifest["files"].items():
        if hashlib.sha256((RELEASE/name).read_bytes()).hexdigest()!=expected:
            raise ValueError(f"Geometry snapshot hash mismatch: {name}")
    concepts=ROOT/"engineering/concepts"
    concept_snapshot=json.loads((concepts/"concept_snapshot.json").read_text())
    for name,expected in concept_snapshot["source_hashes"].items():
        if hashlib.sha256((ROOT/name).read_bytes()).hexdigest()!=expected:
            raise ValueError(f"Stale concept calculation: {name}")
    for name,expected in concept_snapshot["files"].items():
        if hashlib.sha256((concepts/name).read_bytes()).hexdigest()!=expected:
            raise ValueError(f"Concept artifact changed: {name}")
    if hashlib.sha256((RELEASE/"b1/b1_manifest.json").read_bytes()).hexdigest()!=concept_snapshot["basis_b1_release"]:
        raise ValueError("Concept basis does not match released B1")
    for path in sorted((ROOT/"engineering/prototypes").glob("*/prototype_snapshot.json")):
        snapshot=json.loads(path.read_text())
        if hashlib.sha256((RELEASE/"release_manifest.json").read_bytes()).hexdigest()!=snapshot["shared_release_sha256"]:
            raise ValueError(f"Prototype release basis changed: {snapshot['id']}")
        for name,expected in snapshot["source_hashes"].items():
            if hashlib.sha256((ROOT/name).read_bytes()).hexdigest()!=expected:
                raise ValueError(f"Stale prototype source: {name}")
        for name,expected in snapshot["files"].items():
            if hashlib.sha256((path.parent/name).read_bytes()).hexdigest()!=expected:
                raise ValueError(f"Prototype artifact changed: {path.parent.name}/{name}")
    for path in sorted((ROOT/"engineering/development").rglob("checkpoint.json")):
        checkpoint=json.loads(path.read_text())
        expected=checkpoint["files_sha256"]
        actual={str(p.relative_to(path.parent)):hashlib.sha256(p.read_bytes()).hexdigest()
                for p in path.parent.rglob("*") if p.is_file() and p!=path}
        if actual!=expected:
            raise ValueError(f"Development checkpoint changed: {path.parent}")
    return manifest


def source_entries():
    roots=[ROOT/"README.md",ROOT/"LICENSE",ROOT/".gitignore",ROOT/".github/workflows",ROOT/"src/tactile_kit"]
    roots += [ROOT/"engineering"/name for name in (
        "README.md","bom.csv","l1_bom.csv","b1_bom.csv","b2_bom.csv","study.json","design_catalog.json","requirements.in","requirements.lock",
        "scripts","software","firmware","docs","templates","designs","tests","web","release","electronics","research","concepts","prototypes","campaign",
        "development","third_party",
    )]
    entries={}
    for root in roots:
        paths=[root] if root.is_file() else sorted(root.rglob("*"))
        for path in paths:
            if not path.is_file() or "__pycache__" in path.parts or path.suffix==".pyc":
                continue
            entries[str(path.relative_to(ROOT))]=path.read_bytes()
    return entries


def write_zip(path,entries):
    with zipfile.ZipFile(path,"w",compression=zipfile.ZIP_DEFLATED,compresslevel=7) as archive:
        for name,data in sorted(entries.items()):
            info=zipfile.ZipInfo(name,date_time=(2026,10,10,0,0,0))
            # The complete packet contains other checked archives and
            # compressed figures. Re-deflating them adds substantial build
            # time with little size reduction.
            compressed=Path(name).suffix.lower() in {".zip",".gz",".png",".jpg",".jpeg",".webp",".pdf"}
            info.compress_type=zipfile.ZIP_STORED if compressed else zipfile.ZIP_DEFLATED
            info.external_attr=0o100644<<16
            archive.writestr(info,data)
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
