geyan21/yam-tactile-kit/(commit log)

2026-10-10 Publish complete design handoff with CAD, inline docs, and downloads
2026-10-10 Add ENPIRE root-force prototype and reproducible force-moment test package
2026-10-10 Add B1 compliant magnetic insert and reproducible build package
2026-10-10 Clarify tactile sensor choices and exact placement with labeled maps
2026-10-10 Study tactile scalability and add separate magnetic and strain-force concepts
2026-10-10 Add separate design pages with sensor placement, status and downloads
2026-10-10 Add checked B2.1 prototype and build campaign for all designs
2026-10-11 Add C1 strain-root prototype, checked electronics and reproducible structural review
2026-10-11 Add B3 recessed magnetic prototype and reproducible build package
2026-10-11 Develop and verify F1 flex electrode routing and contact maps
2026-10-11 Preserve F1 readout circuit study and incomplete validation evidence
2026-10-11 Add F1 ADC and row studies, wrist layout and raw acquisition
2026-10-11 Publish checked F1 R3 interface PCB and matching fit packet
2026-10-11 Add checked F1 fitted electrodes and 64-location contact map
2026-10-11 Add capacitive K1 tooling, checked readout and reproduction page
2026-10-11 Add FB1.1 force-button prototype and reproduction guide
2026-10-11 Reserve K1 electrode guards and account for reference shield load
2026-10-11 Package K1.2 capacitive bench design and test workflow
2026-10-12 Survey pneumatic channel room and record verified pressure-sensor pins
2026-10-12 Fit pneumatic wall channels and preserve the rejected straight-port study
2026-10-12 Record the pneumatic routing constraints and next checks
2026-10-12 Check pneumatic fitting poses and preserve the narrow-stem probe
2026-10-12 Add P1 pneumatic bench design with checked CAD, readout and build pages
2026-10-12 Include P1 wiring asset and check page links before archiving
2026-10-12 Preserve the optical finger primary-source retrieval workflow
2026-10-12 Verify every frozen prototype is included in the portable packet
2026-10-12 Review optical camera hardware and define a bounded folded-path screen
2026-10-12 Locate optical path obstructions in the original finger meshes
2026-10-12 Track frozen P1 provenance and verify Git snapshot completeness
2026-10-12 Refine O1 optical coverage around the proximal retention and mount region
2026-10-12 Check compact optical camera options against the mount-space constraint
2026-10-12 Build a protected-mount optical frame and fixed-mirror core witness
2026-10-12 Preserve optical core join diagnostics and refine compact-camera source lookup
2026-10-12 Size the documented O1 camera and its required root mounting bay
2026-10-12 Serialize optical camera-space verdicts as native JSON booleans
2026-10-12 Orient the optical camera for cable access and reserve its mounting lands
2026-10-12 Export each camera clearance region without dropping the corner envelopes
2026-10-12 Integrate the optical camera bay with retained root geometry and explicit fasteners
2026-10-12 Collect primary O1 material and illumination specifications
2026-10-12 Select O1 gel and marker materials and build a mechanically retained cartridge
2026-10-12 Avoid a coincident O1 seat edge and record current publication status
2026-10-12 Specify and generate O1 blue LED ring with explicit two-layer routing
2026-10-12 Add O1 gel mold halves, marker stencil, and independent LED fabrication checks
2026-10-12 Bound O1 STL precision cleanup and preserve untreated mesh evidence
2026-10-12 Integrate a camera-mounted light carrier and retain both thin nail cells in O1
2026-10-12 Add O1 lossless capture, marker observations, raw nail ADC, and neutral refraction screen
2026-10-12 Clear O1 clip screw heads and follow the curved gel under station bridges
2026-10-12 Set the O1 camera screw stack to clear the retained root cap
2026-10-12 Clear the camera washer stacks from O1 board retention lips
2026-10-12 Add clear O1 build guides and drawings; separate light-board lips from camera hardware
